tieziyun/ultrasonic-aesa/README.md

# Ultrasonic AESA panel

A 40 kHz in-air phased array, an acoustic "AESA". It has 64 transducers in an 8 × 8 grid, and each one can transmit or listen under FPGA control, element by element and ping by ping. Eight wideband MEMS microphones sit around the edge of the grid. Every element's raw waveform (amplitude and phase) is digitised and streamed to an ALINX AXU3EGB (Zynq UltraScale+ ZU3EG) board, which does the beamforming.

Uses: 3-D sonar imaging, gesture and hand tracking, Doppler motion sensing, and continuous-wave split mode, where some elements transmit while the rest listen.

**Status (2026-10-24):** the schematic is complete and passes ERC (0 violations). All parts are placed on the 4-layer board (DRC clean, every part with a 3D model); routing is next. Full requirements, decisions and part choices are in [DESIGN_BRIEF.md](DESIGN_BRIEF.md).

## Read the schematic

**[docs/schematics/aesa_schematic.pdf](docs/schematics/aesa_schematic.pdf)**: the whole schematic in one PDF, one A3 page per sheet, regenerated on every schematic change. Page 1 is a block diagram of how the signal flows; click a block to open its sheet, and "<< up to" at the top of each page to go back. The bookmarks follow the hierarchy.

| Page | Sheet | What it is |
|---|---|---|
| 1 | top | **Block diagram**: FPGA → TX drive → transceivers → receive amplifiers → ADCs → FPGA, plus mics and power |
| 2 | `headers` | The two 40-pin ribbon headers to the AXU3EGB, idle pulls and I²C pull-ups |
| 3 | group | The 10 clock buffers and which clock each one feeds |
| 4 | `clk_buf` ×10 | One clock fan-out buffer with 47 Ω series termination |
| 5 | group | TX drive: 16 TX groups and 4 enable buffers |
| 6 | `tx_group` ×16 | 74HCT595 shift register and two UCC27524 gate drivers: drives 4 elements |
| 7 | `en_buf` ×4 | TX-enable buffer for 8 gate drivers |
| 8 | group | The 64 transceiver channels as an 8 × 8 grid |
| 9 | `channel` ×64 | One transceiver: crossed-diode T/R switch, CUSP-TR80 element, limiter, OPA1678 gain stage, 40 kHz band-pass |
| 10 | group | The 16 ADCs, which channels each one digitises, and their I²C groups |
| 11 | `adc` ×16 | TLV320ADC5140, 4 channels at 192 kSPS, input divider, TDM output to the FPGA |
| 12 | group | The 8 microphones, paired on 4 data lines |
| 13 | `mic` ×8 | SPH0641LU4H-1 PDM microphone |
| 14 | `power` | Power 1: 12 V jack → eFuse → VIN, +5 V buck, VDRV 15 V boost (switchable), +3V3, 3V3_MIC, ground test points |
| 15 | `power_analog` | Power 2 (analog): ±6.5 V → low-noise ±5VA for the receivers, +3V3A for the ADCs; the power tree and a bring-up checklist with the expected voltage at every test point |

Each block that repeats is drawn once and reused, so a change to `channel` applies to all 64 channels. KiCad's own export of every instance (126 pages) is left in `build/aesa_schematic_full.pdf`.

## Key numbers

| | |
|---|---|
| Elements | 64 × Same Sky CUSP-TR80-15-2500-TH (40 kHz transceiver, Ø9.8 mm) + 8 × SPH0641LU4H-1 MEMS mics |
| TX drive | 0–15 V square wave per element, 16 serial data lines at 10 MHz, per-element per-sample control |
| RX chain | Gain ×22 (+27 dB) in the amplifier, ×6.7 (+16.5 dB) to the ADC pin after the input divider; 31–51 kHz pass band; 1 m echo 93 dB above the noise ([simulated](sim/reports/README.md)) |
| ADC | 16 × TI TLV320ADC5140, 24-bit, 192 kSPS per channel, all 64 channels sampled at once, TDM to the FPGA, I²C configuration |
| Power | One 12 V barrel jack (≥ 1.5 A); every rail has a test point, an isolation jumper and (except the analog LDOs) an LED |
| Board | One 4-layer board, 192 × 301 mm (JLC04161H-7628, ENIG): transducers on the front, all SMT parts on the back |
| FPGA link | Two 40-pin ribbons, 3.3 V LVCMOS, about 15 cm |

## Repository

| Path | Contents |
|---|---|
| [DESIGN_BRIEF.md](DESIGN_BRIEF.md) | Requirements, decisions with reasons and sources, parts, pinouts, open questions |
| `kicad/` | KiCad 10 project `aesa.kicad_pro`, the source of truth |
| `scripts/` | Generators: `build_cells.py` (every cell sheet except `channel`: ADC, TX, buffers, mic, headers, power), `gen_top.py` (block diagram, group sheets, references), `sch_annotate.py` (channel title and notes), `export_pdf.py` (PDFs), plus field and LCSC helpers |
| `skidl/` | Reference spec of each block in SKiDL (values, nets, LCSC numbers) |
| `sim/` | LTspice testbenches and models. `sim/run.py` exports the channel circuit from the KiCad schematic, runs every testbench and writes [sim/reports/](sim/reports/README.md) |
| `docs/schematics/` | The schematic PDF (one page per sheet, linked) |
| `docs/assembly/` | Assembly drawing (front and back with every reference), for building and repair |
| `docs/datasheets/` | A datasheet PDF for every part on the board, with an [index](docs/datasheets/README.md); kept in step with the BOM by `scripts/datasheets.py` |
| [CLAUDE.md](CLAUDE.md) | Working rules for the AI assistant on this project |

## Rebuild

Tools: KiCad 10.0 (per-user install) and LTspice 24. Run from the repository root in a Windows terminal:

```
set KPY=%LOCALAPPDATA%\Programs\KiCad\10.0\bin\python.exe
set KCLI=%LOCALAPPDATA%\Programs\KiCad\10.0\bin\kicad-cli.exe
%KPY% scripts\build_cells.py
%KPY% scripts\sch_annotate.py
%KPY% scripts\sch_lcsc.py kicad\adc.kicad_sch kicad\tx_group.kicad_sch kicad\en_buf.kicad_sch kicad\clk_buf.kicad_sch kicad\mic.kicad_sch kicad\headers.kicad_sch kicad\power.kicad_sch kicad\power_analog.kicad_sch
%KPY% scripts\gen_top.py
%KCLI% sch erc kicad\aesa.kicad_sch
%KPY% sim\run.py
```

The `channel` sheet is drawn by hand (with the KiCad MCP server) and is not regenerated; everything else is. `gen_top.py` ends by exporting the schematic PDF, and the git pre-commit hook (`.githooks/pre-commit`, enabled with `git config core.hooksPath .githooks`) refuses a commit that changes a sheet without the matching PDF.

Board (placement, 3D models, assembly drawing):

```
%KPY% scripts\make_3d.py
%KPY% scripts\place.py
%KPY% scripts\placement_check.py
%KCLI% pcb drc kicadesa.kicad_pcb
%KPY% scriptsssembly_pdf.py
```

BOM (needs internet: it queries JLCPCB for parts, stock and prices, and takes a few minutes):

```
%KPY% scripts\bom.py
%KPY% scripts\sch_lcsc.py --force kicad\channel.kicad_sch kicad\adc.kicad_sch kicad\tx_group.kicad_sch kicad\en_buf.kicad_sch kicad\clk_buf.kicad_sch kicad\mic.kicad_sch kicad\headers.kicad_sch kicad\power.kicad_sch kicad\power_analog.kicad_sch
%KPY% scripts\gen_top.py
```

`bom.py` writes the costed BOM `docs/bom.md`, the JLCPCB upload file `fab/bom_jlcpcb.csv` and `scripts/parts.json`, from which `sch_lcsc.py` fills every part's LCSC field.

## Next

1. Routing (power by hand first, then Freerouting), then fabrication outputs for JLCPCB.
2. Waveguide design and FPGA firmware (XDC constraints, ADC register setup, TX bit streaming).
