tieziyun/ultrasonic-aesa/docs/datasheets/README.md

# Datasheets

One PDF per part on the board, kept in step with the BOM by `scripts/datasheets.py` (run by `scripts/bom.py`; files older than 90 days are downloaded again). TI and Nexperia parts come from the maker's latest-revision link, the rest through LCSC. Parts that share a series datasheet share a file.

| Part | LCSC | Used as | Datasheet | Downloaded |
|---|---|---|---|---|
| 0603B105K250CT | C388002 | 1u 16V X7R | [0603B105K250CT_C388002.pdf](0603B105K250CT_C388002.pdf) | 2026-10-23 |
| 1210B106K500CT | C525507 | 10u 50V X7R 1210 | [0603B105K250CT_C388002.pdf](0603B105K250CT_C388002.pdf) | 2026-10-23 |
| 0603CG6R8C500NT | C1679 | 6.8p 50V C0G | [0603CG6R8C500NT_C1679.pdf](0603CG6R8C500NT_C1679.pdf) | 2026-10-23 |
| 0603CG7R5C500NT | C53424 | 7.5p 50V C0G | [0603CG6R8C500NT_C1679.pdf](0603CG6R8C500NT_C1679.pdf) | 2026-10-23 |
| 0603B103K500NT | C57112 | 10n 16V X7R | [0603CG6R8C500NT_C1679.pdf](0603CG6R8C500NT_C1679.pdf) | 2026-10-23 |
| 0603WAF1001T5E | C21190 | 1k 1% | [0603WAF1001T5E_C21190.pdf](0603WAF1001T5E_C21190.pdf) | 2026-10-23 |
| 0603WAF1000T5E | C22775 | 100 1% | [0603WAF1001T5E_C21190.pdf](0603WAF1001T5E_C21190.pdf) | 2026-10-23 |
| 0603WAF1303T5E | C22795 | 130k 1% | [0603WAF1001T5E_C21190.pdf](0603WAF1001T5E_C21190.pdf) | 2026-10-23 |
| 0603WAF1302T5E | C22797 | 13k 1% | [0603WAF1001T5E_C21190.pdf](0603WAF1001T5E_C21190.pdf) | 2026-10-23 |
| 0603WAF1503T5E | C22807 | 150k 1% | [0603WAF1001T5E_C21190.pdf](0603WAF1001T5E_C21190.pdf) | 2026-10-23 |
| 0603WAF1502T5E | C22809 | 15k 1% | [0603WAF1001T5E_C21190.pdf](0603WAF1001T5E_C21190.pdf) | 2026-10-23 |
| 0603WAF2203T5E | C22961 | 220k 1% | [0603WAF1001T5E_C21190.pdf](0603WAF1001T5E_C21190.pdf) | 2026-10-23 |
| 0603WAF2001T5E | C22975 | 2k 1% | [0603WAF1001T5E_C21190.pdf](0603WAF1001T5E_C21190.pdf) | 2026-10-23 |
| 0603WAF3301T5E | C22978 | 3.3k 1% | [0603WAF1001T5E_C21190.pdf](0603WAF1001T5E_C21190.pdf) | 2026-10-23 |
| 0603WAF330JT5E | C23140 | 33 1% | [0603WAF1001T5E_C21190.pdf](0603WAF1001T5E_C21190.pdf) | 2026-10-23 |
| 0603WAF4701T5E | C23162 | 4.7k 1% | [0603WAF1001T5E_C21190.pdf](0603WAF1001T5E_C21190.pdf) | 2026-10-24 |
| 0603WAF470KT5E | C23164 | 4.7 1% DNP | [0603WAF1001T5E_C21190.pdf](0603WAF1001T5E_C21190.pdf) | 2026-10-24 |
| 0603WAF470JT5E | C23182 | 47 1% | [0603WAF1001T5E_C21190.pdf](0603WAF1001T5E_C21190.pdf) | 2026-10-23 |
| 0603WAF5601T5E | C23189 | 5.6k 1% | [0603WAF1001T5E_C21190.pdf](0603WAF1001T5E_C21190.pdf) | 2026-10-23 |
| 0603WAF5103T5E | C23192 | 510k 1% | [0603WAF1001T5E_C21190.pdf](0603WAF1001T5E_C21190.pdf) | 2026-10-23 |
| 0603WAF5102T5E | C23196 | 51k 1% | [0603WAF1001T5E_C21190.pdf](0603WAF1001T5E_C21190.pdf) | 2026-10-23 |
| 0603WAF7501T5E | C23234 | 7.5k 1% | [0603WAF1001T5E_C21190.pdf](0603WAF1001T5E_C21190.pdf) | 2026-10-23 |
| 0603WAF7502T5E | C23242 | 75k 1% | [0603WAF1001T5E_C21190.pdf](0603WAF1001T5E_C21190.pdf) | 2026-10-23 |
| 0603WAF1003T5E | C25803 | 100k 1% | [0603WAF1001T5E_C21190.pdf](0603WAF1001T5E_C21190.pdf) | 2026-10-23 |
| 0603WAF1002T5E | C25804 | 10k 1% | [0603WAF1001T5E_C21190.pdf](0603WAF1001T5E_C21190.pdf) | 2026-10-23 |
| 0603WAF6493T5E | C25821 | 649k 1% | [0603WAF1001T5E_C21190.pdf](0603WAF1001T5E_C21190.pdf) | 2026-10-23 |
| 0603WAF2201T5E | C4190 | 2.2k 1% | [0603WAF1001T5E_C21190.pdf](0603WAF1001T5E_C21190.pdf) | 2026-10-23 |
| 0603WAF1602T5E | C4210 | 16k 1% | [0603WAF1001T5E_C21190.pdf](0603WAF1001T5E_C21190.pdf) | 2026-10-24 |
| 0603WAF3302T5E | C4216 | 33k 1% | [0603WAF1001T5E_C21190.pdf](0603WAF1001T5E_C21190.pdf) | 2026-10-24 |
| 1206N104J500CT | C170182 | 100n 50V C0G 1206 | [1206N104J500CT_C170182.pdf](1206N104J500CT_C170182.pdf) | 2026-10-23 |
| 74HCT595D,118 | C282339 | 74HCT595D | [74HCT595D_118_C282339.pdf](74HCT595D_118_C282339.pdf) | 2026-10-23 |
| 74LVC2G34GW | C52140488 | 74LVC2G34 | [74LVC2G34GW_C52140488.pdf](74LVC2G34GW_C52140488.pdf) | 2026-10-23 |
| BAV99,215 | C2500 | BAV99 | [BAV99_215_C2500.pdf](BAV99_215_C2500.pdf) | 2026-10-23 |
| C0603C472J5GACAUTO | C3904926 | 4.7n 50V C0G | [C0603C472J5GACAUTO_C3904926.pdf](C0603C472J5GACAUTO_C3904926.pdf) | 2026-10-26 |
| C1608C0G1H103JT000N | C76599 | 10n 50V C0G | [C1608C0G1H103JT000N_C76599.pdf](C1608C0G1H103JT000N_C76599.pdf) | 2026-10-23 |
| CC0603FRNPO9BN102 | C309468 | 1n 50V C0G 1% | [CC0603FRNPO9BN102_C309468.pdf](CC0603FRNPO9BN102_C309468.pdf) | 2026-10-24 |
| CC0603KRX7R9BB104 | C14663 | 100n 16V X7R, 100n 50V X7R | [CC0603KRX7R9BB104_C14663.pdf](CC0603KRX7R9BB104_C14663.pdf) | 2026-10-23 |
| CL0603FN121KP | C48996814 | 121k 1% | [CL0603FN121KP_C48996814.pdf](CL0603FN121KP_C48996814.pdf) | 2026-10-23 |
| CL31A226KAHNNNE | C12891 | 22u 16V X5R 1206 | [CL31A226KAHNNNE_C12891.pdf](CL31A226KAHNNNE_C12891.pdf) | 2026-10-23 |
| CL10C101JB8NNNC | C14858 | 100p 50V C0G | [CL31A226KAHNNNE_C12891.pdf](CL31A226KAHNNNE_C12891.pdf) | 2026-10-23 |
| CL21A106KAYNNNE | C15850 | 10u 16V X5R | [CL31A226KAHNNNE_C12891.pdf](CL31A226KAHNNNE_C12891.pdf) | 2026-10-23 |
| CL10C330JB8NNNC | C1663 | 33p 50V C0G | [CL31A226KAHNNNE_C12891.pdf](CL31A226KAHNNNE_C12891.pdf) | 2026-10-24 |
| CL10B224KA8NNNC | C21120 | 220n 16V X7R | [CL31A226KAHNNNE_C12891.pdf](CL31A226KAHNNNE_C12891.pdf) | 2026-10-23 |
| CL10B223KB8NNNC | C21122 | 22n 50V X7R | [CL31A226KAHNNNE_C12891.pdf](CL31A226KAHNNNE_C12891.pdf) | 2026-10-23 |
| CL21B105KBFNNNE | C28323 | 1u 50V X7R | [CL31A226KAHNNNE_C12891.pdf](CL31A226KAHNNNE_C12891.pdf) | 2026-10-23 |
| CUSP-TR80-15-2500-TH | CUSP-TR80-15-2500-TH | CUSP-TR80-15-2500-TH | [CUSP-TR80-15-2500-TH.pdf](CUSP-TR80-15-2500-TH.pdf) | 2026-10-23 |
| EMK325B7226KM-PR | C412624 | 22u 16V X7R 1210 | [EMK325B7226KM-PR_C412624.pdf](EMK325B7226KM-PR_C412624.pdf) | 2026-10-23 |
| KT-0603G | C12624 | green | [KT-0603G_C12624.pdf](KT-0603G_C12624.pdf) | 2026-10-23 |
| PJ-063AH | C22434582 | 12 V in (5.5x2.1) | [PJ-063AH_C22434582.pdf](PJ-063AH_C22434582.pdf) | 2026-10-23 |
| PZ254V-11-02P | C492401 | TX power (shunt) | [PZ254V-11-02P_C492401.pdf](PZ254V-11-02P_C492401.pdf) | 2026-10-23 |
| RS-03K5623FT | C321950 | 562k 1% | [RS-03K5623FT_C321950.pdf](RS-03K5623FT_C321950.pdf) | 2026-10-23 |
| RS-03K7153FT | C321989 | 715k 1% | [RS-03K5623FT_C321950.pdf](RS-03K5623FT_C321950.pdf) | 2026-10-24 |
| RVT1H470M0607 47UF 50V | C970679 | 47u 35V | [RVT1H470M0607_47UF_50V_C970679.pdf](RVT1H470M0607_47UF_50V_C970679.pdf) | 2026-10-26 |
| SMD1812P200TF16 | C20812 | SMD1812P200TF16 | [SMD1812P200TF16_C20812.pdf](SMD1812P200TF16_C20812.pdf) | 2026-10-23 |
| SPH0641LU4H-1 | C2879853 | SPH0641LU4H-1 | [SPH0641LU4H-1.pdf](SPH0641LU4H-1.pdf) | 2026-10-23 |
| SRN8040TA-100M | C2044906 | 10u Isat>=5A | [SRN8040TA-100M_C2044906.pdf](SRN8040TA-100M_C2044906.pdf) | 2026-10-23 |
| SS14 | C2480 | SS14 | [SS14_C2480.pdf](SS14_C2480.pdf) | 2026-10-23 |
| SWPA6045-SERIES | C78804 | 4.7u Isat>=2A | [SWPA6045-Series.pdf](SWPA6045-Series.pdf) | 2026-10-23 |
| SWPA6045-SERIES | C79272 | 10u Isat>=2A | [SWPA6045-Series.pdf](SWPA6045-Series.pdf) | 2026-10-23 |
| SUNLORD_GZ_SERIES | C1002 | 600R@100MHz 0603 | [Sunlord_GZ_series.pdf](Sunlord_GZ_series.pdf) | 2026-10-23 |
| SUNLORD_SWPA_SERIES | C42193 | 1u Isat>=4A | [Sunlord_SWPA_series.pdf](Sunlord_SWPA_series.pdf) | 2026-10-24 |
| TCC0603COG181J500CT | C376771 | 180p 50V C0G | [TCC0603COG181J500CT_C376771.pdf](TCC0603COG181J500CT_C376771.pdf) | 2026-10-23 |
| TCC0603COG471J500CT | C376788 | 470p 50V C0G DNP | [TCC0603COG181J500CT_C376771.pdf](TCC0603COG181J500CT_C376771.pdf) | 2026-10-24 |
| TCC1206X7R106K160HT | C380363 | 10u 16V X7R 1206 | [TCC0603COG181J500CT_C376771.pdf](TCC0603COG181J500CT_C376771.pdf) | 2026-10-23 |
| TCC1206X7R106K250HT | C380364 | 10u 25V X7R 1206 | [TCC0603COG181J500CT_C376771.pdf](TCC0603COG181J500CT_C376771.pdf) | 2026-10-23 |
| VZH101M1HTR-0810 | C294509 | 100u 25V | [VZH101M1HTR-0810_C294509.pdf](VZH101M1HTR-0810_C294509.pdf) | 2026-10-26 |
| XDFH-0254-2*20P | C19193815 | EX_IO1 (AXU3EGB J15), EX_IO2 (AXU3EGB J16) | [XDFH-0254-2_20P_C19193815.pdf](XDFH-0254-2_20P_C19193815.pdf) | 2026-10-23 |
| LM2731 | C485804 | LM2731XMF | [lm2731.pdf](lm2731.pdf) | 2026-10-23 |
| OPA1678 | C192421 | OPA1678IDR | [opa1678.pdf](opa1678.pdf) | 2026-10-24 |
| SN74AHCT1G125 | C7484 | 74AHCT1G125 | [sn74ahct1g125.pdf](sn74ahct1g125.pdf) | 2026-10-23 |
| TLV320ADC5140 | C2876368 | TLV320ADC5140 | [tlv320adc5140.pdf](tlv320adc5140.pdf) | 2026-10-23 |
| TLV757P | C485517 | TLV75733PDBVR | [tlv757p.pdf](tlv757p.pdf) | 2026-10-23 |
| TPS2660 | C544399 | TPS26600PWPR | [tps2660.pdf](tps2660.pdf) | 2026-10-23 |
| TPS54302 | C311983 | TPS54302DDCR | [tps54302.pdf](tps54302.pdf) | 2026-10-23 |
| TPS65131 | C87663 | TPS65131RGER | [tps65131.pdf](tps65131.pdf) | 2026-10-23 |
| TPS7A33 | C90082 | TPS7A3301RGWR | [tps7a33.pdf](tps7a33.pdf) | 2026-10-23 |
| TPS7A47 | C28286 | TPS7A4700RGWT | [tps7a47.pdf](tps7a47.pdf) | 2026-10-23 |
| UCC27524 | C465729 | UCC27524DR | [ucc27524.pdf](ucc27524.pdf) | 2026-10-23 |
