tieziyun/ultrasonic-aesa/DESIGN_BRIEF.md

# Hybrid 8×8 Ultrasonic Transceiver Panel — Design Brief

An acoustic "AESA": a 40 kHz in-air phased array in which every element can transmit and receive under per-element FPGA control, plus a few wideband MEMS microphones. It feeds an ALINX AXU3EGB (Zynq UltraScale+ ZU3EG) board, which does the beamforming.

Status (2026-10-24): the full schematic is drawn in KiCad (`kicad/aesa.kicad_pro`, the source of truth; PDFs in `docs/schematics/`): 64 transceiver channels, 8 MEMS mics, 16 TLV320ADC5140 ADCs (4 channels each, changed from 8 × AD7606C-16 on 2026-10-23), TX drive, power and the AXU3EGB headers, about 2,040 parts, ERC 0 violations. Decided: discrete front end and 74HCT595 TX drive (section 4a), TLV320ADC5140 audio ADCs at 192 kSPS (section 4), one 4-layer board (section 2), one reused sheet per repeated block (section 4b). Simulations: [sim/reports/](sim/reports/README.md) (all pass). BOM done 2026-10-22 (every part has an LCSC number, `docs/bom.md`). Placement done and reviewed, board set up for routing (stackup, ENIG, plane layers, custom DRC rules, Freerouting), DRC 0. Next: routing.

## 1. Goals (applications the board must support)

| Application | How the hardware supports it |
|---|---|
| Indoor 3D imaging and people tracking, about 0.3–5 m | 8×8 receive beamforming, MIMO (fire one element, all listen) |
| Gesture / hand tracking, cm to 2 m | **Split mode**: a few elements transmit while the rest listen, so the listening elements are not ringing; sub-mm motion from echo phase |
| Doppler: motion, vibration, breathing, fall detection | **Continuous wave** in split mode: some elements transmit continuously, the rest receive continuously |
| Acoustic camera, passive | Transceivers hear about 39–41 kHz (air/gas leaks, electrical arcing). The edge MEMS mics add wideband 20–80 kHz (bats, broadband sources) |

Out of scope: outdoor long range, underwater, anything near people's ears at high drive (40 kHz is audible to pets; keep it indoors).

## 2. Architecture

- **64 transceivers in an 8×8 grid.** Each element has its own TX driver, a per-element T/R switch or RX protection, an RX amplifier, and its own ADC channel.
- **Every element's mode is set by the FPGA per ping**: transmit, listen, or both (where the circuit allows). This mode switching is what enables split mode and continuous wave. It is the single most important requirement of the front end.
- **8 wideband MEMS microphones** around the edge of the grid (PDM, 4 data lines).
- **Front waveguide** (3D-printed tubes) to bring the effective element spacing down to λ/2 = 4.3 mm, so beamforming has no grating lobes. This follows the TU Darmstadt design (reference 1 below).
- Optional: active damping (a brief anti-phase drive after each pulse) to shorten ringing.

### Board split (decided 2026-10-20): one board
**One 4-layer board, 192 × 301 mm** (size set in the floorplan, 2026-10-23).
- **Front:** the 64 transducers (hand-soldered through-hole) and the waveguide.
- **Back:** every SMT part, so assembly is single-sided. Each channel's front end sits directly behind its element.
- **Mics:** the 8 bottom-port MEMS mics mount on the back, with port holes through the board.
- **Clean side:** ADCs, logic and the AXU3EGB ribbon headers go along one edge; power and the 15 V drivers go along the opposite edge, all over one continuous GND plane.

Why:
- **Cost:** one PCB instead of two, one SMT setup ($25 instead of 2 × $25 at [JLCPCB](https://jlcpcb.com/help/article/pcb-assembly-price)), and no board-to-board connectors carrying 64 analog lines plus grounds.
- **Noise:** the high-impedance element node (XD, 3 kΩ source) stays a few mm long instead of crossing a connector, so there's less pickup and no connector crosstalk between neighbouring elements.
- **Industry practice:** flat ultrasonic arrays commonly put transducers and drivers on one PCB ([FPGA levitation array, arXiv 1901.07317](https://arxiv.org/pdf/1901.07317); [SonicSurface build](https://z.jpralves.net/post/2021/08/05/sonicsurface-phased-array-for-levitation-mid-air-tactile-feedback-and-target-directional-speakers.html)), and transducer-front, electronics-back is a standard arrangement ([US10315224](https://image-ppubs.uspto.gov/dirsearch-public/print/downloadPdf/10315224)).

Rejected:
- **Two-board stack** (2-layer panel plus 4-layer front end): most expensive, and puts the sensitive XD lines through a connector.
- **Hybrid** (front ends on the panel, ADC/digital on a second board): middle cost, still two boards and two assemblies.

So there is no board-to-board connector. The only cable is the ribbon to the AXU3EGB.

### PCB floorplan (2026-10-23, `scripts/place.py`; decisions judged on the criteria in CLAUDE.md)
- **Board 192 × 301 mm, 4 layers, JLCPCB JLC04161H-7628 (1.6 mm), 3 mm 45° bevel on every corner, components ≥ 3 mm and copper ≥ 0.5 mm from the edge:** F.Cu front (transducer pads, RX_OUT runs to the ADCs) / In1 GND / In2 GND / B.Cu back (all SMT parts, DRV runs from the drivers). Two solid GND planes (SIG-GND-GND-SIG) shield the 15 V drive traces on the back from the receive traces on the front (*noise*); one GND net, partitioned by placement only (TI SLYT512).
- **Element pitch 20 mm** (chosen for the Ø14 mm CUSA-TR65 with a 6 mm gap, changed from 18 mm; the Ø9.8 mm CUSP-TR80 now leaves a 10 mm gap): channel front ends fill about 45 % of the back of each cell, which leaves a **2.5 mm soldering keep-out** around every hand-soldered transducer pad (*soldering*), room for probes (*testing*) and more distance between channels (*noise*); trade-off: about 17 % more board area (*cost*) and a longer waveguide (open decision 5). TX groups and ADCs behind the array would have made the cells about 80 % full, so they stay on the edge strips.
- **Placement (updated 2026-10-23, user requests):** all cables leave the **top edge**: the two ribbon headers side by side in the middle (straight ribbons, no bending), the 12 V jack in the top-left corner with the eFuse and polyfuse, the quiet +3V3A and +3V3 LDOs in the top-right corner next to the ADCs they feed. Below the headers: header pulls, the 6 ADC and mic clock buffers, then the 16 ADC blocks (2 rows of 8); the 4 TX clock buffers sit in a band between the TX rows and the power row. The array: transducers on the front, each channel block behind its element. Bottom: 16 TX group blocks (2 rows of 8), the 4 enable buffers in the left margin, then the switching regulators and the ±5VA LDOs, as far as possible from the ADCs (*noise*). The 12 V input therefore runs from the top-left corner down the left margin to the +5V buck, and +5V back up to the top-right LDOs, as wide traces (route them first). 8 mics, 4 down each side (on the back: they are bottom-port, the 0.5 mm port hole in the footprint goes through the board so they hear the front; front-mounting would need double-sided assembly and would point the port into the board). 6 M3 holes (corners, mid-sides) and 3 fiducials.
- **Blocks (user rule):** one layout per schematic block, copied to every instance and grouped (CH01–CH64, ADC01–16, TXG01–16, CLKB1–10, TXEN1–4, MIC1–8, Headers, Power). Hand-made templates built from the real mirrored pad positions (`scripts/place.py`): **TX group** (the two UCC27524 side by side, outputs and VDD towards the array, each 100 nF VDRV capacitor right above its VDD pin, the 595 below with QB–QD facing the drivers), **ADC** (TLV320ADC5140 rotated so its 8 inputs face the array; analog-supply capacitors beside pins 1–3, DREG/IOVDD capacitors on top with a gap for BCLK/FSYNC; one column per channel below the chip: coupling capacitors, then the 2k/1k divider), the **channel**'s TX parts and op-amp, and the **LM2731 boost core** (inductor, diode and output capacitors around the SW pin, per the datasheet layout). Everything else is placed by connectivity: ICs first, the parts on a switch node next, then each decoupling capacitor at the IC pin it serves (rail pads measured against IC pins only), then each part next to what it connects to.
- **Silkscreen:** references only on connectors, jumpers, LEDs, holes and fiducials; test points show their rail name; block labels CH01–CH64, ADC01–16, TXG01–16; all other references on the Fab layer. Board name, revision and the safety notes (12 V only, protection limits, TX shunt) on the front.
- **Net classes** (project file, updated 2026-10-24): **HighCurrent 1.0 mm** (VIN, VIN_JACK, VIN_PROT, +5V, 5V_REG, SW_5V: up to 1.6 A, 3 A peak on the switch node; about 4× less copper loss and heating than 0.5 mm: *energy efficiency, heat*), Power 0.5 mm (the other rails, `*_REG` and switch nodes), Drive (DRV, XD) 0.35 mm / 0.3 mm clearance, Analog (RX) 0.25 / 0.25, Clock 0.2 / 0.2 (QFN pad limit; give clocks extra spacing when routing), default 0.2 / 0.15. Feedback, enable, NR and soft-start nodes stay in Default on purpose: thin, short and away from the switch nodes (*noise*). Neck power tracks down at fine-pitch QFN pins. DRC: 0 clearance/overlap errors after placement.
- **Test and repair access (2026-10-24, *testing*):** every rail has a test point, a jumper and an LED (power sheet). Every channel has a 1.0 mm test pad on RX_OUT after its 100 Ω, so a probe never loads the op-amp output (64 pads, `TP101`–`TP6401`). The TX drive of each element can be probed on its transducer pad on the front (an empty hole when the transducer is not fitted). Every FPGA line (TX data and clocks, ADC TDM, I²C, mic data) is probed on the through-hole pins of the ribbon headers on the back. Six scope-ground pads: TP9509/TP9510 at the supply, TP9516 between the ribbon headers, TP9517/TP9518 at the sides of the array, TP9519 beside the TX rows. **Assembly drawing** `docs/assembly/aesa_assembly.pdf` (`scripts/assembly_pdf.py`): front and back (mirrored) fab outlines with every reference and the DNP transducers crossed out, for finding a part during repair.
- **3D models (2026-10-24):** every part has one (`check_design.py` checks). Four library footprints have no model in KiCad 10's library and use the stock model of a part with the same body (`MODEL_SUBST` in `place.py`: 1812 fuse → R_1812, SRN8040TA → SWPA8040S 8×8×4 mm, VQFN-24 4×4 → TI RGE0024C, Knowles LGA-5 → SPH0645 3.5×2.65 mm). The CUSP-TR80 model is built by `scripts/make_3d.py` (Ø9.8 × 7.0 mm can, mesh top, Ø0.7 mm pins), because Same Sky's own model needs a login. Pad-only footprints (test pads, solder jumpers, fiducials, holes) need none.
- **Input protection (added 2026-10-23):** TI TPS26600 eFuse at the jack: rated 60 V and −60 V (replaces the SS54 reverse-polarity diode, 0.5 W less heat), switches off above 13.8 V (the LM2731 VDRV boost runs up to 14 V input, 14.5 V absolute maximum), below 8.8 V, and above 1.6 A; resettable (auto-retry), so a wrong adapter or a short does no damage. The 2 A polyfuse stays after it as a back-up. Test points: adapter voltage (TP9513), input current 1.08 V/A (TP9514), fault (TP9515). **RTN fix (2026-10-26):** the eFuse's RTN pin and PowerPad, with its support parts (UVLO/OVP divider foot, ILIM, dVdT, IMON), are on their own net EFUSE_RTN, apart from GND: the reverse-polarity block sits between RTN and GND inside the chip, and the earlier schematic tied them together, which disables reverse-polarity protection (TPS2660 datasheet 9.3.5.5). Board: a small RTN copper island under U9508, clear of the GND planes.
- **Columns (after the placement review, 2026-10-23):** channels are numbered **down the columns** (CH n: column (n−1)//8, row (n−1)%8; the schematic's array sheet uses the same grid), so TX group k and ADC k sit directly below and above the column of CH 4k−3…4k and every DRV and RX run is a straight vertical line in its own column, with no crossings. **This is the element map the firmware must use.** On F.Cu each column has a **DRV lane on its left** (−9…−5 mm from the element centre) and an **RX lane on its right** (+5…+9 mm), about 10 mm apart over the GND plane (crosstalk ∝ 1/(1+(d/h)²) ≈ −56 dB); the 15 V traces never run beside a receive trace. On the back the TX parts sit in the pocket beside the XD pad, ≥ 4 mm from any receive part and ≥ 6.8 mm from the next row's amplifier input.
- **Placement checks** (`scripts/placement_check.py`, all pass): ADC 100 nF caps ≤ 2.4 mm from their pins, bulk ≤ 6 mm, coupling caps ≤ 6.4 mm, dividers ≤ 2.2 mm; gate-driver VDD caps 2.2 mm; op-amp supply caps 2.4 mm; buck SW→inductor 3.1 mm, input caps ≤ 4 mm; boost SW→inductor/diode ≤ 3.6 mm, diode→output cap 3.6 mm; TX/ADC blocks exactly under their columns. DRC 0 violations.
- **Ready for routing (2026-10-24, placement reviewed against best practice):**
  - **Stackup** JLC04161H-7628 written into the board (1 oz outer, 0.5 oz inner, 0.2104 mm 7628 prepreg, 1.065 mm core), **ENIG** finish (user, 2026-10-24: flat pads for the 0.5 mm-pitch QFNs and the 64 hand-soldered transducers; estimated $3–8 more per board than HASL).
  - **Inner layers In1/In2 are plane ("power") layers**: both solid GND; the autorouter cannot route on them (*noise*). Their zones join SMD pads solidly and **through-hole pads with thermal reliefs** (4 × 0.5 mm spokes): the transducers, headers, jack and holes solder by hand without the planes sinking the heat (*soldering*).
  - **Custom DRC rules** `kicad/aesa.kicad_dru`: TX drive ≥ 1 mm from receive nets, switch nodes ≥ 2 mm from receive nets, clock tracks ≥ 0.4 mm and receive tracks ≥ 0.5 mm from other signal tracks (*noise*); JLCPCB limits: via drill ≥ 0.3 mm, annular ring ≥ 0.15 mm, hole to hole ≥ 0.5 mm, track ≥ 0.127 mm (*manufacture*). Freerouting does not read this file: run DRC after every autoroute.
  - **Freerouting 2.5.0** CLI (bundled Java runtime) in `C:\GitHub\tools\freerouting\cli\freerouting-cli.exe`; the board exports to Specctra DSN with all six net classes and the inner layers as planes.
  - JLCPCB order-number placeholder (`JLCJLCJLCJLC`) on the front silkscreen, bottom right, so the number is not printed over parts.
  - Accepted placement trade-off: the 12 V input runs about 280 mm from the jack (top) to the buck (bottom), and +5V back up to the top LDOs, because the switchers sit as far as possible from the ADCs. Route both trunks **2 mm wide** by hand (about 0.1 V and 0.1 W lost instead of 0.2 V / 0.3 W at 1 mm).
- **Routing and EMI plan:** [docs/routing_and_emi.md](docs/routing_and_emi.md) (2026-10-24): track types, measured lengths (`scripts/net_lengths.py`), widths, topologies and the EMI checklist; five open decisions there.
- **Routing plan (next):** power first — 12 V from the top-left jack down the left margin to the +5V buck (bottom right), +5V back up the right margin to the +3V3A/+3V3 LDOs (top right), trunks 2 mm wide, everything else ≥ 1 mm; then the 64 DRV lanes and 64 RX lanes on F.Cu; the TX control lines (16 SDI, 4 SCK, 4 LATCH, EN, OE, CLR) from J1 down a side margin on F.Cu; ADC TDM lines, clocks and I²C between the ADC rows and the headers; then the rest with Freerouting; GND vias next to every GND pad. Open before routing: check J9901/J9902 key slot and pin 1 against the AXU3EGB J15/J16 and the ribbon twist.

### Heat, enclosure and home use (2026-10-23)
- **Heat (estimate from the design's currents, worst case all 64 elements in CW):** about 8.5 W in total, 6.5 W in normal pulse-echo use. Hottest parts: +3V3A LDO 0.8–1.0 W, +5V buck 0.7 W, VDRV boost 0.7 W (CW only), ±6V5 converter 0.6 W, ±5VA LDOs 0.4 W each; the 64 op-amps (40 mW each) and 16 ADCs (90 mW each) are spread over the board. With θJA ≈ 35 °C/W on the 4-layer board (thermal vias into the two GND planes) the hottest junction is about 60–70 °C at 25 °C ambient (limit 125 °C); the board as a whole warms about 6–10 °C in open air. **No heatsinks:** the two inner GND planes are the heat spreader. If one is ever added, put it only on an LDO (quiet DC node), never on a switcher's SW node, keep it away from the array, and ground it.
- **Enclosure (3D-printed):** PETG or ASA, not PLA (PLA softens near 60 °C, the LDO case temperature). Vent slots next to the power strip, **≤ 5 mm wide** (mice get through 6–7 mm gaps). No solid cover in front of the transducers: a plastic sheet reflects 40 kHz almost completely; the front is the 3D-printed waveguide (open decision 5) or a grille with large open area. Run the 12 V cable and the ribbons inside printed conduits (mice chew cables).
- **Home use with mice:** mice hear 40 kHz (their hearing reaches about 90 kHz), so active pings are audible to them, and to pet rodents, cats and dogs. Their own calls (ultrasonic vocalisations, mostly 50–80 kHz) are outside the narrow 40 kHz transducers' band but inside the SPH0641 mics' ultrasonic band (up to 80 kHz): passive listening with the mics needs no transmission. Active sonar finds mice at 1–2 m (body ≈ 7 cm ≫ λ = 8.6 mm); mount the panel low, looking along the floor. **Safety:** 64 elements focused can reach very high sound levels at the focus (one element 100 dB SPL at 30 cm; coherent focusing adds up to 36 dB), above the ~110 dB occupational limits for airborne ultrasound. The firmware must limit transmit power (elements, duty, VDRV) for home use and never focus on people or pets at short range.

### Clock and data lines to the AXU3EGB (decided 2026-10-20)
Single-ended 3.3 V LVCMOS. At 10–20 MHz over a short ribbon that is the standard choice, and the AXU3EGB's 3.3 V HD banks can't drive LVDS anyway ([Xilinx XAPP230](https://www.hep.ucl.ac.uk/~mp/FPGA/Xilinx-Appl-Note-230_LVDS-Standards.pdf); [CTS termination note](https://www.CTSCorp.com/Files/Product-Marketing-Documents/Passive-Components/Frequency-Control-Products/CTS-Passive-Components-Frequency-Control-Oscillators-Terminat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)).
- **FPGA outputs** (all ribbon outputs, clocks and data): **DRIVE = 4 mA**, SLEW = SLOW in the XDC (changed from 8 mA after simulation, [sim/reports/clock_si_drive.md](sim/reports/clock_si_drive.md)): about 80 Ω output impedance nearly source-matches the ~100 Ω ribbon, so edges at our buffer inputs reach 3.32 V / −0.02 V instead of 3.7 V / −0.4 V at DRIVE 8. No termination parts at the header: the DNP RC fallback (100 Ω + 47 pF, only for DRIVE 8) was removed on 2026-10-26 (user).
- **Ground conductors:** a GND pin on each side of every clock in the ribbon. Spare header pins become GND, and the FPGA leaves those pins as inputs.
- **Clock fan-out on our board:** 74LVC2G34 buffers (10). Each output drives at most 4 loads, **clustered at the far end of its trace**, through its own **47 Ω** series resistor (33 Ω until 2026-10-24): with the buffer's about 20 Ω this matches the 61 Ω (0.25 mm) clock tracks. A series-terminated line only gives clean edges at loads near its end ([sim/reports/mic_clock_si.md](sim/reports/mic_clock_si.md)). The ADC and mic buffers sit under the headers; the four TX buffers sit under the TX rows (2026-10-24, EMI: the 300 mm runs carry the slow FPGA edges, not the buffered ones; [docs/routing_and_emi.md](docs/routing_and_emi.md)).
- **Data back to the FPGA:** a 33 Ω series resistor at each ADC's DOUTA/DOUTB/BUSY output.
- **Cable:** keep the ribbon short, about 15 cm.

## 3. Key numbers

| Quantity | Value |
|---|---|
| Frequency | 40 kHz; λ = 8.6 mm in air; λ/2 = 4.3 mm |
| Range resolution | about 5–8 cm (transducer bandwidth about 2 kHz) |
| Angular resolution, 8 elements at λ/2 | about 14°; MIMO improves this |
| Air absorption | about 1.3 dB/m; realistic range for people 3–5 m, large flat targets up to about 10 m |
| Ringing / blind zone (whole-array pulse-echo) | about 1.8 ms ⇒ about 0.3–0.4 m; split mode avoids most of it |
| RX sampling | 192 kSPS per channel, 24-bit, simultaneous across all 64 channels (one shared BCLK/FSYNC) |
| RX data rate | 64 × 192 kSPS × 24 bit ≈ 295 Mbit/s on 16 TDM lines (18.4 Mbit/s each); see section 5a |
| Memory per ping (5 m range) | about 0.75 MB raw; the 3D volume is about 1 MB |
| Beamforming load | about 0.5 G multiply-adds per second (easy for the ZU3EG fabric) |

## 4. Parts (current choices)

| Function | Part | Notes | Links |
|---|---|---|---|
| Transceiver (default, changed 2026-10-23) | **Same Sky CUSP-TR80-15-2500-TH** | Combined TX/RX, 40 kHz, Ø9.8 × 7 mm ABS case (not sealed), 105 dB SPL at 10 V/30 cm, receive sensitivity −75 dBV/µbar, 80° beam, 80 Vpp max, 2000 pF (1500–2500), 0.2–15 m, ring-down 1.6 ms, −20…80 °C; pins 5.0 mm apart, Ø2 mm pads / Ø0.9 mm holes (footprint `aesa:CUSP-TR80`). About $1.65 (Future Electronics, 391 in stock; DigiKey 236, $1.77–2.88) instead of $3.55 for the CUSA-TR65 (Ø14 mm, IP68): about $122 less per board, +5 dB output, longer range, shorter blind zone, and close to the 10 mm elements of the Darmstadt array (easier waveguide). Not sealed: indoor use, protected by the waveguide/grille. | [datasheet](docs/datasheets/CUSP-TR80-15-2500-TH.pdf) |
| Transceiver (alternative) | Generic open-type T40-16 / R40-16 (HC-SR04 type) or 10 mm levitation type (Manorshi MSO-P1040H07T) | Cheaper and more sensitive, not sealed, large unit-to-unit phase spread: buy about 30% spares and calibrate per element | — |
| Edge MEMS mics | **Knowles/Syntiant SPH0641LU4H-1** | PDM, 100 Hz–80 kHz, about €2.7 (DigiKey). Same mic as the eRTIS research sonar. Datasheet checked 2026-10-19: ultrasonic mode needs a 3.072–4.8 MHz clock, and the mic must not power up or wake from sleep in that mode (start at 1.024–2.475 MHz, then raise it). VDD 1.62–3.6 V; we use 3.3 V to match the FPGA I/O. **Bottom port, Ø0.325 mm**: mics go on the rear of the panel with a hole through the PCB. Pairs share a DATA line (SELECT = VDD and SELECT = GND). Bypass capacitors must be C0G (no Class 2 dielectric). LCSC C2879853 (assembled by JLCPCB). **Lifecycle to watch:** DigiKey lists it Active (now sold under Syntiant), one distributor lists it 'Not for new designs' (2026-10-23) | [DigiKey](https://www.digikey.ie/en/products/detail/syntiant/SPH0641LU4H-1/5332438) |
| Analog alternative mic | Knowles SPU0410LR5H-QB | Analog, 100 Hz–80 kHz. Must be the "-QB" suffix | — |
| ADCs | **TI TLV320ADC5140** (decided 2026-10-23, replaces 8 × AD7606C-16): 4-channel audio ADC, 8–768 kSPS, run at **192 kSPS** (digital decimation filter flat to about 86 kHz, so no loss at 40 kHz). 16 per board, one per 4 channels. Single-ended AC-coupled inputs, 1 Vrms (±1.41 V peak) full scale, 10 kΩ input setting; 2k/1k divider in front so the receiver's ±4.2 V worst case fits. SNR 107 dB (A-weighted, DRE off). TDM slave: the FPGA drives BCLK 18.432 MHz and FSYNC 192 kHz to all 16 (shared, so all 64 channels sample at once); each ADC returns one SDOUT line (4 slots × 24 bit). I²C control: SCL shared, one SDA per group of 4 ADCs, A1/A0 give 0x4C–0x4F inside a group; I²C broadcast writes configure all. **Must be configured with DRE and AGC off and fixed channel gain** (they change gain on the fly and would break channel matching). AVDD from a dedicated +3V3A LDO, IOVDD +3V3. LCSC C2876368, $3.12 at 32 pcs (about $50 per board instead of $470); 219 in stock on 2026-10-23 (enough for about 13 boards). Fallback if stock runs out: ADAU1979 (4 ch, 192 kSPS, 1,431 in stock, different pinout). | 16 SDOUT + BCLK + FSYNC + SCL + 4 SDA + SHDNZ | [TI product page](https://www.ti.com/product/TLV320ADC5140), [datasheet](docs/datasheets/tlv320adc5140.pdf) |
| Per-channel TX + RX front end | **Discrete (approved 2026-10-19)**, see section 4a. TUSS4470 rejected: its VOUT is a log-amp envelope (no phase) | Must allow per-element mode switching (see section 2) | — |

### 4a. Front end and TX drive (approved 2026-10-19)

Reference design: Darmstadt (reference 1) uses, per 8 elements, one HV7355 pulser (20 Vpp unipolar), two TX810 T/R switches, two AD8335 VGAs and one AD7761 ADC. We keep its signal chain (unipolar square-wave drive, raw-waveform capture at 200 kSPS) but use cheaper parts that are in stock at LCSC, because our drive voltage is low (≤ 18 V).

**Per channel** (`skidl/channel.py`):
- TX: half of a **UCC27524** dual gate driver (LCSC C465729), VDRV = 15 V nominal (18 V max) → about 14 Vpp at the element. 47 Ω series resistor, then a **BAV99 crossed-diode pair**. While the driver output is at GND the diodes are off, so the element is isolated from the driver and listens. Ringing above about 0.6 V is damped through the diodes.
- Element: CUSP-TR80-15-2500-TH, 2000 pF (Rm assumed 3 kΩ at resonance, as the CUSA-TR65's datasheet value). 33 kΩ bleed to GND (73 µs recovery after transmit). Footprint `aesa:CUSP-TR80` (`kicad/aesa.pretty`): 5 mm pitch, Ø2 mm pads, 0.9 mm drills (datasheet layout); pad 1 (square) is the lead marked "+" on the case (signal), pad 2 goes to GND.
- RX protection: 4.7 kΩ series + BAV99 clamp to GND (±0.77 V, 3 mA during transmit; 1 kΩ would dissipate 94 mW in CW mode), then 100 pF to GND (RF filter, 340 kHz). Stage 1 has 33 pF across its 10 k feedback resistor (roll-off near 480 kHz).
- Filter parts: 1 % resistors, 1 nF C0G 1 % capacitors (5 % parts would give up to ±11° phase spread between channels).
- Ground: **one GND net and one continuous plane** (TI SLYT512, ADI layout guidance). Drive, analog and logic sections are separated by placement; each DRVn/XDn returns over unbroken plane to its own driver. No net-ties.
- RX gain: **OPA1678** dual (LCSC C192421) on ±5 V; stage 1 on half B (pins 5–7) and stage 2 on half A (pins 1–3), chosen for the board layout (2026-10-25, docs/routing_and_emi.md section 6). Stage 1 non-inverting ×6, AC-coupled at 800 Hz. Stage 2 multiple-feedback band-pass, f0 = 39.8 kHz, Q = 2, gain −4. Total −24 (27.6 dB) nominal; 26.6 dB (×21.4) simulated at 40 kHz from the element, output single-ended through 100 Ω to the ADC cell, where a 2k/1k divider scales it by 0.31 (1 m echo: 0.81 V peak = −4.9 dBFS). Digital TGC in the FPGA instead of Darmstadt's analog VGA.
- About 16 parts per channel.

**MEMS mics** (fixed requirement, hybrid panel): 4 pairs (`mems_mic_pair`) along the grid edge, 4 DATA lines + 4 clocks. Each mic has a 33 Ω series resistor on DATA and a 100 nF C0G bypass (1206: no 100 nF C0G 0805 is stocked at JLCPCB). The clock is fanned out on the panel by 2 × 74LVC2G34 (CLKB9, CLKB10), **one output per mic pair** through 47 Ω (MIC_CLK_A mics 1–2, B 3–4, C 5–6, D 7–8), with a 100 k pull-down on the input so the mics see no clock while the FPGA configures. One output for all four mics of a side (as drawn until 2026-10-24) gave the nearest mics staircase edges outside the mic's 3 ns limit.

**Transmit lines** (shift-register frame streaming):
- **16 data lines**, one **74HCT595D** (Nexperia, LCSC C282339, 5 V, TTL inputs, fmax 57 MHz) per 4 elements on QA–QD (QE–QH unused), plus shared SRCLK, RCLK (latch), /OE and /SRCLR. The user chose 16 lines × 4 bits over 8 × 8 to halve the shift clock; it costs 8 more 595s (16 in total) and 8 more FPGA pins. Re-checked 2026-10-24 after an outside review: 8 × 8 would save about $2.70 per board (8 × 595 + 2 clock buffers + assembly) at the price of a 20 MHz shift clock and a new TX block layout; the user kept 16 × 4.
- The FPGA shifts a 64-bit frame (4 bits per line) and latches it at 2.5 MHz (**SRCLK 10 MHz**). All 64 outputs update on the same RCLK edge, so each element's waveform is any 1-bit pattern with 0.4 µs resolution (1/62 of a 40 kHz period, about 6°).
- Per-element mode falls out of the bit stream: transmit = toggle the bit, listen = hold 0. This supports split mode and continuous wave with no extra mode lines.
- Safety (`tx_control`, once per board): the UCC27524 EN pins have 200 kΩ internal pull-ups to VDRV (datasheet), so they must never connect to an FPGA pin. Four 74AHCT1G125 on +5 V drive them, one per row of 8 drivers (TX_EN1–4), all fed from TX_EN_FPGA with one 10 k pull-down to GND. /OE has a 10 k pull-up to 3.3 V (595 outputs high-Z, driver inputs pulled low) and /SRCLR a 10 k pull-down. The drivers stay off until the FPGA enables them.
- VDRV: 47 µF bulk capacitance; size the supply for ≥ 0.25 A.
- Upgrade path if more range is needed: HV7355 (LCSC C633698, up to 150 V, needs ±5 V and VPP) in the same position; it also has its own per-channel serial enable latch.

**FPGA pin budget** (single-ended 3.3 V LVCMOS, about 68 pins on the two headers):

| Function | Pins |
|---|---|
| TX: 16 serial data + SRCLK + RCLK + /OE + /SRCLR + TX_EN | 21 |
| ADC: 16 × TLV320ADC5140, one SDOUT each (16) + BCLK + FSYNC + SHDNZ + SCL + 4 SDA. 4 × 24 bits per line per sample at 192 kSPS = 18.4 Mbit/s, BCLK 18.432 MHz. | 23 |
| MEMS mics: 4 PDM data + 1 clock | 5 |
| **Total** | **49** (plus GND on the other header pins, including both neighbours of every clock) |

### 4b. KiCad schematic (updated 2026-10-20)

Project `kicad/aesa.kicad_pro`. Three levels, all generated by `scripts/gen_top.py` except the cells:
- **Top sheet** `aesa.kicad_sch`: a block diagram of the signal flow (FPGA → headers → clock buffers / TX drive → transceivers → ADCs → headers → FPGA, plus mics and power). Its blocks are sheet symbols: click one to open it.
- **Group sheets**: `tx.kicad_sch` (16 × tx_group + 4 × en_buf), `array.kicad_sch` (64 × channel), `adcs.kicad_sch` (16 × adc), `mics.kicad_sch` (8 × mic), `clocks.kicad_sch` (9 × clk_buf). They place the cells and join their ports to global labels.
- **Cell sheets** (below), plus `power` and `headers` directly under the top sheet.

| Sheet | Instances | Contents |
|---|---|---|
| `channel.kicad_sch` | 64 (CH01–CH64) | One transceiver channel, wired: 47 Ω + BAV99 crossed diodes, CUSP-TR80 element, 33 k bleed, 4.7 k + BAV99 clamp, OPA1678 ×6 stage and 40 kHz MFB band-pass, 100 Ω out. Ports DRV_OUT (from the driver) and RX_OUT (to the ADC). The transducer stays in this sheet (one board). |
| `adc.kicad_sch` | 16 (ADC01–ADC16) | TLV320ADC5140 (project symbol `aesa:TLV320ADC5140`, written by `scripts/make_symbols.py`), footprint Texas_RTW WQFN-24 with thermal vias. Per input: 2k + 1k divider, 100 nF to INxP, INxM AC-grounded by 100 nF. SDOUT through 33 Ω. Decoupling per datasheet Figure 172 (AVDD 1 µF + 100 nF, AREG and DREG 10 µF + 100 nF, IOVDD 10 µF + 100 nF, VREF 1 µF). ADC k takes RX 4(k−1)+1 … 4k on its ports IN1–IN4, in order (2026-10-26, user: the sheets read in element order); inside the sheet port INm feeds ADC channel 5−m (the order the receive lanes reach the inputs without crossing, 2026-10-25), so TDM channel c carries element 4(k−1)+5−c (the firmware's channel table). Ports IN1–4, BCLK, FSYNC, A0, A1, SDOUT, SDA; ADC_SHDNZ and ADC_SCL global. ADC k takes RX 4(k−1)+1 … 4k; group g = ADC 4g−3 … 4g uses ADC_BCLK/FSYNC output g (A–D) and ADC_SDAg. |
| `tx_group.kicad_sch` | 16 (TXG01–TXG16) | One 74HCT595D (QA–QD) + two UCC27524 (1 µF + 100 nF each): drives elements 4k−3 … 4k on DRV1–4, in order (QA–QD = DRV1–4; 2026-10-26, user: the sheets read in element order). On the board the even group of a column (rows 4–7) sits next to the array, the odd one (rows 0–3) below it; inside the group the 595 outputs reach the drivers without crossing (QA→U2 INB→OUTB = DRV1, QB→U2 INA→OUTA = DRV2, QC→U3 INB = DRV3, QD→U3 INA = DRV4). Ports SDI (TX_SDIk−1), SCK, LATCH (TX_SCK_A–D / TX_LATCH_A–D, 4 groups per buffered clock), EN (TX_EN1–4, 4 groups each), DRV1–4. TX_OE_N, TX_CLR_N global. |
| `en_buf.kicad_sch` | 4 (TXEN1–4) | 74AHCT1G125, TX_EN_FPGA → TX_ENj (8 drivers, 16 EN pins each). |
| `clk_buf.kicad_sch` | 10 (CLKB1–10) | 74LVC2G34 with both gates on IN, 47 Ω per output, 100 k pull-down on IN. TX_SCK → A/B, C/D; TX_LATCH → A/B, C/D; ADC_BCLK → A/B, C/D; ADC_FSYNC → A/B, C/D; MIC_CLK_IN → MIC_CLK_A/B (CLKB9: mics 1–2, 3–4) and C/D (CLKB10: mics 5–6, 7–8). Each output ≤ 4 loads, clustered at the end of its trace. |
| `mic.kicad_sch` | 8 (MIC1–8) | SPH0641LU4H-1, 100 nF C0G 1206, 33 Ω on DATA. SEL from the top sheet: odd mics 3V3_MIC, even mics GND; mics 2k−1 and 2k share MIC_DATAk−1. |
| `power.kicad_sch`, `power_analog.kicad_sch` | 1 each | Power 1 (input, +5V, VDRV, +3V3, 3V3_MIC) and Power 2 (analog: ±6V5, ±5VA, +3V3A). See below. |
| `headers.kicad_sch` | 1 | J1 = AXU3EGB EX_IO1 (J15), J2 = EX_IO2 (J16), 2×20 IDC box headers for ribbon cables; idle pulls (TX, ADC_SHDNZ low) and 2.2 k I²C pull-ups. |

**Rule (user, 2026-10-20): every block that repeats has its own sheet, instantiated N times, so there is one sheet to change.** `channel` is drawn with the MCP server; `adc`, `tx_group`, `en_buf`, `clk_buf`, `mic`, `headers`, `power` and `power_analog` are generated by `scripts/build_cells.py`; the top, group sheets and references by `scripts/gen_top.py`. Reference numbering: CH n → R n01…, ADC k → U(70+k)01… (k = 1–16), TXG k → U1(00+k)01…, TXEN j → U12j01, CLKB j → U13j01, MIC m → MK14m01, power 95xx (both power sheets), headers 99xx.

**Power tree (reviewed and redrawn 2026-10-20, generated by `scripts/build_cells.py`; all TI parts with downloadable datasheets, in production):** one regulated 12 V adapter on a 5.5×2.1 mm barrel jack (≥1.5 A; LM2731 VIN max 14 V) powers everything. Each rail: regulator node `*_REG` → bridged solder jumper (cut to isolate) → rail with test point, LED (not on the analog LDO outputs) and PWR_FLAG. **Sheet layout (redrawn 2026-10-24):** two A3 sheets (every page of the schematic PDF is A3), one dashed box per section in power-flow order. Sections numbered in power-flow order (2026-10-26): Power 1: 1 12 V input/eFuse, 2 +5V buck, 3 +3V3, 4 VDRV, 5 3V3_MIC, and the ground test points. Power 2 (analog): 6 ±6V5, 7 ±5VA, 8 +3V3A, and the power tree with the bring-up checklist (expected voltage at every test point). Notes name parts by their printed references (U9508 …). Every part is wired, the eFuse inline between the jack and the polyfuse; box positions in `scripts/power_sections.py`, shared with `place.py`.
- Input: jack (TP9513) → **TPS26600 eFuse** (−60…60 V, off above 13.8 V / below 8.8 V, 1.6 A limit, auto-retry; IMON 1.08 V/A on TP9514, FLT on TP9515) → SMD1812P200TF16 polyfuse (back-up) → VIN (C 100 µF + 100 nF, LED, TP1). **Input filter** (2026-10-24, EMI): C45 10 µF 50 V → L5 1 µH 4 A (Sunlord SWPA4030S1R0NT) → C1 100 µF electrolytic (its ESR damps the filter), about 57 dB at the buck's 400 kHz, so the switchers' ripple stays off the 12 V cable. **Damped bulk at the far ends of the long supply runs** (2026-10-26, user-approved after a review of the floorplan): the switchers sit at the bottom edge, far from the ADCs and receivers (good for noise), so VIN runs about 280 mm from the jack and +5V about 300 mm back up to the top LDOs. A 100 µF / 25 V electrolytic (the same part as C9501) sits at each far end, C9550 on VIN at the power row and C9551 on +5V at the top LDOs: its ESR damps the feed inductance against the ceramic input caps (TI LMZ21701 / TPS82740 guidance) and keeps the switchers' ripple current local. No ferrite: it would make a new rail (test point, jumper, LED per the testability rule) for little gain. VIN routed 1.5 mm wide where the margin allows (about 1.3 % I²R loss at 1 mm). **Unfitted RC snubbers** (4.7 Ω + 470 pF, DNP, footprints kept: user 2026-10-26) on SW_5V, SW_P, SW_N and SW_VDRV, fitted only if a measurement shows ringing.
- +5V: **TPS54302** 3 A buck (pin-compatible with the TPS54202, changed 2026-10-23 for the ADC rail), TI reference design (L 10 µH Bourns SRN8040TA-100M, Isat 5 A = the typical current limit; 75k/10k + 100 pF → 5.07 V, EN UVLO 510k/100k ≈ 7.4 V; JLCPCB Basic resistor values), input 10 µF 50 V X7R 1210, 2 × 22 µF out; JP1. Load ≈ 1.3 A typ / 1.7 A max of 3 A.
- ±6V5 pre-regulator: **TPS65131RGER** (drawn with the pin-identical TPS65130RGE symbol; the TPS65130 has only 800 mA switches, so order the TPS65131) from +5V: boost to +6.46 V (562k/130k + 6.8 pF), inverter to −6.51 V (649k/121k to VREF + 7.5 pF), 4.7 µH (Isat ≥ 2 A) + SS14 each side, PSP/PSN low (fixed-frequency PWM), CP 10 nF, CN 4.7 nF, VREF 220 nF, VIN pin through 100 Ω + 100 nF, input 2 × 10 µF 16 V X7R 1206. **New JP5/JP6** isolate +6V5/−6V5 from the LDOs.
- +5VA: TPS7A4700RGWT low-noise LDO (the TPS7A4701RGWR is out of stock at JLCPCB; same pinout, ANY-OUT identical) from +6V5, ANY-OUT 1.4 + 3.2 + 0.4 = 5.0 V, NR 1 µF, 2 × 10 µF out; JP2. Load ≈ 0.26 A typ / 0.32 A max (64 × OPA1678 at ~4 mA per dual); 0.5 W in the LDO, thermal vias under the pad.
- −5VA: TPS7A3301 low-noise LDO from −6V5, 715k/220k → −5.00 V, CFF 10 nF, NR/SS 1 µF, 22 µF out; JP3. Load ≈ 0.3 A.
- VDRV: LM2731X boost from VIN to 15.4 V (150k/13k, Cf 180 pF), 10 µH (Isat ≥ 2 A), SS14, 2 × 10 µF 50 V out, then **J2, a 2-pin shunt header: remove the shunt to unpower all TX drivers**, 47 µF bulk. Worst-case load, all 64 elements in CW (simulated, `sim/reports/tx_cw.md`): 3.7 mA per element, ≈ 0.24 A: C·V²·f is only 1.3 mA; the rest goes into the 47 Ω, the acoustic load and the RX limiter (4.7 kΩ dissipates 19 mW whenever its own element transmits).
- +3V3: **TLV75733P** LDO from +5V (replaces the TLV1117-33, whose output needs ≥ 10 µF with an ESR window; the TLV757P is stable with ceramics). Load < 0.15 A; JP4.
- 3V3_MIC: +3V3 → 600 Ω@100 MHz ferrite GZ1608D601TF (FB1, remove to isolate) → 10 µF, LED, TP.
- **+3V3A** (added 2026-10-23, power sheet section I): second TPS7A4700RGWT from +5V, ANY-OUT 1.4 + 1.6 + 0.2 + 0.1 = 3.3 V, NR 1 µF, 2 × 10 µF out; JP7, TP12, no LED (analog LDO). Feeds AVDD of the 16 ADCs: about 0.45 A typ (21 mA each at 48 kSPS in the datasheet; more at 192 kSPS is estimated), 0.8 W in the LDO.
- Ground: one GND net and two inner planes; TP9509/TP9510 at the supply and TP9516–TP9519 around the board for scope grounds.
- Inductors: L1 Bourns SRN8040TA-100M (Isat 5 A); L2/L3 Sunlord SWPA6045S4R7MT (Isat 5.5 A); L4 Sunlord SWPA6045S100MT (Isat 3.5 A); footprints match.
- **BOM (2026-10-22):** every part has an LCSC number, chosen by `scripts/bom.py` (Basic parts first); costed BOM in `docs/bom.md`, upload file `fab/bom_jlcpcb.csv`.

**ADC and mic additions (updated 2026-10-23):** ADC_SHDNZ 10 k pull-down (ADCs stay in hardware shutdown until the FPGA releases them after the rails settle; wait 2 ms before I²C), 2.2 k pull-ups on ADC_SCL and ADC_SDA1–4 (run the bus at 100 kHz); ADC_BCLK, ADC_FSYNC and all other clocks are held low by the 100 k in their clk_buf. The 8 mics run from 3V3_MIC: +3V3 → 600 Ω@100 MHz ferrite → 10 µF, with LED, test point and flag (power sheet section H; remove FB1 to isolate).

**AXU3EGB header pinout** (verified 2026-10-19 against the ALINX AXU3EGB user manual REV1.0, pp. 41–42, and the schematic page "EXTEND IO"; J15 = banks 43/44, J16 = banks 45/46, same layout): pin 1, 37, 38 GND; pin 2 +5V; pins 39, 40 +3.3V; pins 3–36 = 17 P/N pairs (N odd, P even). Our board connects GND to DGND and leaves the +5V/+3.3V pins unconnected (own supplies).
- J1 (EX_IO1, updated 2026-10-20): TX_SDI0–15 on 5–20 (P = even SDI), TX_CLR_N 21, TX_OE_N 22, TX_EN_FPGA 24, MIC_DATA0 25, MIC_DATA2 27, MIC_DATA1 28, MIC_DATA3 30, **TX_SCK 32, MIC_CLK_IN 34, TX_LATCH 36**; GND 1, 3, 4, 23, 26, 29, 31, 33, 35, 37, 38; open 2, 39, 40.
- J2 (EX_IO2, updated 2026-10-23): ADC_SHDNZ 5, ADC_SCL 7, ADC_SDA1 8, ADC_SDOUT1–16 on 9–24, ADC_SDA2–4 on 25–27, **ADC_BCLK 32, ADC_FSYNC 34**; GND 1, 3, 4, 6, 28–31, 33, 35–38; open 2, 39, 40.
- On a flat ribbon each clock conductor (32, 34, 36) has GND on both neighbours (31/33, 33/35, 35/37). The FPGA pins wired to GND must be left unused (inputs) in the XDC.

**Local deviations from the KiCad libraries:** the TLV320ADC5140 has no KiCad symbol: `kicad/aesa.kicad_sym` (project library, `kicad/sym-lib-table`) is written by `scripts/make_symbols.py` from the datasheet pin table; pin types are for I²C control (ADDR1_MISO is an address input). 74HCT595D and 74AHCT1G125 are placed from their base symbols 74HC595 / 74LVC1G125 (identical pinout) because the MCP loader breaks on `extends`.

Rejected: Murata MA40H1S-R (end of life), Murata MA40S4S/R (not recommended for new designs), HC-SR04 modules as modules (onboard MCU adds microseconds of jitter and only outputs an echo pulse).

## 5. FPGA interface: ALINX AXU3EGB

- Two 2×20-pin 2.54 mm headers, EX_IO1 (banks 43/44) and EX_IO2 (banks 45/46). Both are **HD banks at 3.3 V**. About 17 P/N pairs per header, plus +3.3 V and GND. Source: [AXU3EGB schematic](https://e2e.ti.com/cfs-file/__key/communityserver-discussions-components-files/138/AXU3EGB_5F00_schematics.pdf), page 21 "EXTEND IO".
- HD banks: 3.3 V LVCMOS is fine. No LVDS needed for this board.
- **Pin budget is the open problem.** 64 TX lines plus 64 mode controls is far more than the headers provide. Options:
  - Shift-register latches load each ping's per-element mode and delay over a fast serial bus, with TX fired through grouped lines.
  - A small on-board FPGA/CPLD generates the 64 delayed TX waveforms locally.
- Signals that do fit: about 16 ADC serial data lines plus clocks, 4 PDM data lines plus a clock, TX control, I²C/SPI for configuration.

### 5a. Interface bandwidth: no bus is a bottleneck (checked 2026-10-23)

| Interface | Rate needed | What sets the limit | Margin |
|---|---|---|---|
| ADC data, 16 TDM lines | 4 ch × 24 bit × 192 kSPS = 18.4 Mbit/s per line, BCLK 18.432 MHz; 295 Mbit/s total (37 MB/s, 49 MB/s as 32-bit words) | ADC: BCLK ≤ 25 MHz, ≤ 18.5 MHz if latched on the opposite edge. Ribbon and clock buffers simulated clean at 20 MHz (`sim/reports/clock_si*.md`). Loop delay FPGA → buffer → ADC → FPGA ≈ 25 ns (ADC BCLK→SDOUT ≤ 18 ns) | Sampling on the opposite edge would leave only ~2 ns: set **TX_EDGE = 1** (ADC transmits half a cycle later) and latch SDOUT a full BCLK after launch, or pick the sample point with the FPGA's 8 × BCLK fabric clock (147.456 MHz). ~29 ns margin. Zynq PL→DDR (AXI HP, GB/s) and gigabit Ethernet (~110 MB/s) both carry 49 MB/s |
| ADC configuration, I²C (4 SDA + SCL) | about 25 register writes per ADC, once at boot | 100 kHz standard mode (16 loads on SCL, 2.2 k pull-ups) | Broadcast write configures all 16 in about 10 ms; a read-back of every ADC takes well under 0.1 s. Never in the data path: gains are fixed (DRE/AGC off) |
| TX frames, 16 × 74HCT595 lines | 4 bits per line per update, latched every 0.4 µs (SRCLK 10 MHz) | 74HCT595 fmax 57 MHz typ; clock tree simulated at 20 MHz | 0.4 µs steps = 5.8° of a 40 kHz period ≈ 1.8° beam steering step at λ/2 pitch. If finer steering is wanted, SRCLK 20 MHz (validated in simulation) halves it, no hardware change |
| MEMS mics, 4 PDM lines | 3.072–4.8 MHz clock, both edges | SPH0641 ultrasonic mode | Trivial for the FPGA |
| SPI | not used | (the ADCs run in I²C mode; the TX chain is a plain shift-register stream) | — |

## 6. Open decisions

1. Transducer: **decided 2026-10-23: CUSP-TR80-15-2500-TH** (replaced the CUSA-TR65 for cost; see section 4).
2. Per-channel front-end topology: **decided**, discrete (section 4a).
3. ADC: **decided 2026-10-23 (user approved the switch)**: 16 × TLV320ADC5140 at 192 kSPS, TDM + I²C (section 4). Replaced 8 × AD7606C-16 (chosen 2026-10-20 for its 220 kHz analog bandwidth), which cost $470 per board; the audio ADC has no analog filter loss at 40 kHz, more dynamic range and costs about $50 per board. Simulated receiver noise floor 9 µV at the transducer (`sim/reports/rx_noise.md`).
4. How to drive 64 transmit lines: **decided**, 16 × 74HCT595D frame streaming at SRCLK 10 MHz (section 4a).
5. Waveguide geometry (tube length and outlet pitch). Take it from reference 1.
6. Board split: **decided 2026-10-20**, one 4-layer board (section 2).

## 7. References

1. Allevato, Kupnik et al. (TU Darmstadt), *Real-Time 3-D Imaging Using an Air-Coupled Ultrasonic Phased-Array*, IEEE TUFFC — 8×8 transceivers at 40 kHz, waveguide to λ/2, Zynq-7010, ±80° field of view, 0.5–3 m, 29 frames/s. [PubMed](https://pubmed.ncbi.nlm.nih.gov/32746193/), [IEEE](https://ieeexplore.ieee.org/iel7/58/9363464/09126862.pdf). Companion imaging-method paper: [d-nb.info PDF](https://d-nb.info/1214848524/34). **Closest published match to this design; read it before choosing the front end and waveguide.**
2. eRTIS (University of Antwerp): 1 transmitter + 32 SPH0641LU4H-1 MEMS mics, broadband FM sweep, 3D in-air sonar. [arXiv](https://arxiv.org/pdf/2308.05504)
3. HiRIS: 1024-channel MEMS microphone array for in-air imaging. [arXiv](https://arxiv.org/html/2402.13110v1)
4. dylanmsu/Ultrasonic_Phased_Array: open-source Zynq transmit phased array (PS sends a 7-bit phase per transducer to the fabric). Reusable TX logic. [GitHub](https://github.com/dylanmsu/Ultrasonic_Phased_Array)
5. SonicSurface (16×16 TX array, FPGA, about $200) and Ultraino (64 channels, Arduino Mega): open transmit-only levitation arrays. [SonicSurface](https://www.instructables.com/SonicSurface-Phased-array-for-Levitation-Mid-air-T/), [Ultraino paper](https://doi.org/10.1109/tuffc.2017.2769399)
