tieziyun/ultrasonic-aesa/sim/reports/mic_supply.md

# Microphone supply filter

**Question:** Do the ferrite bead and capacitors keep digital noise on the 3.3 V rail out of the microphones' supply, without creating a resonance?

**Answer (PASS):** Yes. Digital noise at the microphones' clock frequency (3 MHz) is cut by **72 dB** (to 1/4156), and the filter's resonance near 36 kHz peaks by only 1.4 dB, so it does not amplify noise in the ultrasonic band.

## Why it matters

The MEMS microphones are sensitive to supply noise, and a ferrite with a large capacitor can resonate and amplify noise near its resonance.

## What is simulated

+3V3 → 600 Ω ferrite (GZ1608D601TF) → 10 µF + 8 × 100 nF at the microphones, with a typical ferrite model.

## How to read the plot

How much of the noise on +3V3 reaches the microphones, versus frequency. 0 dB = all of it, −60 dB = a thousandth.

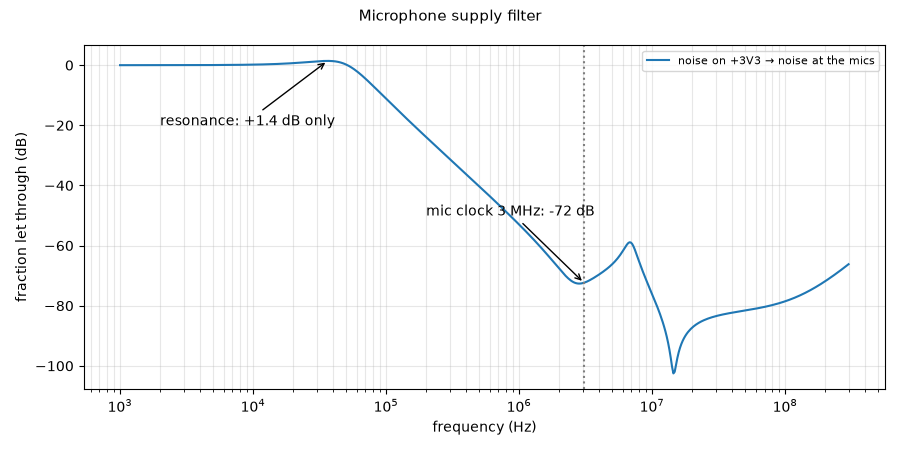
[picture p5: sim/reports/mic_supply.png]
Microphone supply filter


## The numbers

3 checks pass, 0 fail; 2 rows are for information.

| What | Value | Unit | Limit | OK? | What it means |
|---|---|---|---|---|---|
| Noise at the mic clock frequency (3.07 MHz) let through | -72.4 | dB | ≤ -40 | yes | cut to 1/4156 |
| Noise at 100 MHz let through | -78.5 | dB | ≤ -40 | yes |  |
| Resonance peak of the ferrite + 10 µF | 1.41 | dB | ≤ 3 | yes | a big peak would amplify noise in the mics' ultrasonic band |
| Resonance frequency | 36.3 | kHz | — | — |  |
| Low-frequency noise let through at 40 kHz | 1.33 | dB | — | — | not filtered here; the microphone's own supply rejection handles it |

## Assumptions

- Op-amp: TI's OPA167x model (`sim/models/OPA167x.lib`): gain, bandwidth, noise, output swing, overload.
- Diodes (BAV99): 1N4148 junction model, the same die.
- Transducer (CUSP-TR80-15-2500-TH): standard electrical equivalent (Butterworth–Van Dyke) with C0 = 2.0 nF and Rm = 3 kΩ from the datasheet; its sharpness Q (20–40) is an assumption.
- Gate driver, clock buffers and the FPGA outputs: simple behavioural models (values in each netlist header).
- The channel circuit is exported from `kicad/channel.kicad_sch` at the start of every run.

Run 2026-10-25 01:51 with LTspice by `sim/run.py mic_supply`. Testbench: `sim/mic_supply.cir`.
