tieziyun/ultrasonic-aesa/docs/schematics/00_aesa.pdf

1 | 2 | 3 | 4 | 5 | 6 | 7 | 8

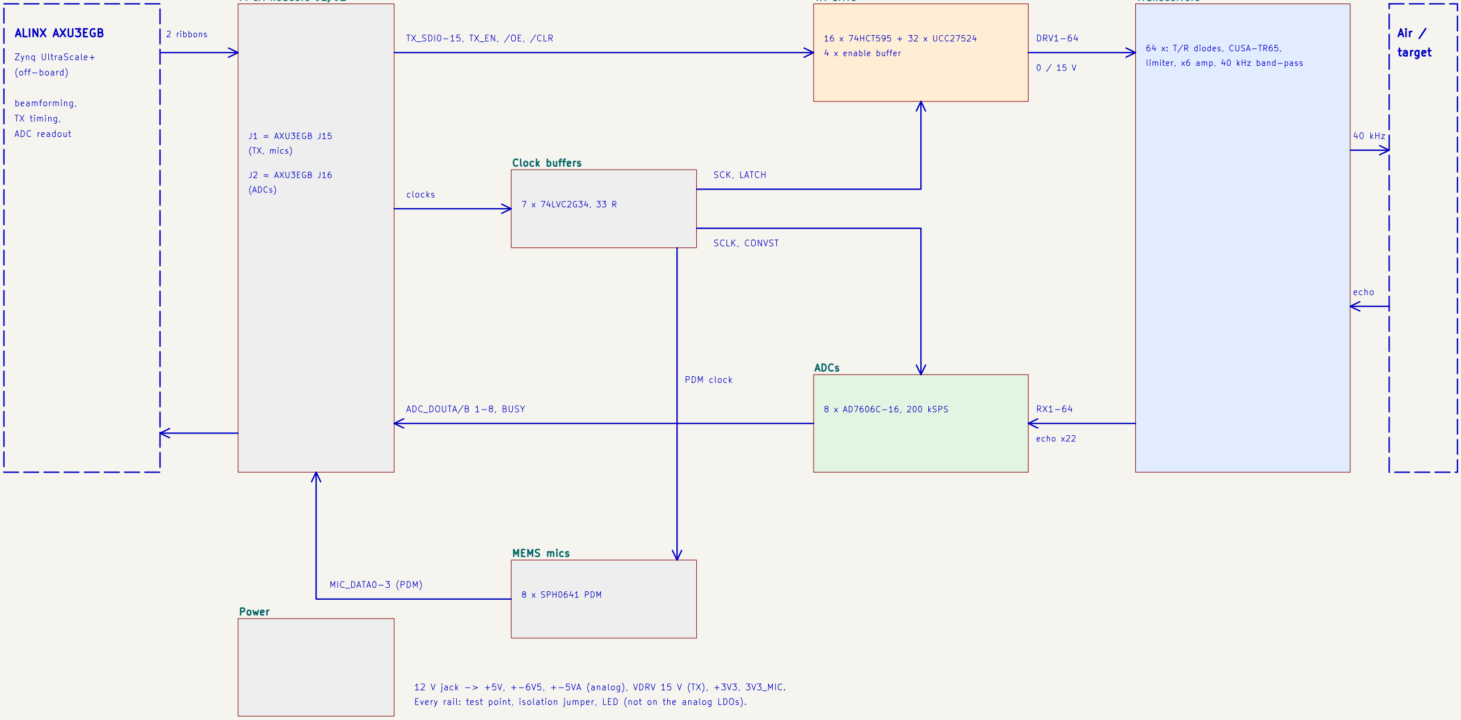
[picture p12: figure]
Clock buffers; Power; MEMS mics; ADCs; beamforming,; TX timing,; 2 ribbons; ADC readout; clocks; J1 = AXU3EGB J15; (TX, mics); J2 = AXU3EGB J16; (ADCs); ADC_DOUTA/B 1-8, BUSY; 7 x 74LVC2G34, 33 R; MIC_DATA0-3 (PDM); 8 x SPH0641 PDM; Air / target; echo; SCK, LATCH; SCLK, CONVST; PDM clock; ALINX AXU3EGB; Zynq UltraScale+; TX_SDI0-15, TX_EN, /OE, /CLR; DRV1-64; 16 x 74HCT595 + 32 x UCC27524; 4 x enable buffer; 8 x AD7606C-16, 200 kSPS; (off-board); 40 kHz; 64 x: T/R diodes, CUSA-TR65,; limiter, x6 amp, 40 kHz band-pass; echo x22

1 | 2 | 3 | 4 | 5 | 6 | 7 | 8

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
F Date: 2026-10-20
KiCad E.D.A. 10.0.6
Size: A3 | Rev: 2 Id: 1/115

### Title: Hybrid 8x8 ultrasonic AESA: block diagram

File: aesa.kicad_sch

Sheet: /

Hybrid 8x8 ultrasonic AESA

FPGA headers J1/J2
TX drive | Transceivers

## Hybrid 8x8 ultrasonic AESA: how the signal flows

Click a block to open it. Repeated parts are one sheet each: channel x64, adc x8, tx_group x16, en_buf x4, clk_buf x7, mic x8.

1. The FPGA streams one TX bit per element (16 serial lines, 10 MHz) and the clocks.
2. TX drive: shift registers latch the bits; gate drivers switch each element between 0 and 15 V.

12 V jack -> +5V, +-6V5, +-5VA (analog), VDRV 15 V (TX), +3V3, 3V3_MIC.

Every rail: test point, isolation jumper, LED (not on the analog LDOs).

3. Transceivers: the 64 CUSA-TR65 elements emit 40 kHz; echoes return to the same elements.
4. The diode T/R switch and limiter protect the receiver; amplifier + 40 kHz band-pass give x22.
5. ADCs: 8 x AD7606C-16 sample all 64 channels at 200 kSPS (raw waveform, amplitude and phase).
6. The samples go back to the FPGA over the ribbon, which forms the beams. 8 MEMS mics add wideband audio.
