tieziyun/ultrasonic-aesa/docs/schematics/10_adc.pdf

1 | 2 | 3 | 4 | 5 | 6 | 7 | 8
1 | 2 | 3 | 4 | 5 | 6 | 7 | 8

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
### F Date: 2026-10-20 KiCad E.D.A. 10.0.6

Size: A3 | Rev: 2 Id: 98/115

# Title: ADC (x8): AD7606C-16, software mode, serial 2 DOUT

File: adc.kicad_sch

### Sheet: /ADCs/ADC1/

### Hybrid 8x8 ultrasonic AESA

GND | GND

C7103

100n 16V X7R | +5VA | GND

R7103

33 1%

R7101

33 1% +5VA | AVCC

# 1 AGND

2 OS0 3 OS1 4 OS2 5 PAR/SER/BYTE_SEL 6

# STBY 7 RANGE 8 CONVST_A 9 CONVST_B 10 RESET 11 RD/SCLK 12 CS 13 BUSY 14

# FRSTDATA 15 DB0 16 DB1 17 DB2 18 DB3 19 DB4 20 DB5 21 DB6 22 Vdrive 23

DB7/DOUT_A 24 DB8/DOUT_B 25 DB9 27 DB10 28 DB11 29 DB12 30 DB13 31 DB14/HBEN 32 DB15/BYTE_SEL 33 REF_SELECT 34 REGCAP 36 | AVCC 37 | AVCC 38 REGCAP 39 REFIN/REFOUT 42 | REFGND 43 REFCAPA 44 REFCAPB 45 | AVCC 48
V1 49
V1GND 50

V2 51
V2GND 52

V3 53
V3GND 54

V4 55
V4GND 56

V5 57
V5GND 58

V6 59
V6GND 60

V7 61
V7GND 62

V8 63

V8GND 64 | U7101
AD7606C-16BSTZ ⁺5VA | +3V3

GND

R7102

33 1%

C7108
1u 16V X7R

C7104
100n 16V X7R
GND | GND

GND

C7110
100n 16V X7R

C7109
10u 16V X7R
GND | GND | GND | GND | GND

C7102
100n 16V X7R

C7106
100n 16V X7R

C7107
1u 16V X7R

C7105

10u 16V X5R ⁺5VA | +5VA | +3V3 C7101
100n 16V X7R | +5VA

IN1

IN2

IN3

SCLK

IN8 | DOUTB
IN5

IN7

IN6

IN4 | DOUTA BUSY CONVST +3V3 ⁺3V3

# ADC_RESET ADC_SDI ADC_CS_N REFCAP

REGCAP1 REFIO

REGCAP2 REFCAP

REFCAP REGCAP1 | REGCAP2 | REFIO

33 R source resistors on DOUTA/DOUTB/BUSY (ribbon to the FPGA); BUSY is used from ADC1 only.

# ADC: AD7606C-16 (pin-compatible with AD7606B; symbol keeps AD7606 pin names)

Decoupling (place at the pins): four 100 nF on the AVCC pins + 10 uF bulk, 100 nF on VDRIVE; REGCAP 1 uF x2, REFCAP 10 uF, REFIN/OUT 100 nF per datasheet

RANGE_CHx = 0x1 (+-5 V), BANDWIDTH = 0xFF (high bandwidth on all 8 channels), CONFIG DOUT_FORMAT = 2 lines.

DB9/DB10 are tied to GND: never set DOUT_FORMAT to 4 lines. After power-up the FPGA pulses ADC_RESET (full reset), then writes the registers.

Pin 10 is WR on the B/C parts (parallel register writes only): held high. RANGE pin is ignored in software mode.

Software mode: OS0-OS2 high. FPGA writes registers over SDI (pin 29, DB11/SDI) at boot: | +5VA | +3V3 | U7101

AD7606C-16BSTZ AVCC

# 1 AGND

2 OS0 3 OS1 4 OS2 5 PAR/SER/BYTE_SEL 6

# STBY 7 RANGE 8 CONVST_A 9 CONVST_B 10 RESET 11 RD/SCLK 12 CS 13 BUSY 14

# FRSTDATA 15 DB0 16 DB1 17 DB2 18 DB3 19 DB4 20 DB5 21 DB6 22 Vdrive 23

DB7/DOUT_A 24 DB8/DOUT_B 25 DB9 27 DB10 28 DB11 29 DB12 30 DB13 31 DB14/HBEN 32 DB15/BYTE_SEL 33 REF_SELECT 34 REGCAP 36 | AVCC 37 | AVCC 38 REGCAP 39 REFIN/REFOUT 42 | REFGND 43 REFCAPA 44 REFCAPB 45 | AVCC 48
V1 49
V1GND 50

V2 51
V2GND 52

V3 53
V3GND 54

V4 55
V4GND 56

V5 57
V5GND 58

V6 59
V6GND 60

V7 61
V7GND 62

V8 63
V8GND 64
