tieziyun/ultrasonic-aesa/docs/schematics/13_power.pdf

1 | 2 | 3 | 4 | 5 | 6 | 7 | 8 | 9 | 10 | 11

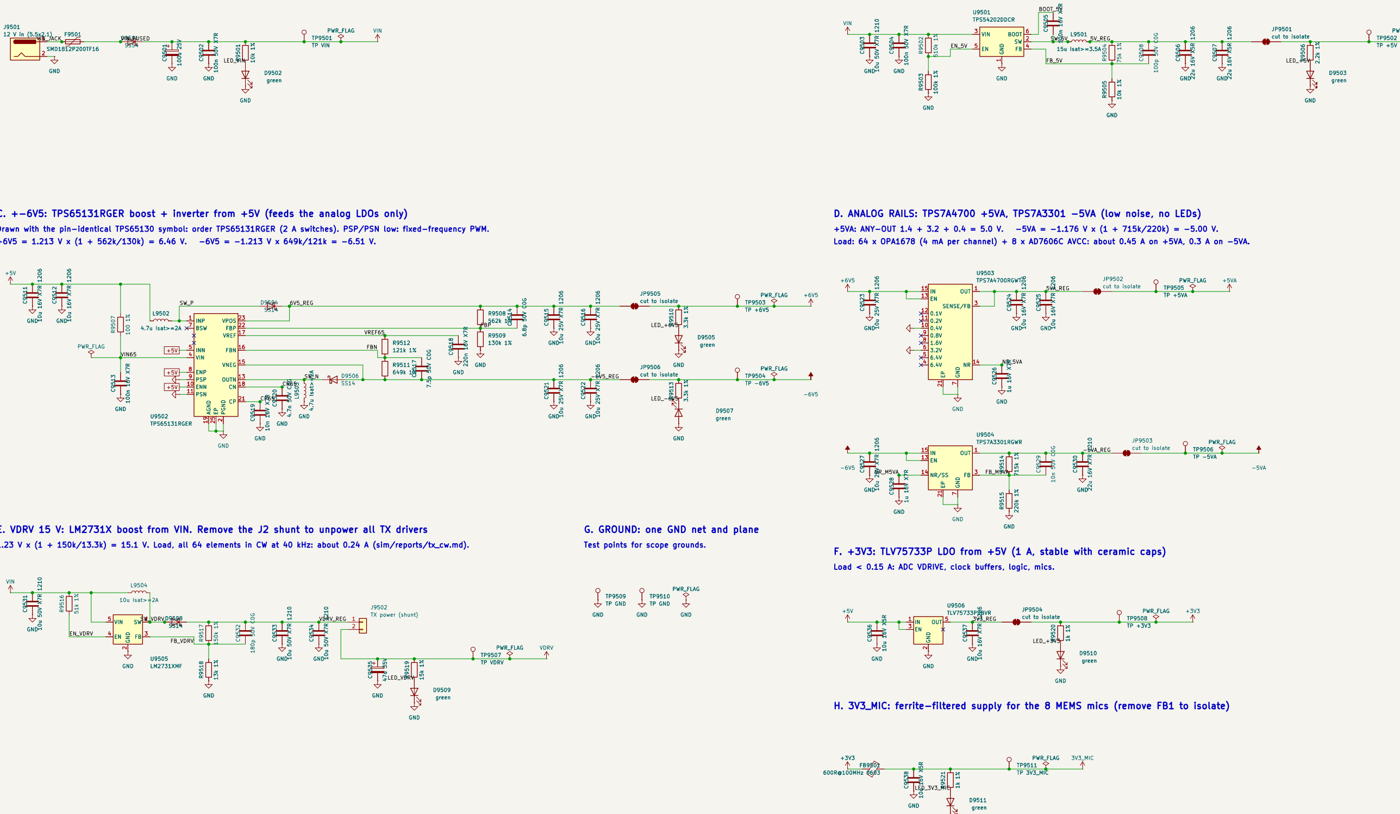
[picture p13: figure]
cut to isolate; GND; TX power (shunt); green R9521; PWR_FLAG; +3V3 GND C9538; cut to isolate GND C9530; TP9511 TP 3V3_MIC; 3V3_MIC; -5VA PWR_FLAG; TP9502 TP +5V PWR_FLAG; green R9501; GND +5V; 4.7u Isat>=2A; GND C9501; 22u 16V X5R 1206 GND; GND C9511; D9501 SS54 GND; green R9506; GND R9510; SMD1812P200TF16; TP VIN; VIN; 10u 25V X7R 1206 GND; BOOT 6 U9501; TPS54202DDCR; 15u Isat>=3.5A C9505; GND C9504; green; GND C9526; green GND; GND C9528; OUT 1; 3 GND; TPS7A3301RGWR; PWR_FLAG TP9504; TP GND; TP9510 TP GND; OUT 5U9506; TLV75733PDBVR C9537; GND C9516; +5V GND; GND C9519; 10u Isat>=2A; INP 1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

1 | 2 | 3 | 4 | 5 | 6 | 7 | 8 | 9 | 10 | 11

AB

C

D

E

### FGH

AB

C

D

E

## FGH Date: 2026-10-20

## KiCad E.D.A. 10.0.6

Size: A2 | Rev: 2 Id: 115/115

# Title: Power: 12 V in, +5V, +-6V5, +-5VA, VDRV, +3V3, 3V3_MIC

### File: power.kicad_sch

### Sheet: /Power/

## Hybrid 8x8 ultrasonic AESA

## GND

PWR_FLAG | +5V
GND | R9519 | 15k 1% | C9525 | 10u 16V X7R 1206 GND C9524 | 10u 16V X7R 1206
SW_P | 6V5_REG | D. ANALOG RAILS: TPS7A4700 +5VA, TPS7A3301 -5VA (low noise, no LEDs)
Drawn with the pin-identical TPS65130 symbol: order TPS65131RGER (2 A switches). PSP/PSN low: fixed-frequency PWM. | +5VA: ANY-OUT 1.4 + 3.2 + 0.4 = 5.0 V. | -5VA = -1.176 V x (1 + 715k/220k) = -5.00 V.

# F. +3V3: TLV75733P LDO from +5V (1 A, stable with ceramic caps)

Vout = 0.596 V x (1 + 75k/10k) = 5.07 V. EN UVLO about 7.3 V. Load about 1.4 A.

Load < 0.15 A: ADC VDRIVE, clock buffers, logic, mics.

Use a regulated 12 V adapter only (LM2731 VIN max 14 V). Jack 5.5 x 2.1 mm, >= 1.5 A.

+6V5 = 1.213 V x (1 + 562k/130k) = 6.46 V. -6V5 = -1.213 V x 649k/121k = -6.51 V.

# C. +-6V5: TPS65131RGER boost + inverter from +5V (feeds the analog LDOs only)

# B. +5V: TPS54202 buck (TI reference design), 2 A

Load: 64 x OPA1678 (4 mA per channel) + 8 x AD7606C AVCC: about 0.45 A on +5VA, 0.3 A on -5VA.

# A. 12 V INPUT: jack, polyfuse (16 V), SS54 reverse-polarity diode -> VIN

1.23 V x (1 + 150k/13.3k) = 15.1 V. Load, all 64 elements in CW at 40 kHz: about 0.24 A (sim/reports/tx_cw.md).

# H. 3V3_MIC: ferrite-filtered supply for the 8 MEMS mics (remove FB1 to isolate)

# E. VDRV 15 V: LM2731X boost from VIN. Remove the J2 shunt to unpower all TX drivers

## PWR_FLAG

IN 15 | EP 21 C9523 | 10u 25V X7R 1206 | C9525 | 10u 16V X7R 1206 GND C9524 | 10u 16V X7R 1206 | PWR_FLAG

## GND

562k 1% | C9515 | 10u 25V X7R 1206 GND C9518 | 220n 16V X7R
