tieziyun/ultrasonic-aesa/docs/bom.md

# Bill of materials

Generated by `scripts/bom.py` from the KiCad schematic; prices are JLCPCB's at the quantity for **2 boards** (the assembly minimum). JLCPCB upload file: `fab/bom_jlcpcb.csv`.

## Cost per board

| Item | USD |
|---|---:|
| Parts assembled by JLCPCB (1968 parts, 75 lines) | 159.79 |
| Extended-part loading fees (43 types × $3, per order, shared by 2 boards) | 64.50 |
| Bought elsewhere, hand-soldered (CUSP-TR80-15-2500-TH) | 105.60 |
| **Total parts per board** | **329.89** |

32 Basic part types (no fee), 43 extended. PCB fabrication, assembly labour and shipping are not included.

### Where the money goes

| Part | Qty | Line USD | Share |
|---|---:|---:|---:|
| CUSP-TR80-15-2500-TH | 64 | 105.60 | 40 % |
| TLV320ADC5140IRTWR | 16 | 49.97 | 19 % |
| OPA1678IDR | 64 | 29.96 | 11 % |
| SPH0641LU4H-1 | 8 | 14.13 | 5 % |
| TPS7A4700RGWT | 2 | 12.23 | 5 % |
| UCC27524DR | 32 | 7.91 | 3 % |
| TPS7A3301RGWR | 1 | 6.53 | 2 % |

## Optimizations made (2026-10-22)

- Transducer: Same Sky CUSA-TR65 (Ø14 mm, sealed, $3.55 at 100) -> CUSP-TR80-15-2500-TH (Ø9.8 mm, not sealed, 105 dB vs 100 dB SPL, 0.2-15 m, 1.6 ms ring-down, $1.65): about $122 less per board.
- ADC: 8 x AD7606C-16 ($58.81 each, $470 per board) → 16 x TI TLV320ADC5140 4-channel audio ADC ($4.01 each, about $64 per board). Same simultaneous sampling of all 64 channels, 192 kSPS, more dynamic range; needs a +3V3A LDO (second TPS7A4700) and the 3 A TPS54302 buck.
- SPH0641LU4H-1 is stocked by JLCPCB (C2879853), so it is assembled instead of consigned.
- +5VA LDO TPS7A4701RGWR (JLCPCB stock 1, $13.16) → TPS7A4700RGWT (646 in stock, $6.11): same chip family, pinout and ANY-OUT network.
- BAV99 → Nexperia BAV99,215 C2500, a Basic part (no $3 fee).
- Input protection: TPS26600 eFuse (60 V / -60 V, off above 13.8 V, 1.6 A, auto-retry) replaces the SS54 diode (0.5 W less heat); the polyfuse stays after it as a back-up.
- Polyfuse 1812L200/16DR → SMD1812P200TF16 (same 2 A hold / 16 V, $0.12 instead of $0.21).
- Ferrite 220 Ω → 600 Ω GZ1608D601TF (Basic); more filtering on 3V3_MIC, which draws only ~10 mA.
- +5V buck divider 100k/13.3k + 75 pF → 75k/10k + 100 pF (5.07 V, same feed-forward zero) and EN divider 511k/105k → 510k/100k (UVLO ≈ 7.3 V): all Basic parts, 3 fewer extended types.
- VDRV divider 150k/13.3k → 150k/13k (Basic): VDRV 15.4 V instead of 15.1 V, within the UCC27524 range.
- Inductor footprints follow the chosen parts: Sunlord SWPA6045S for L2–L4; L1 stays SRN8040 (Bourns SRN8040TA-100M, Isat 5 A, the TPS54302's typical current limit).
- One 0805 10 µF X7R moved to 1206 to share the part already used on 11 other lines.
- Mic bypass 100 nF C0G moved from 0805 to 1206: JLCPCB stocks no 100 nF C0G in 0805.
- Ceramic capacitors that only need X5R/X7R share one Basic part where the voltage allows (e.g. all 303 × 100 nF are CC0603KRX7R9BB104, 50 V).

## Assembled parts

| Qty | Value | LCSC | MPN | Maker | Type | Unit USD | Line USD | Stock | Note |
|---:|---|---|---|---|---|---:|---:|---:|---|
| 16 | TLV320ADC5140 | C2876368 | TLV320ADC5140IRTWR | Texas Instruments | ext | 3.1229 | 49.97 | 202 | TI 4-channel 768 kHz audio ADC, 16 per board (replaces 8 x AD7606C-16 at $58.81) |
| 64 | OPA1678IDR | C192421 | OPA1678IDR | Texas Instruments | ext | 0.4682 | 29.96 | 11,292 | TI dual audio op-amp, RX front end; no cheaper part with the same noise/GBW |
| 8 | SPH0641LU4H-1 | C2879853 | SPH0641LU4H-1 | Knowles | ext | 1.7661 | 14.13 | 491 | Knowles PDM mic, stocked by JLCPCB, so it is assembled, not consigned |
| 2 | TPS7A4700RGWT | C28286 | TPS7A4700RGWT | Texas Instruments | ext | 6.1133 | 12.23 | 454 | TI low-noise LDO, +5VA. Replaces TPS7A4701RGWR (C90084: stock 1, $13.16); same VQFN-20 pinout, ANY-OUT works the same |
| 32 | UCC27524DR | C465729 | UCC27524DR | Texas Instruments | ext | 0.2472 | 7.91 | 25,602 | TI dual 5 A gate driver; kept over the MX27524S clone ($0.12) for the datasheet and second sources |
| 1 | TPS7A3301RGWR | C90082 | TPS7A3301RGWR | Texas Instruments | ext | 6.5257 | 6.53 | 5,829 | TI low-noise negative LDO, -5VA |
| 451 | 100n 16V X7R / 100n 50V X7R | C14663 | CC0603KRX7R9BB104 | YAGEO | Basic | 0.0114 | 5.14 | 42,928,995 |  |
| 16 | 74HCT595D | C282339 | 74HCT595D,118 | Nexperia | ext | 0.2734 | 4.37 | 11,267 | Nexperia. The $0.14 C52140404 'HCT' clone lists 2.7-5.5 V supply, i.e. HC-type inputs that may not accept 3.3 V logic at 5 V; not worth $2 per board |
| 1 | TPS65131RGER | C87663 | TPS65131RGER | Texas Instruments | ext | 2.8791 | 2.88 | 1,969 | TI dual +/- boost, +/-6V5 |
| 1 | 12 V in (5.5x2.1) | C22434582 | PJ-063AH | CUI | ext | 2.7367 | 2.74 | 428 | CUI PJ-063AH (8 A); kept for the documented footprint |
| 50 | 10u 16V X5R | C15850 | CL21A106KAYNNNE | Samsung Electro-Mechanics | Basic | 0.0438 | 2.19 | 8,974,177 |  |
| 128 | 1n 50V C0G 1% | C309468 | CC0603FRNPO9BN102 | YAGEO | ext | 0.0148 | 1.89 | 240,758 |  |
| 1 | LM2731XMF | C485804 | LM2731XMFX/NOPB | Texas Instruments | ext | 1.8905 | 1.89 | 2,825 | TI boost for VDRV; the LM2731XMFX/NOPB reel (2,830 in stock) of the same part |
| 7 | 10u 25V X7R 1206 | C380364 | TCC1206X7R106K250HT | CCTC | ext | 0.2379 | 1.67 | 1,388 |  |
| 64 | 1u 50V X7R | C28323 | CL21B105KBFNNNE | Samsung Electro-Mechanics | Basic | 0.0244 | 1.56 | 1,837,444 |  |
| 1 | TPS26600PWPR | C544399 | TPS26600PWPR | Texas Instruments | ext | 1.5566 | 1.56 | 7,417 | TI 60 V eFuse: reverse polarity, over-voltage cut-off, 1.6 A limit, auto-retry |
| 128 | BAV99 | C2500 | BAV99,215 | Nexperia | Basic | 0.0118 | 1.51 | 1,116,255 | Nexperia BAV99,215, JLCPCB Basic (was C68983, extended) |
| 8 | 100n 50V C0G 1206 | C170182 | 1206N104J500CT | Walsin Tech Corp | ext | 0.1577 | 1.26 | 160,498 |  |
| 5 | 10u 50V X7R 1210 | C525507 | 1210B106K500CT | Walsin Tech Corp | ext | 0.2459 | 1.23 | 3,378 |  |
| 2 | EX_IO1 (AXU3EGB J15) / EX_IO2 (AXU3EGB J16) | C19193815 | XDFH-0254-2*20P | Lian Xin Technology | ext | 0.5451 | 1.09 | 746 | 2x20 2.54 mm shrouded box header, 826 in stock |
| 10 | 74LVC2G34 | C52140488 | 74LVC2G34GW | MDD(Microdiode Semiconductor) | ext | 0.0987 | 0.99 | 4,881 | Nexperia 74LVC2G34GW, SOT-363 |
| 7 | 10u 16V X7R 1206 | C380363 | TCC1206X7R106K160HT | CCTC | ext | 0.1169 | 0.82 | 11,302 |  |
| 1 | 10u Isat>=5A | C2044906 | SRN8040TA-100M | BOURNS | ext | 0.7464 | 0.75 | 94 | Bourns SRN8040TA-100M, 10 uH (TI reference value), Isat 5 A = the TPS54302's typical current limit; same footprint as before |
| 256 | 2k 1% | C22975 | 0603WAF2001T5E | UNI-ROYAL(Uniroyal Elec) | Basic | 0.0024 | 0.61 | 10,512,602 |  |
| 64 | 33p 50V C0G | C1663 | CL10C330JB8NNNC | Samsung Electro-Mechanics | Basic | 0.0090 | 0.58 | 1,173,627 |  |
| 65 | 100p 50V C0G | C14858 | CL10C101JB8NNNC | Samsung Electro-Mechanics | Basic | 0.0087 | 0.57 | 4,777,011 |  |
| 3 | 100u 25V | C294509 | VZH101M1HTR-0810 | Lelon | ext | 0.1356 | 0.41 | 50,060 | Lelon VZH101M1HTR-0810, 100 uF 50 V 8x10 electrolytic: the damped VIN/+5V bulk (C9501 at the jack, C9550 at the power row, C9551 at the top LDOs); pinned 2026-10-26 after the parametric search stopped matching the can size |
| 4 | 74AHCT1G125 | C7484 | SN74AHCT1G125DBVR | Texas Instruments | ext | 0.1004 | 0.40 | 45,919 | TI SN74AHCT1G125DBVR |
| 1 | 22u 16V X7R 1210 | C412624 | EMK325B7226KM-PR | Taiyo Yuden | ext | 0.3056 | 0.31 | 1,324 |  |
| 1 | TPS54302DDCR | C311983 | TPS54302DDCR | Texas Instruments | ext | 0.2493 | 0.25 | 34,319 | TI 3 A buck, +5V: pin-compatible with the TPS54202, 3 A for the ADC rail |
| 2 | 22u 16V X5R 1206 | C12891 | CL31A226KAHNNNE | Samsung Electro-Mechanics | Basic | 0.1166 | 0.23 | 1,594,305 |  |
| 1 | TLV75733PDBVR | C485517 | TLV75733PDBVR | Texas Instruments | ext | 0.2006 | 0.20 | 66,281 | TI 1 A LDO, +3V3 |
| 64 | 4.7k 1% | C23162 | 0603WAF4701T5E | UNI-ROYAL(Uniroyal Elec) | Basic | 0.0028 | 0.18 | 16,750,914 |  |
| 84 | 47 1% | C23182 | 0603WAF470JT5E | UNI-ROYAL(Uniroyal Elec) | Basic | 0.0020 | 0.17 | 1,786,194 |  |
| 2 | 4.7u Isat>=2A | C78804 | SWPA6045S4R7MT | Sunlord | ext | 0.0827 | 0.17 | 24,434 | Sunlord SWPA6045S4R7MT, 4.7 uH, Isat 5.5 A |
| 71 | 10k 1% | C25804 | 0603WAF1002T5E | UNI-ROYAL(Uniroyal Elec) | Basic | 0.0022 | 0.16 | 39,637,713 |  |
| 65 | 100 1% | C22775 | 0603WAF1000T5E | UNI-ROYAL(Uniroyal Elec) | Basic | 0.0023 | 0.15 | 10,436,980 |  |
| 64 | 33k 1% | C4216 | 0603WAF3302T5E | UNI-ROYAL(Uniroyal Elec) | Basic | 0.0021 | 0.13 | 3,429,239 |  |
| 64 | 16k 1% | C4210 | 0603WAF1602T5E | UNI-ROYAL(Uniroyal Elec) | ext | 0.0019 | 0.12 | 240,794 |  |
| 1 | SMD1812P200TF16 | C20812 | SMD1812P200TF16 | RUILON(Shenzhen Ruilongyuan Elec) | ext | 0.1153 | 0.12 | 24,980 | 2 A hold / 16 V 1812 polyfuse, half the price of the Littelfuse 1812L200/16DR |
| 66 | 1k 1% | C21190 | 0603WAF1001T5E | UNI-ROYAL(Uniroyal Elec) | Basic | 0.0017 | 0.11 | 34,310,077 |  |
| 1 | 10u Isat>=2A | C79272 | SWPA6045S100MT | Sunlord | ext | 0.0839 | 0.08 | 9,190 | Sunlord SWPA6045S100MT, 10 uH, Isat 3.5 A |
| 7 | green | C12624 | KT-0603G | Hubei KENTO Elec | ext | 0.0117 | 0.08 | 448,804 | KT-0603G. No green 0603 LED is a Basic part; the Basic red KT-0603R (C2286) would save the $3 fee if the colour does not matter |
| 3 | 1u 16V X7R | C388002 | 0603B105K250CT | Walsin Tech Corp | ext | 0.0226 | 0.07 | 3,921 |  |
| 3 | SS14 | C2480 | SS14 | MDD(Microdiode Semiconductor) | Basic | 0.0192 | 0.06 | 1,988,252 | 40 V 1 A Schottky, JLCPCB Basic |
| 24 | 33 1% | C23140 | 0603WAF330JT5E | UNI-ROYAL(Uniroyal Elec) | Basic | 0.0024 | 0.06 | 4,524,199 |  |
| 1 | 1u Isat>=4A | C42193 | SWPA4030S1R0NT | Sunlord | ext | 0.0572 | 0.06 | 6,662 | Sunlord SWPA4030S1R0NT, 1 uH, Isat 4.15 A: 12 V input filter (EMI, 2026-10-24) |
| 1 | 10n 50V C0G | C76599 | C1608C0G1H103JT000N | TDK | ext | 0.0459 | 0.05 | 3,049 |  |
| 13 | 100k 1% | C25803 | 0603WAF1003T5E | UNI-ROYAL(Uniroyal Elec) | Basic | 0.0031 | 0.04 | 17,939,647 |  |
| 1 | 4.7n 50V C0G | C3904926 | C0603C472J5GACAUTO | KEMET | ext | 0.0380 | 0.04 | 3,874 |  |
| 1 | 47u 35V | C970679 | RVT1H470M0607 47UF 50V | DMBJ | ext | 0.0374 | 0.04 | 37,697 | Lelon RVT1H470M0607, 47 uF 50 V 6.3x7.7 electrolytic, VDRV bulk (pinned 2026-10-26) |
| 1 | TX power (shunt) | C492401 | PZ254V-11-02P | XFCN | ext | 0.0187 | 0.02 | 954,446 | 1x2 2.54 mm pin header (add a 2.54 mm jumper shunt) |
| 1 | 600R@100MHz 0603 | C1002 | GZ1608D601TF | Sunlord | Basic | 0.0115 | 0.01 | 729,580 | Sunlord GZ1608D601TF, JLCPCB Basic; filters the 3V3_MIC rail (mics draw ~10 mA) |
| 6 | 2.2k 1% | C4190 | 0603WAF2201T5E | UNI-ROYAL(Uniroyal Elec) | Basic | 0.0018 | 0.01 | 5,970,927 |  |
| 1 | 220n 16V X7R | C21120 | CL10B224KA8NNNC | Samsung Electro-Mechanics | Basic | 0.0093 | 0.01 | 1,073,364 |  |
| 1 | 180p 50V C0G | C376771 | TCC0603COG181J500CT | CCTC | ext | 0.0085 | 0.01 | 7,476 |  |
| 1 | 7.5p 50V C0G | C53424 | 0603CG7R5C500NT | FH (Guangdong Fenghua Advanced Tech) | ext | 0.0071 | 0.01 | 10,450 |  |
| 2 | 15k 1% | C22809 | 0603WAF1502T5E | UNI-ROYAL(Uniroyal Elec) | Basic | 0.0029 | 0.01 | 3,792,787 |  |
| 1 | 22n 50V X7R | C21122 | CL10B223KB8NNNC | Samsung Electro-Mechanics | Basic | 0.0057 | 0.01 | 1,082,571 |  |
| 1 | 10n 16V X7R | C57112 | 0603B103K500NT | FH (Guangdong Fenghua Advanced Tech) | Basic | 0.0047 | 0.00 | 5,967,473 |  |
| 2 | 3.3k 1% | C22978 | 0603WAF3301T5E | UNI-ROYAL(Uniroyal Elec) | Basic | 0.0022 | 0.00 | 5,523,066 |  |
| 1 | 6.8p 50V C0G | C1679 | 0603CG6R8C500NT | FH (Guangdong Fenghua Advanced Tech) | ext | 0.0043 | 0.00 | 239,195 |  |
| 1 | 5.6k 1% | C23189 | 0603WAF5601T5E | UNI-ROYAL(Uniroyal Elec) | Basic | 0.0032 | 0.00 | 895,364 |  |
| 1 | 13k 1% | C22797 | 0603WAF1302T5E | UNI-ROYAL(Uniroyal Elec) | Basic | 0.0027 | 0.00 | 475,292 |  |
| 1 | 75k 1% | C23242 | 0603WAF7502T5E | UNI-ROYAL(Uniroyal Elec) | Basic | 0.0021 | 0.00 | 890,066 |  |
| 1 | 510k 1% | C23192 | 0603WAF5103T5E | UNI-ROYAL(Uniroyal Elec) | Basic | 0.0020 | 0.00 | 974,353 |  |
| 1 | 562k 1% | C321950 | RS-03K5623FT | FH (Guangdong Fenghua Advanced Tech) | ext | 0.0020 | 0.00 | 1,347 |  |
| 1 | 7.5k 1% | C23234 | 0603WAF7501T5E | UNI-ROYAL(Uniroyal Elec) | Basic | 0.0018 | 0.00 | 1,118,431 |  |
| 1 | 150k 1% | C22807 | 0603WAF1503T5E | UNI-ROYAL(Uniroyal Elec) | Basic | 0.0017 | 0.00 | 944,990 |  |
| 1 | 51k 1% | C23196 | 0603WAF5102T5E | UNI-ROYAL(Uniroyal Elec) | Basic | 0.0017 | 0.00 | 2,015,350 |  |
| 1 | 220k 1% | C22961 | 0603WAF2203T5E | UNI-ROYAL(Uniroyal Elec) | Basic | 0.0015 | 0.00 | 1,188,270 |  |
| 1 | 130k 1% | C22795 | 0603WAF1303T5E | UNI-ROYAL(Uniroyal Elec) | ext | 0.0014 | 0.00 | 487,178 |  |
| 1 | 121k 1% | C48996814 | CL0603FN121KP | CHANGLONG | ext | 0.0012 | 0.00 | 3,110 |  |
| 1 | 649k 1% | C25821 | 0603WAF6493T5E | UNI-ROYAL(Uniroyal Elec) | ext | 0.0009 | 0.00 | 10,157 |  |
| 1 | 715k 1% | C321989 | RS-03K7153FT | FH (Guangdong Fenghua Advanced Tech) | ext | 0.0009 | 0.00 | 5,006 |  |

## Bought elsewhere (hand-soldered)

| Qty | Part | Source | Unit USD | Note |
|---:|---|---|---:|---|
| 64 | CUSP-TR80-15-2500-TH | Future Electronics (391 in stock, $1.65 at 1, $1.54 at 1,250) or DigiKey 102-CUSP-TR80-15-2500-TH-ND (236 in stock, $2.88 at 1, $1.77 at 5,000) | 1.65 | Same Sky 40 kHz transceiver, Ø9.8 mm, DNP for JLCPCB (hand-soldered); LCSC C4360724 lists it from $0.95 but has none in stock (2026-10-23). Replaced the CUSA-TR65 ($3.55) |

## Not ordered

| Qty | Value | Why |
|---:|---|---|
| 4 | 4.7 1% DNP | do not populate (tuning option); fit C23164 if needed |
| 4 | 470p 50V C0G DNP | do not populate (tuning option); fit C376788 if needed |
