tieziyun/ultrasonic-aesa/fab/bom_jlcpcb.csv

Comment | Designator | Footprint | LCSC Part #
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
C1608C0G1H103JT000N | C9529 | C_0603_1608Metric | C76599
EMK325B7226KM-PR | C9530 | C_1210_3225Metric | C412624
TCC0603COG181J500CT | C9532 | C_0603_1608Metric | C376771
RVT1H470M0607 47UF 50V | C9535 | CP_Elec_6.3x7.7 | C970679
CL10B223KB8NNNC | C9543 | C_0603_1608Metric | C21122
BAV99,215 | D1001,D1002,D101,D102,D1101,D1102,D1201,D1202,D1301,D1302,D1401,D1402,D1501,D1502,D1601,D1602,D1701,D1702,D1801,D1802,D1901,D1902,D2001,D2002,D201,D202,D2101,D2102,D2201,D2202,D2301,D2302,D2401,D2402,D2501,D2502,D2601,D2602,D2701,D2702,D2801,D2802,D2901,D2902,D3001,D3002,D301,D302,D3101,D3102,D3201,D3202,D3301,D3302,D3401,D3402,D3501,D3502,D3601,D3602,D3701,D3702,D3801,D3802,D3901,D3902,D4001,D4002,D401,D402,D4101,D4102,D4201,D4202,D4301,D4302,D4401,D4402,D4501,D4502,D4601,D4602,D4701,D4702,D4801,D4802,D4901,D4902,D5001,D5002,D501,D502,D5101,D5102,D5201,D5202,D5301,D5302,D5401,D5402,D5501,D5502,D5601,D5602,D5701,D5702,D5801,D5802,D5901,D5902,D6001,D6002,D601,D602,D6101,D6102,D6201,D6202,D6301,D6302,D6401,D6402,D701,D702,D801,D802,D901,D902 | SOT-23 | C2500
KT-0603G | D9502,D9503,D9505,D9507,D9509,D9510,D9511 | LED_0603_1608Metric | C12624
SS14 | D9504,D9506,D9508 | D_SMA | C2480
SMD1812P200TF16 | F9501 | Fuse_1812_4532Metric | C20812
GZ1608D601TF | FB9501 | L_0603_1608Metric | C1002
PJ-063AH | J9501 | BarrelJack_CUI_PJ-063AH_Horizontal | C22434582
PZ254V-11-02P | J9502 | PinHeader_1x02_P2.54mm_Vertical | C492401
XDFH-0254-2*20P | J9901,J9902 | IDC-Header_2x20_P2.54mm_Vertical | C19193815
SRN8040TA-100M | L9501 | L_Bourns_SRN8040TA | C2044906
SWPA6045S4R7MT | L9502,L9503 | L_Sunlord_SWPA6045S | C78804
SWPA6045S100MT | L9504 | L_Sunlord_SWPA6045S | C79272
SWPA4030S1R0NT | L9505 | L_Sunlord_SWPA4030S | C42193
SPH0641LU4H-1 | MK14101,MK14201,MK14301,MK14401,MK14501,MK14601,MK14701,MK14801 | Knowles_LGA-5_3.5x2.65mm | C2879853
0603WAF470JT5E | R1001,R101,R1101,R1201,R1301,R13101,R13102,R13201,R13202,R13301,R13302,R13401,R13402,R13501,R13502,R13601,R13602,R13701,R13702,R13801,R13802,R13901,R13902,R14001,R14002,R1401,R1501,R1601,R1701,R1801,R1901,R2001,R201,R2101,R2201,R2301,R2401,R2501,R2601,R2701,R2801,R2901,R3001,R301,R3101,R3201,R3301,R3401,R3501,R3601,R3701,R3801,R3901,R4001,R401,R4101,R4201,R4301,R4401,R4501,R4601,R4701,R4801,R4901,R5001,R501,R5101,R5201,R5301,R5401,R5501,R5601,R5701,R5801,R5901,R6001,R601,R6101,R6201,R6301,R6401,R701,R801,R901 | R_0603_1608Metric | C23182
0603WAF3302T5E | R1002,R102,R1102,R1202,R1302,R1402,R1502,R1602,R1702,R1802,R1902,R2002,R202,R2102,R2202,R2302,R2402,R2502,R2602,R2702,R2802,R2902,R3002,R302,R3102,R3202,R3302,R3402,R3502,R3602,R3702,R3802,R3902,R4002,R402,R4102,R4202,R4302,R4402,R4502,R4602,R4702,R4802,R4902,R5002,R502,R5102,R5202,R5302,R5402,R5502,R5602,R5702,R5802,R5902,R6002,R602,R6102,R6202,R6302,R6402,R702,R802,R902 | R_0603_1608Metric | C4216
0603WAF4701T5E | R1003,R103,R1103,R1203,R1303,R1403,R1503,R1603,R1703,R1803,R1903,R2003,R203,R2103,R2203,R2303,R2403,R2503,R2603,R2703,R2803,R2903,R3003,R303,R3103,R3203,R3303,R3403,R3503,R3603,R3703,R3803,R3903,R4003,R403,R4103,R4203,R4303,R4403,R4503,R4603,R4703,R4803,R4903,R5003,R503,R5103,R5203,R5303,R5403,R5503,R5603,R5703,R5803,R5903,R6003,R603,R6103,R6203,R6303,R6403,R703,R803,R903 | R_0603_1608Metric | C23162
0603WAF1002T5E | R1004,R104,R1104,R1204,R1304,R1404,R1504,R1604,R1704,R1804,R1904,R2004,R204,R2104,R2204,R2304,R2404,R2504,R2604,R2704,R2804,R2904,R3004,R304,R3104,R3204,R3304,R3404,R3504,R3604,R3704,R3804,R3904,R4004,R404,R4104,R4204,R4304,R4404,R4504,R4604,R4704,R4804,R4904,R5004,R504,R5104,R5204,R5304,R5404,R5504,R5604,R5704,R5804,R5904,R6004,R604,R6104,R6204,R6304,R6404,R704,R804,R904,R9501,R9505,R9524,R9901,R9902,R9903,R9904 | R_0603_1608Metric | C25804
0603WAF2001T5E | R1005,R1006,R1007,R105,R106,R107,R1105,R1106,R1107,R1205,R1206,R1207,R1305,R1306,R1307,R1405,R1406,R1407,R1505,R1506,R1507,R1605,R1606,R1607,R1705,R1706,R1707,R1805,R1806,R1807,R1905,R1906,R1907,R2005,R2006,R2007,R205,R206,R207,R2105,R2106,R2107,R2205,R2206,R2207,R2305,R2306,R2307,R2405,R2406,R2407,R2505,R2506,R2507,R2605,R2606,R2607,R2705,R2706,R2707,R2805,R2806,R2807,R2905,R2906,R2907,R3005,R3006,R3007,R305,R306,R307,R3105,R3106,R3107,R3205,R3206,R3207,R3305,R3306,R3307,R3405,R3406,R3407,R3505,R3506,R3507,R3605,R3606,R3607,R3705,R3706,R3707,R3805,R3806,R3807,R3905,R3906,R3907,R4005,R4006,R4007,R405,R406,R407,R4105,R4106,R4107,R4205,R4206,R4207,R4305,R4306,R4307,R4405,R4406,R4407,R4505,R4506,R4507,R4605,R4606,R4607,R4705,R4706,R4707,R4805,R4806,R4807,R4905,R4906,R4907,R5005,R5006,R5007,R505,R506,R507,R5105,R5106,R5107,R5205,R5206,R5207,R5305,R5306,R5307,R5405,R5406,R5407,R5505,R5506,R5507,R5605,R5606,R5607,R5705,R5706,R5707,R5805,R5806,R5807,R5905,R5906,R5907,R6005,R6006,R6007,R605,R606,R607,R6105,R6106,R6107,R6205,R6206,R6207,R6305,R6306,R6307,R6405,R6406,R6407,R705,R706,R707,R7101,R7102,R7103,R7104,R7201,R7202,R7203,R7204,R7301,R7302,R7303,R7304,R7401,R7402,R7403,R7404,R7501,R7502,R7503,R7504,R7601,R7602,R7603,R7604,R7701,R7702,R7703,R7704,R7801,R7802,R7803,R7804,R7901,R7902,R7903,R7904,R8001,R8002,R8003,R8004,R805,R806,R807,R8101,R8102,R8103,R8104,R8201,R8202,R8203,R8204,R8301,R8302,R8303,R8304,R8401,R8402,R8403,R8404,R8501,R8502,R8503,R8504,R8601,R8602,R8603,R8604,R905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 | R_0603_1608Metric | C22975
0603WAF1602T5E | R1008,R108,R1108,R1208,R1308,R1408,R1508,R1608,R1708,R1808,R1908,R2008,R208,R2108,R2208,R2308,R2408,R2508,R2608,R2708,R2808,R2908,R3008,R308,R3108,R3208,R3308,R3408,R3508,R3608,R3708,R3808,R3908,R4008,R408,R4108,R4208,R4308,R4408,R4508,R4608,R4708,R4808,R4908,R5008,R508,R5108,R5208,R5308,R5408,R5508,R5608,R5708,R5808,R5908,R6008,R608,R6108,R6208,R6308,R6408,R708,R808,R908 | R_0603_1608Metric | C4210
0603WAF1000T5E | R1009,R109,R1109,R1209,R1309,R1409,R1509,R1609,R1709,R1809,R1909,R2009,R209,R2109,R2209,R2309,R2409,R2509,R2609,R2709,R2809,R2909,R3009,R309,R3109,R3209,R3309,R3409,R3509,R3609,R3709,R3809,R3909,R4009,R409,R4109,R4209,R4309,R4409,R4509,R4609,R4709,R4809,R4909,R5009,R509,R5109,R5209,R5309,R5409,R5509,R5609,R5709,R5809,R5909,R6009,R609,R6109,R6209,R6309,R6409,R709,R809,R909,R9507 | R_0603_1608Metric | C22775
0603WAF1001T5E | R7105,R7106,R7107,R7108,R7205,R7206,R7207,R7208,R7305,R7306,R7307,R7308,R7405,R7406,R7407,R7408,R7505,R7506,R7507,R7508,R7605,R7606,R7607,R7608,R7705,R7706,R7707,R7708,R7805,R7806,R7807,R7808,R7905,R7906,R7907,R7908,R8005,R8006,R8007,R8008,R8105,R8106,R8107,R8108,R8205,R8206,R8207,R8208,R8305,R8306,R8307,R8308,R8405,R8406,R8407,R8408,R8505,R8506,R8507,R8508,R8605,R8606,R8607,R8608,R9520,R9521 | R_0603_1608Metric | C21190
0603WAF330JT5E | R14101,R14201,R14301,R14401,R14501,R14601,R14701,R14801,R7109,R7209,R7309,R7409,R7509,R7609,R7709,R7809,R7909,R8009,R8109,R8209,R8309,R8409,R8509,R8609 | R_0603_1608Metric | C23140
0603WAF5103T5E | R9502 | R_0603_1608Metric | C23192
0603WAF1003T5E | R13103,R13203,R13303,R13403,R13503,R13603,R13703,R13803,R13903,R14003,R9503,R9522,R9527 | R_0603_1608Metric | C25803
0603WAF7502T5E | R9504 | R_0603_1608Metric | C23242
0603WAF2201T5E | R9506,R9905,R9906,R9907,R9908,R9909 | R_0603_1608Metric | C4190
RS-03K5623FT | R9508 | R_0603_1608Metric | C321950
0603WAF1303T5E | R9509 | R_0603_1608Metric | C22795
0603WAF3301T5E | R9510,R9513 | R_0603_1608Metric | C22978
0603WAF6493T5E | R9511 | R_0603_1608Metric | C25821
CL0603FN121KP | R9512 | R_0603_1608Metric | C48996814
RS-03K7153FT | R9514 | R_0603_1608Metric | C321989
0603WAF2203T5E | R9515 | R_0603_1608Metric | C22961
0603WAF5102T5E | R9516 | R_0603_1608Metric | C23196
0603WAF1503T5E | R9517 | R_0603_1608Metric | C22807
0603WAF1302T5E | R9518 | R_0603_1608Metric | C22797
0603WAF1502T5E | R9519,R9526 | R_0603_1608Metric | C22809
0603WAF5601T5E | R9523 | R_0603_1608Metric | C23189
0603WAF7501T5E | R9525 | R_0603_1608Metric | C23234
OPA1678IDR | U1001,U101,U1101,U1201,U1301,U1401,U1501,U1601,U1701,U1801,U1901,U2001,U201,U2101,U2201,U2301,U2401,U2501,U2601,U2701,U2801,U2901,U3001,U301,U3101,U3201,U3301,U3401,U3501,U3601,U3701,U3801,U3901,U4001,U401,U4101,U4201,U4301,U4401,U4501,U4601,U4701,U4801,U4901,U5001,U501,U5101,U5201,U5301,U5401,U5501,U5601,U5701,U5801,U5901,U6001,U601,U6101,U6201,U6301,U6401,U701,U801,U901 | SOIC-8_3.9x4.9mm_P1.27mm | C192421
74HCT595D,118 | U10101,U10201,U10301,U10401,U10501,U10601,U10701,U10801,U10901,U11001,U11101,U11201,U11301,U11401,U11501,U11601 | SOIC-16_3.9x9.9mm_P1.27mm | C282339
UCC27524DR | U10102,U10103,U10202,U10203,U10302,U10303,U10402,U10403,U10502,U10503,U10602,U10603,U10702,U10703,U10802,U10803,U10902,U10903,U11002,U11003,U11102,U11103,U11202,U11203,U11302,U11303,U11402,U11403,U11502,U11503,U11602,U11603 | SOIC-8_3.9x4.9mm_P1.27mm | C465729
SN74AHCT1G125DBVR | U12101,U12201,U12301,U12401 | SOT-23-5 | C7484
74LVC2G34GW | U13101,U13201,U13301,U13401,U13501,U13601,U13701,U13801,U13901,U14001 | SOT-363_SC-70-6 | C52140488
TLV320ADC5140IRTWR | U7101,U7201,U7301,U7401,U7501,U7601,U7701,U7801,U7901,U8001,U8101,U8201,U8301,U8401,U8501,U8601 | Texas_RTW_WQFN-24-1EP_4x4mm_P0.5mm_EP2.7x2.7mm_ThermalVias | C2876368
TPS54302DDCR | U9501 | SOT-23-6 | C311983
TPS65131RGER | U9502 | VQFN-24-1EP_4x4mm_P0.5mm_EP2.45x2.45mm_ThermalVias | C87663
TPS7A4700RGWT | U9503,U9507 | Texas_RGW0020A_VQFN-20-1EP_5x5mm_P0.65mm_EP3.15x3.15mm_ThermalVias | C28286
TPS7A3301RGWR | U9504 | Texas_RGW0020A_VQFN-20-1EP_5x5mm_P0.65mm_EP3.15x3.15mm_ThermalVias | C90082
LM2731XMFX/NOPB | U9505 | SOT-23-5 | C485804
TLV75733PDBVR | U9506 | SOT-23-5 | C485517
TPS26600PWPR | U9508 | HTSSOP-16-1EP_4.4x5mm_P0.65mm_EP3.4x5mm_Mask2.66x2.46mm_ThermalVias | C544399
