tieziyun/ultrasonic-aesa/docs/assembly/aesa_assembly.pdf

1 | 2 | 3 | 4 | 5 | 6

AB

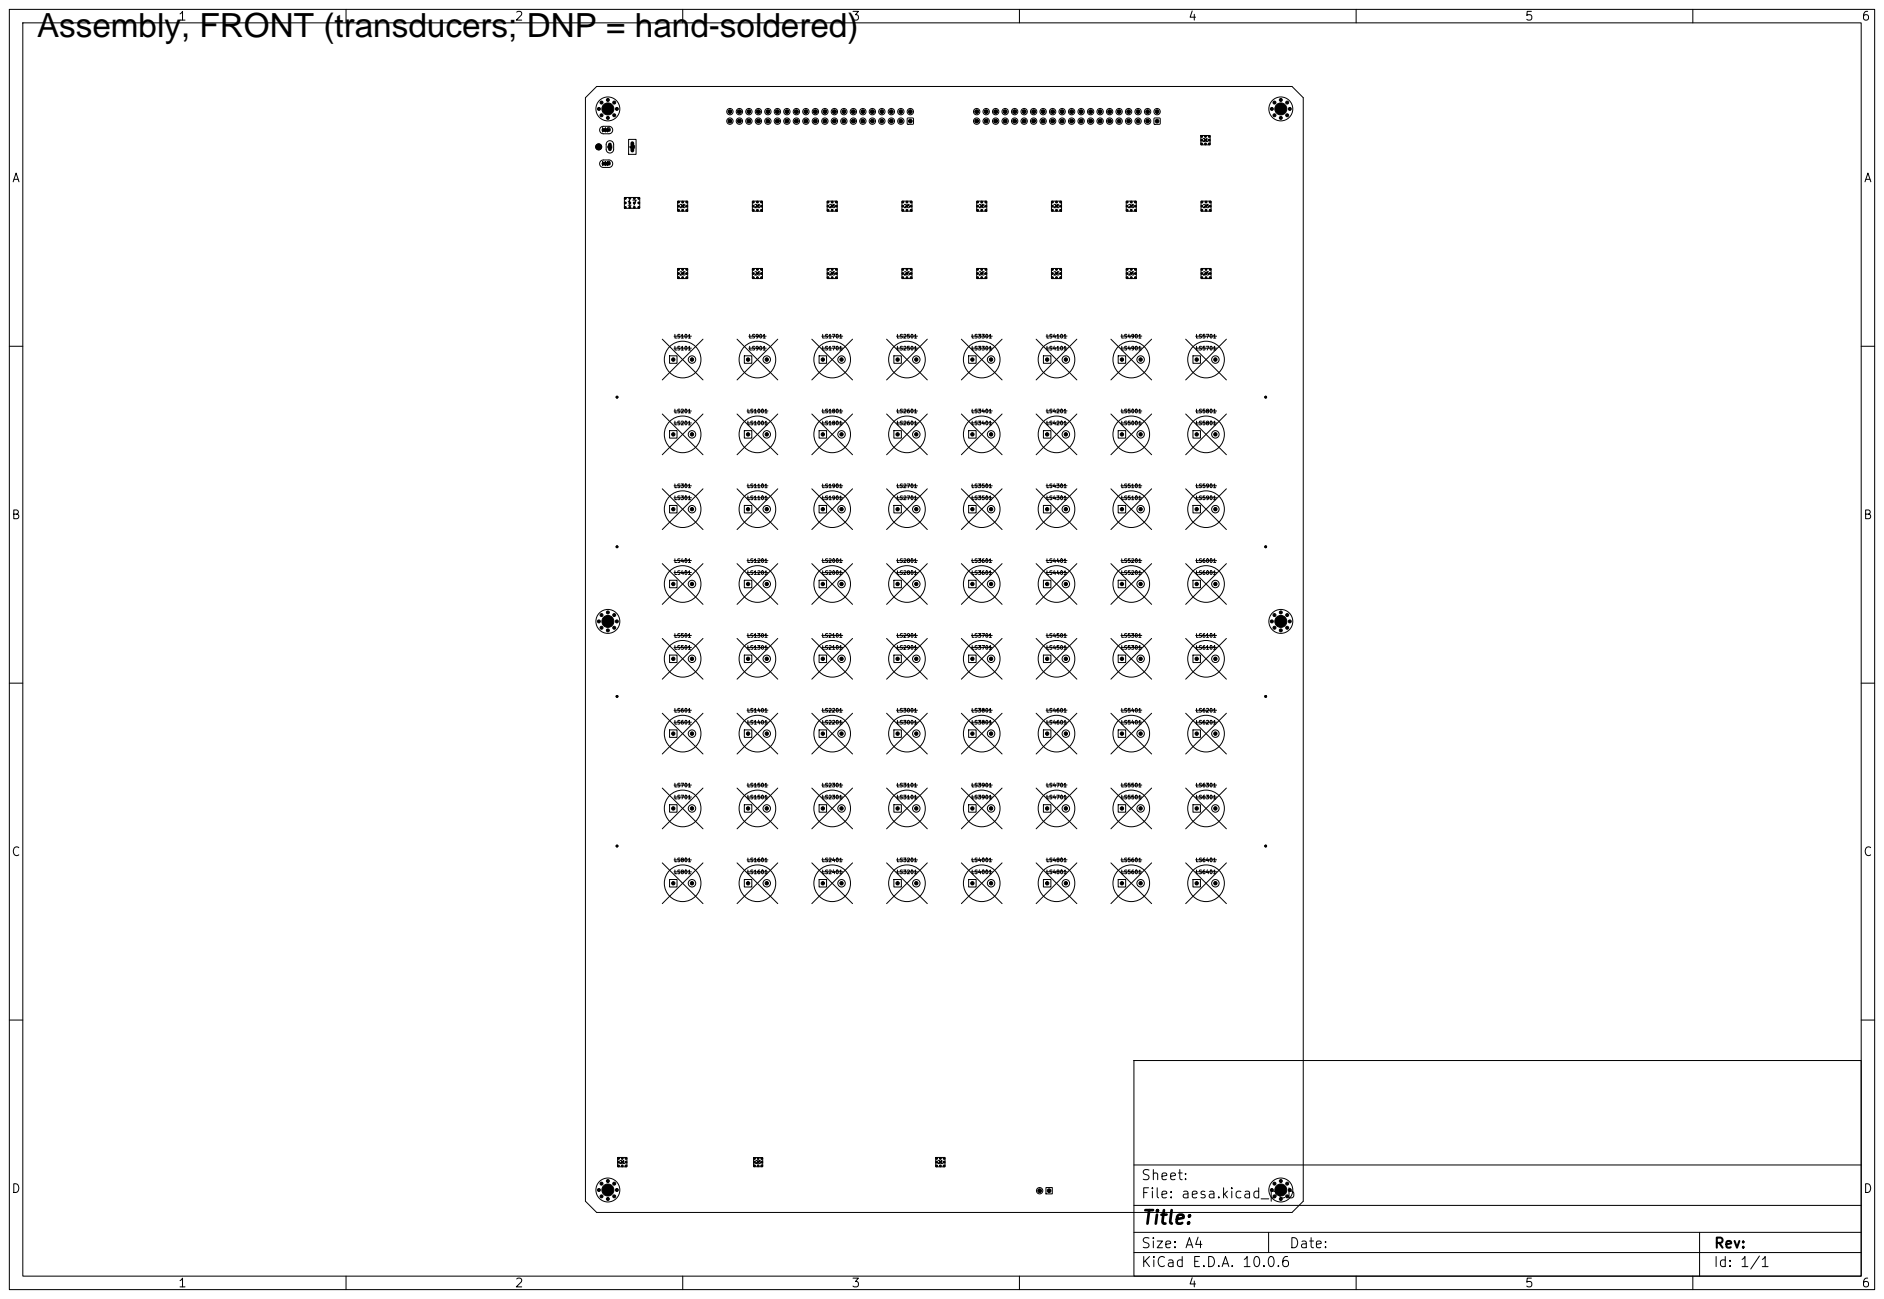
[picture p14: page 1]
D Date:; KiCad E.D.A. 10.0.6; Size: A4; Rev:; Title:; File: aesa.kicad_pcb; Sheet:; 1 MPMP

Assembly, FRONT (transducers; DNP = hand-soldered)

1 | 2 | 3 | 4 | 5 | 6 1 | 2 | 3 | 4 | 5 | 6 ABCD | ABCD Date:
D4601 D4601 | R7904 R7904

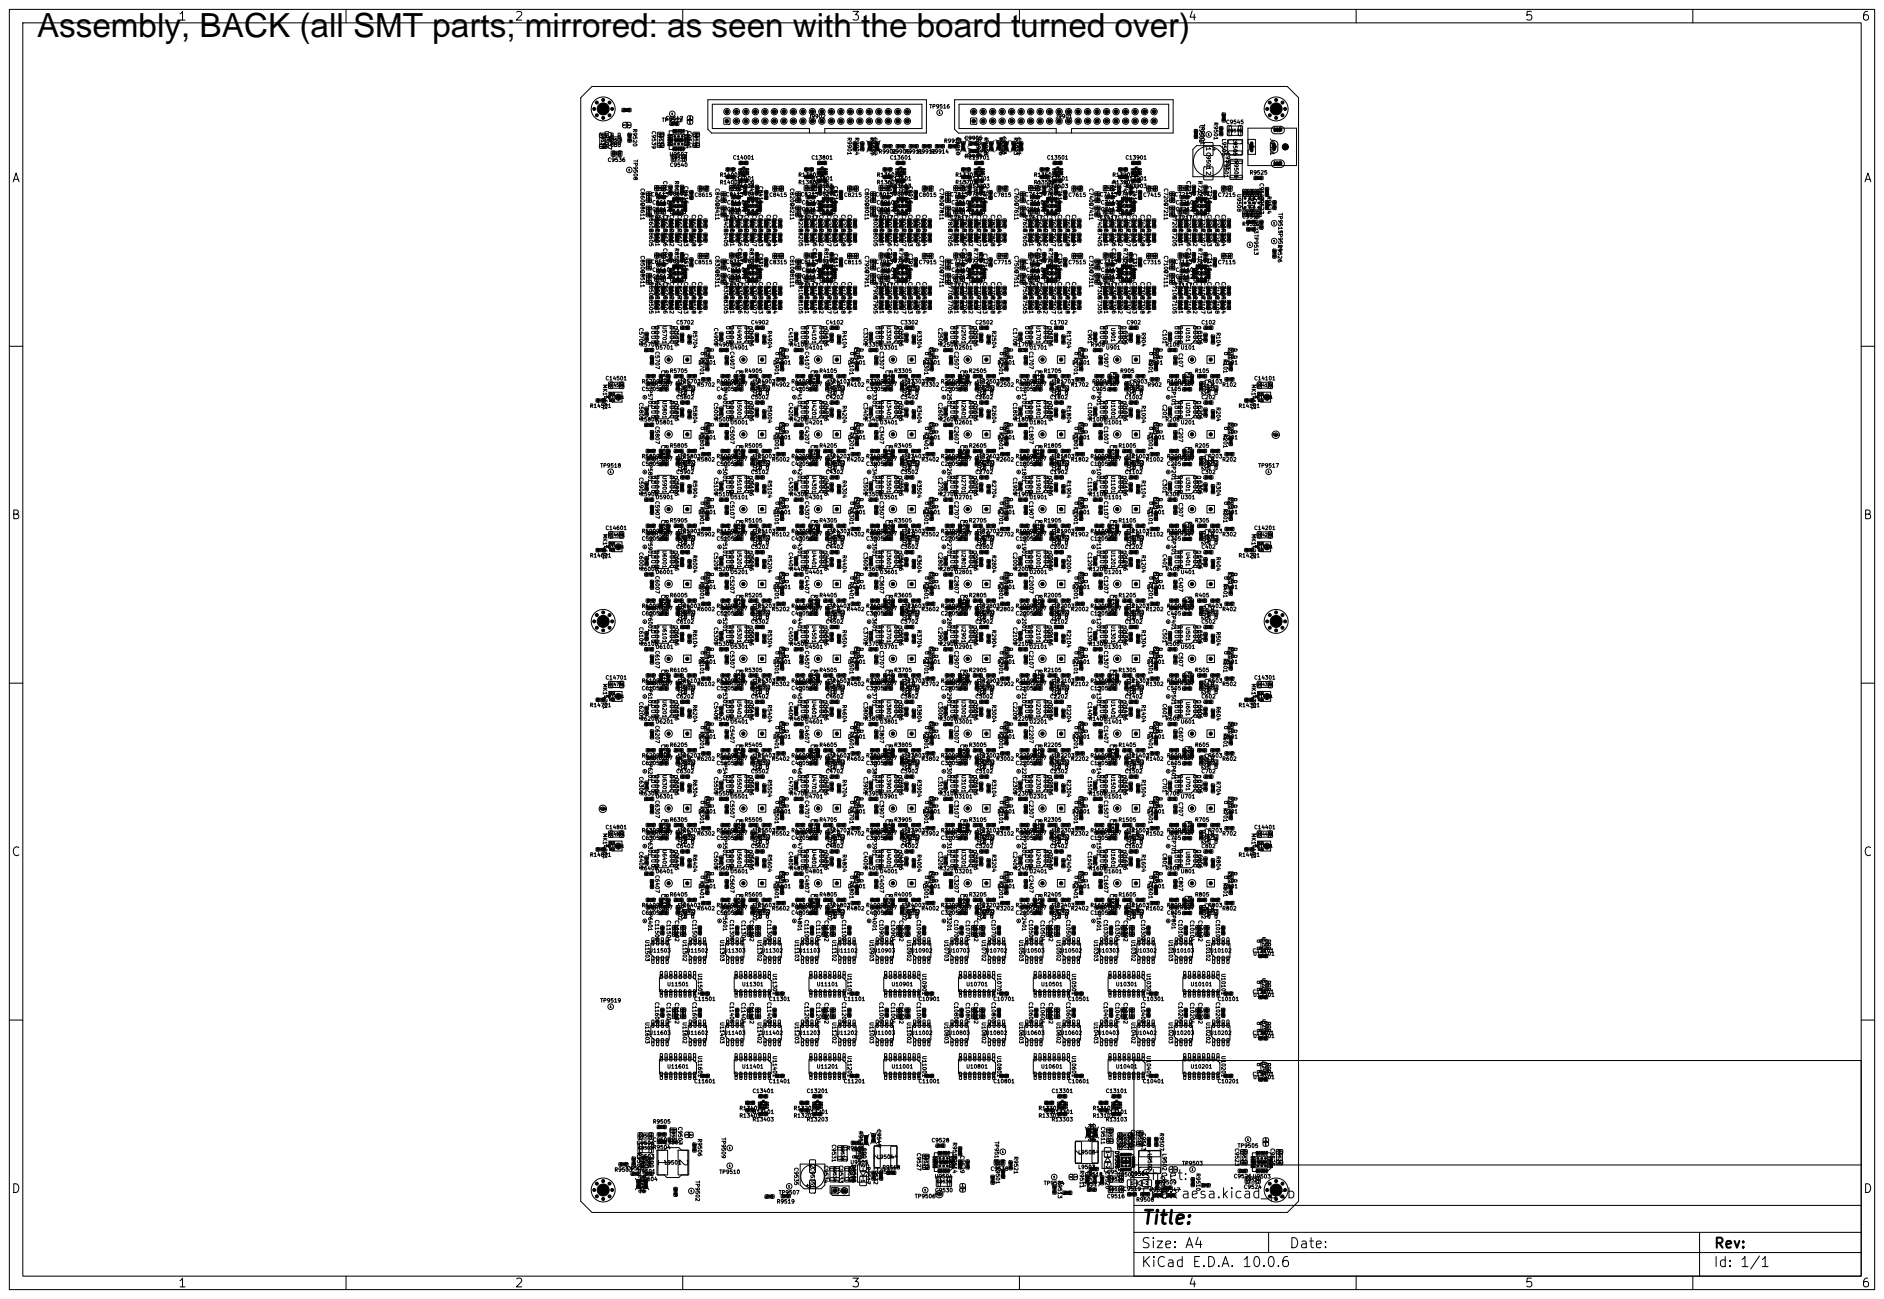
[picture p15: page 2]
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
