tieziyun/ultrasonic-aesa/docs/schematics/aesa_schematic.pdf

1 | 2 | 3 | 4 | 5 | 6 | 7 | 8

AB

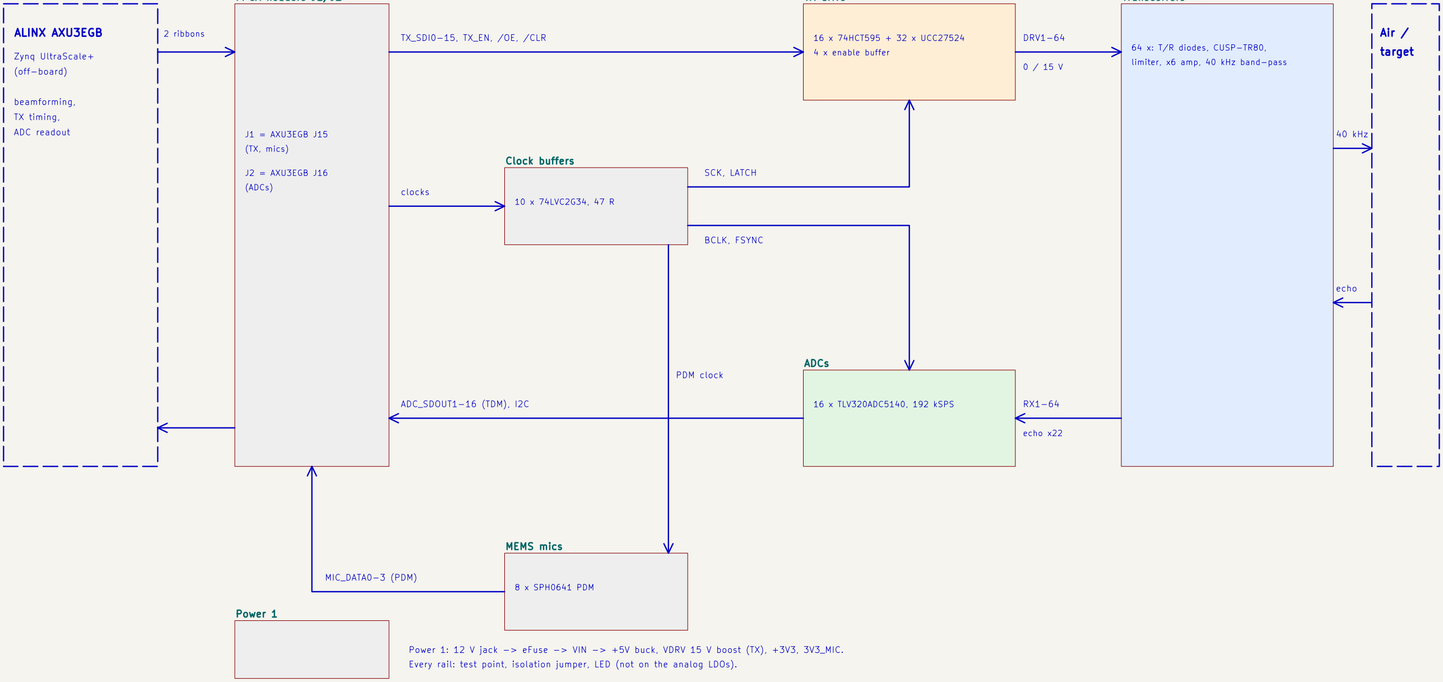
[picture p16: figure]
Clock buffers; ADCs; MEMS mics; Power 1; ALINX AXU3EGB; Zynq UltraScale+; 2 ribbons; beamforming,; TX timing,; ADC readout; TX_SDI0-15, TX_EN, /OE, /CLR; J1 = AXU3EGB J15; (TX, mics); J2 = AXU3EGB J16; (ADCs); Air / target; 40 kHz; BCLK, FSYNC; PDM clock; (off-board); DRV1-64; 16 x 74HCT595 + 32 x UCC27524; 4 x enable buffer; echo; 64 x: T/R diodes, CUSP-TR80,; limiter, x6 amp, 40 kHz band-pass; echo x22; SCK, LATCH; clocks; 10 x 74LVC2G34, 47 R; MIC_DATA0-3 (PDM); 8 x SPH0641 PDM

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
### F Date: 2026-10-24 KiCad E.D.A. 10.0.6

Size: A3 | Rev: 1

# Title: Hybrid 8x8 ultrasonic AESA: block diagram

File: aesa.kicad_sch

### Sheet: /

### Hybrid 8x8 ultrasonic AESA

### Power 2 (analog)

FPGA headers J1/J2 | TX drive

### Transceivers

3. Transceivers: the 64 CUSP-TR80 elements emit 40 kHz; echoes return to the same elements.
5. ADCs: 16 x TLV320ADC5140 sample all 64 channels at once, 192 kSPS (raw waveform, amplitude and phase).
4. The diode T/R switch and limiter protect the receiver; amplifier + 40 kHz band-pass give x22.
6. The samples go back to the FPGA over the ribbon, which forms the beams. 8 MEMS mics add wideband audio.

Click a block to open it. Repeated parts are one sheet each: channel x64, adc x16, tx_group x16, en_buf x4, clk_buf x10, mic x8.

# Hybrid 8x8 ultrasonic AESA: how the signal flows

1. The FPGA streams one TX bit per element (16 serial lines, 10 MHz) and the clocks.
2. TX drive: shift registers latch the bits; gate drivers switch each element between 0 and 15 V.
ADC_SDOUT1-16 (TDM), I2C | 16 x TLV320ADC5140, 192 kSPS

Power 1: 12 V jack -> eFuse -> VIN -> +5V buck, VDRV 15 V boost (TX), +3V3, 3V3_MIC.

Power 2 (analog): +5V -> +-6V5 -> +-5VA (receivers), +3V3A (ADCs).

Every rail: test point, isolation jumper, LED (not on the analog LDOs).

Id: 1/15

Pin 2 (+5V) and 39/40 (+3.3V) of the FPGA board are left open. Clocks sit between GND conductors (pins 31-37).

AXU3EGB expansion headers (40-pin IDC, 2.54 mm). J1 = board J15 (TX, mics), J2 = board J16 (ADCs: 16 TDM lines, BCLK, FSYNC, I2C).

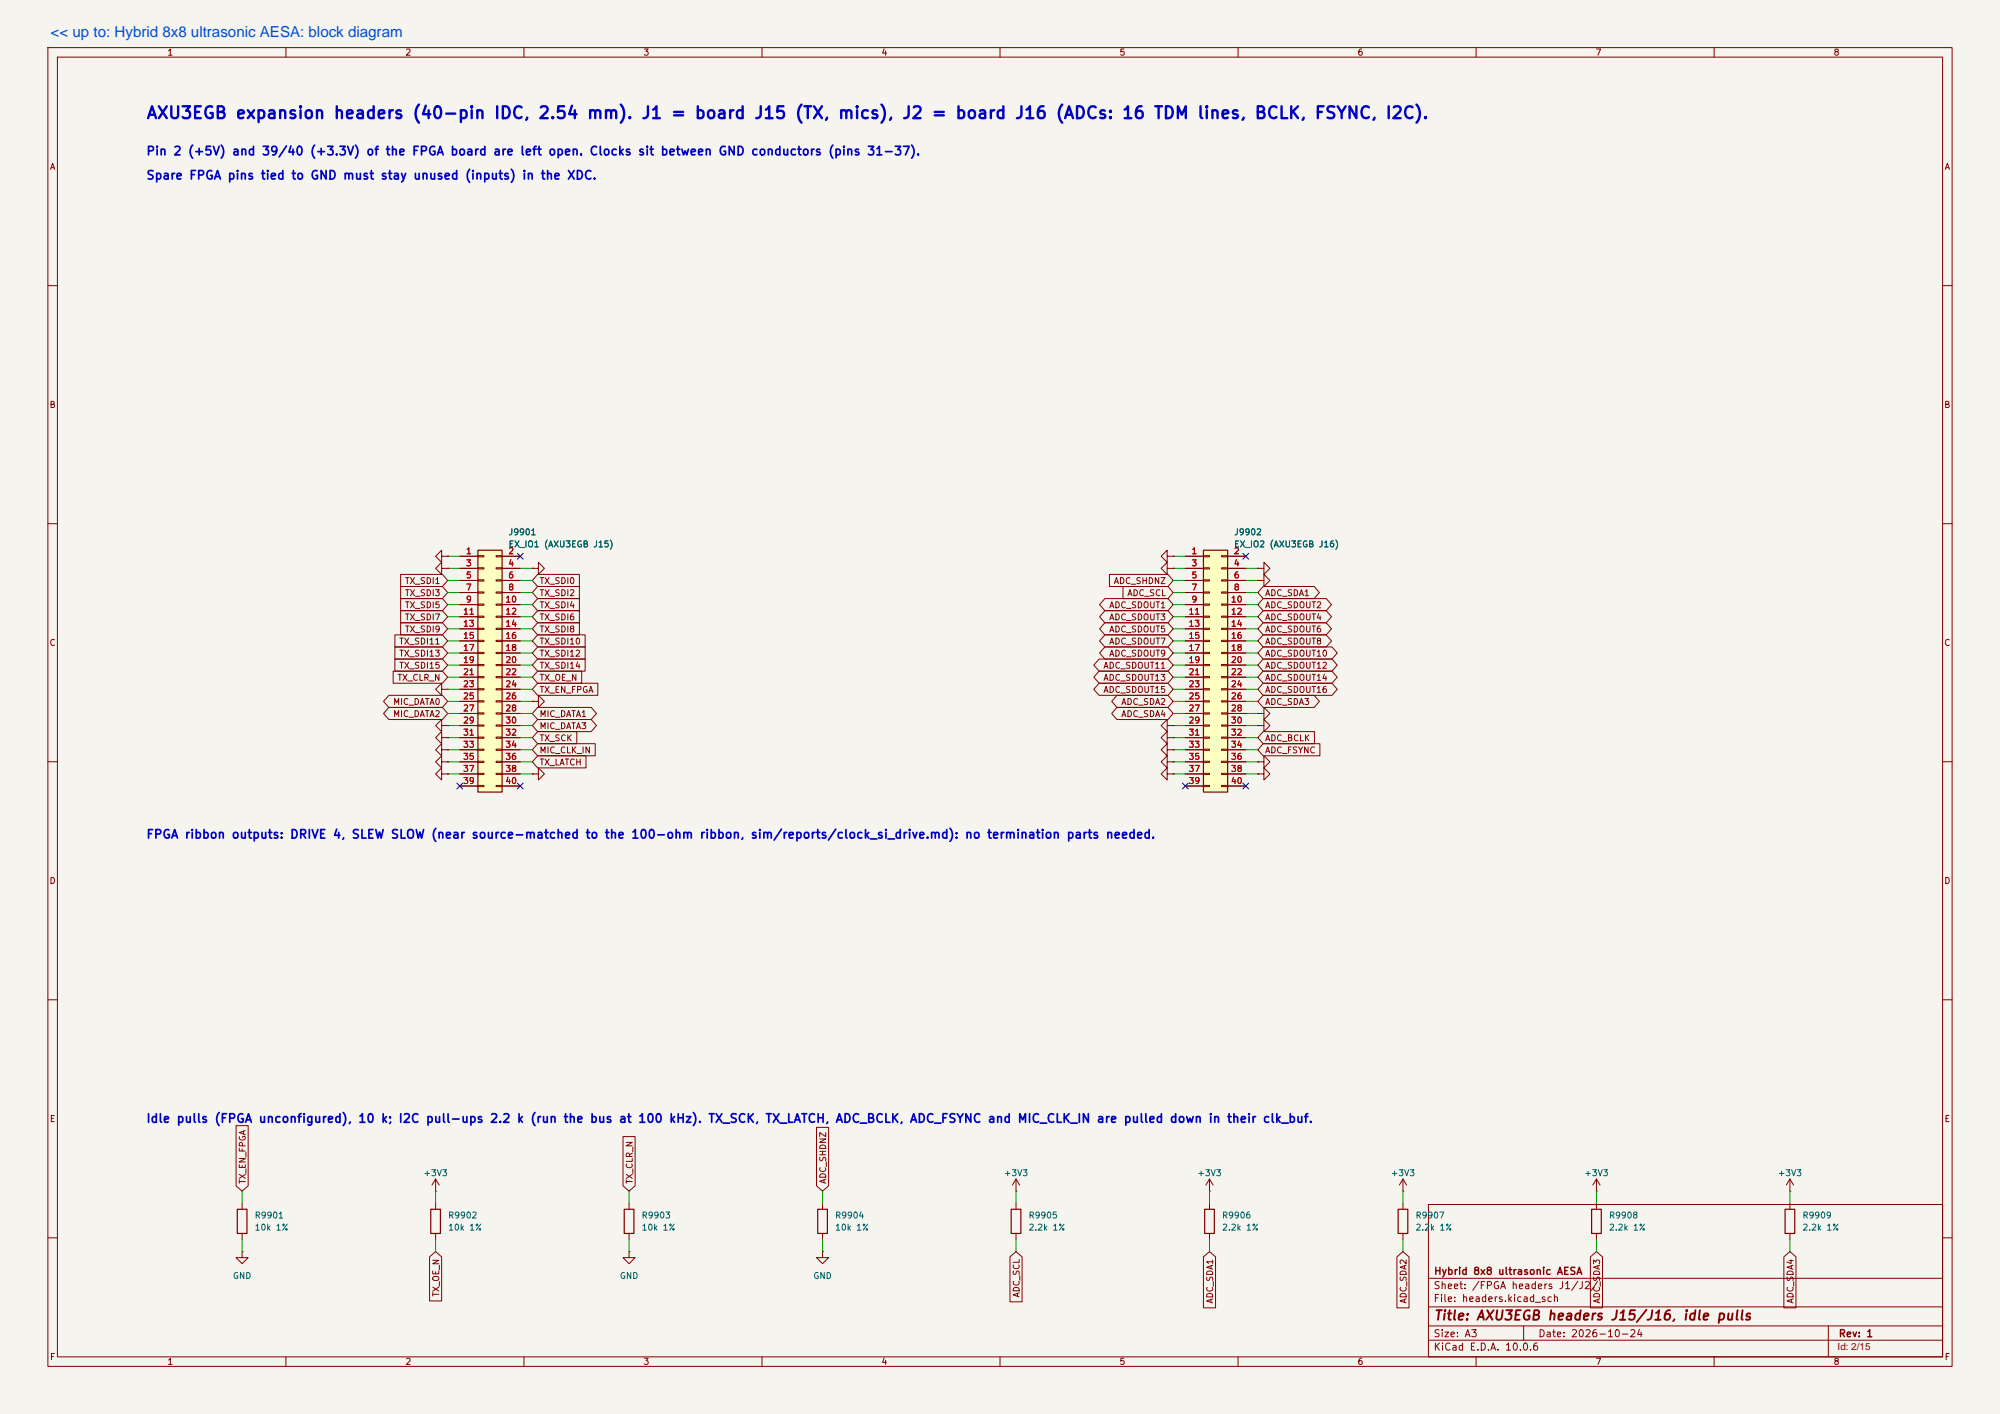
[picture p17: page 2]

<< up to: Hybrid 8x8 ultrasonic AESA: block diagram

FPGA ribbon outputs: DRIVE 4, SLEW SLOW (near source-matched to the 100-ohm ribbon, sim/reports/clock_si_drive.md): no termination parts needed.

Idle pulls (FPGA unconfigured), 10 k; I2C pull-ups 2.2 k (run the bus at 100 kHz). TX_SCK, TX_LATCH, ADC_BCLK, ADC_FSYNC and MIC_CLK_IN are pulled down in their clk_buf.

Hybrid 8x8 ultrasonic AESA
Sheet: /FPGA headers J1/J2/
File: headers.kicad_sch
Title: AXU3EGB headers J15/J16, idle pulls

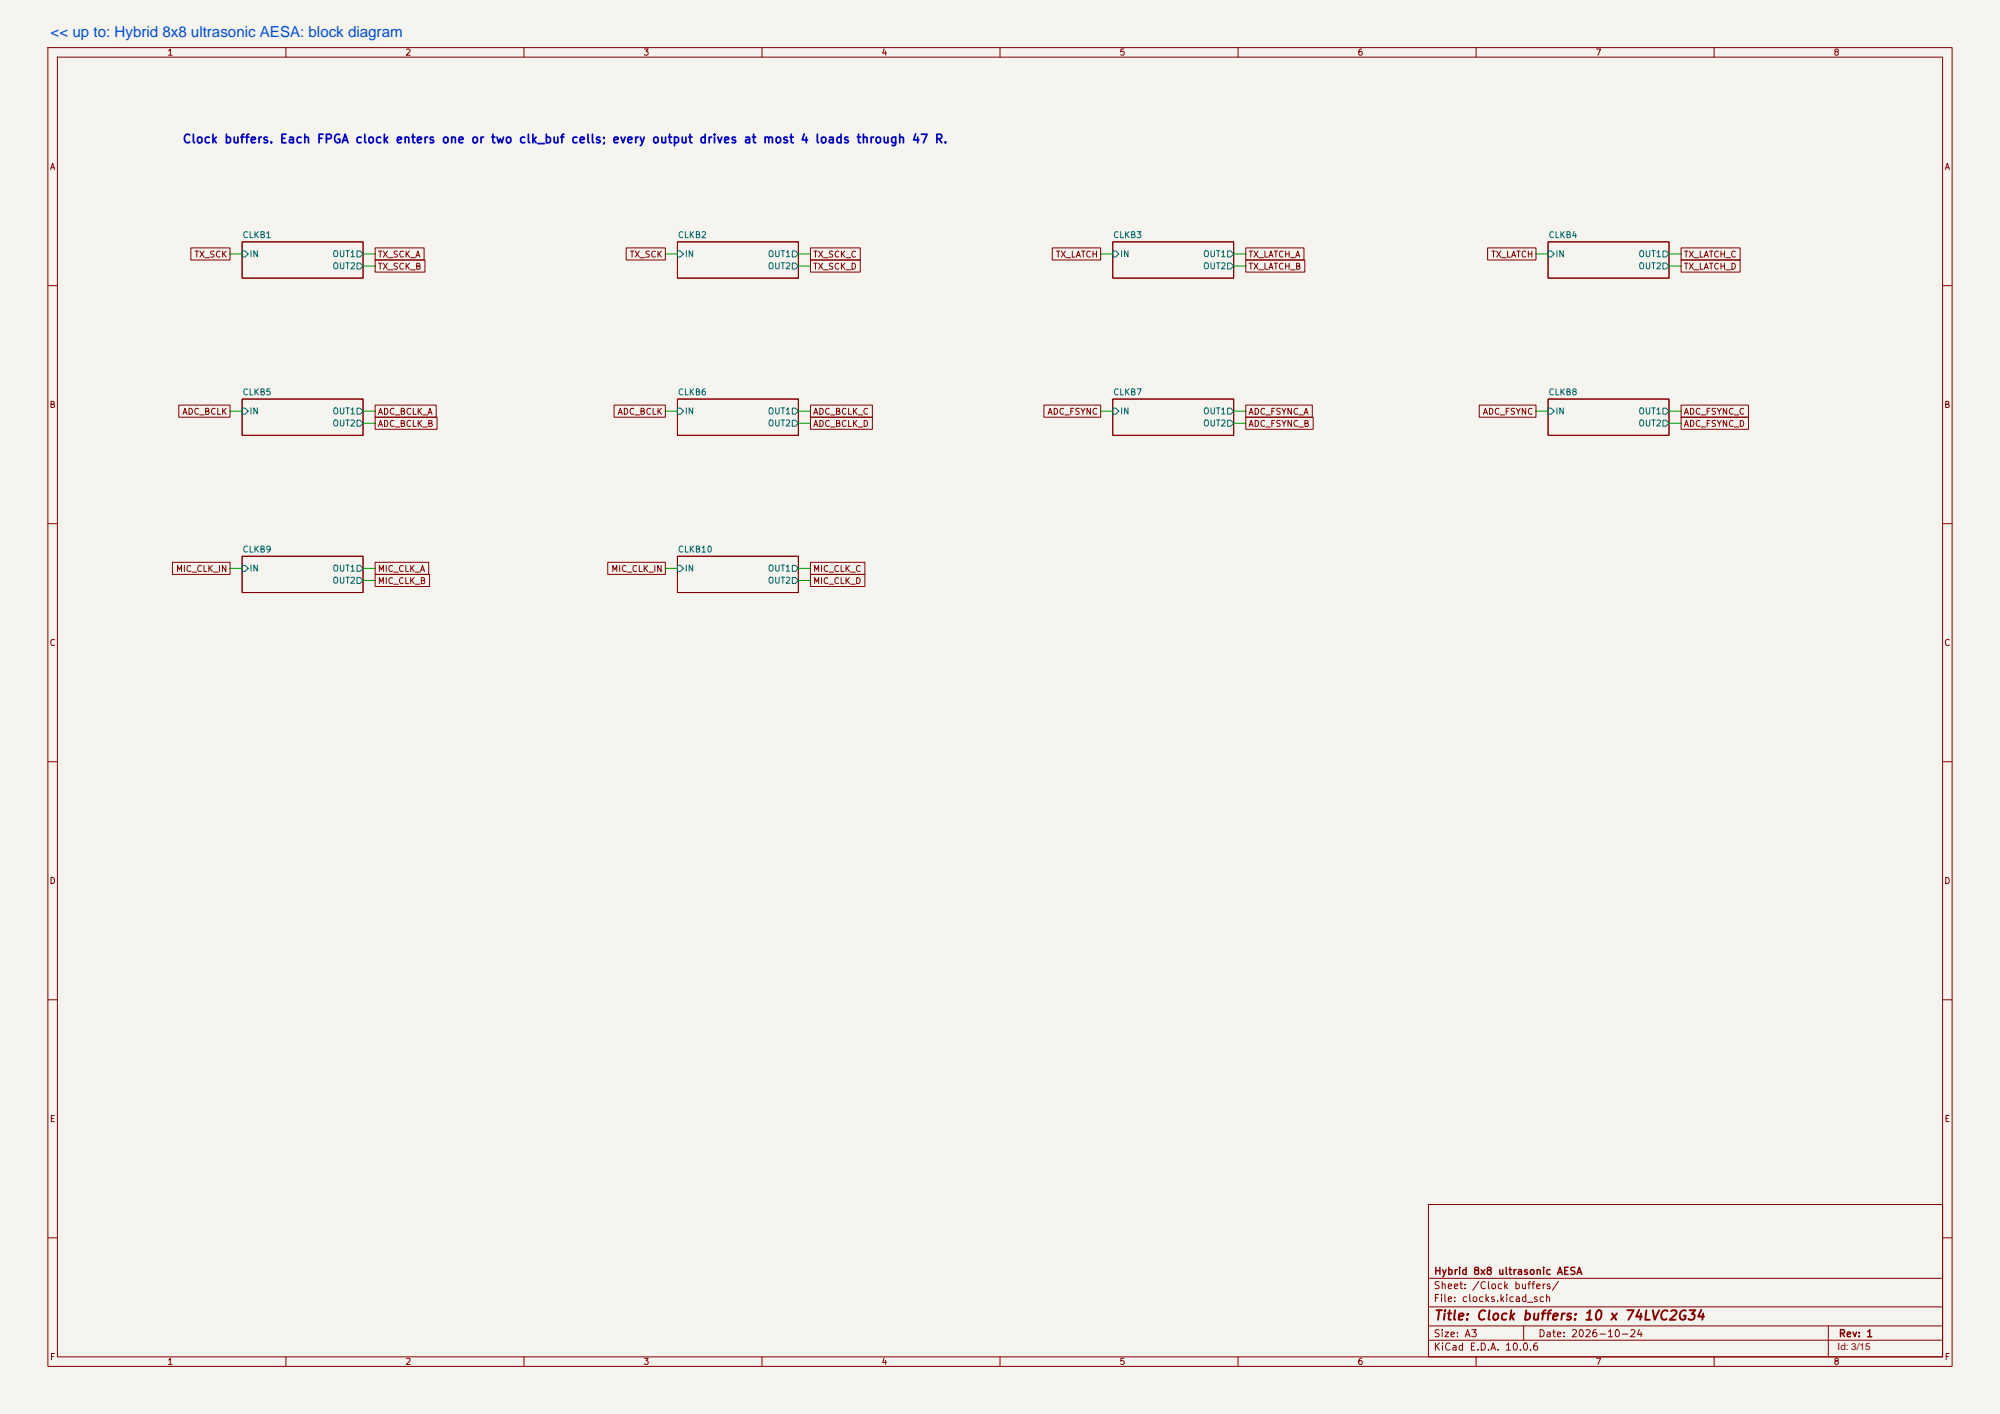
[picture p18: page 3]
OUT1 OUT2 CLKB9; OUT1 OUT2 CLKB6; OUT1 OUT2 CLKB1; OUT1 OUT2 CLKB5; OUT1 OUT2 CLKB2; OUT1 OUT2 CLKB10; OUT1 OUT2 CLKB3; OUT1 OUT2 CLKB8; OUT1 OUT2 CLKB4; OUT1 OUT2 CLKB7; TX_SCK_B; TX_SCK MIC_CLK_A; TX_SCK_D; ADC_BCLK; ADC_BCLK_C; ADC_BCLK_D; ADC_BCLK_A MIC_CLK_IN; MIC_CLK_C MIC_CLK_D; ADC_BCLK_B; TX_SCK; TX_SCK_C; TX_LATCH; TX_LATCH_A; TX_LATCH_B; ADC_FSYNC_A ADC_FSYNC_B; TX_LATCH_C MIC_CLK_B TX_LATCH_D MIC_CLK_IN; ADC_FSYNC; TX_SCK_A; ADC_FSYNC_C

ADC_FSYNC_D Clock buffers. Each FPGA clock enters one or two clk_buf cells; every output drives at most 4 loads through 47 R.

Hybrid 8x8 ultrasonic AESA
Sheet: /Clock buffers/
File: clocks.kicad_sch
Title: Clock buffers: 10 x 74LVC2G34

1 | 2 | 3 | 4 | 5 | 6

AB

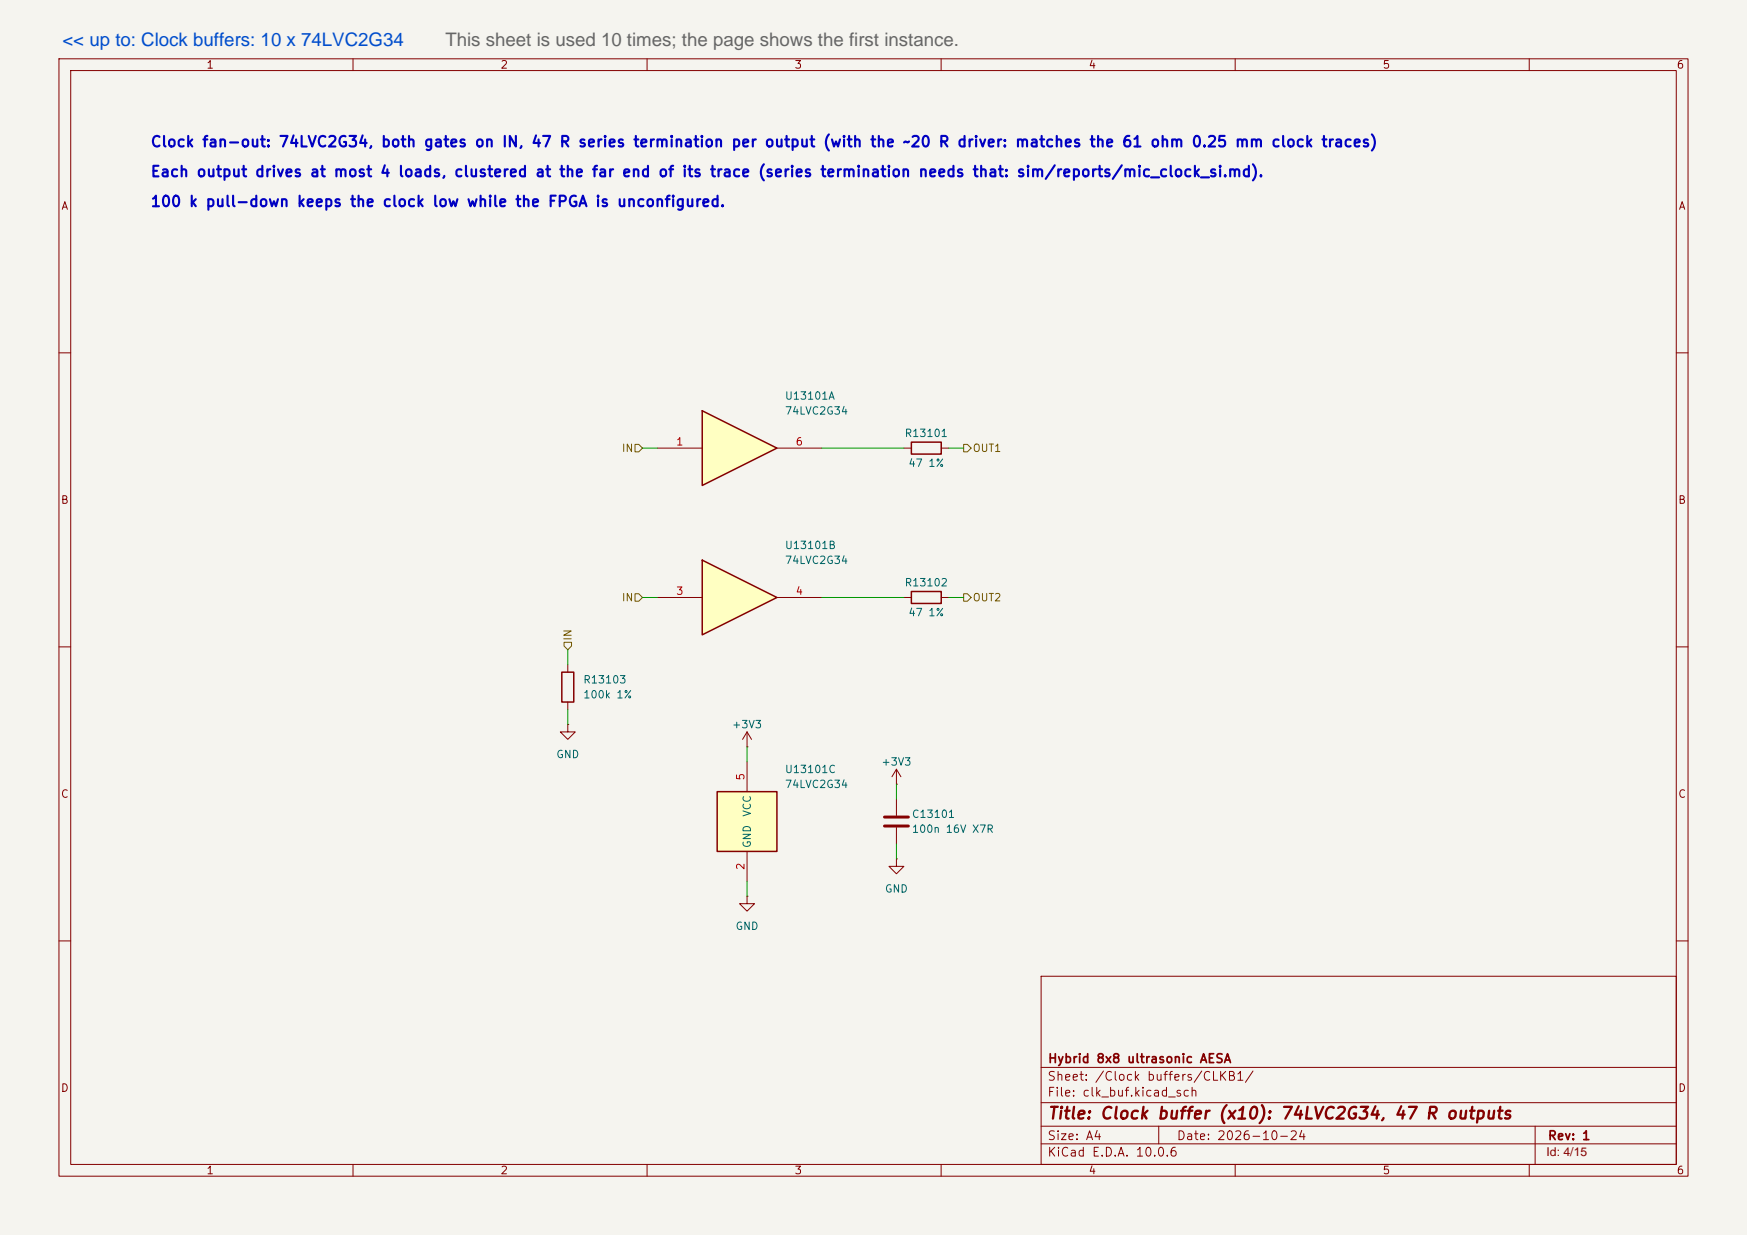
[picture p19: page 4]
D Date: 2026-10-24; Size: A4; Rev: 1; 6 U13101A 74LVC2G34; 74LVC2G34 GND; +3V3 GNDGND; 2 VCC; 74LVC2G34 R13103 100k 1%; GND; OUT1; OUT2 IN; << up to: Clock buffers: 10 x 74LVC2G34; This sheet is used 10 times; the page shows the first instance.

Clock fan-out: 74LVC2G34, both gates on IN, 47 R series termination per output (with the ~20 R driver: matches the 61 ohm 0.25 mm clock traces)

Each output drives at most 4 loads, clustered at the far end of its trace (series termination needs that: sim/reports/mic_clock_si.md).

100 k pull-down keeps the clock low while the FPGA is unconfigured.

Hybrid 8x8 ultrasonic AESA
Sheet: /Clock buffers/CLKB1/
File: clk_buf.kicad_sch
Title: Clock buffer (x10): 74LVC2G34, 47 R outputs

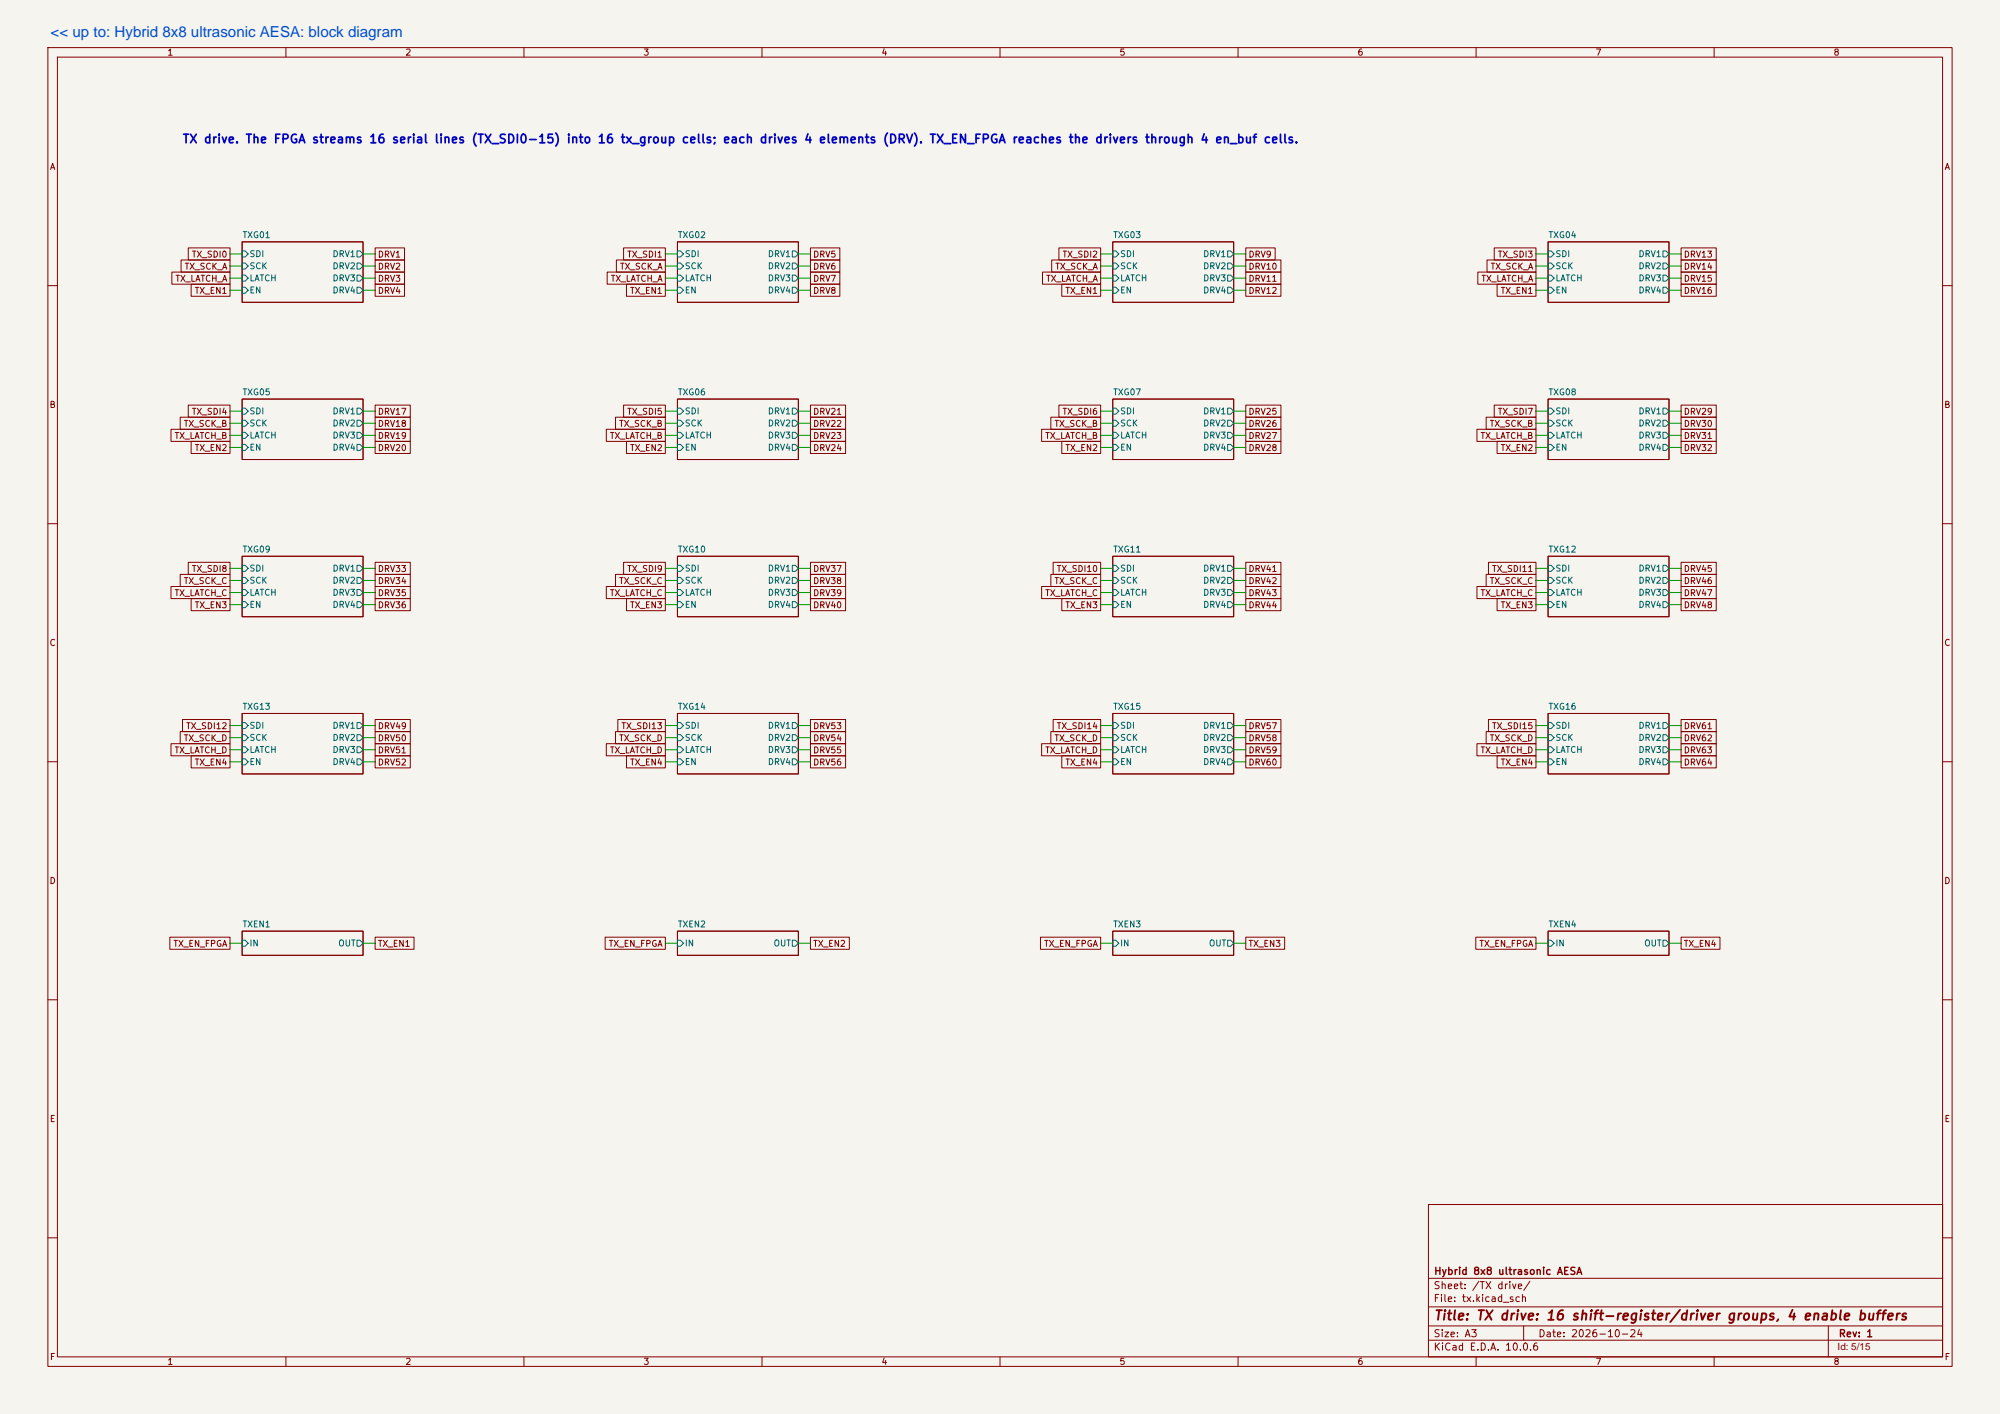
[picture p20: page 5]
SDI SCK; LATCH EN; DRV1 DRV2 DRV3 DRV4; TXG09; TXG12; OUT; TXEN2; TXG10; TXG13; TXG06; TXG08; TXG01; TXG04; TXG11; TXEN3; TXEN4; TXG02; TXG15; TXG07; TXG14; TXG16; TXG05; TXEN1; TXG03 DRV1 DRV2 DRV3 DRV4; DRV56; TX_SDI1; TX_SCK_A TX_LATCH_A; TX_EN_FPGA; DRV9; TX_SDI5 TX_SCK_B TX_LATCH_B; DRV10; DRV11 DRV12; TX_SDI0; TX_SDI3; TX_SCK_A DRV5 DRV6 DRV7 DRV8; TX_LATCH_A TX_EN1; TX_SDI7 TX_SCK_B; TX_SDI2; TX_LATCH_B; TX_SCK_A; TX_SDI11; TX_LATCH_A; TX_SCK_C; TX_LATCH_C TX_EN3; TX_SDI4; TX_SDI6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

TX drive. The FPGA streams 16 serial lines (TX_SDI0-15) into 16 tx_group cells; each drives 4 elements (DRV). TX_EN_FPGA reaches the drivers through 4 en_buf cells.

Hybrid 8x8 ultrasonic AESA
Sheet: /TX drive/
File: tx.kicad_sch
Title: TX drive: 16 shift-register/driver groups, 4 enable buffers

1 | 2 | 3 | 4 | 5 | 6

AB

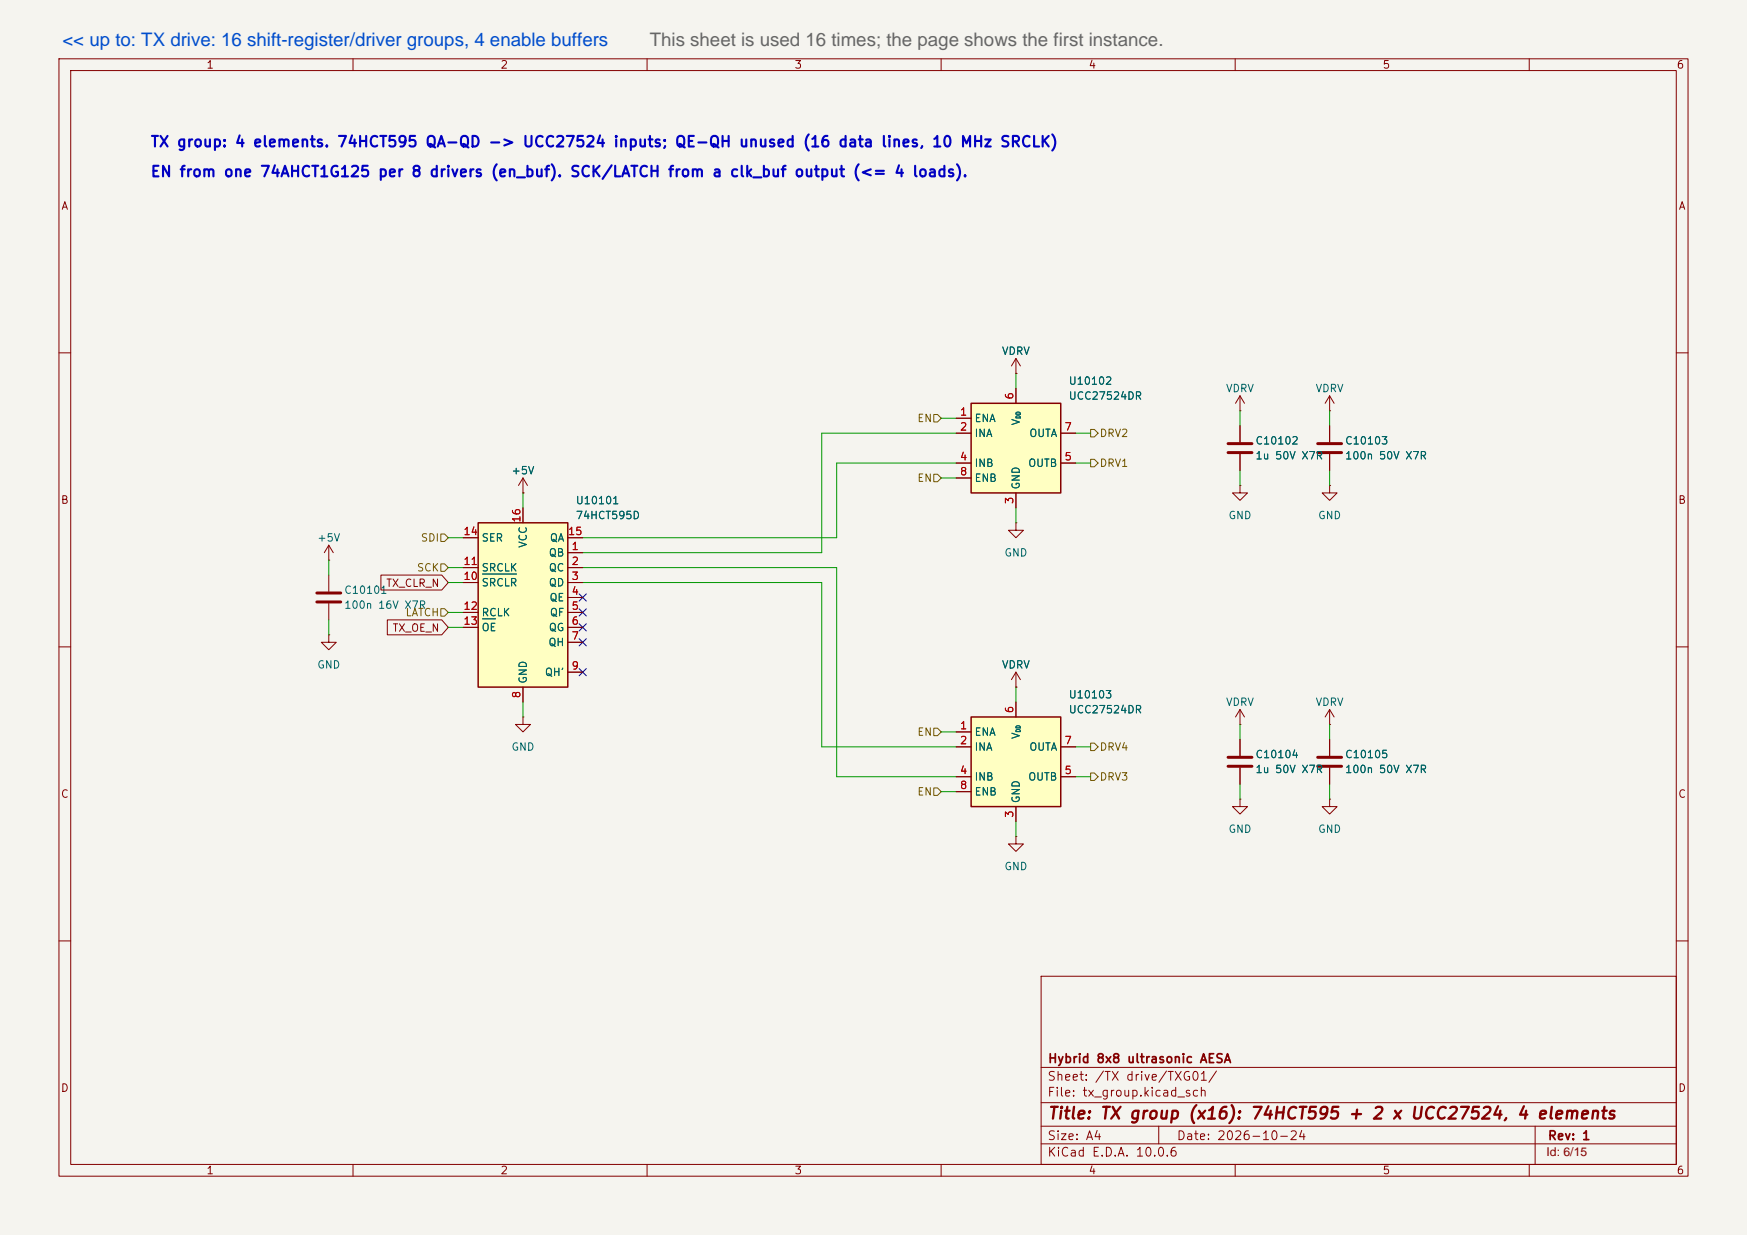
[picture p21: page 6]
D Date: 2026-10-24; Size: A4; Rev: 1; GND; QB 1 QC 2 QD 3 QE 4 QF 5 QG 6 QH 7 GND; SER 14; QA 15 VCC 16; 74HCT595D; VDRV +5V C10101; VDRV GND +5V; ENA 1; INA 2; INB 4; OUTB 5; VDD 6 OUTA 7; ENB 8; U10102 UCC27524DR; U10103 UCC27524DR; VDRV C10103; VDRV C10104; VDRV C10102; VDRV DRV2; LATCH; SCK; DRV1 DRV3; SDI; DRV4; TX_CLR_N; EN from one 74AHCT1G125 per 8 drivers (en_buf). SCK/LATCH from a clk_buf output (<= 4 loads).; VDRV U10101; QA 15 VCC 16 +5V; VDRV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

TX group: 4 elements. 74HCT595 QA-QD -> UCC27524 inputs; QE-QH unused (16 data lines, 10 MHz SRCLK)

74HCT595D QB 1 QC 2 QD 3 QE 4 QF 5 QG 6 QH 7 GND

SRCLR 10 SRCLK 11 RCLK 12 OE 13

Hybrid 8x8 ultrasonic AESA
Sheet: /TX drive/TXG01/
File: tx_group.kicad_sch
Title: TX group (x16): 74HCT595 + 2 x UCC27524, 4 elements

1 | 2 | 3 | 4 | 5 | 6

AB

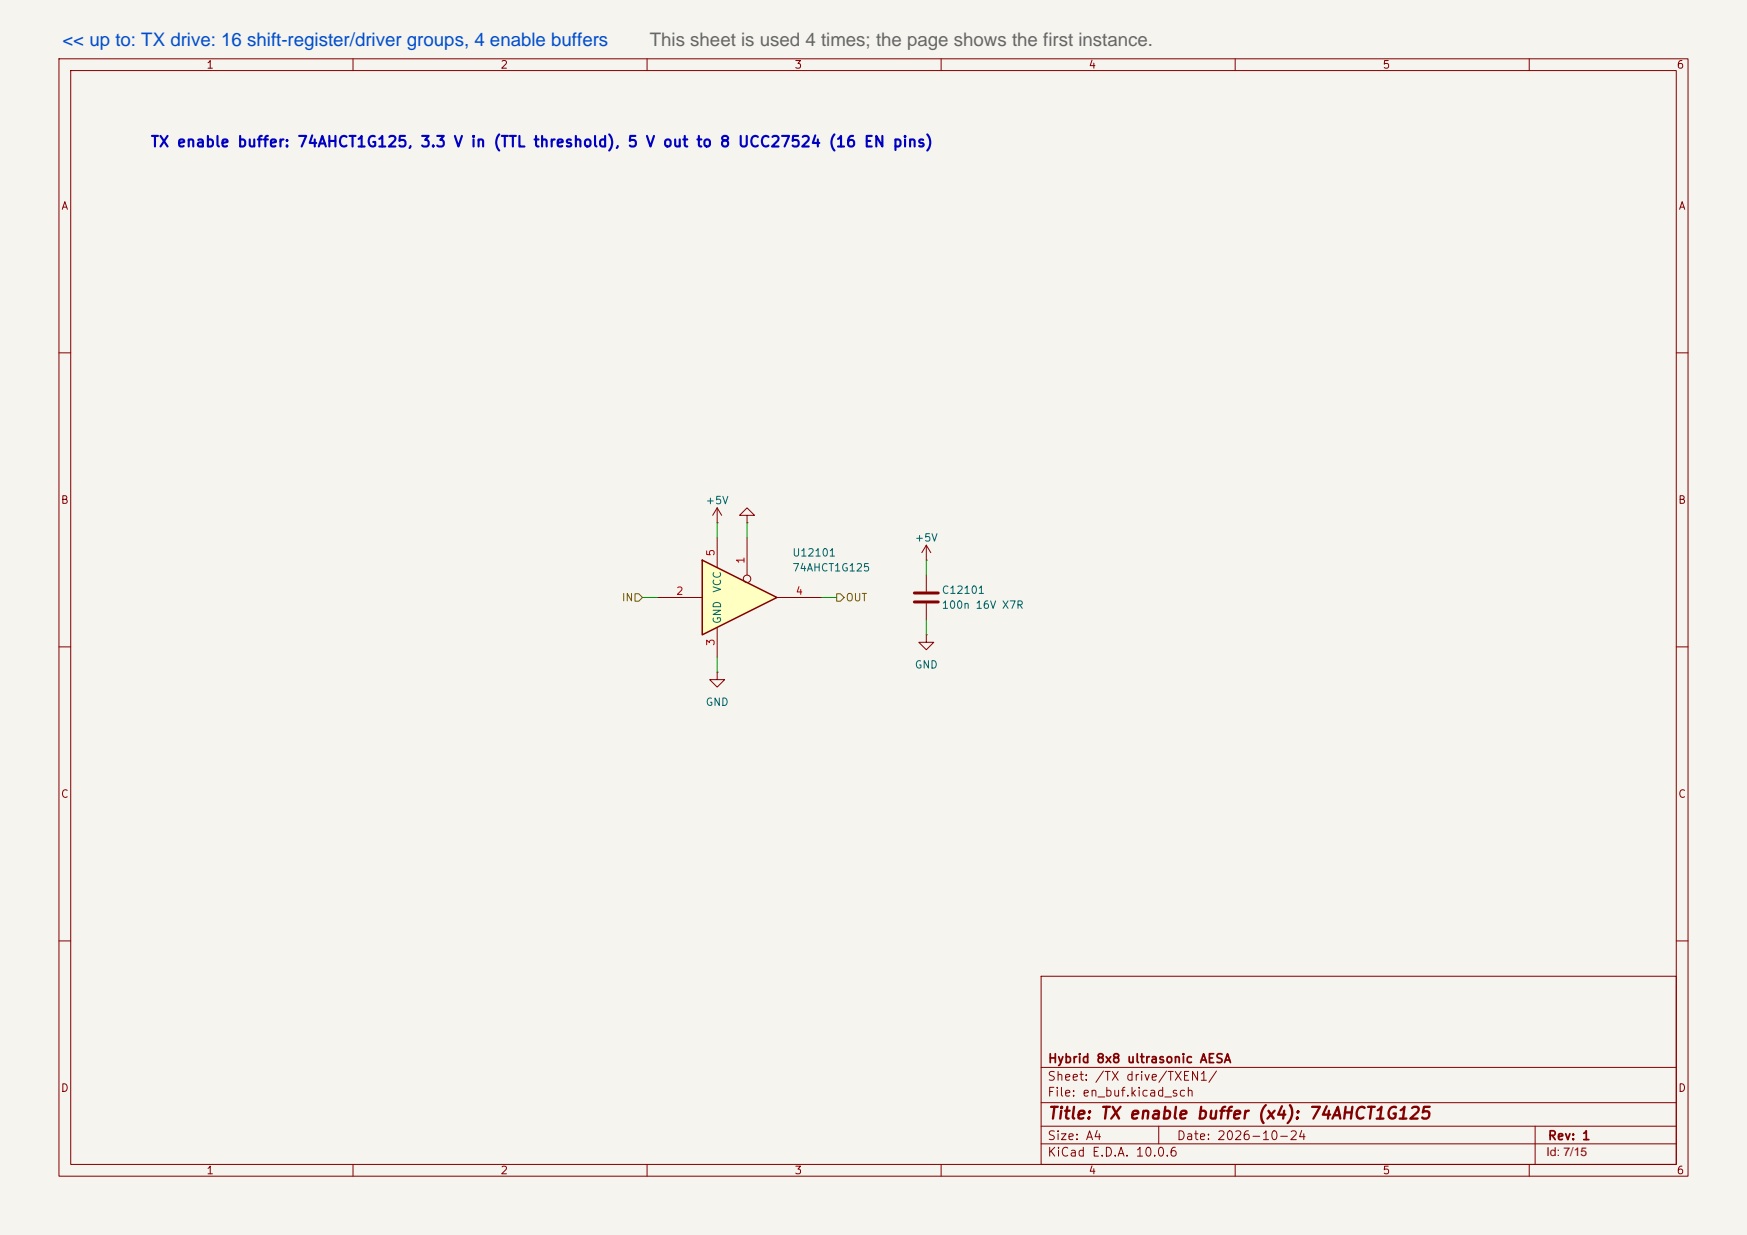
[picture p22: page 7]
D Date: 2026-10-24; Size: A4; Rev: 1; GND; 3 VCC 4; 74AHCT1G125; +5V GND; OUT; << up to: TX drive: 16 shift-register/driver groups, 4 enable buffers; This sheet is used 4 times; the page shows the first instance.

TX enable buffer: 74AHCT1G125, 3.3 V in (TTL threshold), 5 V out to 8 UCC27524 (16 EN pins)

Hybrid 8x8 ultrasonic AESA
Sheet: /TX drive/TXEN1/
File: en_buf.kicad_sch
Title: TX enable buffer (x4): 74AHCT1G125

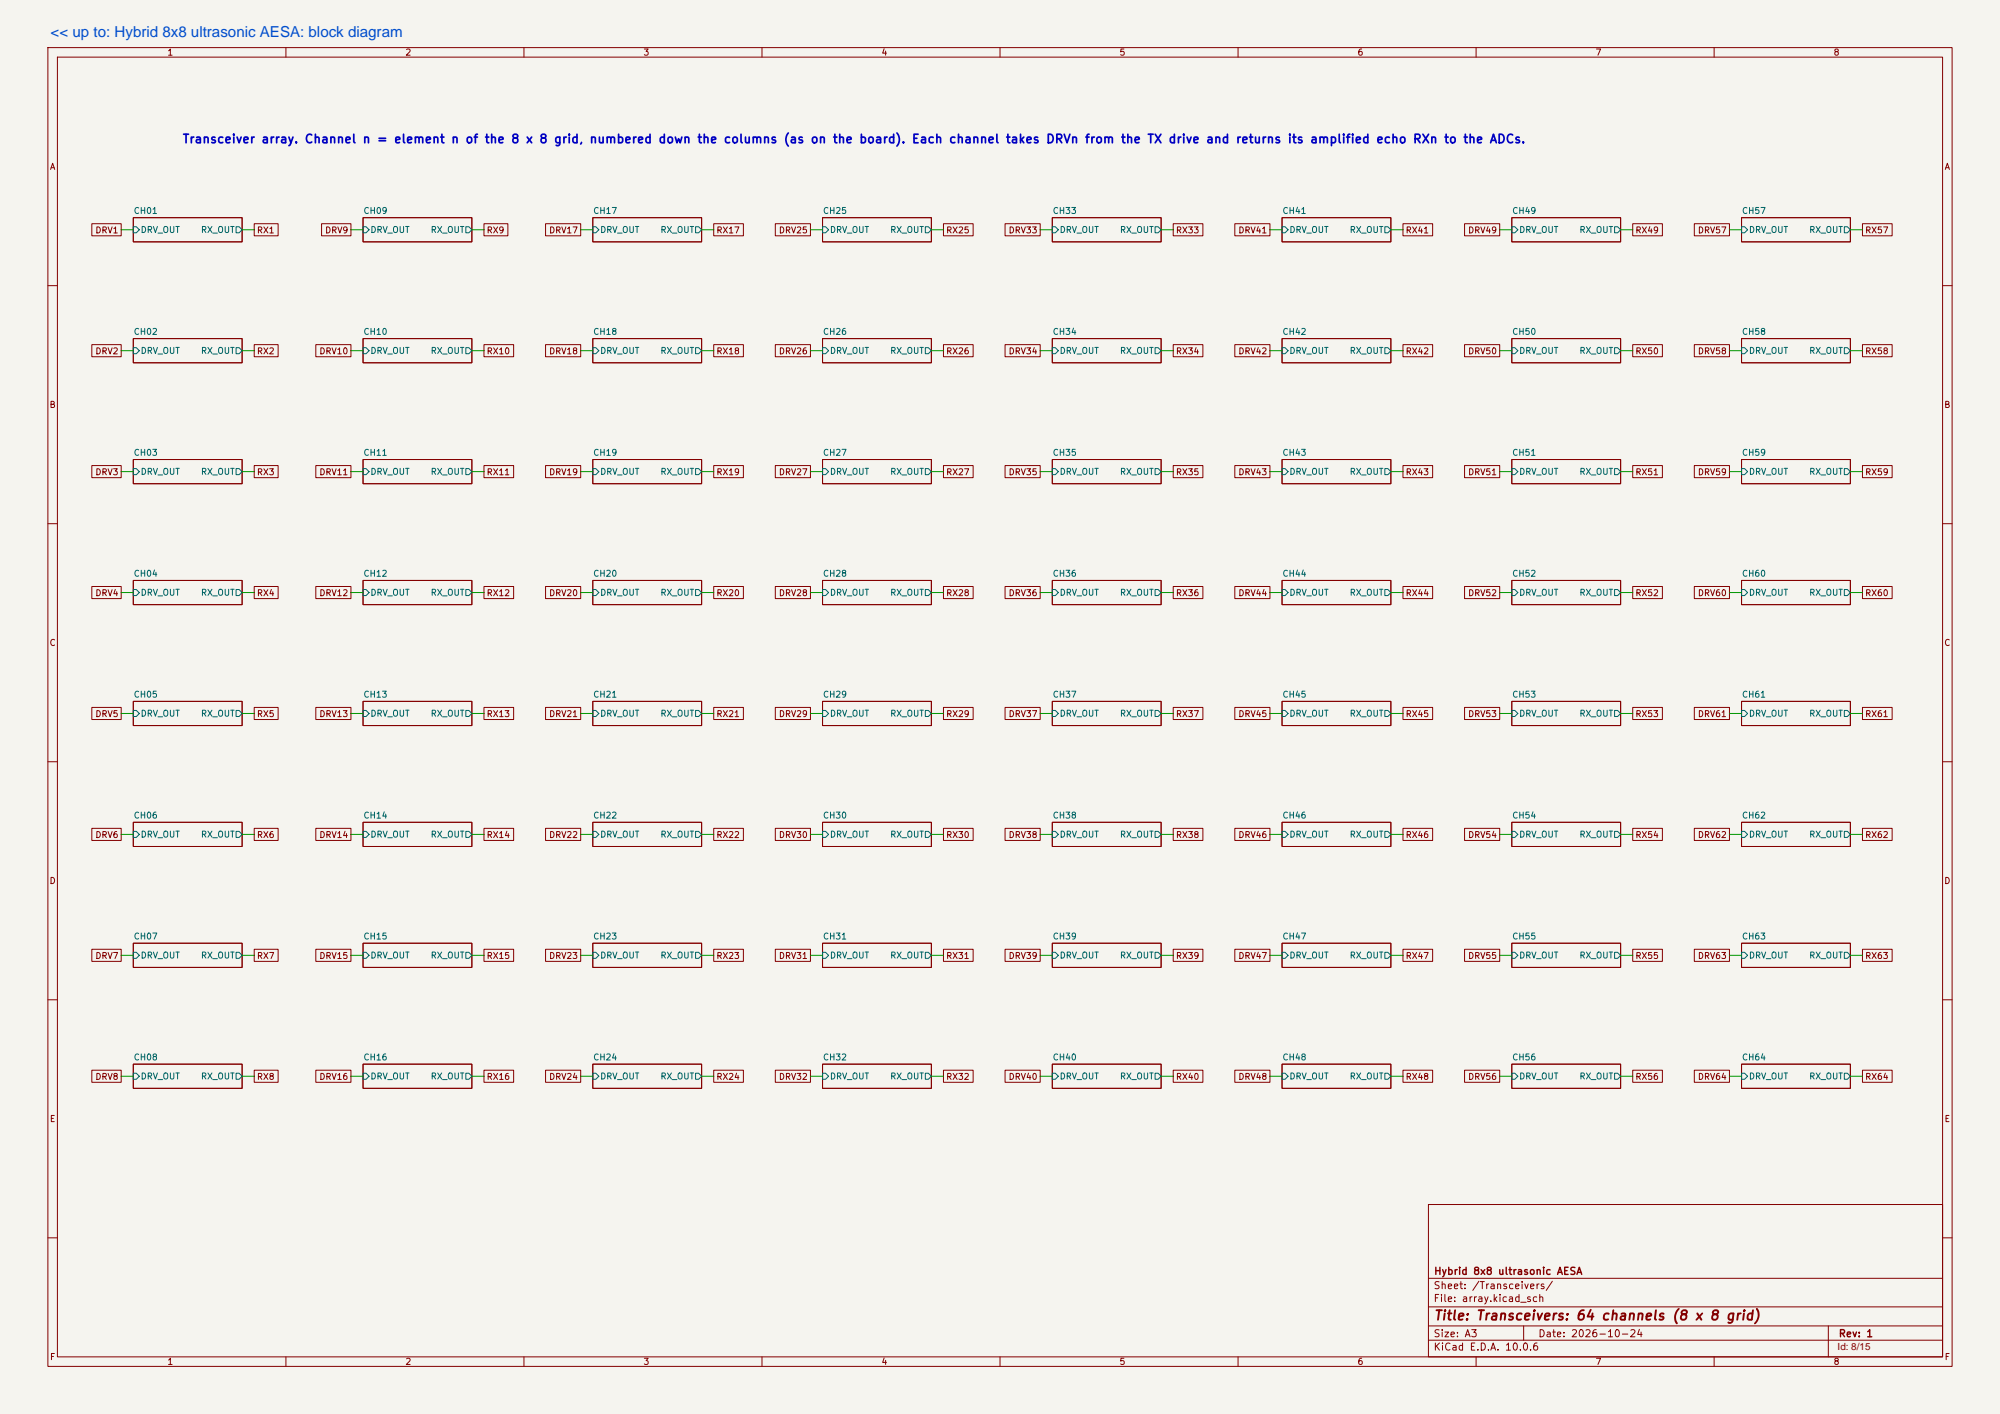
[picture p23: page 8]
DRV_OUT; RX_OUT CH03; RX_OUT CH09; RX_OUT CH44 DRV_OUT; RX_OUT CH10 DRV_OUT; RX_OUT CH06; RX_OUT CH38; RX_OUT CH43 DRV_OUT; RX_OUT CH11; RX_OUT CH31 DRV_OUT; RX_OUT CH07; RX_OUT CH30; RX_OUT CH36 DRV_OUT; RX_OUT CH37 DRV_OUT; RX_OUT CH35 DRV_OUT; RX_OUT CH08; RX_OUT CH33 DRV_OUT; RX_OUT CH17 DRV_OUT; RX_OUT CH14; RX_OUT CH34; RX_OUT CH56 DRV_OUT; RX_OUT CH15; RX_OUT CH63 DRV_OUT; RX_OUT CH29; RX_OUT CH62 DRV_OUT; RX_OUT CH55; RX_OUT CH61 DRV_OUT; RX_OUT CH26 DRV_OUT; RX_OUT CH20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

Hybrid 8x8 ultrasonic AESA
Sheet: /Transceivers/
File: array.kicad_sch
Title: Transceivers: 64 channels (8 x 8 grid)

1 | 2 | 3 | 4 | 5 | 6

AB

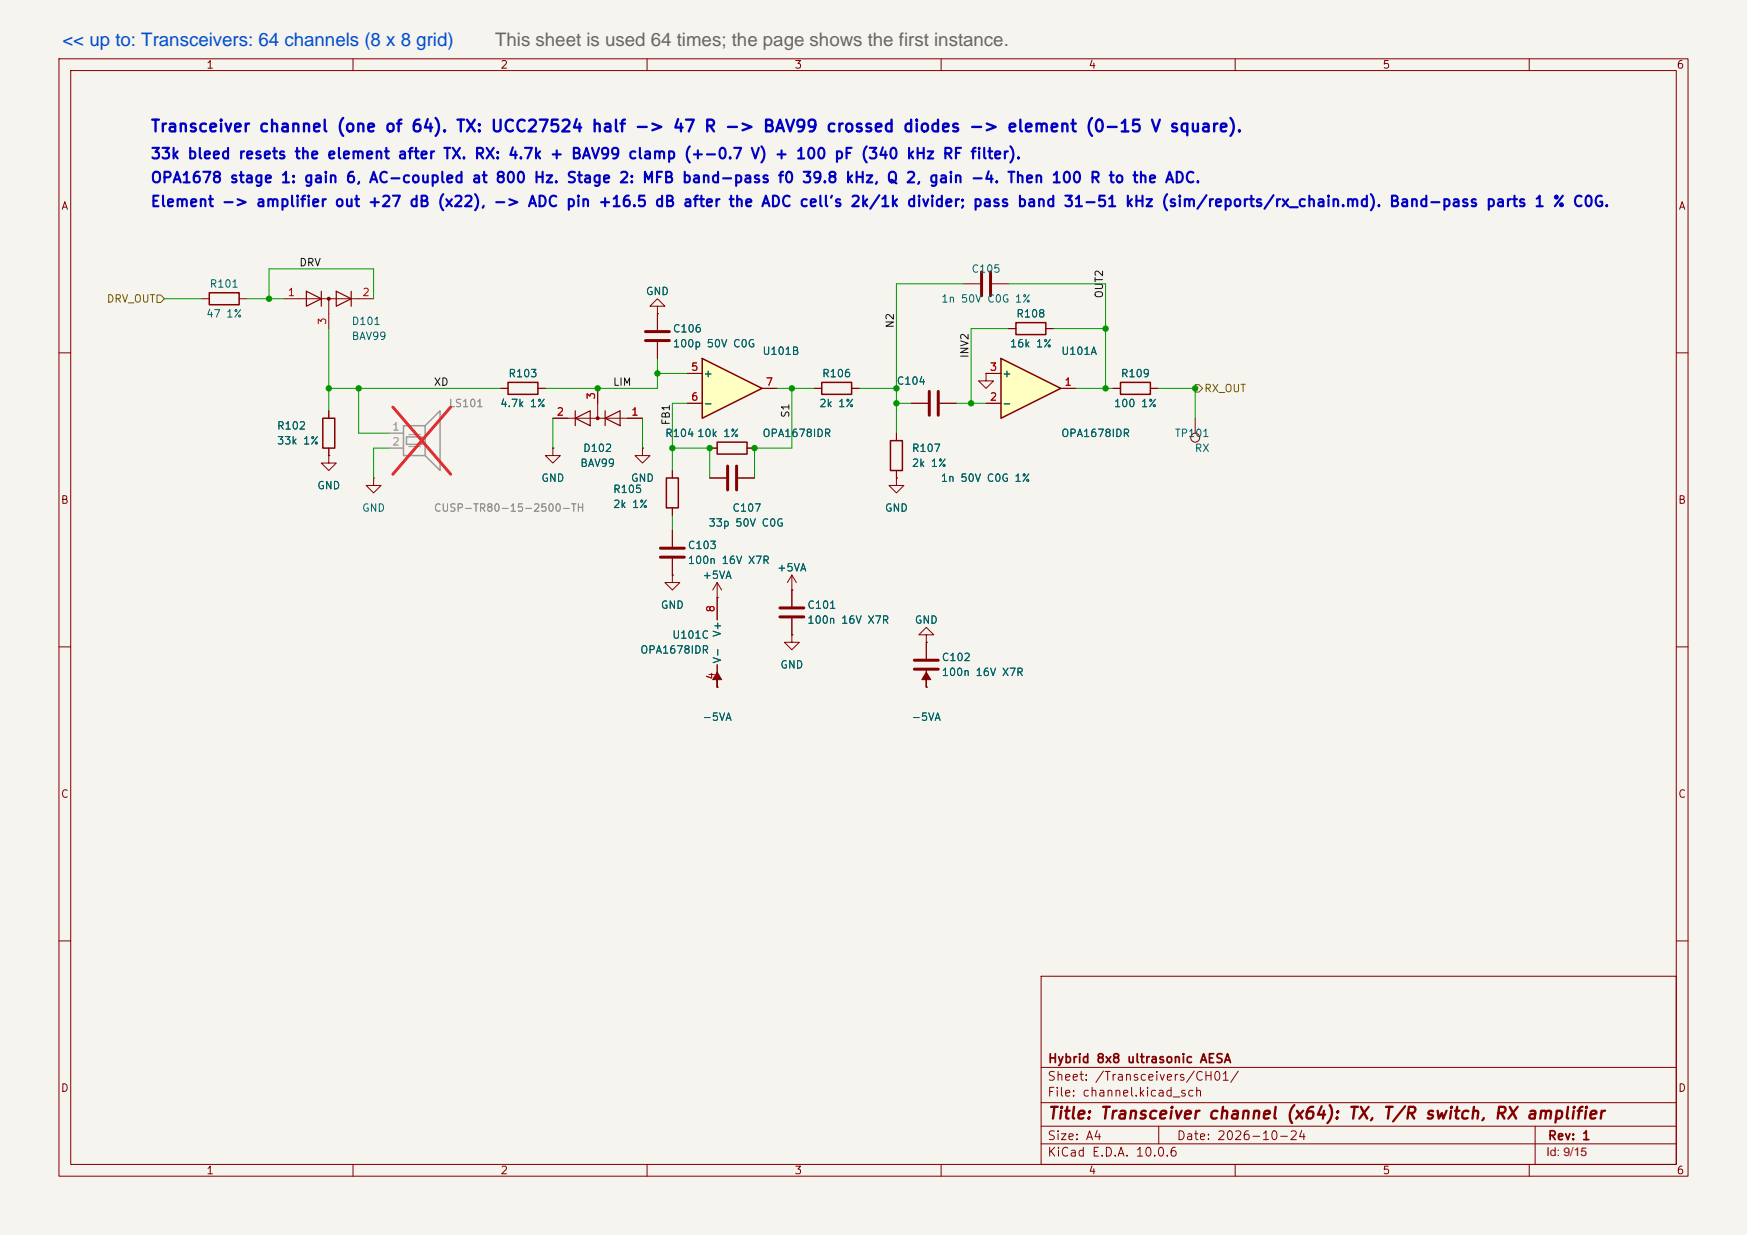
[picture p24: page 9]

Transceiver channel (one of 64). TX: UCC27524 half -> 47 R -> BAV99 crossed diodes -> element (0-15 V square). C104
33k bleed resets the element after TX. RX: 4.7k + BAV99 clamp (+-0.7 V) + 100 pF (340 kHz RF filter).
OPA1678 stage 1: gain 6, AC-coupled at 800 Hz. Stage 2: MFB band-pass f0 39.8 kHz, Q 2, gain -4. Then 100 R to the ADC.
Element -> amplifier out +27 dB (x22), -> ADC pin +16.5 dB after the ADC cell's 2k/1k divider; pass band 31-51 kHz (sim/reports/rx_chain.md). Band-pass parts 1 % C0G.

Hybrid 8x8 ultrasonic AESA
Sheet: /Transceivers/CH01/
File: channel.kicad_sch
Title: Transceiver channel (x64): TX, T/R switch, RX amplifier

# ADC_SDA1 +3V3 RX47

# RX6 RX21 RX22 RX23 RX24

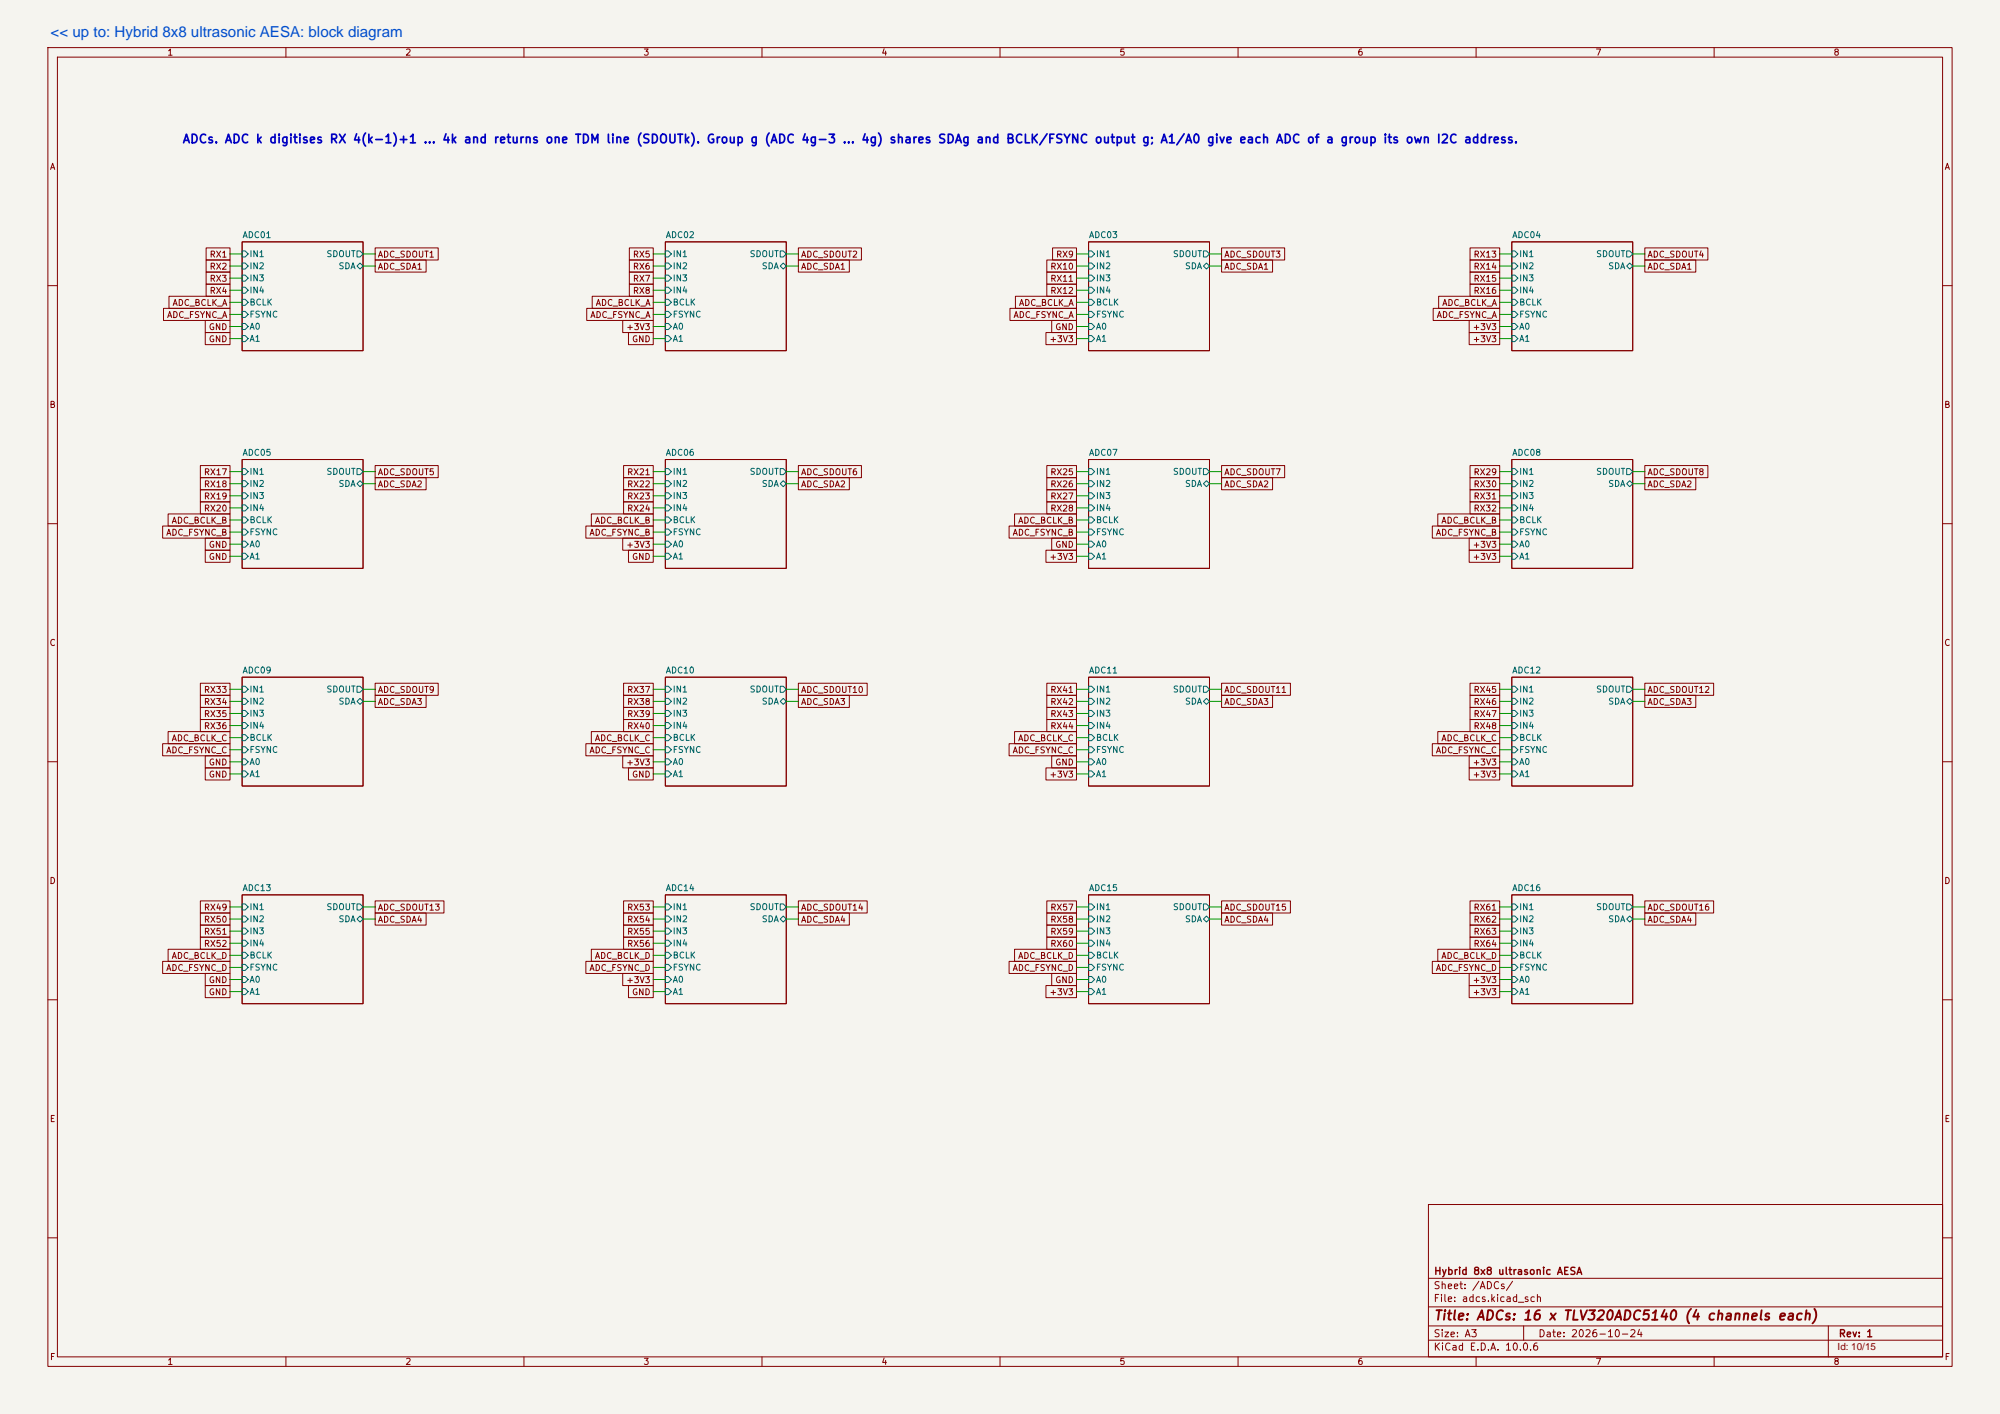
[picture p25: page 10]
IN1 IN2 IN3 IN4 BCLK; FSYNC A0 A1; SDOUT SDA; ADC07; ADC16; ADC06; ADC11; ADC04; ADC02; ADC08; ADC01; ADC03; ADC12; ADC05; ADC09; ADC13; ADC10; ADC14; ADC15; RX31 GND; ADC_SDA1; ADC_SDOUT1; ADC_SDOUT2; ADC_SDOUT6 RX2; ADC_SDA2; ADC_BCLK_A; ADC_FSYNC_A GND +3V3 RX11; ADC_BCLK_B; ADC_FSYNC_B +3V3 +3V3 RX3; ADC_SDOUT4 RX46 ADC_SDOUT8 RX9; ADC_SDA2 RX25 RX7; ADC_BCLK_C ADC_FSYNC_C; RX28 ADC_BCLK_B ADC_FSYNC_B; GND +3V3; ADC_SDOUT7; ADC_FSYNC_A; ADC_SDOUT3 RX41; ADC_SDOUT12 RX42 RX43; ADC_SDOUT5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

ADCs. ADC k digitises RX 4(k-1)+1 ... 4k and returns one TDM line (SDOUTk). Group g (ADC 4g-3 ... 4g) shares SDAg and BCLK/FSYNC output g; A1/A0 give each ADC of a group its own I2C address.

Hybrid 8x8 ultrasonic AESA
Sheet: /ADCs/
File: adcs.kicad_sch
Title: ADCs: 16 x TLV320ADC5140 (4 channels each)

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
# Title: ADC (x16): TLV320ADC5140, 4 channels, 192 kSPS TDM

File: adc.kicad_sch

### Sheet: /ADCs/ADC01/

### Hybrid 8x8 ultrasonic AESA

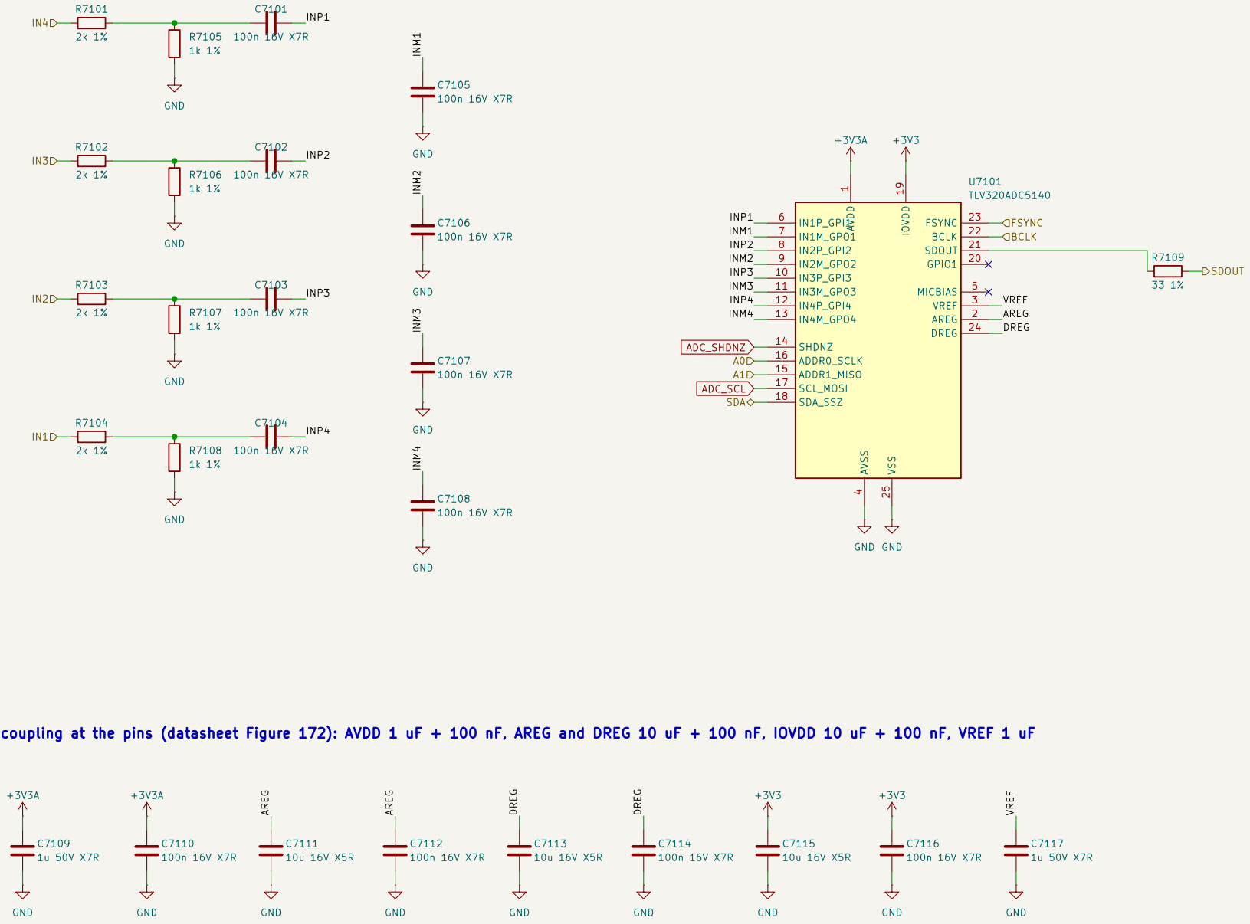
[picture p26: figure]
GND; AVDD; AREG; VREF; 3 AVSS; 4 MICBIAS 5; IN1P_GPI1 6 IN1M_GPO1 7 IN2P_GPI2 8 IN2M_GPO2 9 IN3P_GPI3 10 IN3M_GPO3 11 IN4P_GPI4 12 IN4M_GPO4 13; SHDNZ 14 ADDR1_MISO 15 ADDR0_SCLK 16; SCL_MOSI 17; TLV320ADC5140 R7102; GND GND; GND +3V3A; +3V3 GND; BCLK; SDOUT FSYNC; SDA; ADC_SCL ADC_SHDNZ; INM3; INP1; INP4; INM¹ AREG; INM4; INM2; INM1; INP3; INP3 INM²; INP2; INP1 INM⁴ INM³; VREF DREG AREG AREG; DREG

SDA_SSZ 18 | IOVDD 19 | GPIO1 20 SDOUT 21 BCLK 22 FSYNC 23 DREG 24 VSS 25 | U7101

Also: ADC_FSCALE 2.75 V (1 Vrms single-ended full scale), AREG_SELECT = 1, TX_EDGE = 1 (the FPGA latches SDOUT one BCLK after launch).

### Channel inputs: 2k + 1k divider, 100 nF AC coupling (single-ended, INxM AC-grounded)

Decoupling at the pins (datasheet Figure 172): AVDD 1 uF + 100 nF, AREG and DREG 10 uF + 100 nF, IOVDD 10 uF + 100 nF, VREF 1 uF

Power-up: SHDNZ (ADC_SHDNZ, pulled low on the header sheet) stays low until the rails settle, then wait 2 ms before I2C.

Ports IN1-IN4 are the block's four elements in order; IN1 feeds ADC channel 4 ... IN4 channel 1 (the order the receive lanes reach the inputs on the board). TDM: channel c carries element 4k-4 + (5 - c).

Input: 2k/1k divider (x0.31 with the 10 k input) keeps the receiver's +-4.2 V worst case inside the 1.41 V peak full scale; 100 nF couples to the ADC's own bias (150 Hz high-pass).

Per channel, set at boot: CHx_INSRC = single-ended (01), CHx_IMP = 10 k (01), AC-coupled, fixed 0 dB gain, DRE and AGC OFF (they change gain on the fly and break channel matching).

ADC: TLV320ADC5140 (TI, 4 channels, up to 768 kSPS). Run at 192 kSPS: flat to about 86 kHz.

TDM slave: BCLK 18.432 MHz, FSYNC 192 kHz from the FPGA (shared by all 16 ADCs, so all 64 channels sample at the same instant). 4 slots x 24 bits on SDOUT.

I2C: SCL shared, SDA per group of 4 ADCs; A1/A0 set the address 0x4C-0x4F inside the group. Config writes can use I2C broadcast (P0_R2 I2C_BRDCAST_EN).

<< up to: ADCs: 16 x TLV320ADC5140 (4 channels each) This sheet is used 16 times; the page shows the first instance.

3V3_MIC MEMS mics. Mics 2k-1 and 2k share MIC_DATAk-1 (SEL high on the odd one). One clock per mic pair: MIC_CLK_A mics 1-2, B 3-4, C 5-6, D 7-8.

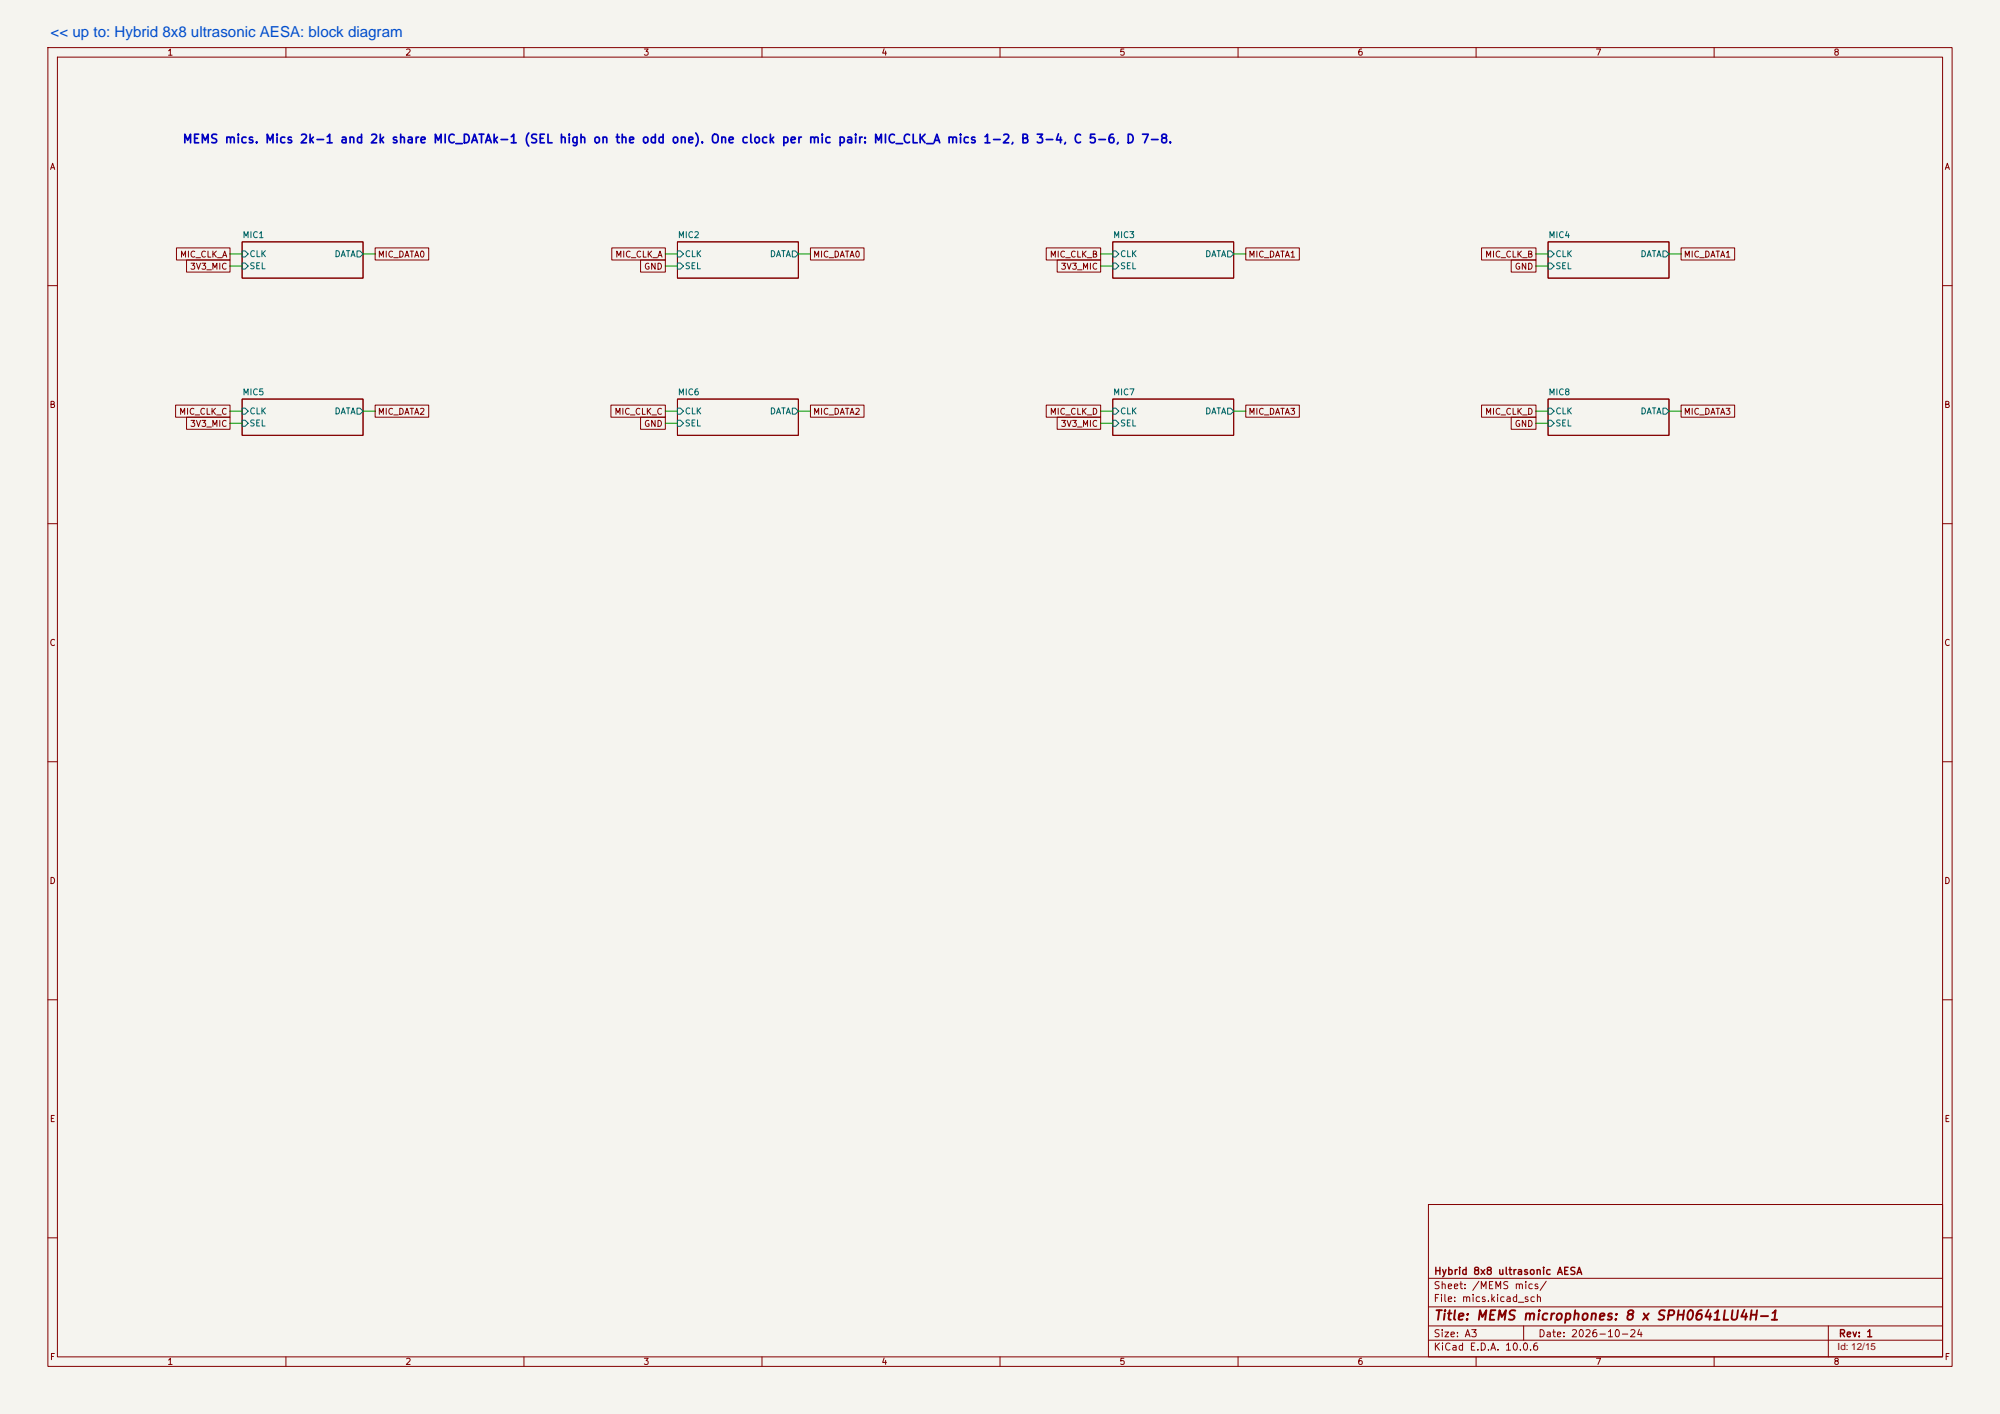
[picture p27: page 12]
CLK; SEL; DATA MIC4 CLK; DATA MIC1; DATA MIC2; DATA MIC8 CLK; DATA MIC6; DATA MIC7 CLK; DATA MIC3 CLK; DATA MIC5; GND; MIC_CLK_D; 3V3_MIC MIC_CLK_C; 3V3_MIC; MIC_DATA1 MIC_DATA2; MIC_DATA3 MIC_CLK_B; MIC_DATA1 MIC_CLK_C; MIC_DATA2; MIC_DATA3; MIC_CLK_B; GND MIC_CLK_D; GND MIC_CLK_A; MIC_DATA0; MIC_CLK_A

Hybrid 8x8 ultrasonic AESA
Sheet: /MEMS mics/
File: mics.kicad_sch
Title: MEMS microphones: 8 x SPH0641LU4H-1

1 | 2 | 3 | 4 | 5 | 6

AB

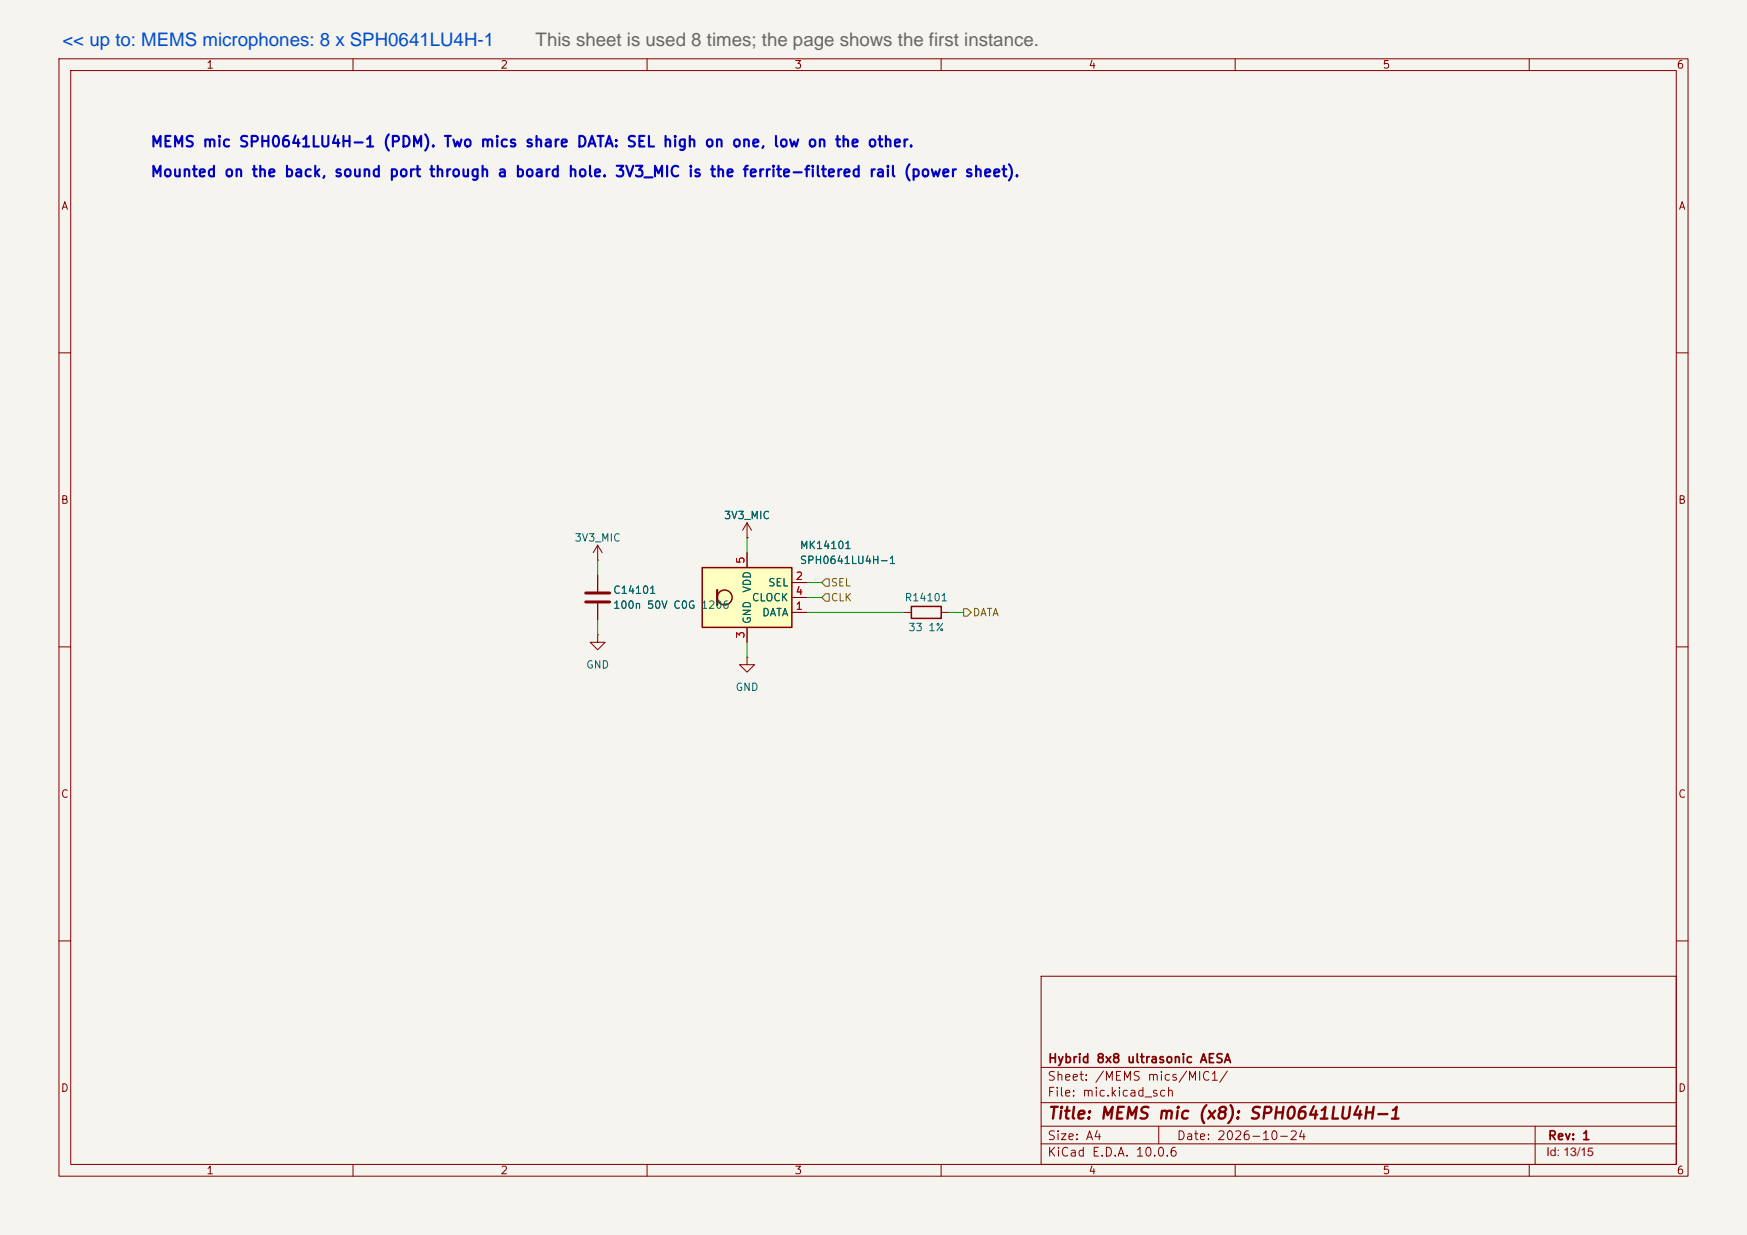
[picture p28: page 13]
D Date: 2026-10-24; Size: A4; Rev: 1; 3V3_MIC; C14101 100n 50V C0G 1206 GND; GND; DATA 1; SEL 2 GND; 3 CLOCK VDD 4; 5 MK14101 SPH0641LU4H-1 R14101; DATA CLK; SPH0641LU4H-1 DATA 1 SEL 2 GND; << up to: MEMS microphones: 8 x SPH0641LU4H-1; This sheet is used 8 times; the page shows the first instance.

MEMS mic SPH0641LU4H-1 (PDM). Two mics share DATA: SEL high on one, low on the other. 3V3_MIC

SEL Mounted on the back, sound port through a board hole. 3V3_MIC is the ferrite-filtered rail (power sheet).

Hybrid 8x8 ultrasonic AESA
Sheet: /MEMS mics/MIC1/
File: mic.kicad_sch
Title: MEMS mic (x8): SPH0641LU4H-1

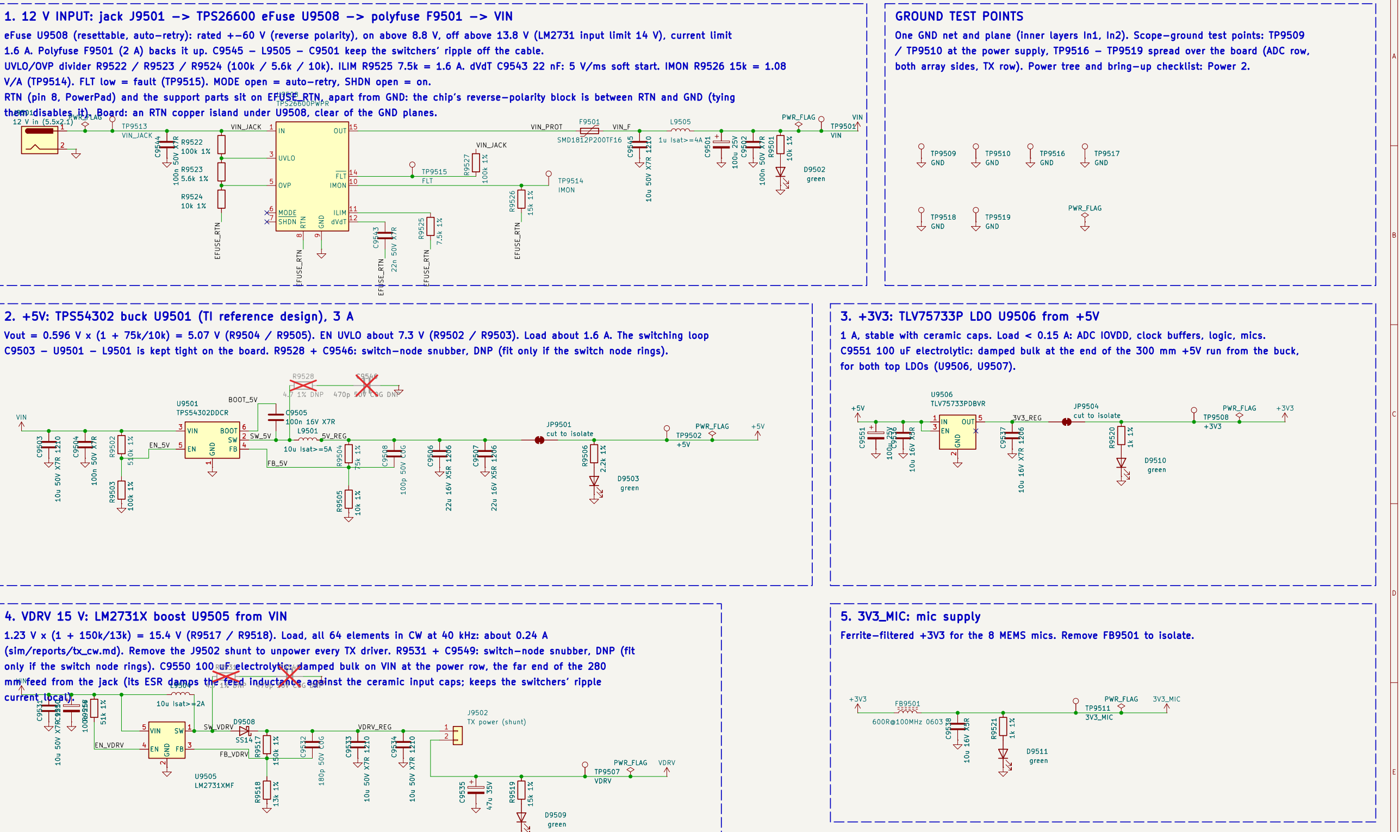
[picture p29: figure]
PWR_FLAG; 470p 50V C0G DNP R9502; 4.7 1% DNP; 10u Isat>=5A; GND; OUT 5 U9506; TLV75733PDBVR C9536; cut to isolate; green; 470p 50V C0G DNP; FLTR9525; TP9516 GND; PWR_FLAG GND; VIN 3; BOOT 6 U9501; TPS54302DDCR; TX power (shunt) C9531; VIN; TP9509 GND; TP9518 GND; TP9519 GND; TP9510 GND; TP9517 GND; SW 1 GND; VIN 5; LM2731XMF; VDRV PWR_FLAG; VDRV C9534; green C9535; TP9514 IMON; IN 1 UVLO 3 OVP 5 MODE 6; SHDN 7; RTN; 8 GND; IMON 10; ILIM 11 dVdT 12; FLT 14 OUT 15 U9508; TPS26600PWPR C9544; TP9513 VIN_JACK; VIN R9527; TP9501 VIN; SMD1812P200TF16; 600R@100MHz 0603; TP9511 3V3_MIC; green C9538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

AB

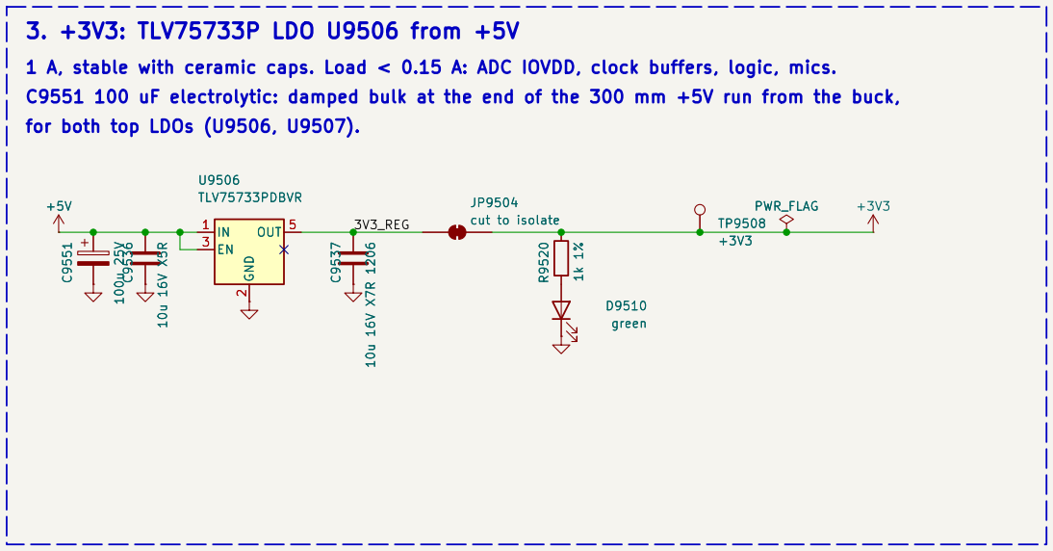
[picture p30: figure]

C

D

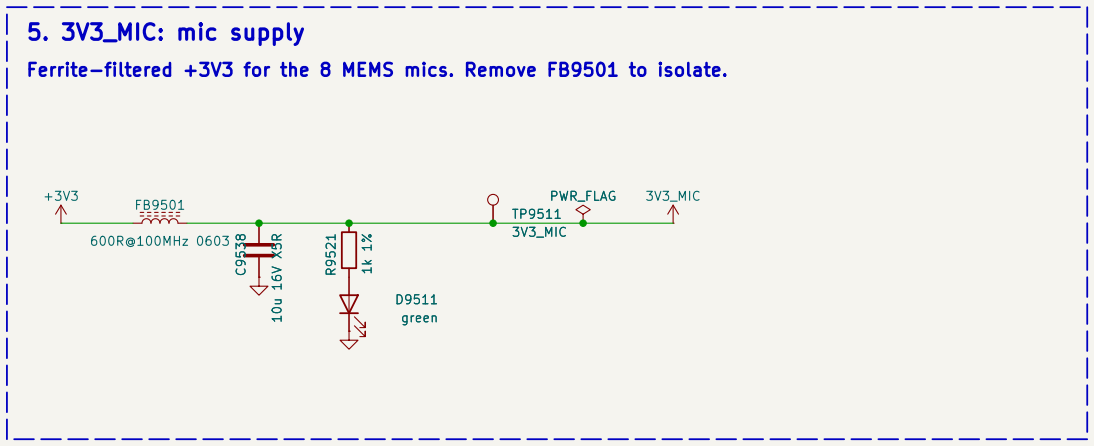
[picture p31: figure]

E

# Title: Power 1: 12 V input, +5V, VDRV (TX), +3V3, 3V3_MIC

File: power.kicad_sch

### Sheet: /Power 1/

### Hybrid 8x8 ultrasonic AESA

C9551 100 uF electrolytic: damped bulk at the end of the 300 mm +5V run from the buck,

1 A, stable with ceramic caps. Load < 0.15 A: ADC IOVDD, clock buffers, logic, mics.

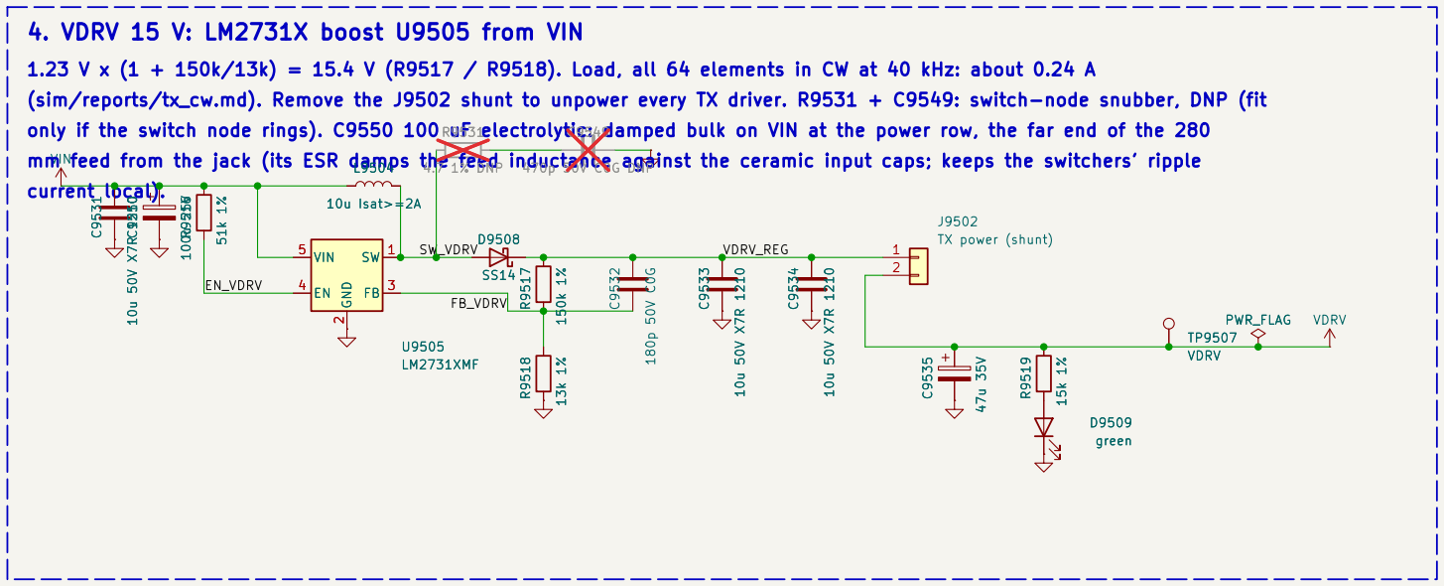
[picture p32: figure]

only if the switch node rings). C9550 100 uF electrolytic: damped bulk on VIN at the power row, the far end of the 280

/ TP9510 at the power supply, TP9516 - TP9519 spread over the board (ADC row, mm feed from the jack (its ESR damps the feed inductance against the ceramic input caps; keeps the switchers' ripple

V/A (TP9514). FLT low = fault (TP9515). MODE open = auto-retry, SHDN open = on. them disables it). Board: an RTN copper island under U9508, clear of the GND planes.

1.6 A. Polyfuse F9501 (2 A) backs it up. C9545 - L9505 - C9501 keep the switchers' ripple off the cable.

# 2. +5V: TPS54302 buck U9501 (TI reference design), 3 A

eFuse U9508 (resettable, auto-retry): rated +-60 V (reverse polarity), on above 8.8 V, off above 13.8 V (LM2731 input limit 14 V), current limit

RTN (pin 8, PowerPad) and the support parts sit on EFUSE_RTN, apart from GND: the chip's reverse-polarity block is between RTN and GND (tying

UVLO/OVP divider R9522 / R9523 / R9524 (100k / 5.6k / 10k). ILIM R9525 7.5k = 1.6 A. dVdT C9543 22 nF: 5 V/ms soft start. IMON R9526 15k = 1.08

4. VDRV 15 V: LM2731X boost U9505 from VIN | 5. 3V3_MIC: mic supply

1.23 V x (1 + 150k/13k) = 15.4 V (R9517 / R9518). Load, all 64 elements in CW at 40 kHz: about 0.24 A

# 1. 12 V INPUT: jack J9501 -> TPS26600 eFuse U9508 -> polyfuse F9501 -> VIN

Ferrite-filtered +3V3 for the 8 MEMS mics. Remove FB9501 to isolate.

### One GND net and plane (inner layers In1, In2). Scope-ground test points: TP9509

C9503 - U9501 - L9501 is kept tight on the board. R9528 + C9546: switch-node snubber, DNP (fit only if the switch node rings).

both array sides, TX row). Power tree and bring-up checklist: Power 2.

Vout = 0.596 V x (1 + 75k/10k) = 5.07 V (R9504 / R9505). EN UVLO about 7.3 V (R9502 / R9503). Load about 1.6 A. The switching loop

(sim/reports/tx_cw.md). Remove the J9502 shunt to unpower every TX driver. R9531 + C9549: switch-node snubber, DNP (fit | C9537 | 10u 16V X7R 1206 U9506

AB

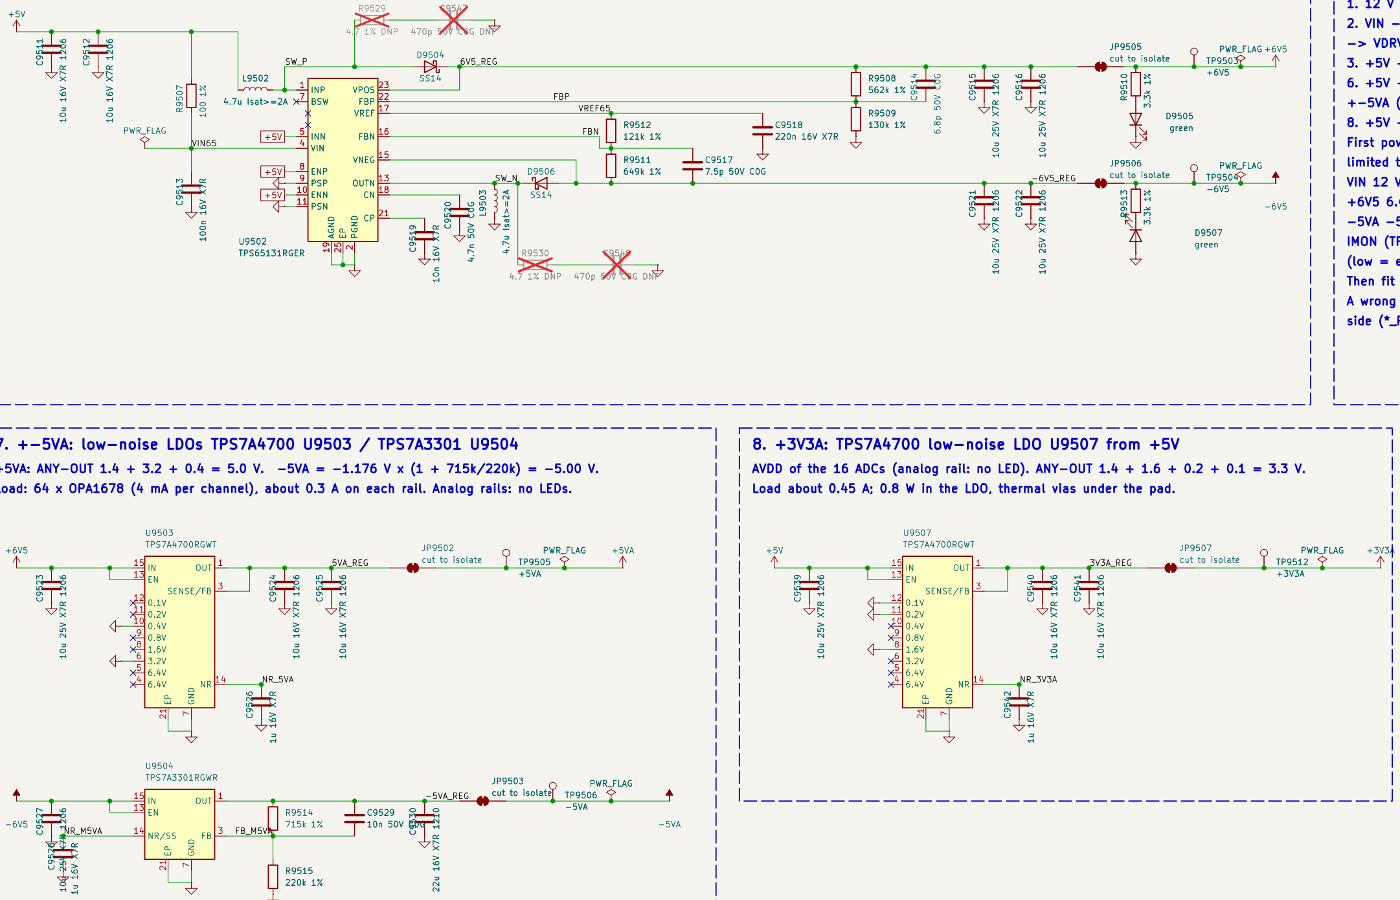
[picture p33: figure]
JP9506 cut to isolate; 4.7u Isat>=2A; green C9541; cut to isolate; 4.7 1% DNP; 470p 50V C0G DNP; +3V3A OUT 1; SENSE/FB 3; GND; TPS7A4700RGWT +6V5; PWR_FLAG -6V5; cut to isolate C9519; INP 1; PGND; VIN 4; INN 5 BSW 7; ENP 8 PSP 9; ENN 10 PSN 11; OUTN 13; VNEG 15; FBN 16; VREF 17 CN 18 AGND 19; FBP 22 VPOS 23 EP 25U9502; TPS65131RGER C9513; PWR_FLAG; OUT 1; TPS7A4700RGWT R9511 649k 1%; Isat>=²A 4.7n 50V C0G; cut to isolate C9530; +5VA PWR_FLAG OUT 1; FB 3 GND; TPS7A3301RGWR; 10u 16V X7R 1206 PWR_FLAG; PWR_FLAG -6V5 PWR_FLAG C9515; green +5V +5V +5V; FBN; VREF65; 3V3A_REG -5VA_REG; -6V5_REG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

C

D

E

AB

C

D

E

# Title: Power 2 (analog): +-6V5, +-5VA, +3V3A

File: power_analog.kicad_sch

Sheet: /Power 2 (analog)/

### Hybrid 8x8 ultrasonic AESA

## 2. VIN -> buck U9501 -> +5V. 4. VIN -> boost U9505

1. 12 V jack J9501 -> eFuse U9508 -> F9501 -> VIN.
8. +5V -> LDO U9507 -> +3V3A (ADC AVDD).

Power 1: sections 1-5 (input, +5V, +3V3, VDRV,

## IMON (TP9514) 1.08 V per A in. FLT (TP9515) high

VIN 12 V, +5V 5.07 V, +3V3 3.30 V, 3V3_MIC 3.3 V,

### First power-up: J9502 shunt off, bench supply 12 V

DNP (fit only if a switch node rings).
+6V5 = 1.213 V x (1 + 562k/130k) = 6.46 V (R9508 / R9509). -6V5 = -1.213 V x 649k/121k = -6.51 V (R9511 / R9512).

Load about 0.45 A; 0.8 W in the LDO, thermal vias under the pad.

Then fit the J9502 shunt: VDRV 15.4 V.

# 8. +3V3A: TPS7A4700 low-noise LDO U9507 from +5V

sections 6-8 (+-6V5, +-5VA, +3V3A). -> VDRV.

# 7. +-5VA: low-noise LDOs TPS7A4700 U9503 / TPS7A3301 U9504

Drawn with the pin-identical TPS65130 symbol: order TPS65131RGER (2 A switches). PSP/PSN low: fixed-frequency PWM. R9529 + C9547 and R9530 + C9548: switch-node snubbers,

Load: 64 x OPA1678 (4 mA per channel), about 0.3 A on each rail. Analog rails: no LEDs.

+-5VA (receivers).

## limited to 0.3 A. Expect at the test points:

side (*_REG) and the load side apart.

-5VA -5.00 V, +3V3A 3.30 V.

(low = eFuse fault).

### 3V3_MIC) and the ground test points. Power 2:

## 6. +5V -> U9502 -> +-6V5 -> 7. LDOs U9503 / U9504 ->

+5VA: ANY-OUT 1.4 + 3.2 + 0.4 = 5.0 V. -5VA = -1.176 V x (1 + 715k/220k) = -5.00 V.

# POWER TREE, BRING-UP

### A wrong rail: cut its jumper, measure the regulator

AVDD of the 16 ADCs (analog rail: no LED). ANY-OUT 1.4 + 1.6 + 0.2 + 0.1 = 3.3 V.

# 6. +-6V5: TPS65131RGER U9502, boost + inverter from +5V (feeds the analog LDOs only)

3. +5V -> LDO U9506 -> +3V3 -> 5. FB9501 -> 3V3_MIC.
+6V5 6.46 V, -6V5 -6.51 V, +5VA 5.00 V, PWR_FLAG C9511 | 10u 16V X7R 1206 | C9512 | 10u 16V X7R 1206
