tieziyun/ultrasonic-aesa/docs/schematics/01_headers.pdf

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

Pin 2 (+5V) and 39/40 (+3.3V) of the FPGA board are left open. Clocks sit between GND conductors (pins 31-37). J9901

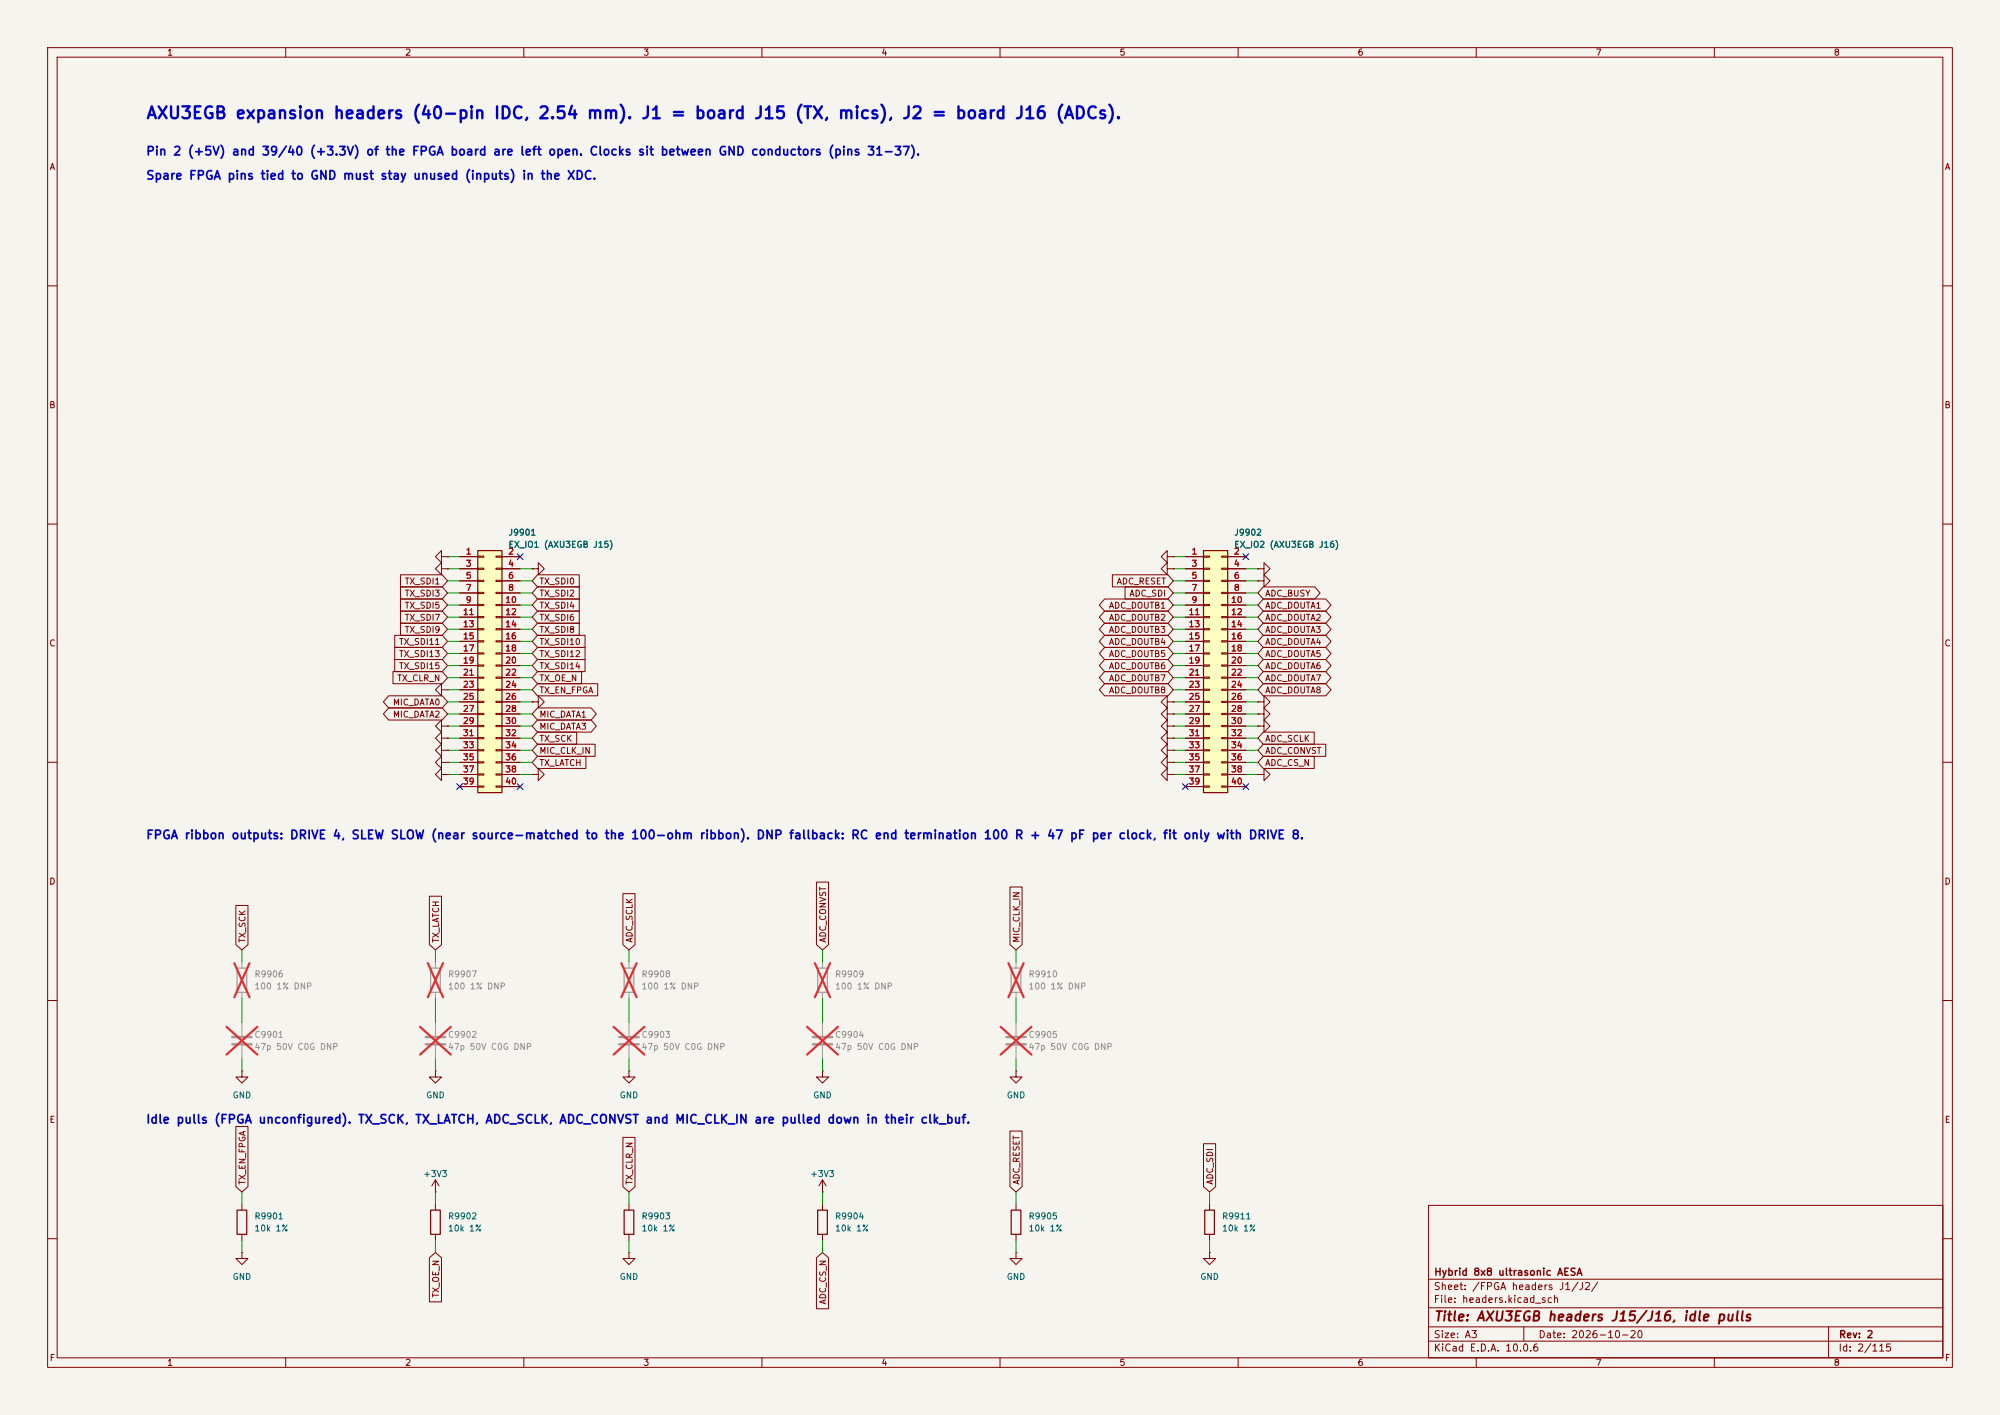
[picture p34: page 1]

TX_SDI2 Spare FPGA pins tied to GND must stay unused (inputs) in the XDC.

FPGA ribbon outputs: DRIVE 4, SLEW SLOW (near source-matched to the 100-ohm ribbon). DNP fallback: RC end termination 100 R + 47 pF per clock, fit only with DRIVE 8.

Idle pulls (FPGA unconfigured). TX_SCK, TX_LATCH, ADC_SCLK, ADC_CONVST and MIC_CLK_IN are pulled down in their clk_buf.

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
