tieziyun/ultrasonic-aesa/docs/schematics/02_clocks.pdf

# TX_LATCH_B MIC_CLK_A

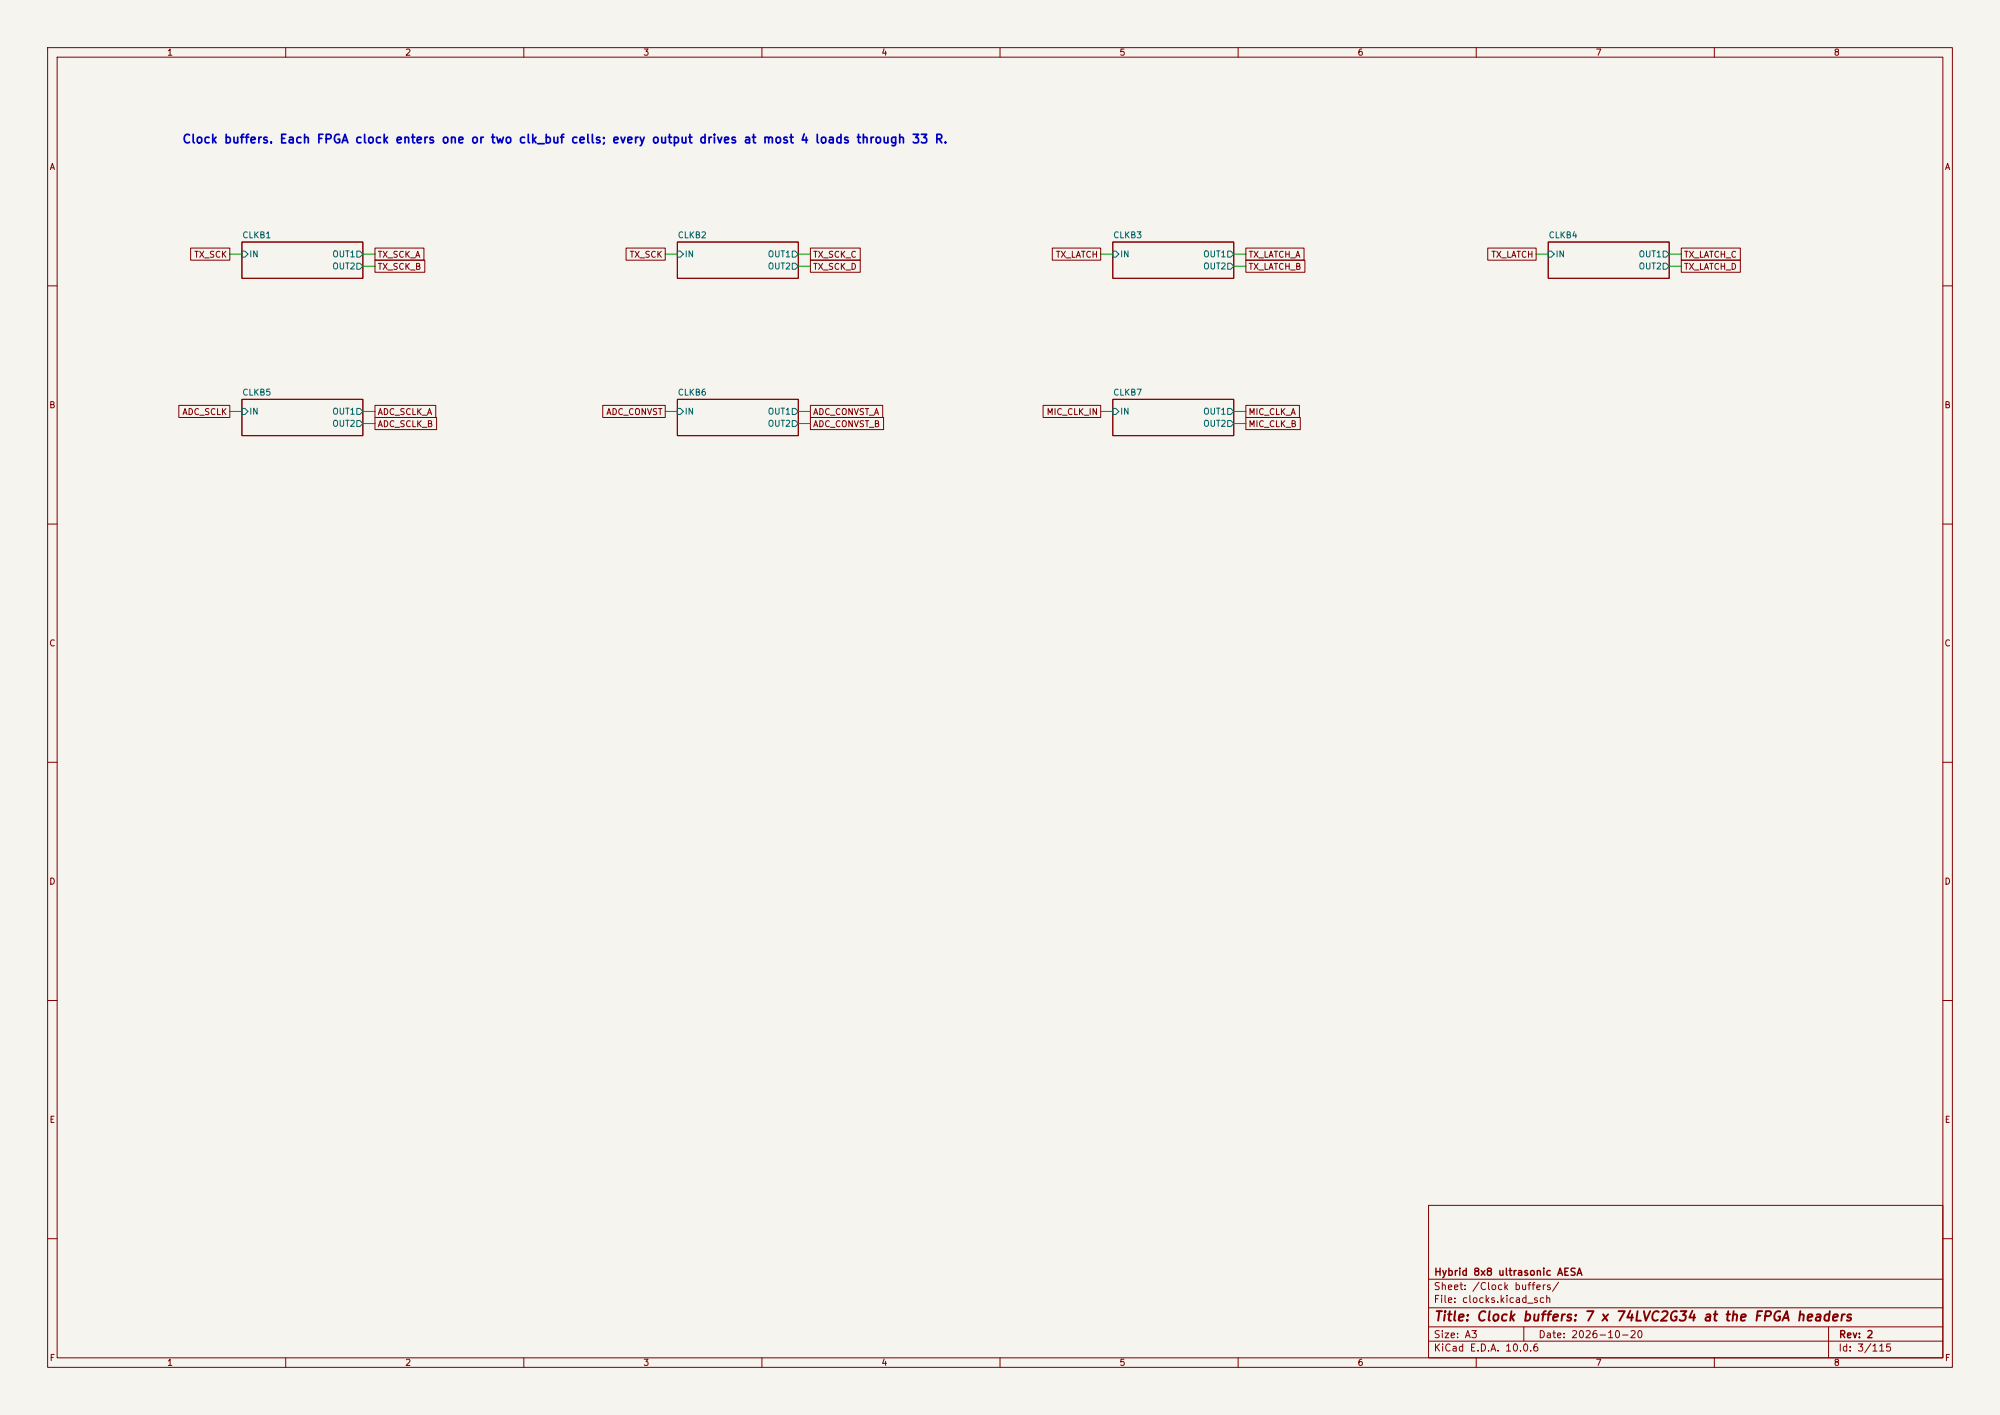
[picture p35: page 1]
F Date: 2026-10-20 KiCad E.D.A. 10.0.6; Size: A3; Rev: 2; OUT1 OUT2 CLKB1; OUT1 OUT2 CLKB5; OUT1 OUT2 CLKB2; OUT1 OUT2 CLKB3; OUT1 OUT2 CLKB6; OUT1 OUT2 CLKB7; OUT1 OUT2 CLKB4; TX_SCK_D; TX_SCK; ADC_CONVST_B; ADC_SCLK; MIC_CLK_B; TX_SCK_A TX_SCK_B; ADC_SCLK_B; ADC_SCLK_A; ADC_CONVST; ADC_CONVST_A; TX_SCK_C; TX_LATCH; TX_LATCH_A; TX_LATCH_C MIC_CLK_IN

TX_LATCH_D Clock buffers. Each FPGA clock enters one or two clk_buf cells; every output drives at most 4 loads through 33 R.

Hybrid 8x8 ultrasonic AESA
Sheet: /Clock buffers/
File: clocks.kicad_sch
Title: Clock buffers: 7 x 74LVC2G34 at the FPGA headers
