tieziyun/ultrasonic-aesa/docs/schematics/03_clk_buf.pdf

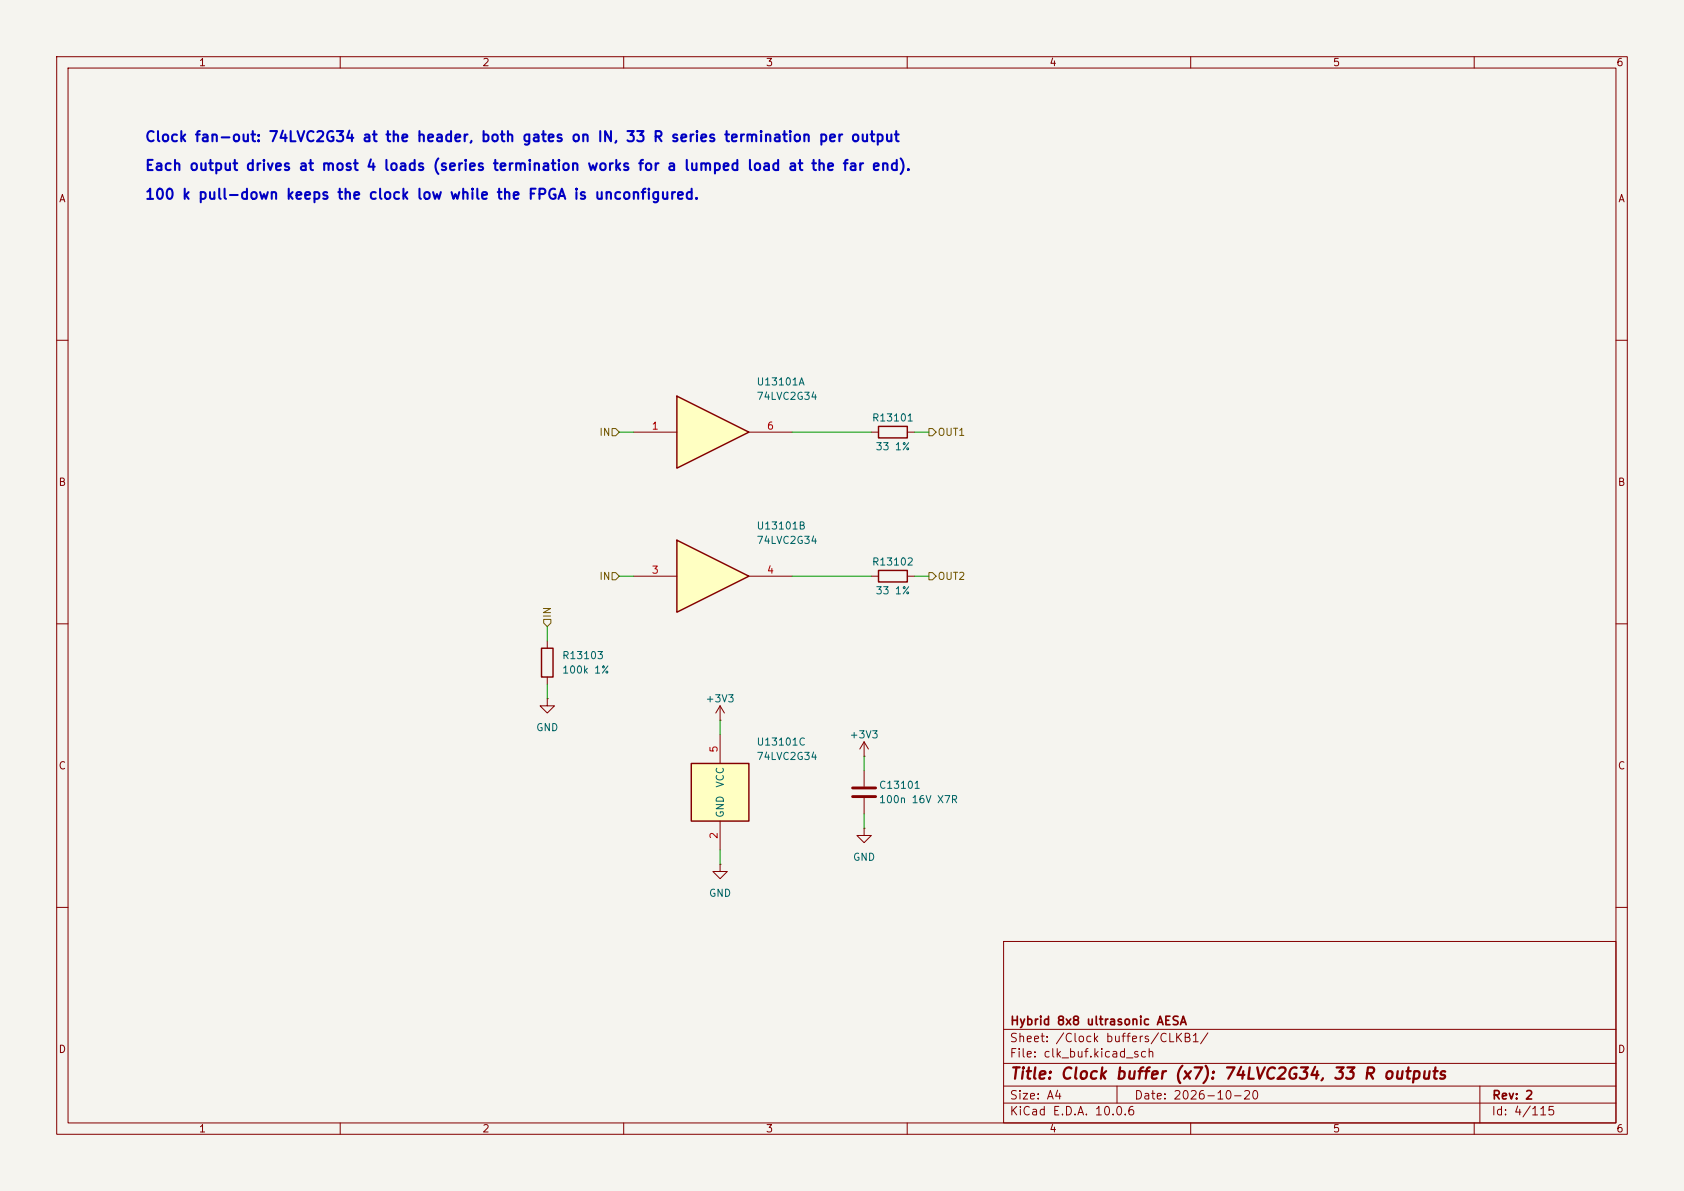
[picture p36: page 1]
D Date: 2026-10-20; KiCad E.D.A. 10.0.6; Size: A4; Rev: 2; 74LVC2G34; 6 U13101A 74LVC2G34; 100n 16V X7R ⁺3V3 GND; 2 VCC; GND

Clock fan-out: 74LVC2G34 at the header, both gates on IN, 33 R series termination per output

OUT1 OUT2 Each output drives at most 4 loads (series termination works for a lumped load at the far end).

100 k pull-down keeps the clock low while the FPGA is unconfigured.

Hybrid 8x8 ultrasonic AESA
Sheet: /Clock buffers/CLKB1/
File: clk_buf.kicad_sch
Title: Clock buffer (x7): 74LVC2G34, 33 R outputs
