tieziyun/ultrasonic-aesa/docs/schematics/05_tx_group.pdf

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

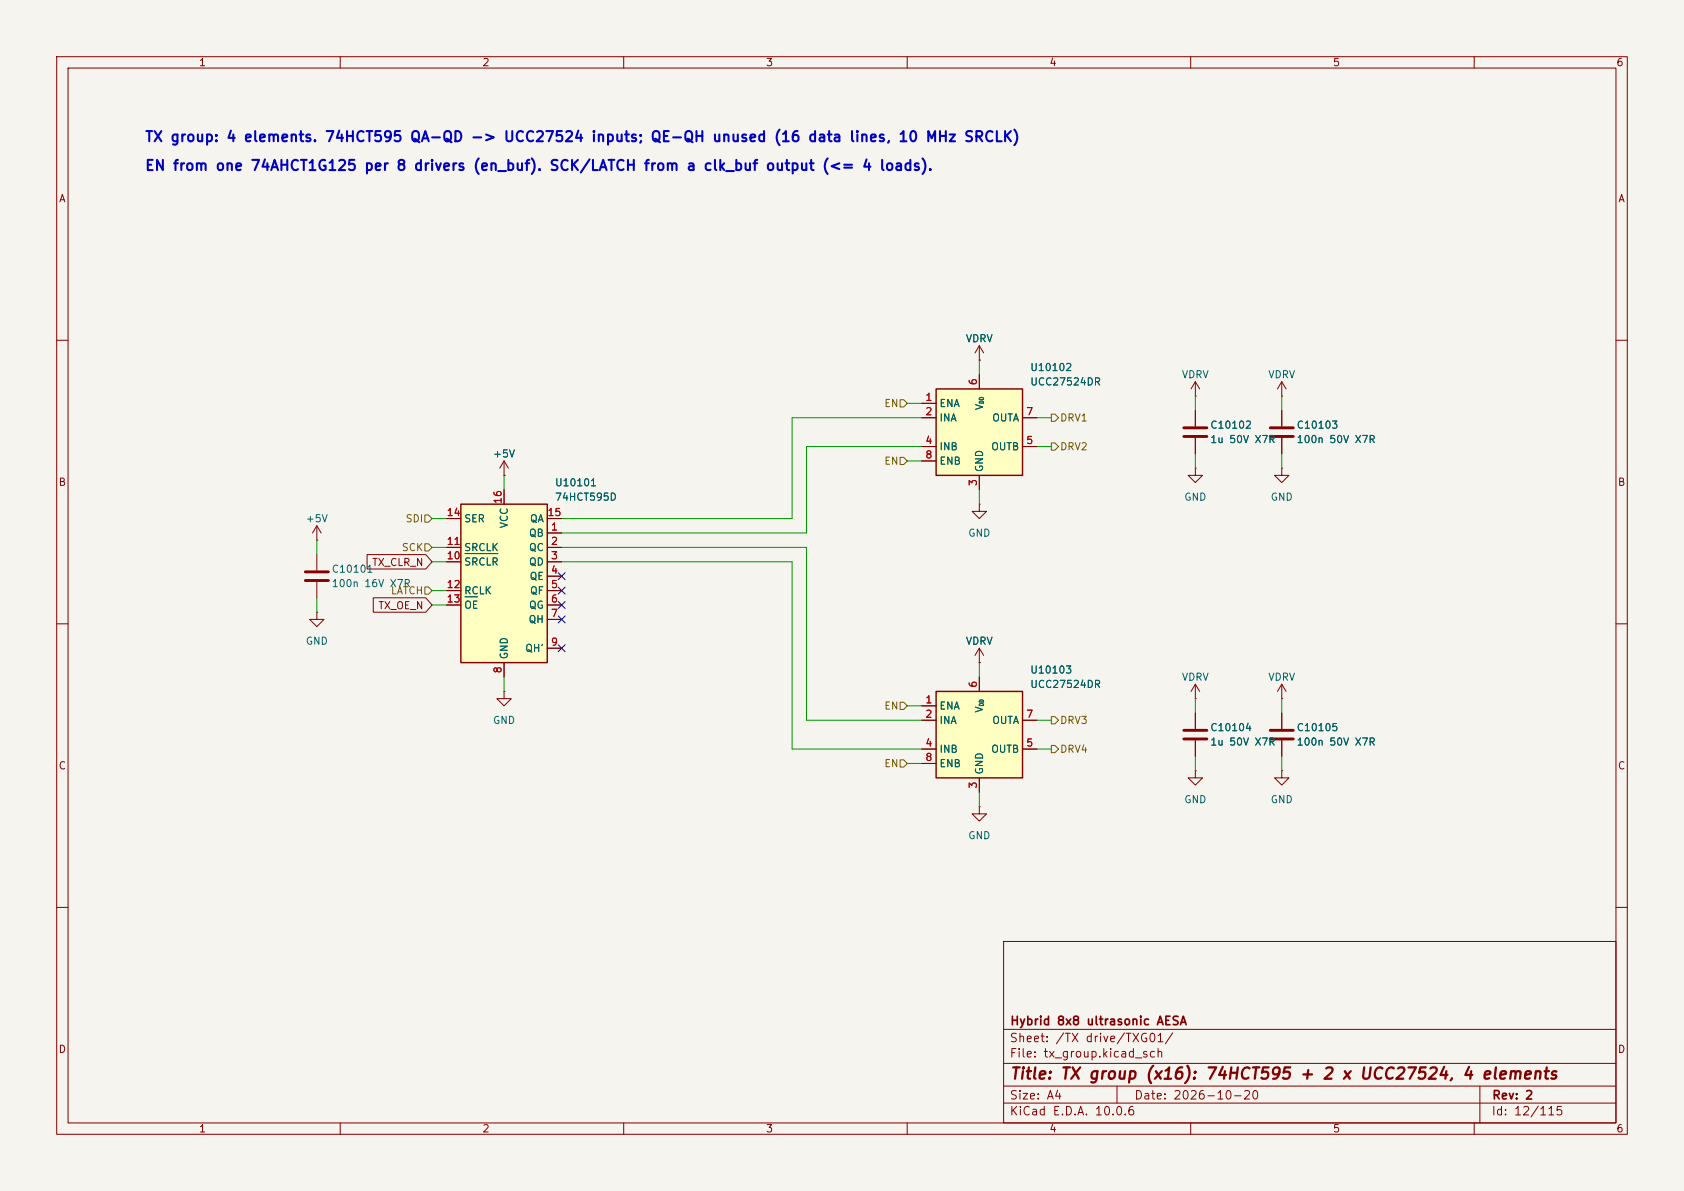
[picture p37: page 1]
D Date: 2026-10-20; KiCad E.D.A. 10.0.6; Size: A4; Rev: 2; ENA 1; INA 2; GND; INB 4; OUTB 5; VDD 6 OUTA 7; ENB 8; U10102 UCC27524DR; QB 1 QC 2 QD 3 QE 4 QF 5 QG 6 QH 7 GND; SER 14; QA 15 VCC 16; 74HCT595D; VDRV +5V C10101; VDRV GND ⁺5V; VDRV GND; U10103 UCC27524DR; VDRV C10102; VDRV DRV1 DRV2; LATCH; SCK; DRV3; SDI; DRV4; VDRV U10101; QA 15 VCC 16 +5V; VDRV

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

74HCT595D QB 1 QC 2 QD 3 QE 4 QF 5 QG 6 QH 7 GND

SRCLR 10 SRCLK 11 RCLK 12 OE 13

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
