tieziyun/ultrasonic-aesa/docs/schematics/07_array.pdf

DRV_OUT | RX_OUT CH12 DRV_OUT | RX_OUT CH20 DRV_OUT | RX_OUT CH28 DRV_OUT | RX_OUT CH36 DRV_OUT | RX_OUT CH44 DRV_OUT | RX_OUT CH52

# RX5 RX13

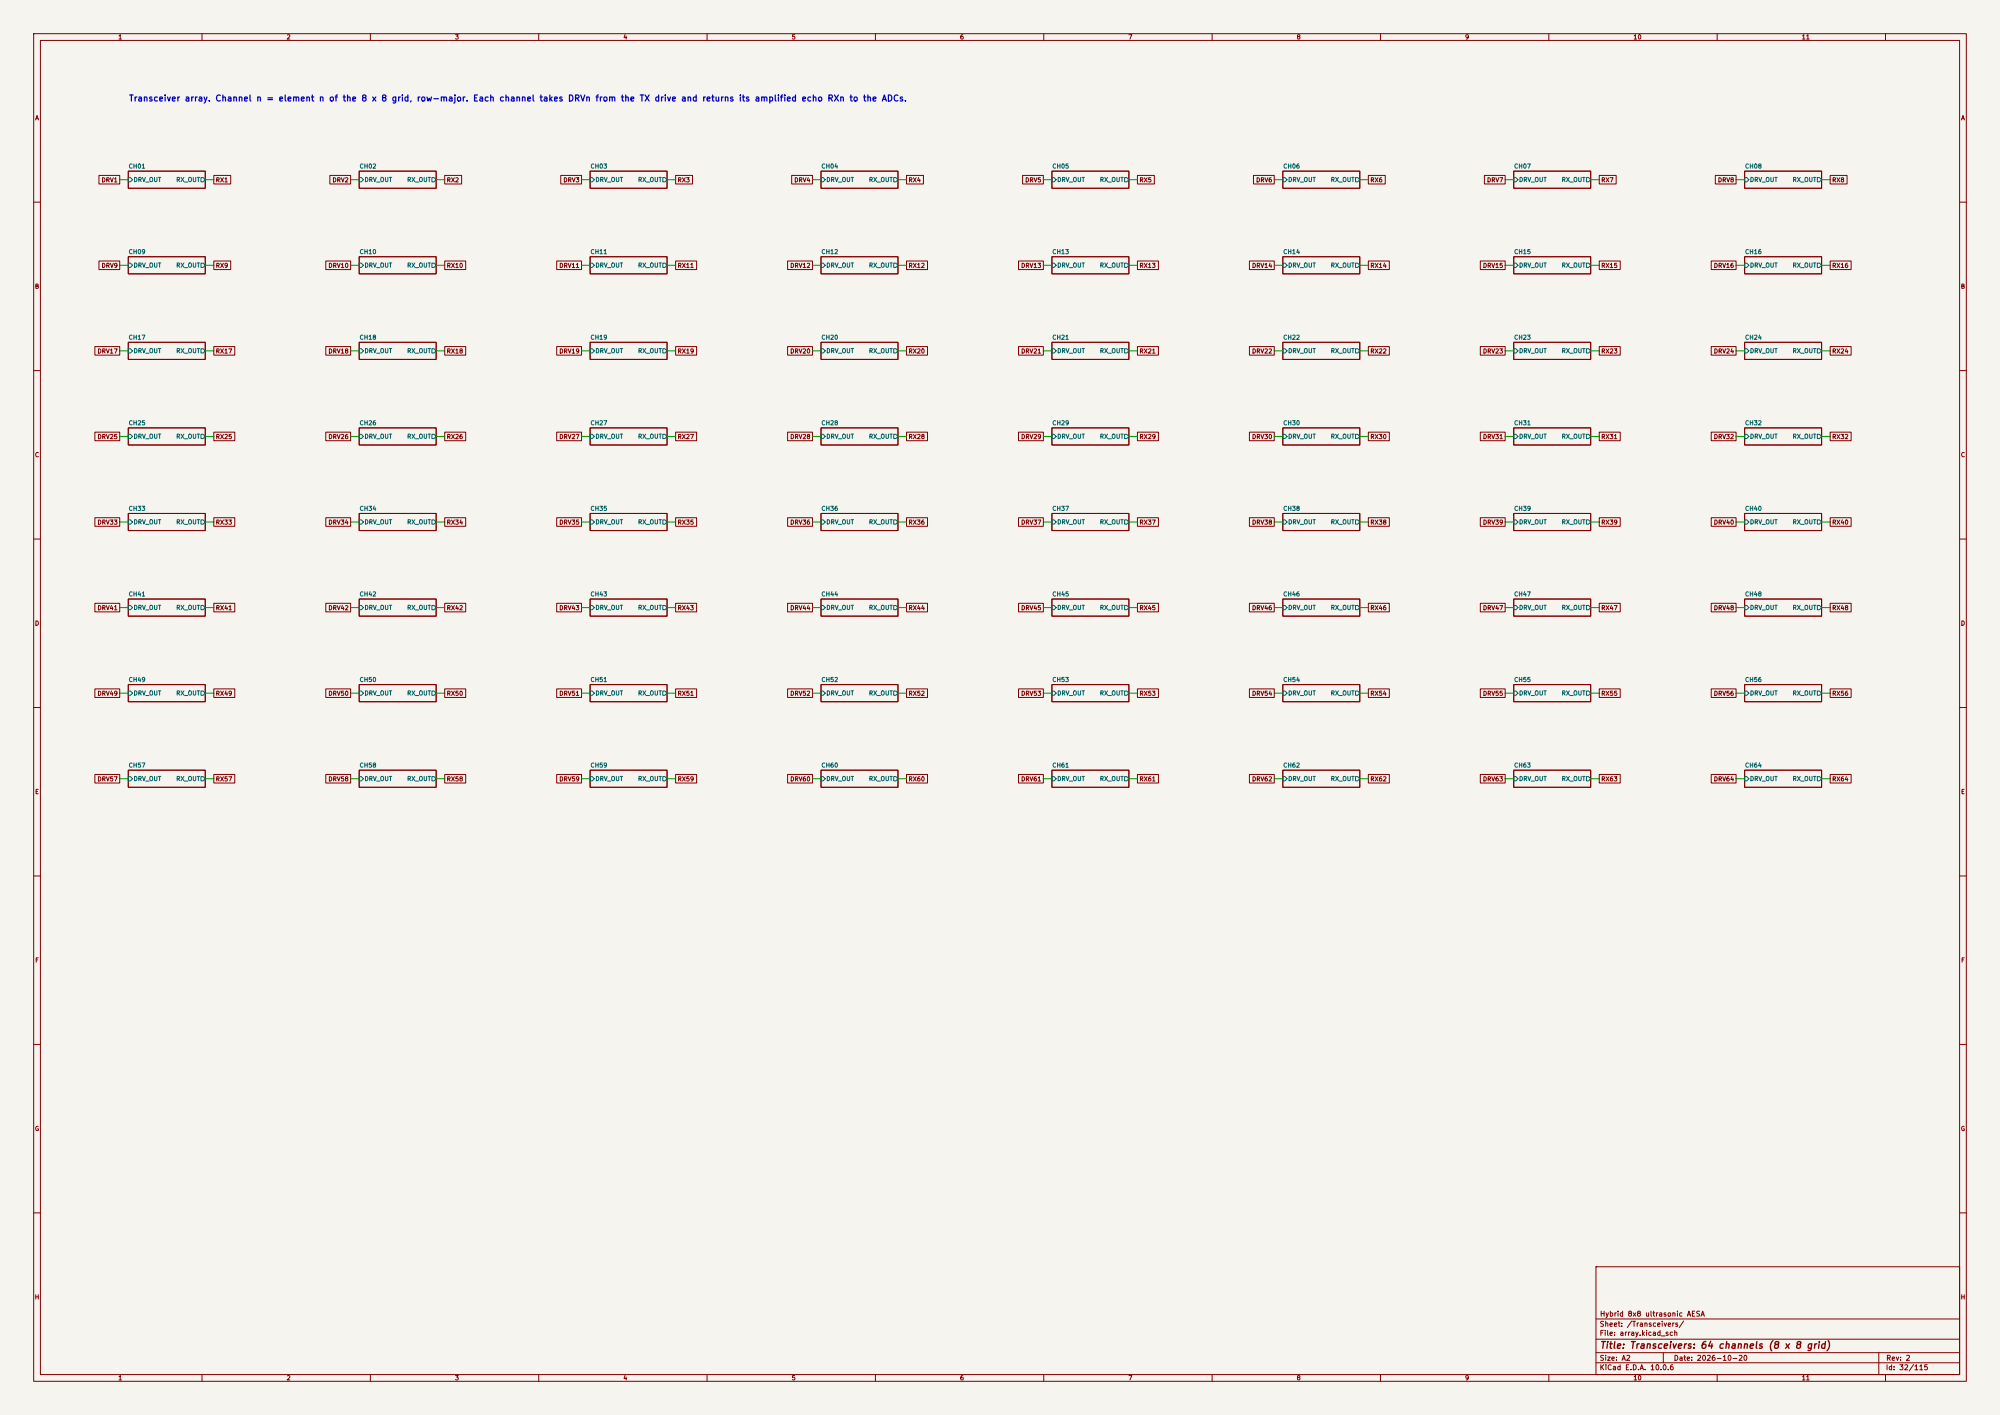
[picture p38: page 1]
FGH; FGH Date: 2026-10-20; KiCad E.D.A. 10.0.6; Size: A2; Rev: 2; DRV_OUT; RX_OUT CH22; RX_OUT CH07 DRV_OUT; RX_OUT CH23 DRV_OUT; RX_OUT CH06; RX_OUT CH08; RX_OUT CH53; RX_OUT CH05; RX_OUT CH16 DRV_OUT; RX_OUT CH56; RX_OUT CH14; RX_OUT CH24 DRV_OUT; RX_OUT CH47 DRV_OUT; RX_OUT CH46; RX_OUT CH64 DRV_OUT; RX_OUT CH62; RX_OUT CH13; RX_OUT CH63; RX_OUT CH32 DRV_OUT; RX_OUT CH15 DRV_OUT; RX_OUT CH29; RX_OUT CH40 DRV_OUT; RX_OUT CH54; RX_OUT CH21; RX_OUT CH30 DRV_OUT; RX_OUT CH34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

Transceiver array. Channel n = element n of the 8 x 8 grid, row-major. Each channel takes DRVn from the TX drive and returns its amplified echo RXn to the ADCs.

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
