tieziyun/ultrasonic-aesa/docs/schematics/08_channel.pdf

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

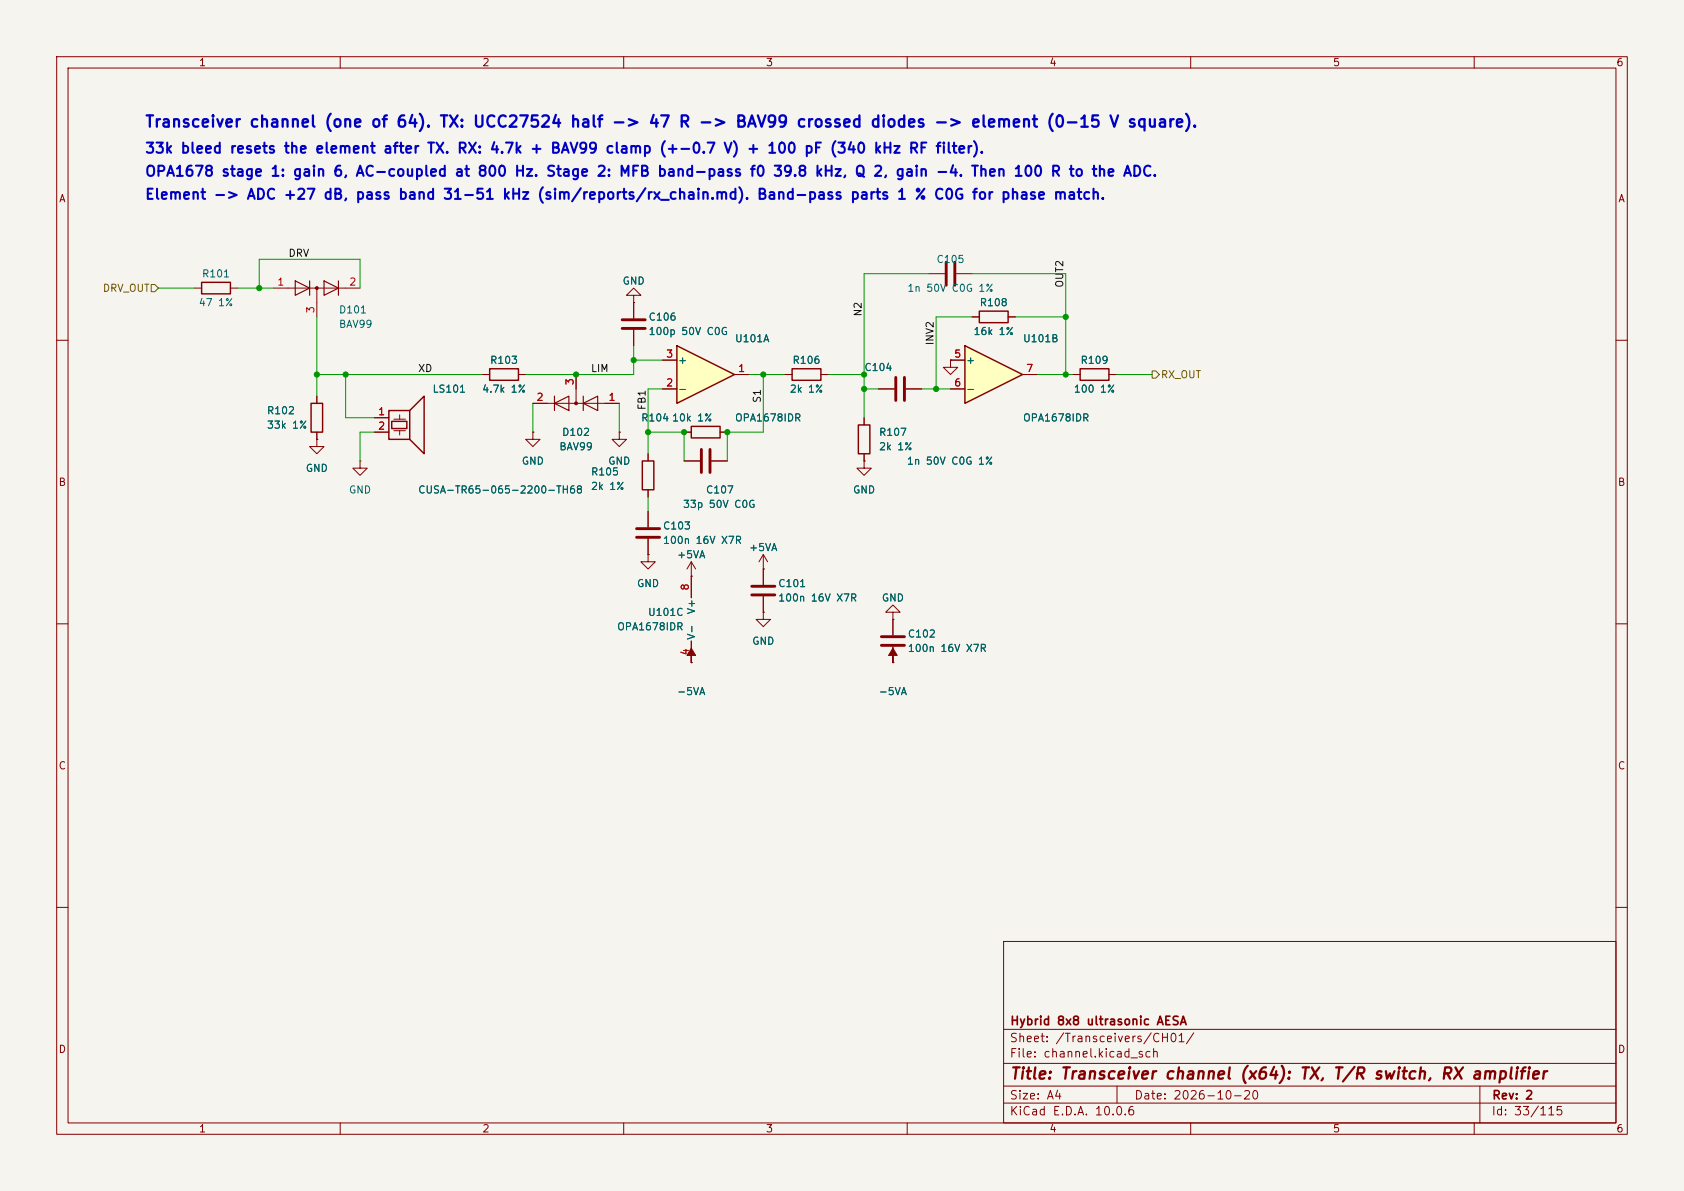
[picture p39: page 1]

Transceiver channel (one of 64). TX: UCC27524 half -> 47 R -> BAV99 crossed diodes -> element (0-15 V square). U101B OPA1678IDR ⁺

Element -> ADC +27 dB, pass band 31-51 kHz (sim/reports/rx_chain.md). Band-pass parts 1 % C0G for phase match.

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
