tieziyun/ultrasonic-aesa/docs/schematics/09_adcs.pdf

ADC_DOUTB6 RX2 | RX16 RX3 RX4 RX5 RX6 ADCs. ADC k digitises RX 8(k-1)+1 ... 8k and returns 2 serial lines (DOUTA/B). ADC1-4 use ADC_SCLK_A/CONVST_A, ADC5-8 the _B outputs.

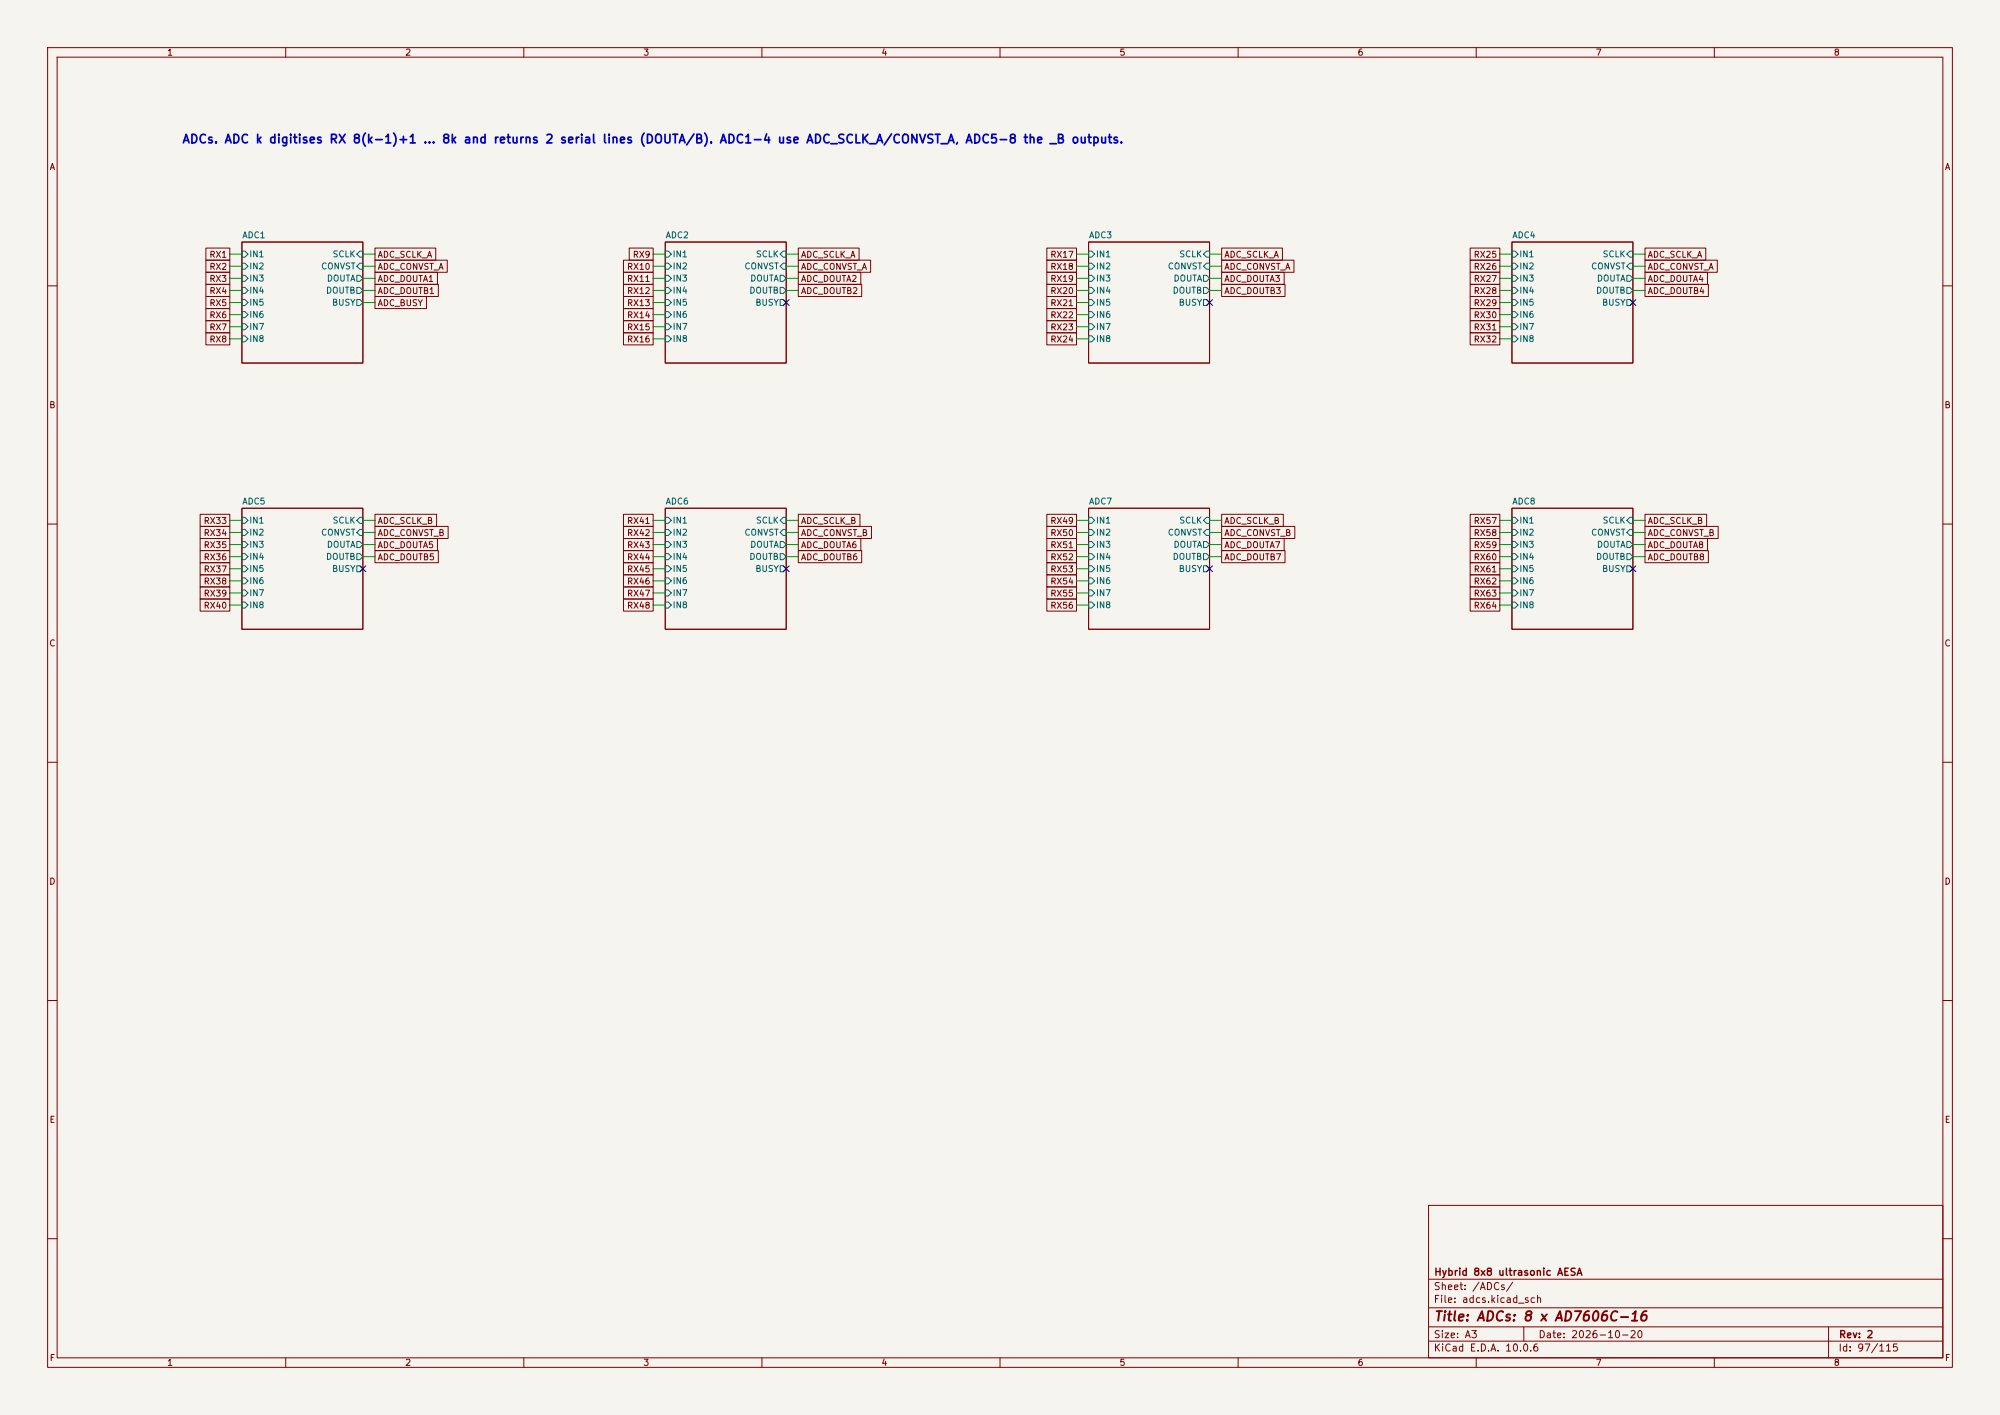
[picture p40: page 1]
F Date: 2026-10-20 KiCad E.D.A. 10.0.6; Size: A3; Rev: 2; BUSY; ADC3; ADC8; ADC5; ADC6; ADC7; ADC1; ADC2; ADC4 RX22; ADC_SCLK_A; ADC_CONVST_A; ADC_DOUTA1; ADC_DOUTB1; ADC_SCLK_A ADC_CONVST_A ADC_DOUTA4 ADC_DOUTB4; ADC_BUSY; ADC_SCLK_A ADC_CONVST_A ADC_DOUTA3; ADC_DOUTB3 RX15 RX1; ADC_CONVST_A ADC_DOUTA2; ADC_DOUTB2; ADC_SCLK_B ADC_CONVST_B ADC_DOUTA7 ADC_DOUTB7 RX39 RX40; ADC_SCLK_B ADC_CONVST_B ADC_DOUTA5; ADC_DOUTB5; ADC_SCLK_B ADC_CONVST_B ADC_DOUTA8 ADC_DOUTB8 RX48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

SCLK
CONVST DOUTA DOUTB

Hybrid 8x8 ultrasonic AESA
Sheet: /ADCs/
File: adcs.kicad_sch
Title: ADCs: 8 x AD7606C-16
