tieziyun/ultrasonic-aesa/docs/schematics/11_mics.pdf

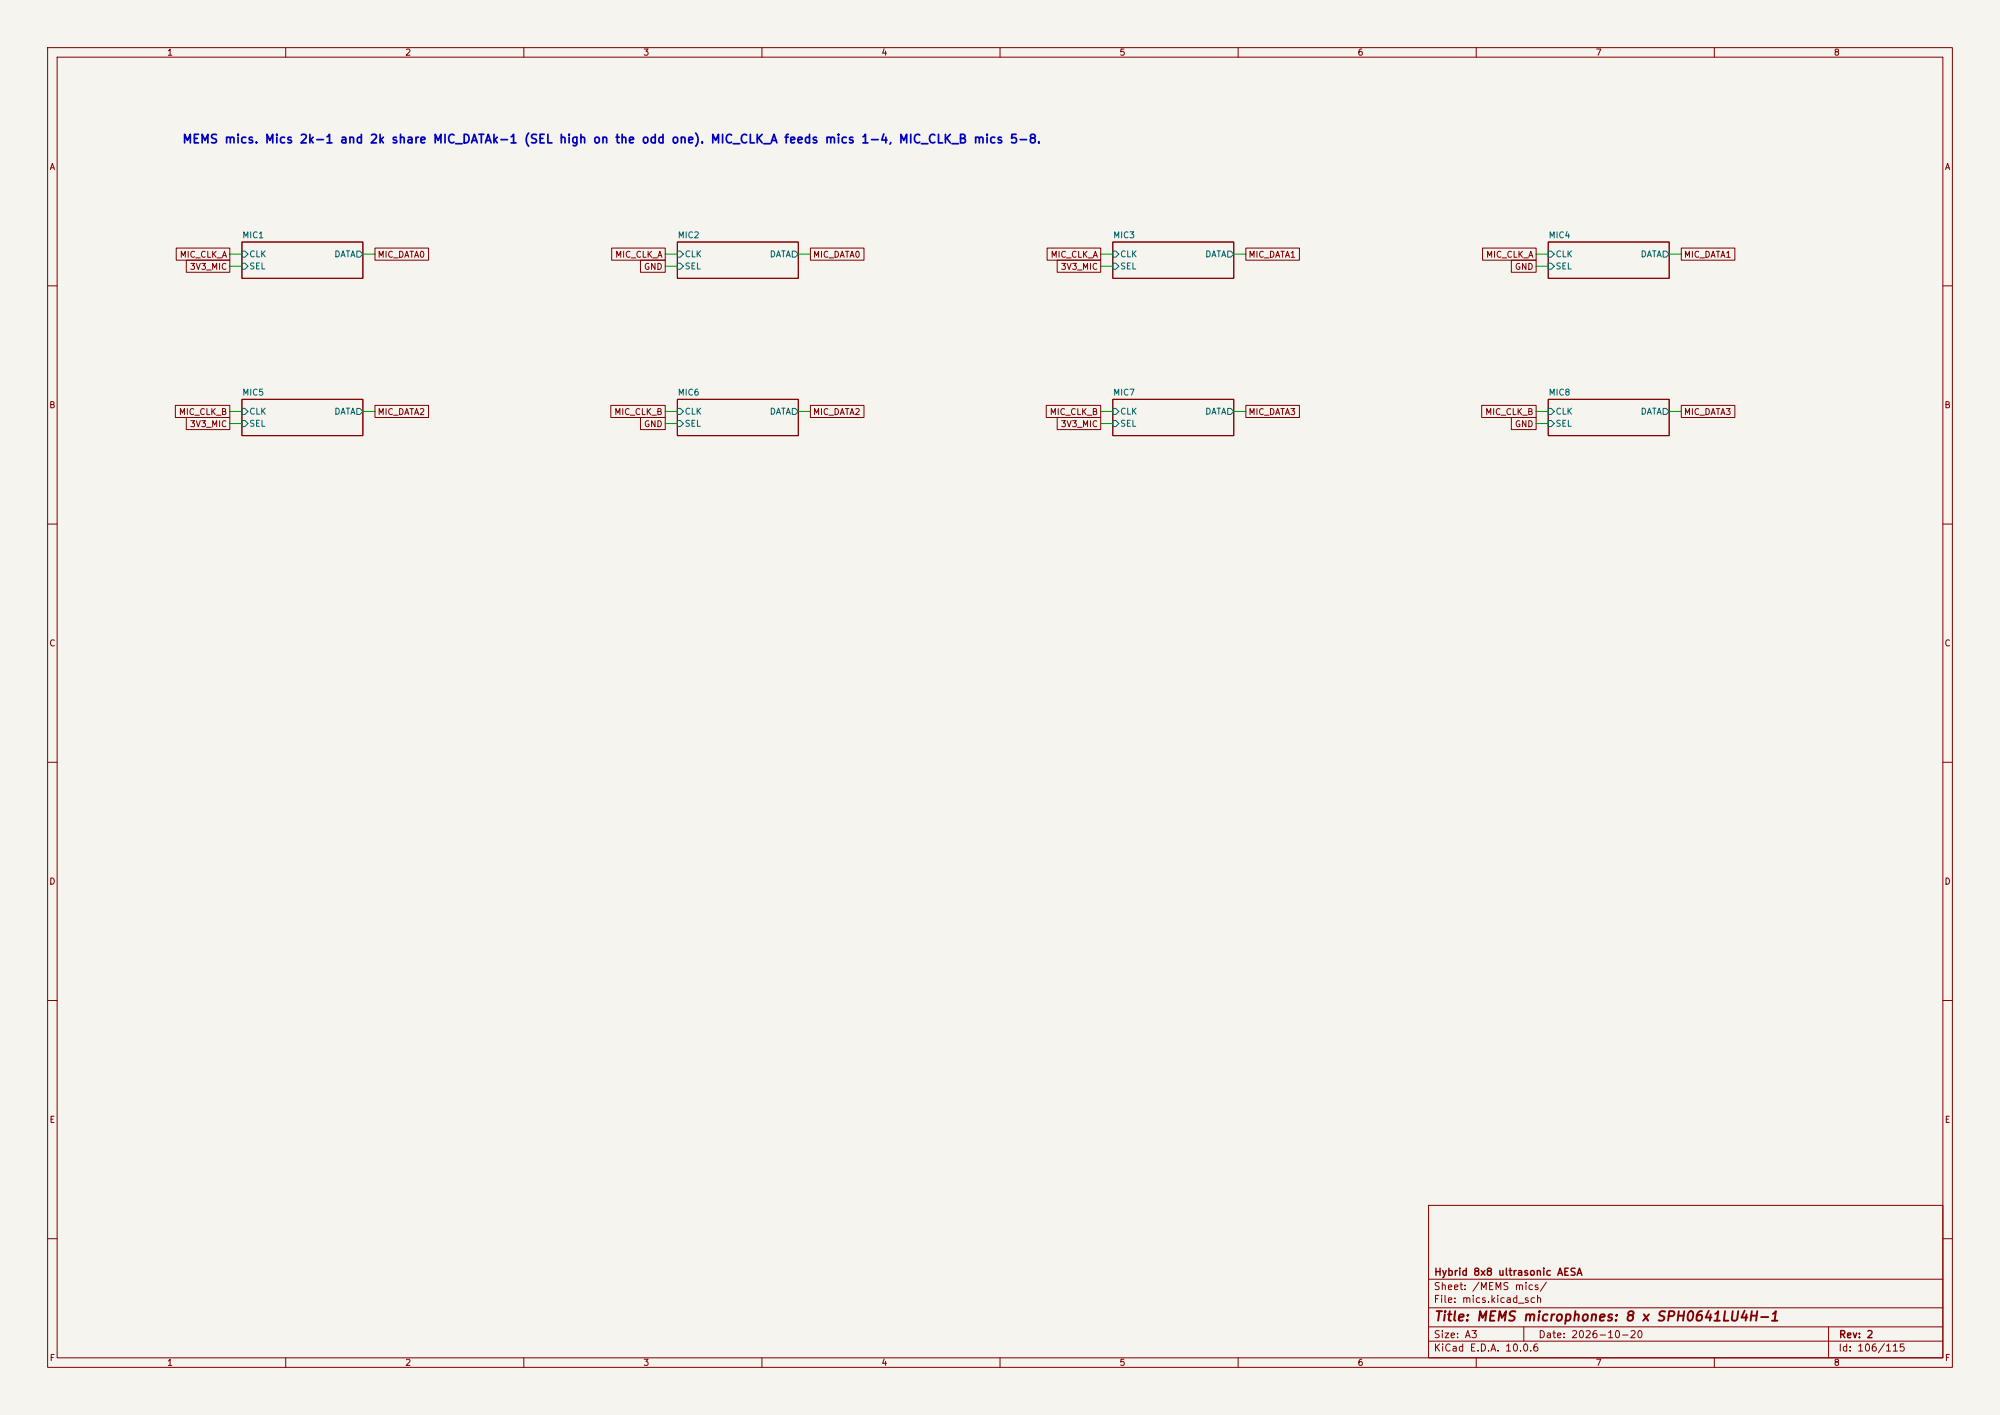
[picture p41: page 1]
F Date: 2026-10-20 KiCad E.D.A. 10.0.6; Size: A3; Rev: 2; CLK; SEL; DATA MIC6; DATA MIC8 CLK; DATA MIC7 CLK; DATA MIC1; DATA MIC4 CLK; DATA MIC2; DATA MIC3 CLK; DATA MIC5; MIC_CLK_A; MIC_DATA0; MIC_CLK_A GND; 3V3_MIC; MIC_DATA1 MIC_CLK_B; MIC_DATA2; MIC_DATA3 GND; MIC_CLK_B; GND MIC_DATA3; GND MIC_CLK_B MIC_CLK_A; MIC_CLK_A 3V3_MIC; MIC_DATA0 MEMS mics. Mics 2k-1 and 2k share MIC_DATAk-1 (SEL high on the odd one). MIC_CLK_A feeds mics 1-4, MIC_CLK_B mics 5-8.

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
