tieziyun/ultrasonic-aesa/docs/schematics/02_adc.pdf

## Software mode: OS0-OS2 high. FPGA writes registers over SDI (pin 29, DB11/SDI) at boot:

# ADC: AD7606C-16 (pin-compatible with AD7606B; symbol keeps AD7606 pin names)

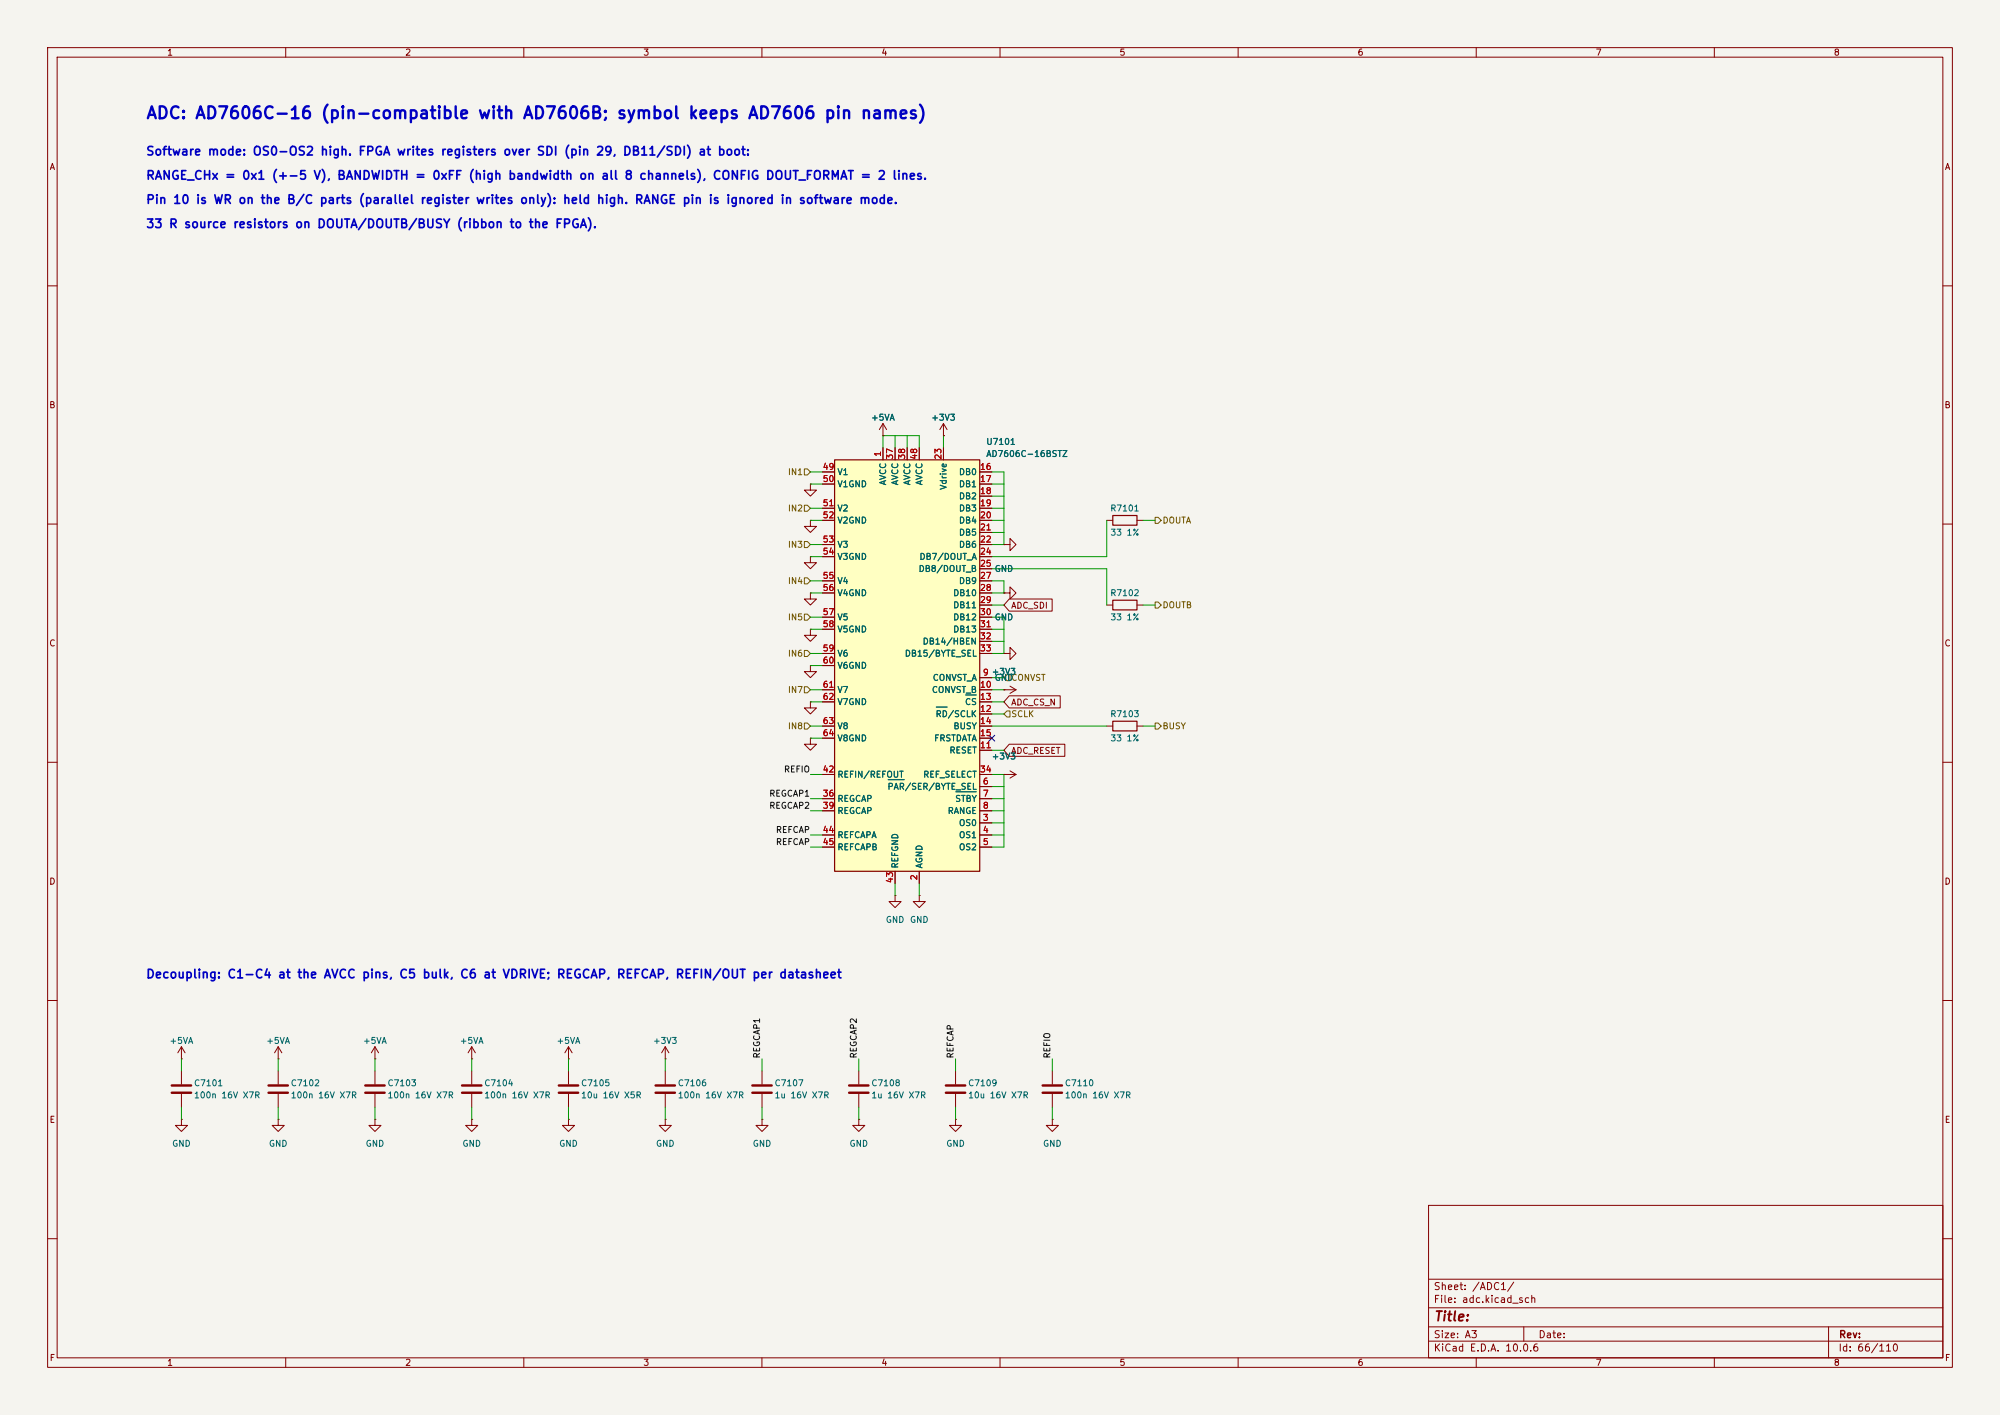
[picture p42: page 1]

RANGE_CHx = 0x1 (+-5 V), BANDWIDTH = 0xFF (high bandwidth on all 8 channels), CONFIG DOUT_FORMAT = 2 lines.
33 R source resistors on DOUTA/DOUTB/BUSY (ribbon to the FPGA).

GND +3V3
STBY 7 RANGE 8 CONVST_A 9 CONVST_B 10 RESET 11 RD/SCLK 12 CS 13 BUSY 14

V4GND 56

Decoupling: C1-C4 at the AVCC pins, C5 bulk, C6 at VDRIVE; REGCAP, REFCAP, REFIN/OUT per datasheet
