tieziyun/ultrasonic-aesa/docs/schematics/03_tx_group.pdf

BIT1 BIT3 BIT4 BIT3 BIT1 BIT2 | BIT2 BIT4 EN from one 74AHCT1G125 per 8 drivers (en_buf). SCK/LATCH from a clk_buf output (<= 4 loads).

TX group: 4 elements. 74HCT595 QA-QD -> UCC27524 inputs; QE-QH unused (16 data lines, 10 MHz SRCLK) U10103 UCC27524DR

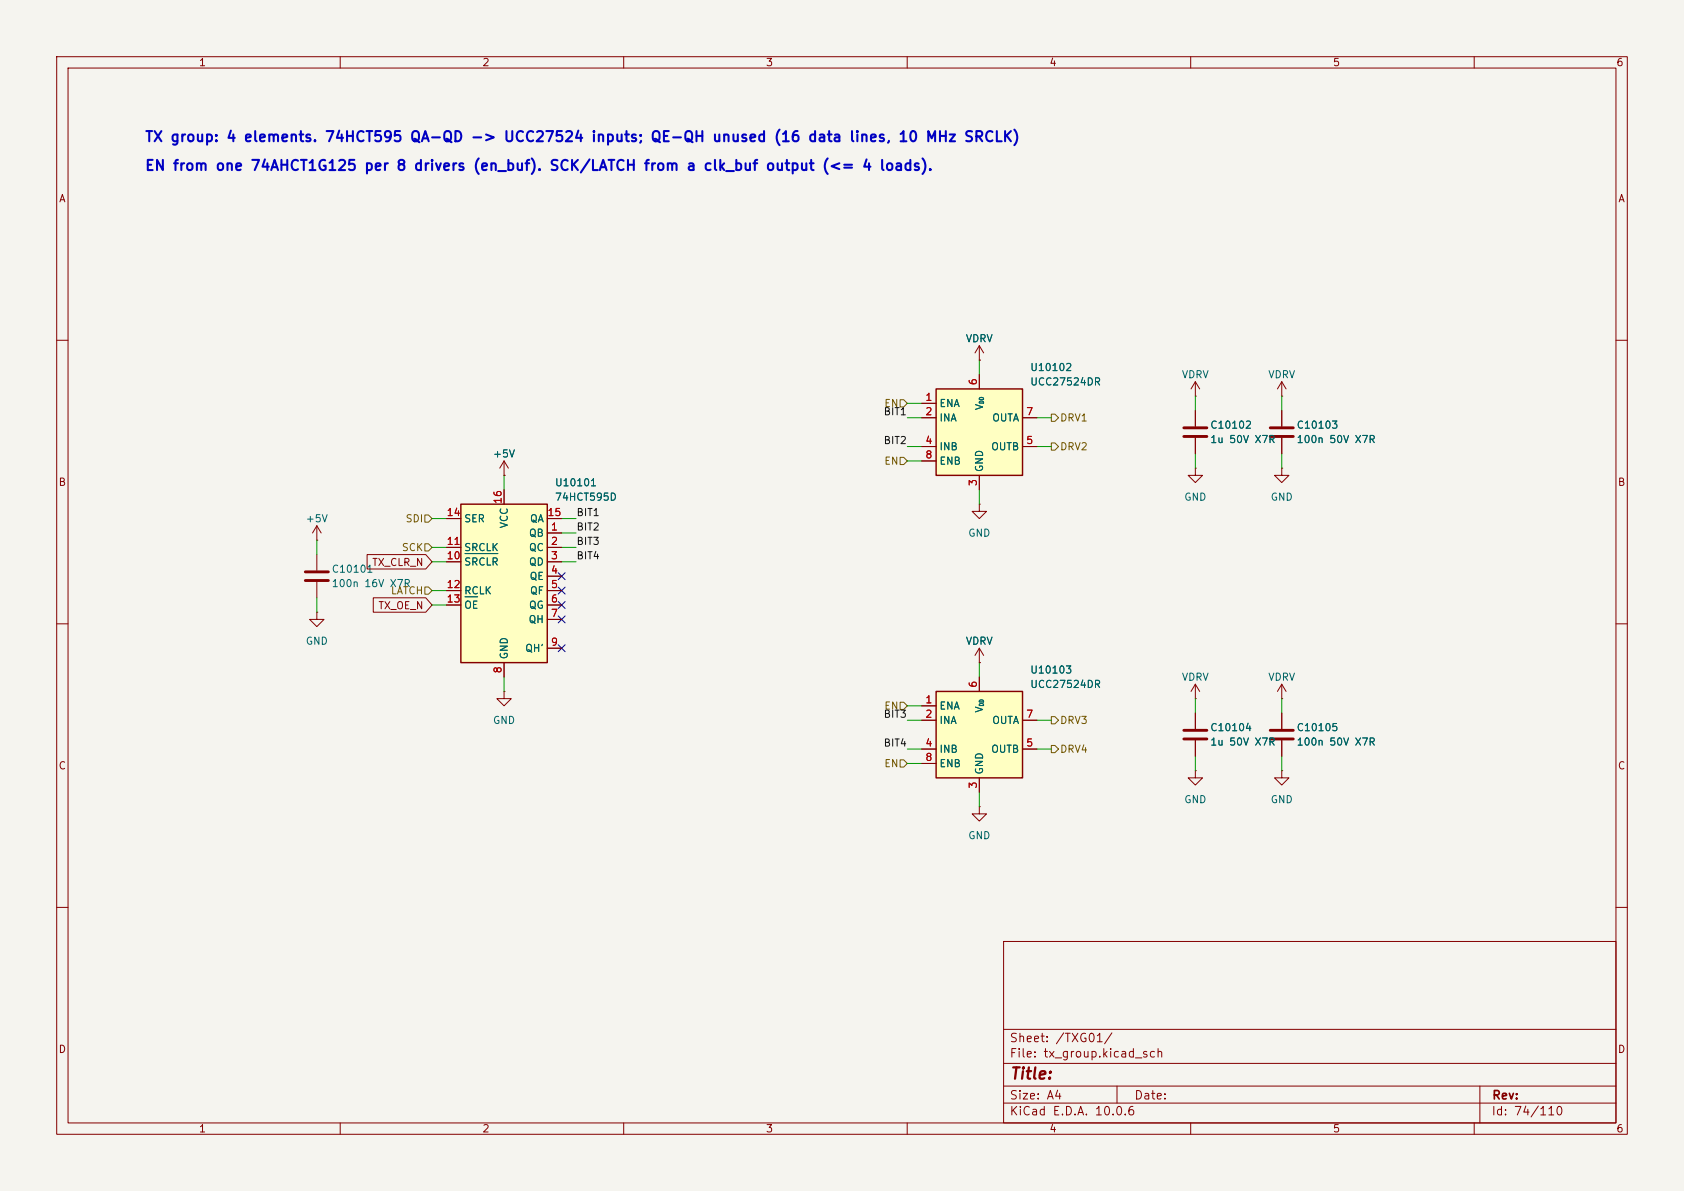
[picture p43: page 1]
D Date:; KiCad E.D.A. 10.0.6; Size: A4; Rev:; Title:; File: tx_group.kicad_sch; Sheet: /TXG01/; VDRV; GND; VDRV GND; ENA 1; INA 2; INB 4; OUTB 5; VDD 6 OUTA 7; ENB 8; U10103 UCC27524DR; VDRV ENA 1; U10102 UCC27524DR; VDRV C10104; VDRV +5V GND; QB 1 QC 2 QD 3 QE 4 QF 5 QG 6 QH 7 GND; SER 14; QA 15 VCC 16; 74HCT595D; DRV4 DRV3 DRV2; SDI SCK; DRV1; LATCH; TX_CLR_N; VDRV +5V

74HCT595D QB 1 QC 2 QD 3 QE 4 QF 5 QG 6 QH 7 GND

SRCLR 10 SRCLK 11 RCLK 12 OE 13
