tieziyun/ultrasonic-aesa/docs/schematics/04_en_buf.pdf

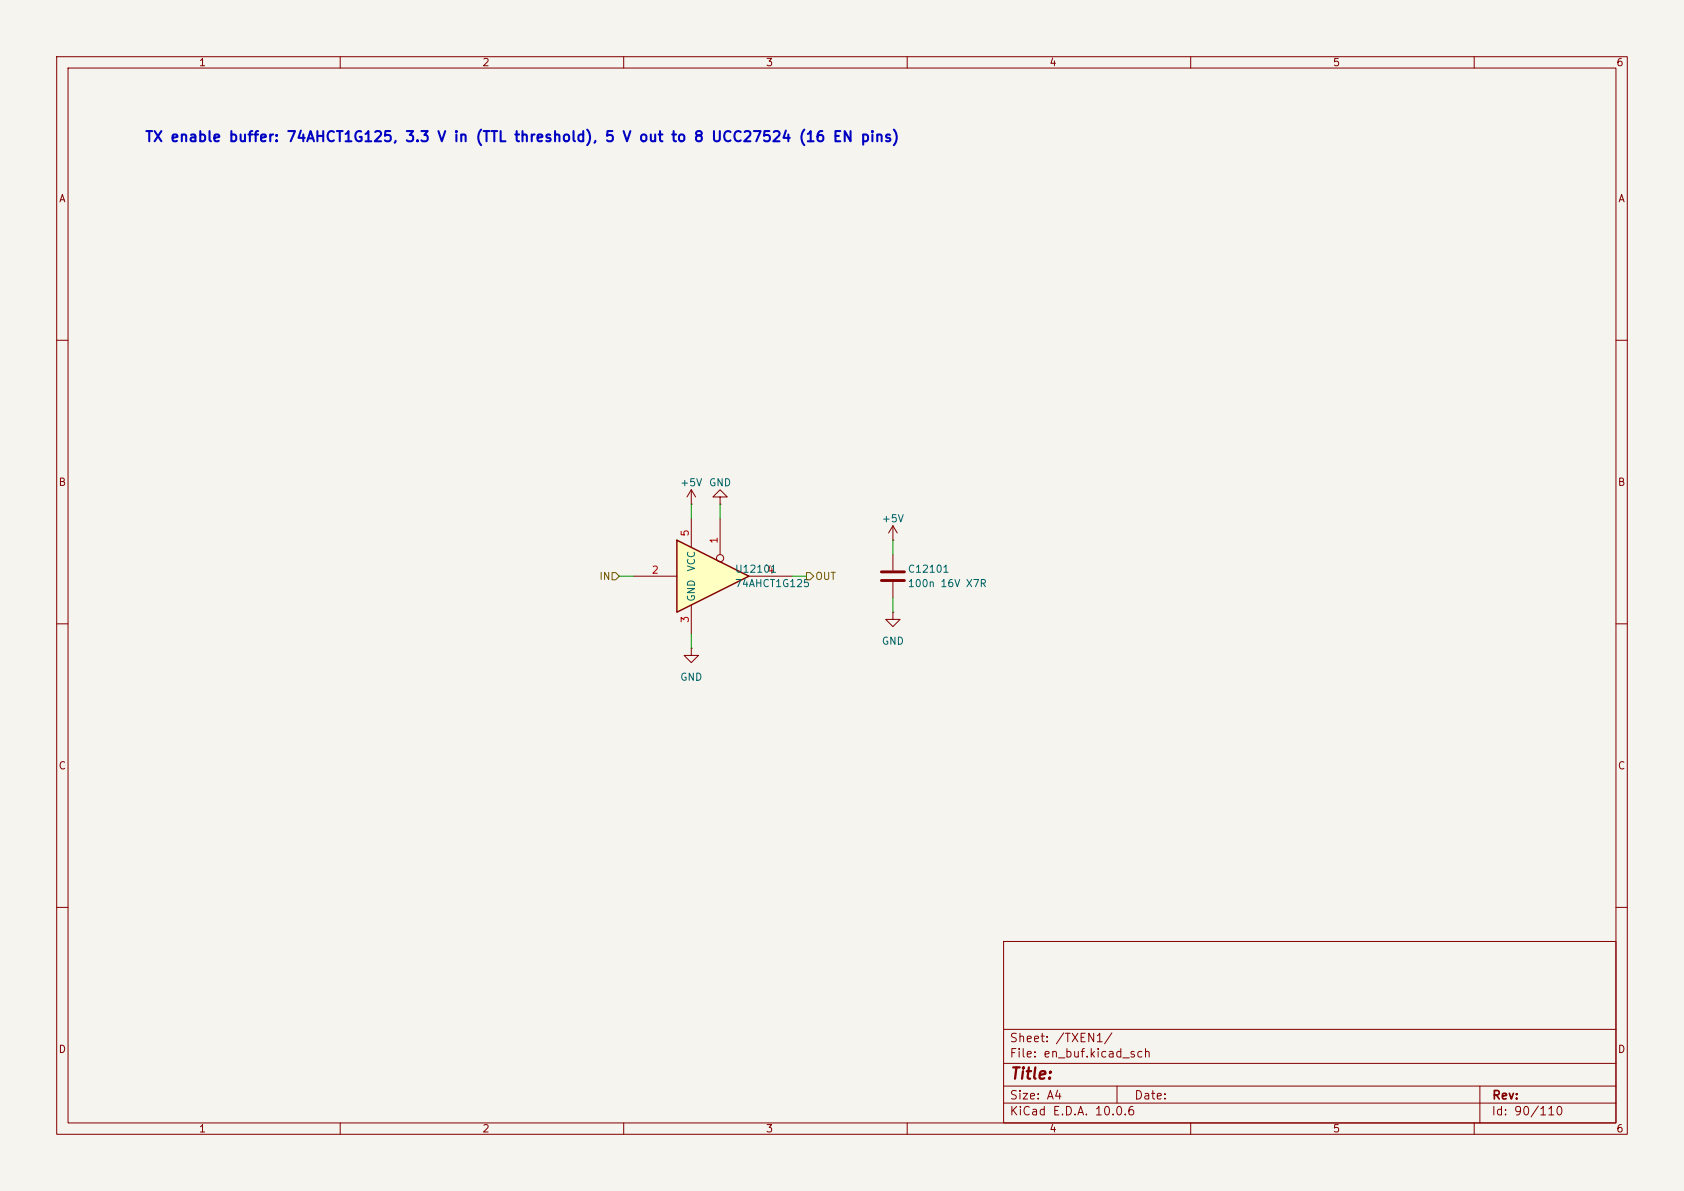
[picture p44: page 1]
D Date:; KiCad E.D.A. 10.0.6; Size: A4; Rev:; Title:; File: en_buf.kicad_sch; Sheet: /TXEN1/ ⁺⁵V GND; GND; 3 VCC 4; 74AHCT1G125 GND; OUT TX enable buffer: 74AHCT1G125, 3.3 V in (TTL threshold), 5 V out to 8 UCC27524 (16 EN pins)
