tieziyun/ultrasonic-aesa/docs/schematics/05_clk_buf.pdf

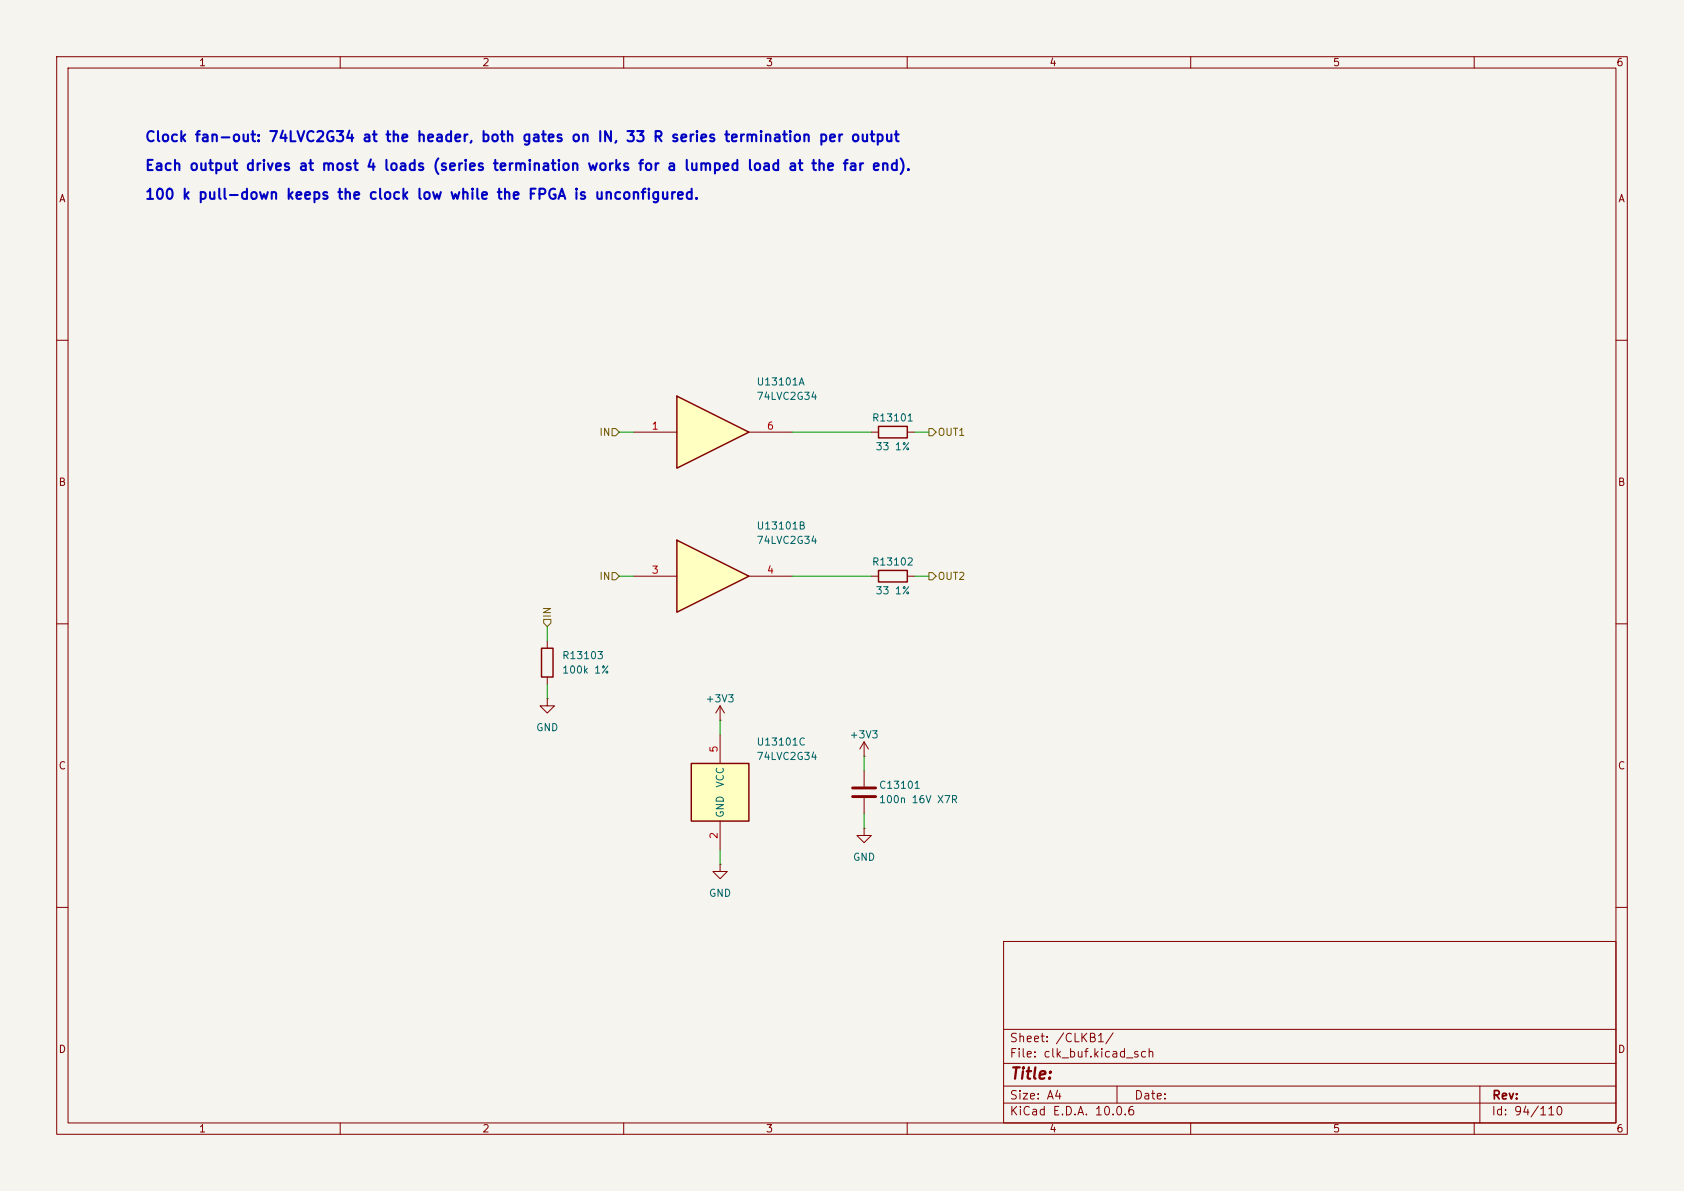
[picture p45: page 1]
D Date:; KiCad E.D.A. 10.0.6; Size: A4; Rev:; Title:; File: clk_buf.kicad_sch; Sheet: /CLKB1/; 6 U13101A 74LVC2G34; 74LVC2G34 +3V3 R13103; GND; 33 1% GND; 2 VCC; 74LVC2G34

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
