tieziyun/ultrasonic-aesa/docs/schematics/06_mic.pdf

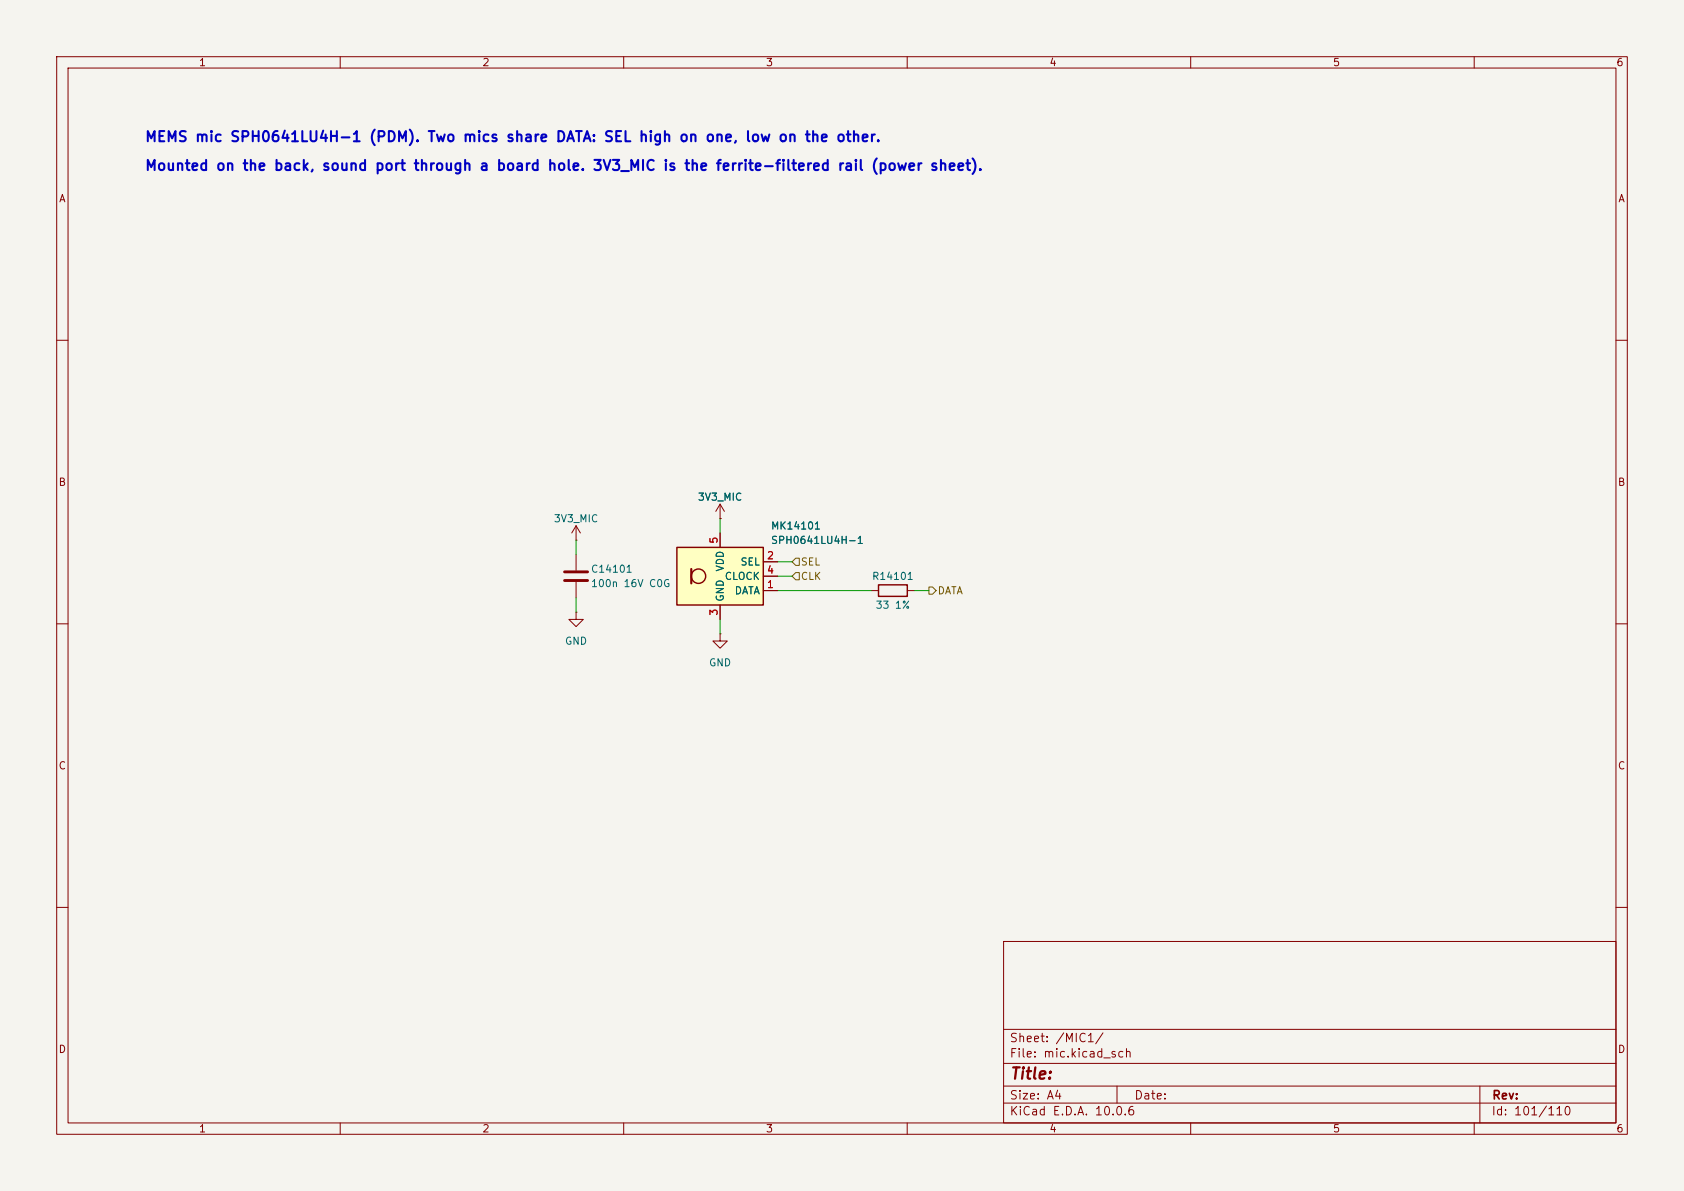
[picture p46: page 1]
D Date:; KiCad E.D.A. 10.0.6; Size: A4; Rev:; Title:; File: mic.kicad_sch; Sheet: /MIC1/; 3V3_MIC; GND; DATA 1; SEL 2 GND; 3 CLOCK VDD 4; 5 MK14101 SPH0641LU4H-1 R14101; DATA CLK; MEMS mic SPH0641LU4H-1 (PDM). Two mics share DATA: SEL high on one, low on the other. 3V3_MIC; SPH0641LU4H-1 DATA 1 SEL 2 GND

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
