tieziyun/ultrasonic-aesa/docs/schematics/08_power.pdf

cut to isolate +5V | GND
GND D9503 | green

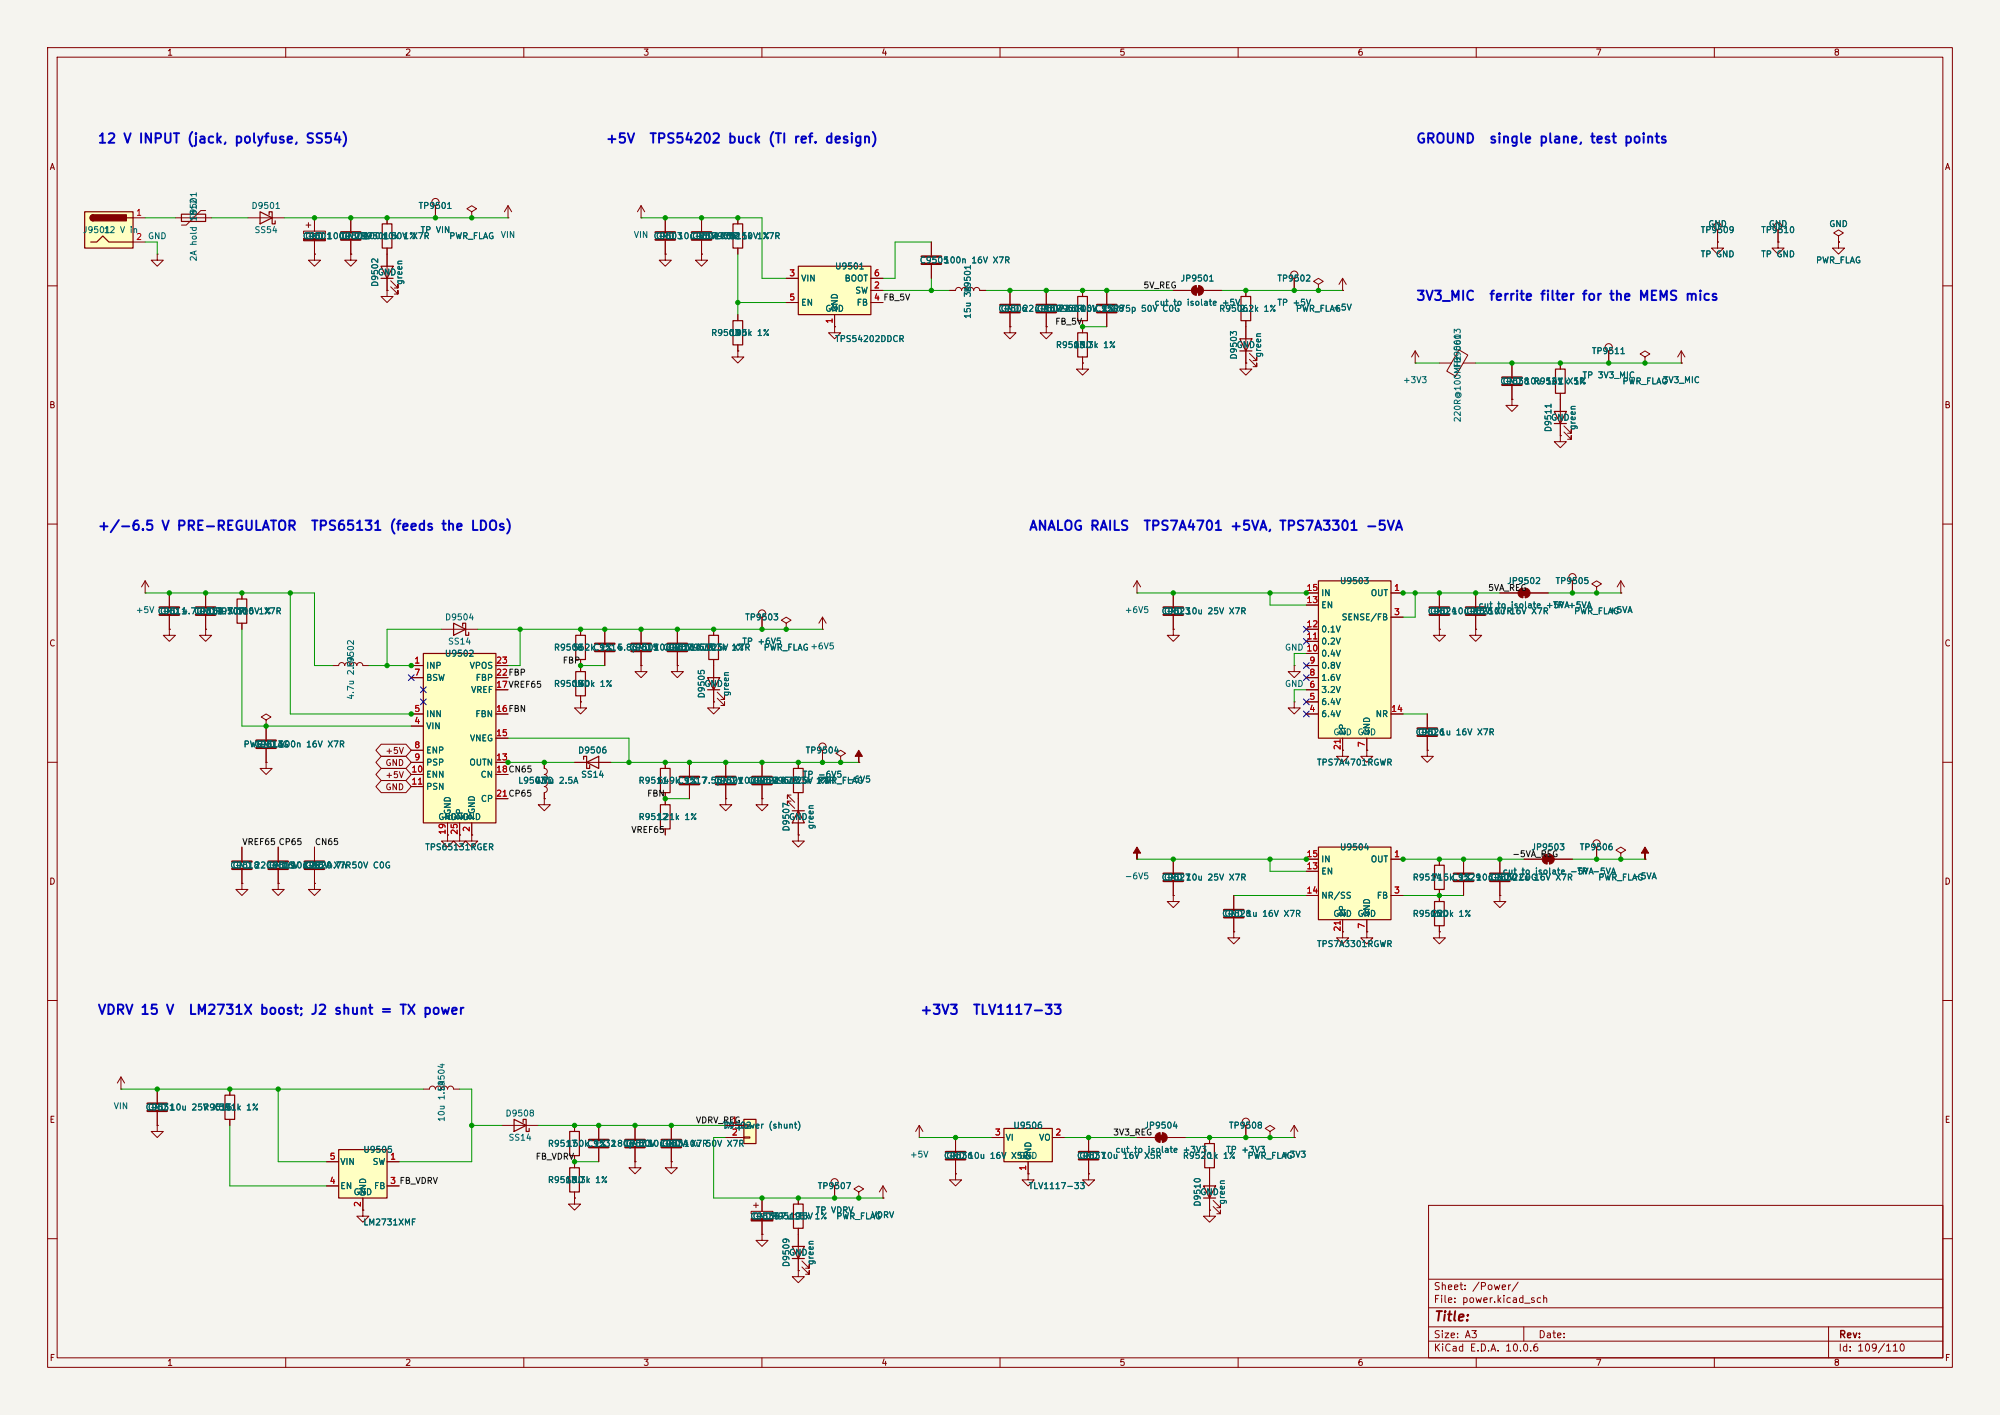
[picture p47: page 1]

+5V TPS54202 buck (TI ref. design)

3V3_MIC ferrite filter for the MEMS mics

TP +6V5 GND
FBP 22 VPOS 23 EP 25 GNDGNDGND

VDRV 15 V LM2731X boost; J2 shunt = TX power
