tieziyun/ultrasonic-aesa/docs/schematics/01_channel.pdf

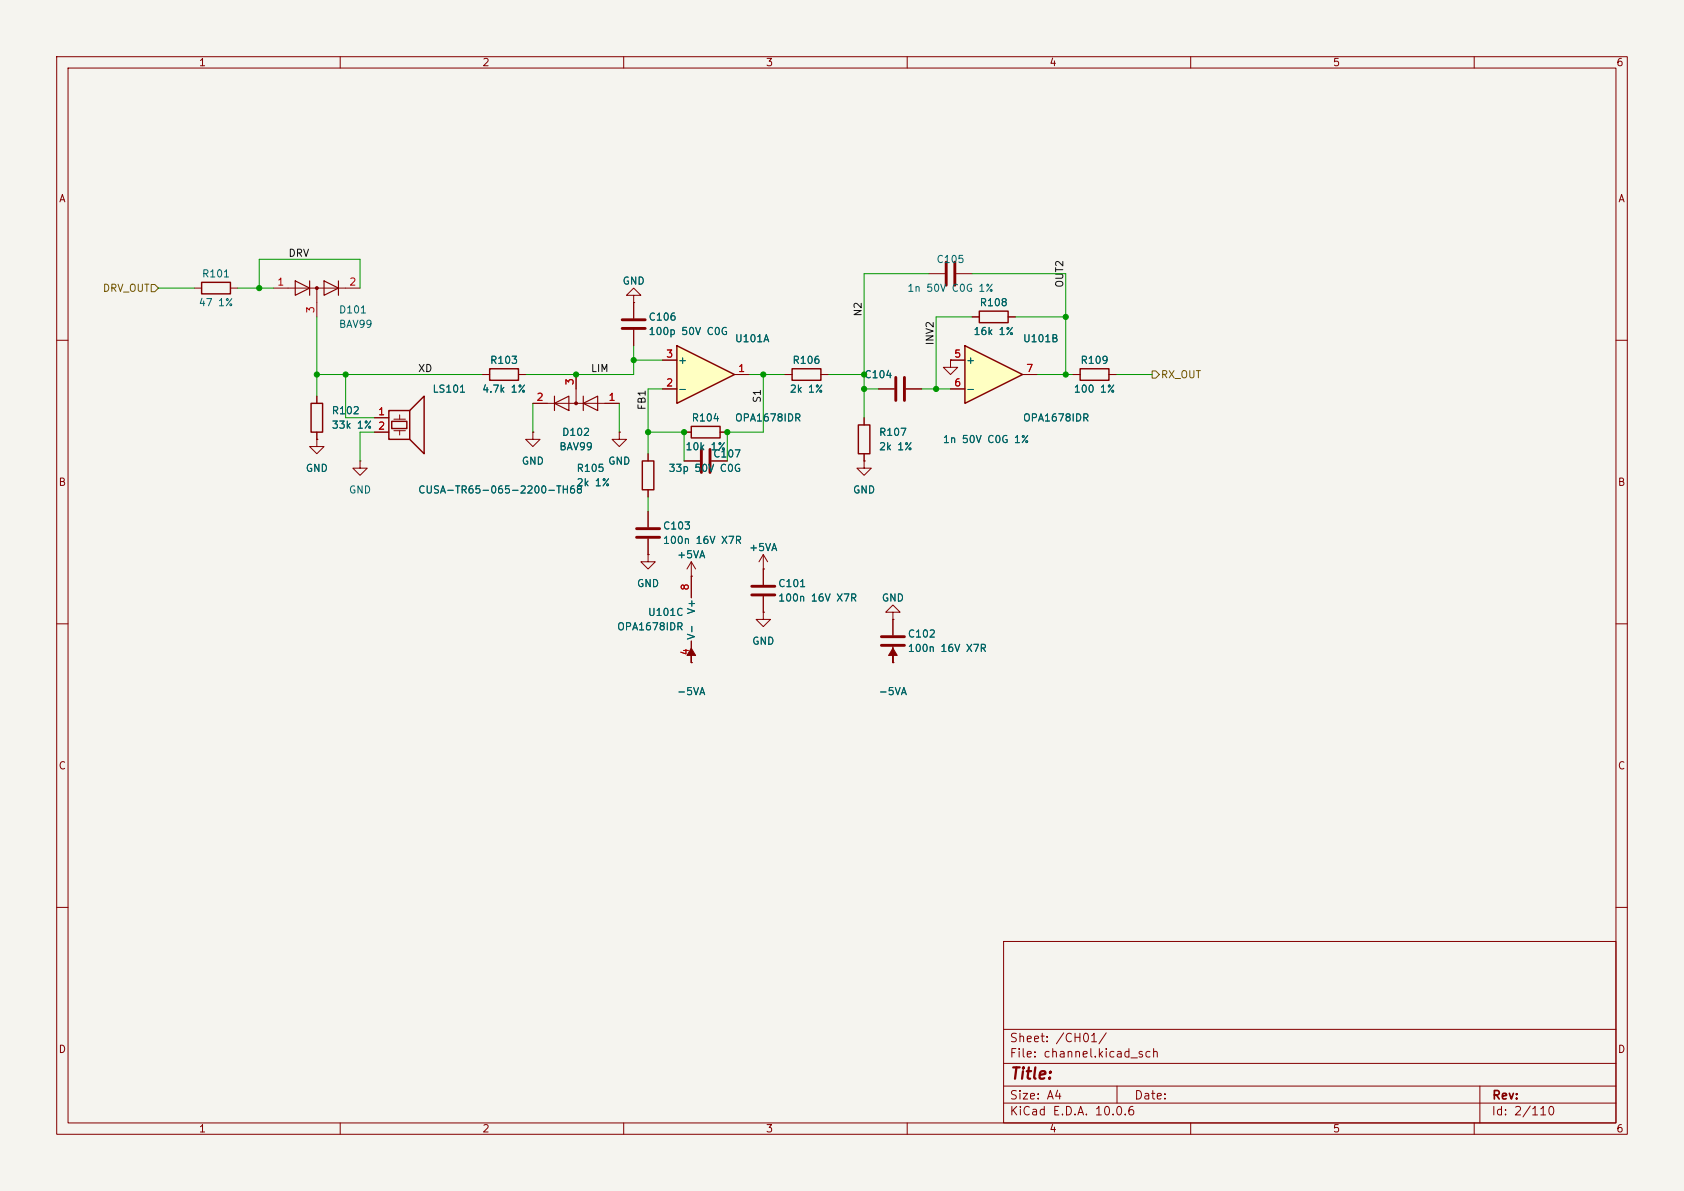
[picture p48: page 1]
