tieziyun/ultrasonic-aesa/kicad/aesa.kicad_pcb

## KiCad design kicad/aesa.kicad_pcb (2026-10-27)

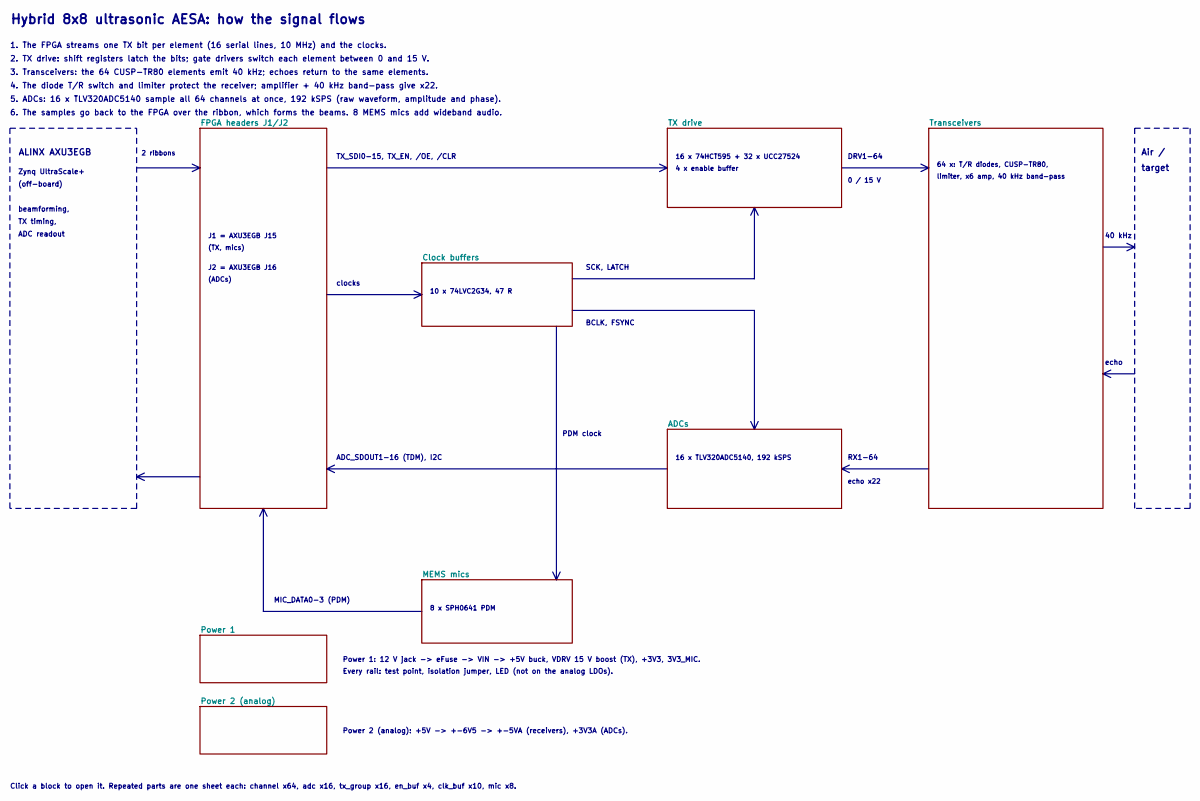
[picture p49: schematic aesa.kicad_sch, Hybrid 8x8 ultrasonic AESA: block diagram]

Notes on the sheet:
Hybrid 8x8 ultrasonic AESA: how the signal flows
1. The FPGA streams one TX bit per element (16 serial lines, 10 MHz) and the clocks.
2. TX drive: shift registers latch the bits; gate drivers switch each element between 0 and 15 V.
3. Transceivers: the 64 CUSP-TR80 elements emit 40 kHz; echoes return to the same elements.
4. The diode T/R switch and limiter protect the receiver; amplifier + 40 kHz band-pass give x22.
5. ADCs: 16 x TLV320ADC5140 sample all 64 channels at once, 192 kSPS (raw waveform, amplitude and phase).
6. The samples go back to the FPGA over the ribbon, which forms the beams. 8 MEMS mics add wideband audio.
ALINX AXU3EGB
Zynq UltraScale+
(off-board)
beamforming,
TX timing,
ADC readout
Air /
target
2 ribbons
TX_SDI0-15, TX_EN, /OE, /CLR
clocks
SCK, LATCH
BCLK, FSYNC
PDM clock
DRV1-64
0 / 15 V
40 kHz
echo
RX1-64
echo x22
ADC_SDOUT1-16 (TDM), I2C
MIC_DATA0-3 (PDM)
16 x 74HCT595 + 32 x UCC27524
4 x enable buffer
64 x: T/R diodes, CUSP-TR80,
limiter, x6 amp, 40 kHz band-pass
16 x TLV320ADC5140, 192 kSPS
10 x 74LVC2G34, 47 R
8 x SPH0641 PDM
J1 = AXU3EGB J15
(TX, mics)
J2 = AXU3EGB J16
(ADCs)
Power 1: 12 V jack -> eFuse -> VIN -> +5V buck, VDRV 15 V boost (TX), +3V3, 3V3_MIC.
Power 2 (analog): +5V -> +-6V5 -> +-5VA (receivers), +3V3A (ADCs).
Every rail: test point, isolation jumper, LED (not on the analog LDOs).
Click a block to open it. Repeated parts are one sheet each: channel x64, adc x16, tx_group x16, en_buf x4, clk_buf x10, mic x8.

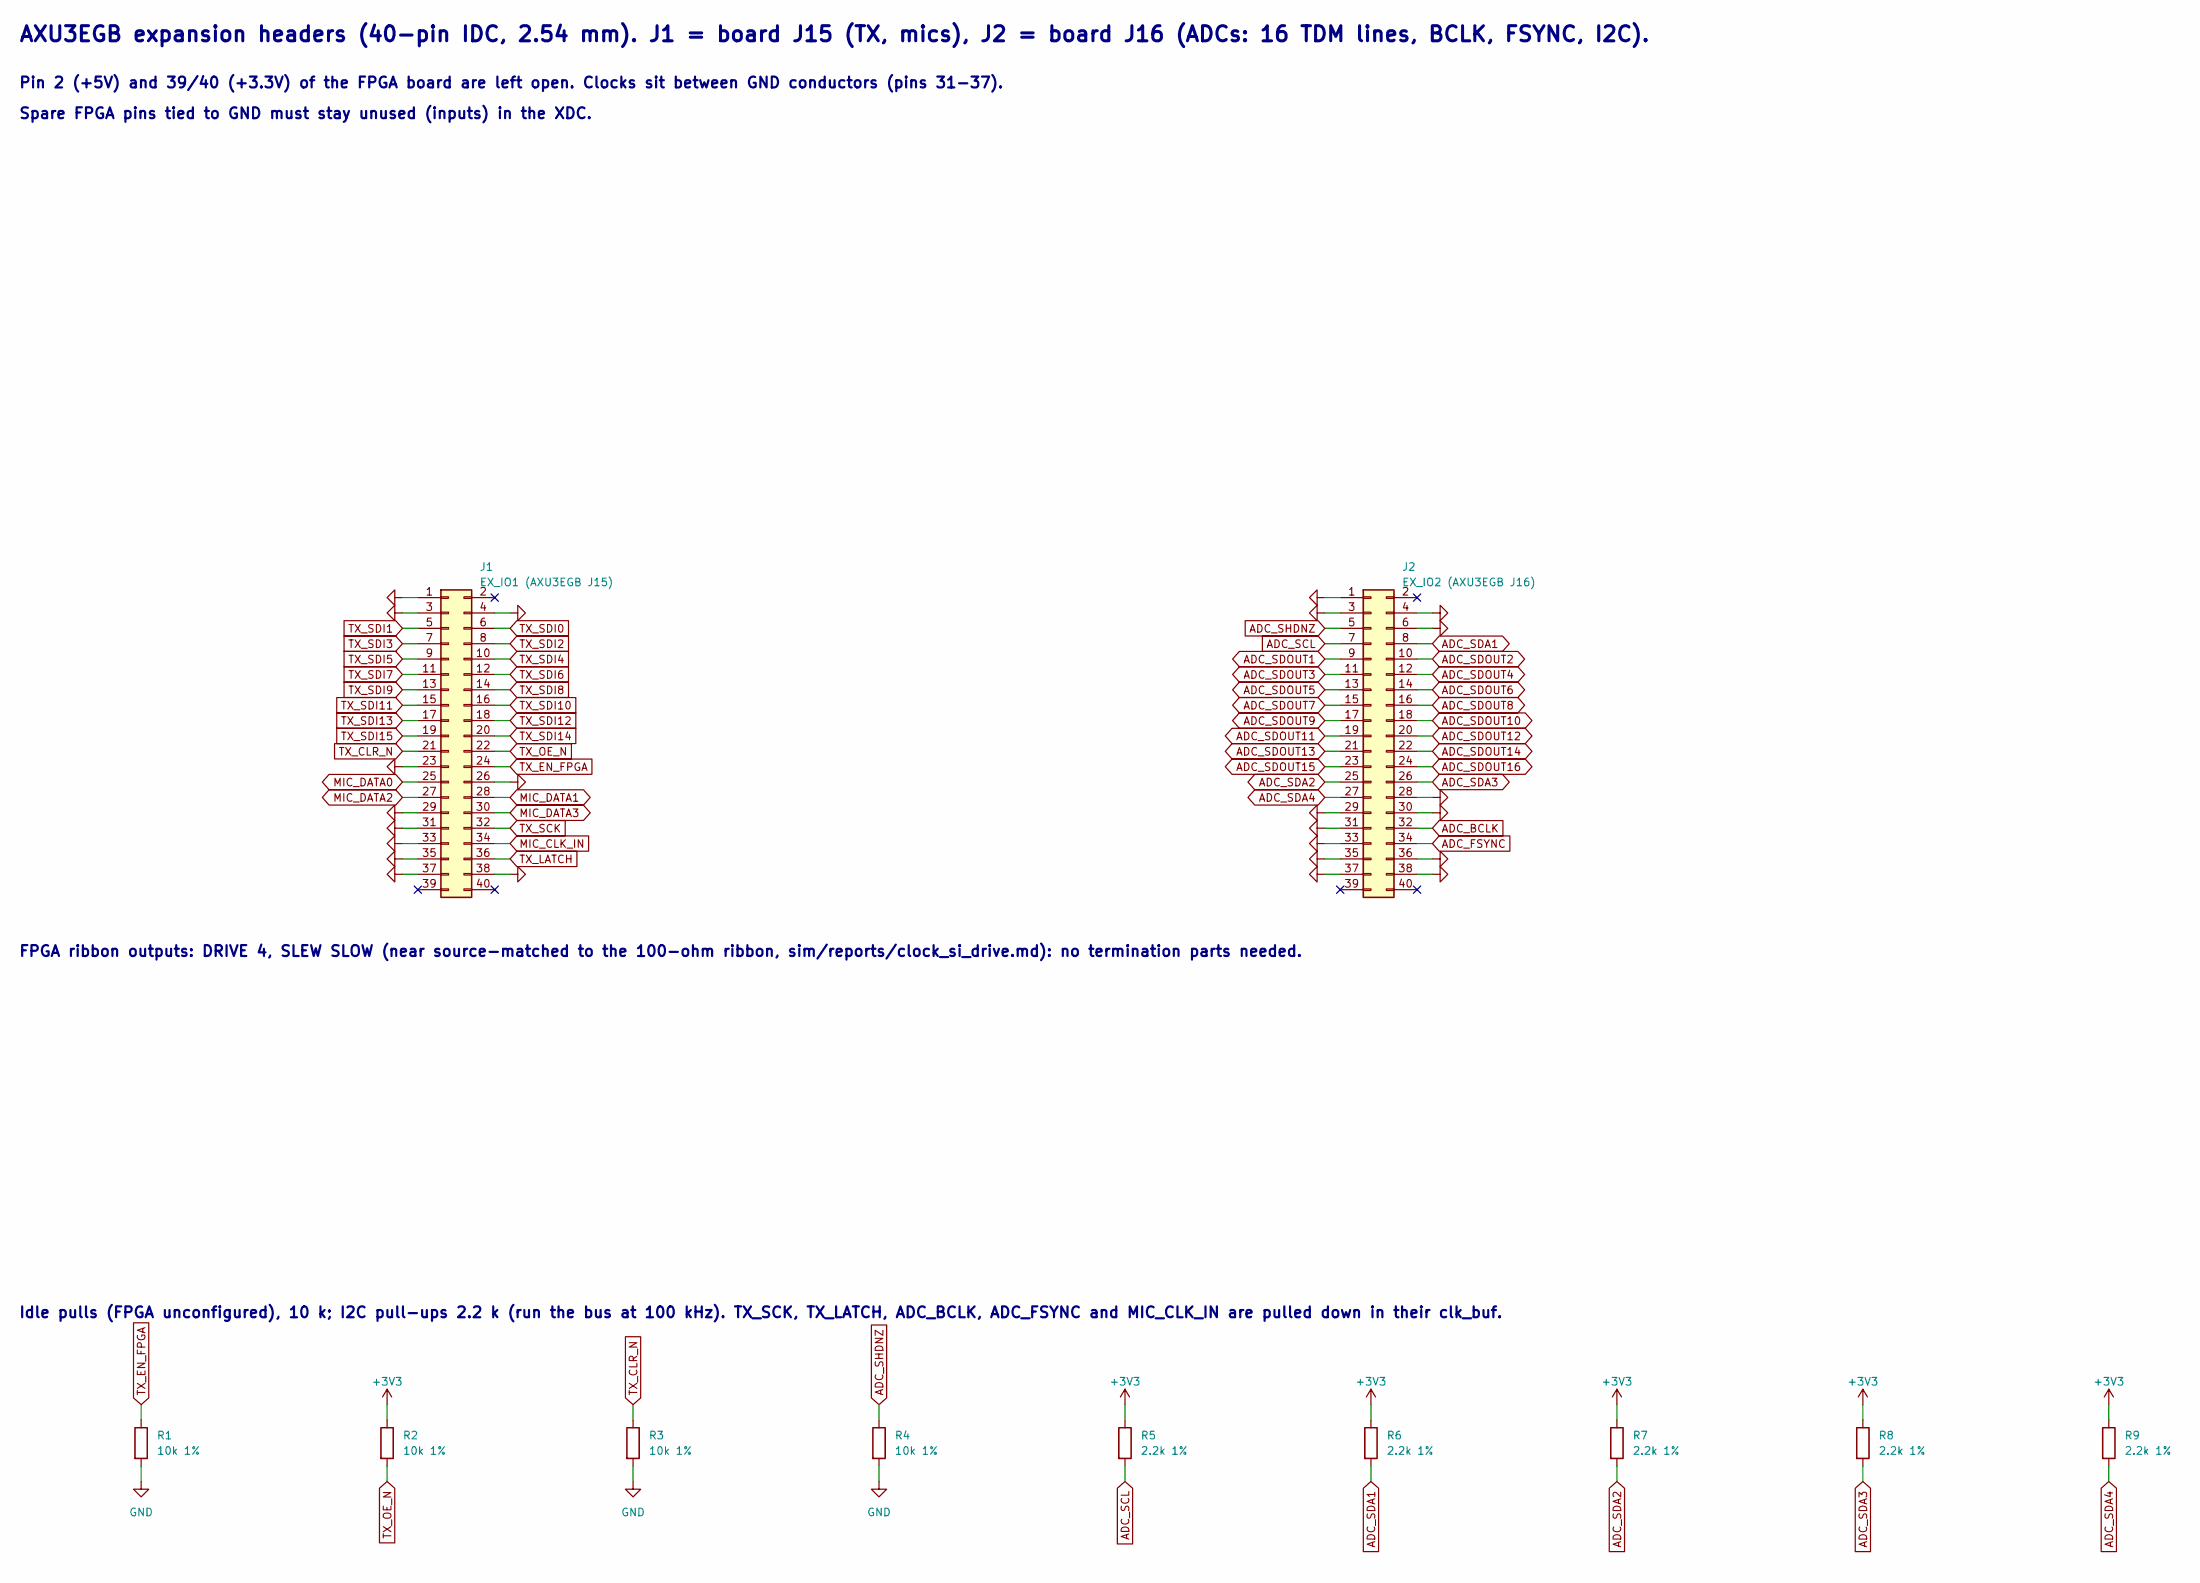
[picture p50: schematic headers.kicad_sch, AXU3EGB headers J15/J16, idle pulls]

Parts:
J1: EX_IO1 (AXU3EGB J15); IDC-Header_2x20_P2.54mm_Vertical; LCSC C19193815
J2: EX_IO2 (AXU3EGB J16); IDC-Header_2x20_P2.54mm_Vertical; LCSC C19193815
R1, R2, R3, R4: 10k 1%; R_0603_1608Metric; LCSC C25804
R5, R6, R7, R8, R9: 2.2k 1%; R_0603_1608Metric; LCSC C4190

Parts of its further copies:
J9901: EX_IO1 (AXU3EGB J15); IDC-Header_2x20_P2.54mm_Vertical; LCSC C19193815
J9902: EX_IO2 (AXU3EGB J16); IDC-Header_2x20_P2.54mm_Vertical; LCSC C19193815
R9901, R9902, R9903, R9904: 10k 1%; R_0603_1608Metric; LCSC C25804
R9905, R9906, R9907, R9908, R9909: 2.2k 1%; R_0603_1608Metric; LCSC C4190

Connections of its further copies:
+3V3: R9902.1, R9905.1, R9906.1, R9907.1, R9908.1, R9909.1; also elsewhere on the board
ADC_BCLK: J9902.32; also elsewhere on the board
ADC_FSYNC: J9902.34; also elsewhere on the board
ADC_SCL: J9902.7, R9905.2; also elsewhere on the board
ADC_SDA1: J9902.8, R9906.2; also elsewhere on the board
ADC_SDA2: J9902.25, R9907.2; also elsewhere on the board
ADC_SDA3: J9902.26, R9908.2; also elsewhere on the board
ADC_SDA4: J9902.27, R9909.2; also elsewhere on the board
ADC_SDOUT1: J9902.9; also elsewhere on the board
ADC_SDOUT2: J9902.10; also elsewhere on the board
ADC_SDOUT3: J9902.11; also elsewhere on the board
ADC_SDOUT4: J9902.12; also elsewhere on the board
ADC_SDOUT5: J9902.13; also elsewhere on the board
ADC_SDOUT6: J9902.14; also elsewhere on the board
ADC_SDOUT7: J9902.15; also elsewhere on the board
ADC_SDOUT8: J9902.16; also elsewhere on the board
ADC_SDOUT9: J9902.17; also elsewhere on the board
ADC_SDOUT10: J9902.18; also elsewhere on the board
ADC_SDOUT11: J9902.19; also elsewhere on the board
ADC_SDOUT12: J9902.20; also elsewhere on the board
ADC_SDOUT13: J9902.21; also elsewhere on the board
ADC_SDOUT14: J9902.22; also elsewhere on the board
ADC_SDOUT15: J9902.23; also elsewhere on the board
ADC_SDOUT16: J9902.24; also elsewhere on the board
ADC_SHDNZ: J9902.5, R9904.1; also elsewhere on the board
GND: J9901.1, J9901.3, J9901.4, J9901.23, J9901.26, J9901.29, J9901.31, J9901.33, J9901.35, J9901.37, J9901.38, J9902.1, J9902.3, J9902.4, J9902.6, J9902.28, J9902.29, J9902.30, J9902.31, J9902.33, J9902.35, J9902.36, J9902.37, J9902.38, R9901.2, R9903.2, R9904.2; also elsewhere on the board
MIC_CLK_IN: J9901.34; also elsewhere on the board
MIC_DATA0: J9901.25; also elsewhere on the board
MIC_DATA1: J9901.28; also elsewhere on the board
MIC_DATA2: J9901.27; also elsewhere on the board
MIC_DATA3: J9901.30; also elsewhere on the board
TX_CLR_N: J9901.21, R9903.1; also elsewhere on the board
TX_EN_FPGA: J9901.24, R9901.1; also elsewhere on the board
TX_LATCH: J9901.36; also elsewhere on the board
TX_OE_N: J9901.22, R9902.2; also elsewhere on the board
TX_SCK: J9901.32; also elsewhere on the board
TX_SDI0: J9901.6; also elsewhere on the board
TX_SDI1: J9901.5; also elsewhere on the board
TX_SDI2: J9901.8; also elsewhere on the board
TX_SDI3: J9901.7; also elsewhere on the board
TX_SDI4: J9901.10; also elsewhere on the board
TX_SDI5: J9901.9; also elsewhere on the board
TX_SDI6: J9901.12; also elsewhere on the board
TX_SDI7: J9901.11; also elsewhere on the board
TX_SDI8: J9901.14; also elsewhere on the board
TX_SDI9: J9901.13; also elsewhere on the board
TX_SDI10: J9901.16; also elsewhere on the board
TX_SDI11: J9901.15; also elsewhere on the board
TX_SDI12: J9901.18; also elsewhere on the board
TX_SDI13: J9901.17; also elsewhere on the board
TX_SDI14: J9901.20; also elsewhere on the board
TX_SDI15: J9901.19; also elsewhere on the board

Notes on the sheet:
Idle pulls (FPGA unconfigured), 10 k; I2C pull-ups 2.2 k (run the bus at 100 kHz). TX_SCK, TX_LATCH, ADC_BCLK, ADC_FSYNC and MIC_CLK_IN are pulled down in their clk_buf.
Pin 2 (+5V) and 39/40 (+3.3V) of the FPGA board are left open. Clocks sit between GND conductors (pins 31-37).
Spare FPGA pins tied to GND must stay unused (inputs) in the XDC.
AXU3EGB expansion headers (40-pin IDC, 2.54 mm). J1 = board J15 (TX, mics), J2 = board J16 (ADCs: 16 TDM lines, BCLK, FSYNC, I2C).
FPGA ribbon outputs: DRIVE 4, SLEW SLOW (near source-matched to the 100-ohm ribbon, sim/reports/clock_si_drive.md): no termination parts needed.

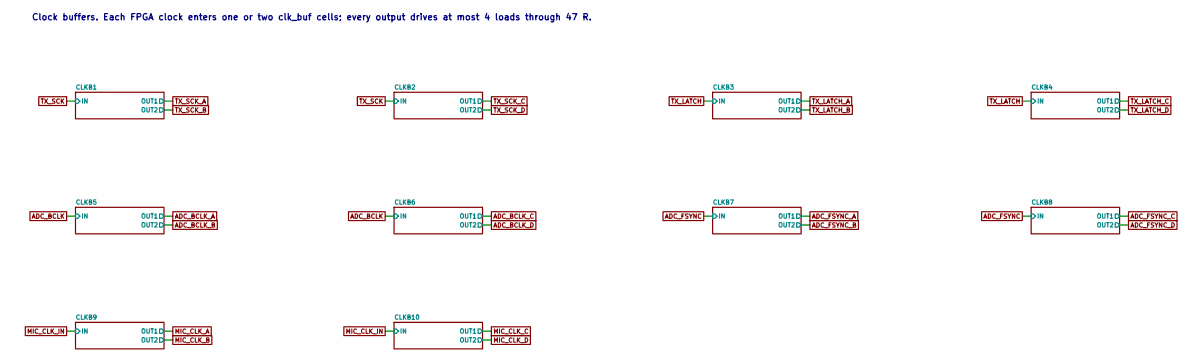
[picture p51: schematic clocks.kicad_sch, Clock buffers: 10 x 74LVC2G34]

Notes on the sheet:
Clock buffers. Each FPGA clock enters one or two clk_buf cells; every output drives at most 4 loads through 47 R.

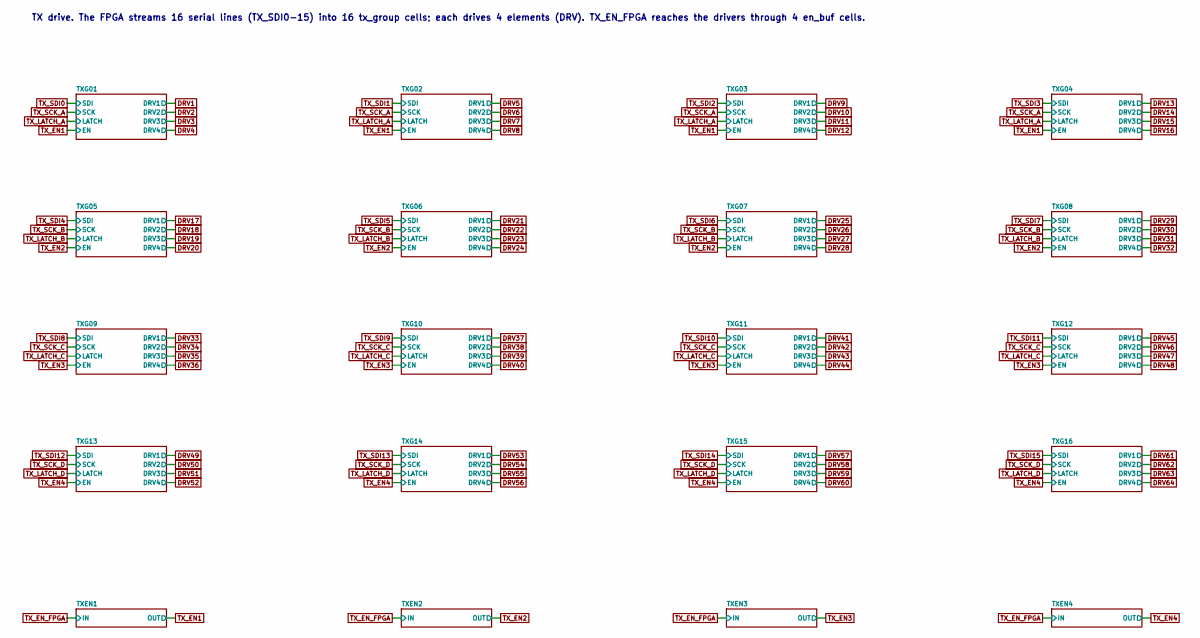
[picture p52: schematic tx.kicad_sch, TX drive: 16 shift-register/driver groups, 4 enable buffers]

Notes on the sheet:
TX drive. The FPGA streams 16 serial lines (TX_SDI0-15) into 16 tx_group cells; each drives 4 elements (DRV). TX_EN_FPGA reaches the drivers through 4 en_buf cells.

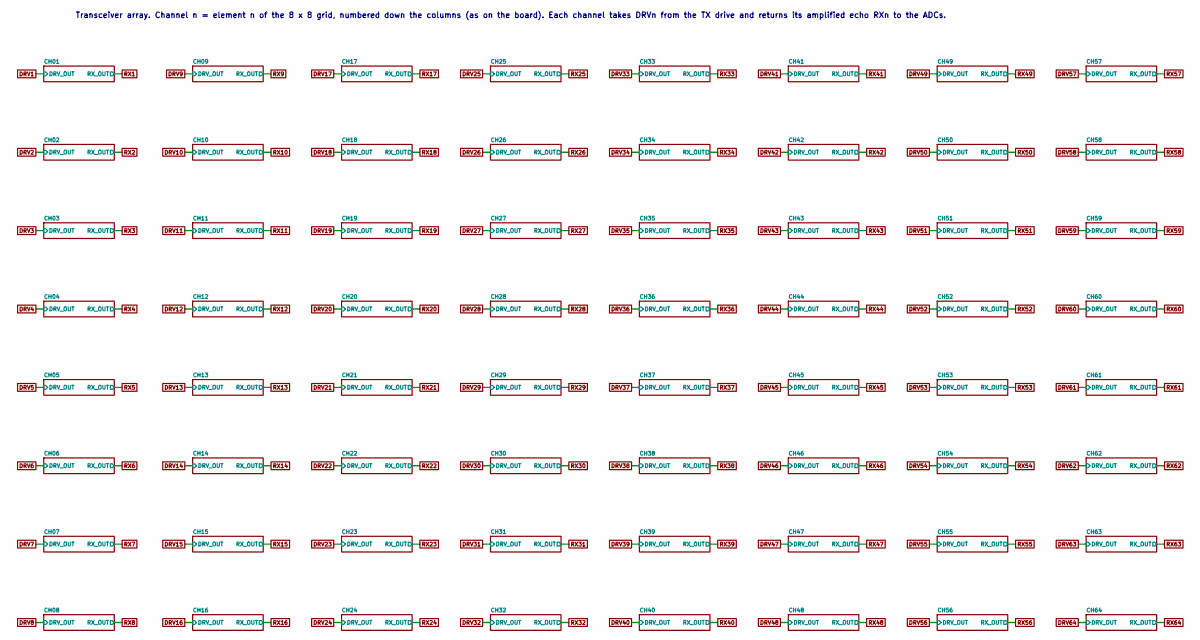
[picture p53: schematic array.kicad_sch, Transceivers: 64 channels (8 x 8 grid)]

Notes on the sheet:
Transceiver array. Channel n = element n of the 8 x 8 grid, numbered down the columns (as on the board). Each channel takes DRVn from the TX drive and returns its amplified echo RXn to the ADCs.

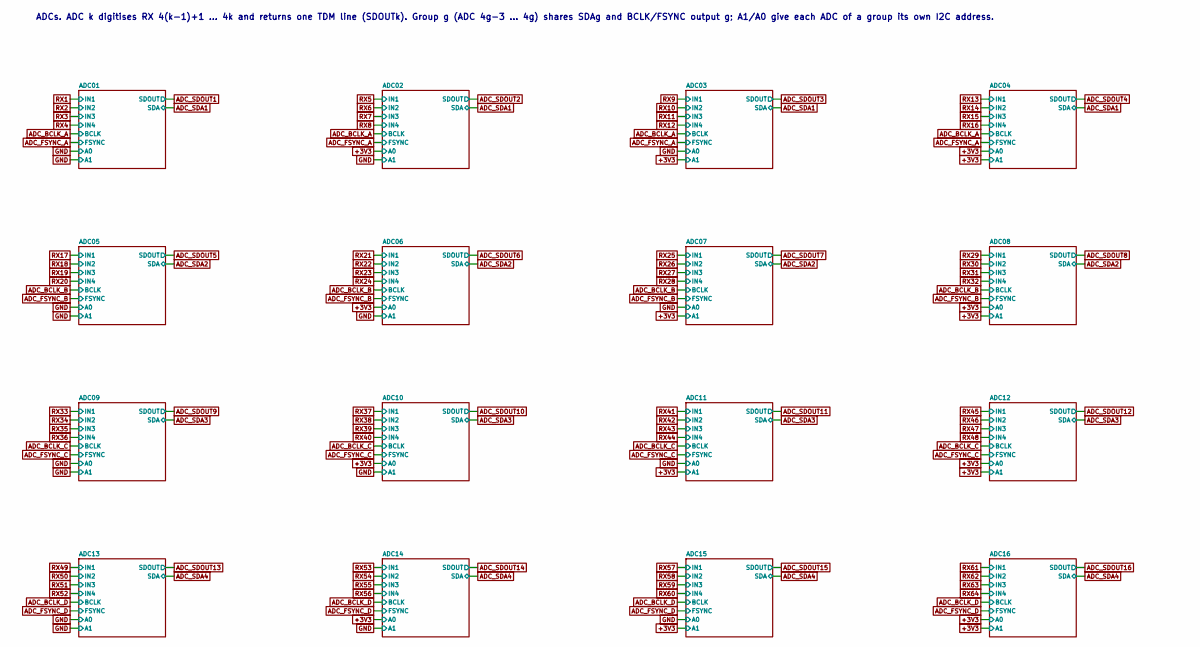
[picture p54: schematic adcs.kicad_sch, ADCs: 16 x TLV320ADC5140 (4 channels each)]

Notes on the sheet:
ADCs. ADC k digitises RX 4(k-1)+1 ... 4k and returns one TDM line (SDOUTk). Group g (ADC 4g-3 ... 4g) shares SDAg and BCLK/FSYNC output g; A1/A0 give each ADC of a group its own I2C address.

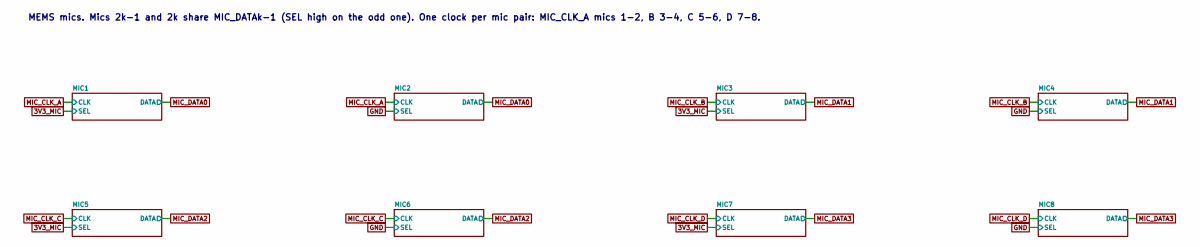
[picture p55: schematic mics.kicad_sch, MEMS microphones: 8 x SPH0641LU4H-1]

Notes on the sheet:
MEMS mics. Mics 2k-1 and 2k share MIC_DATAk-1 (SEL high on the odd one). One clock per mic pair: MIC_CLK_A mics 1-2, B 3-4, C 5-6, D 7-8.

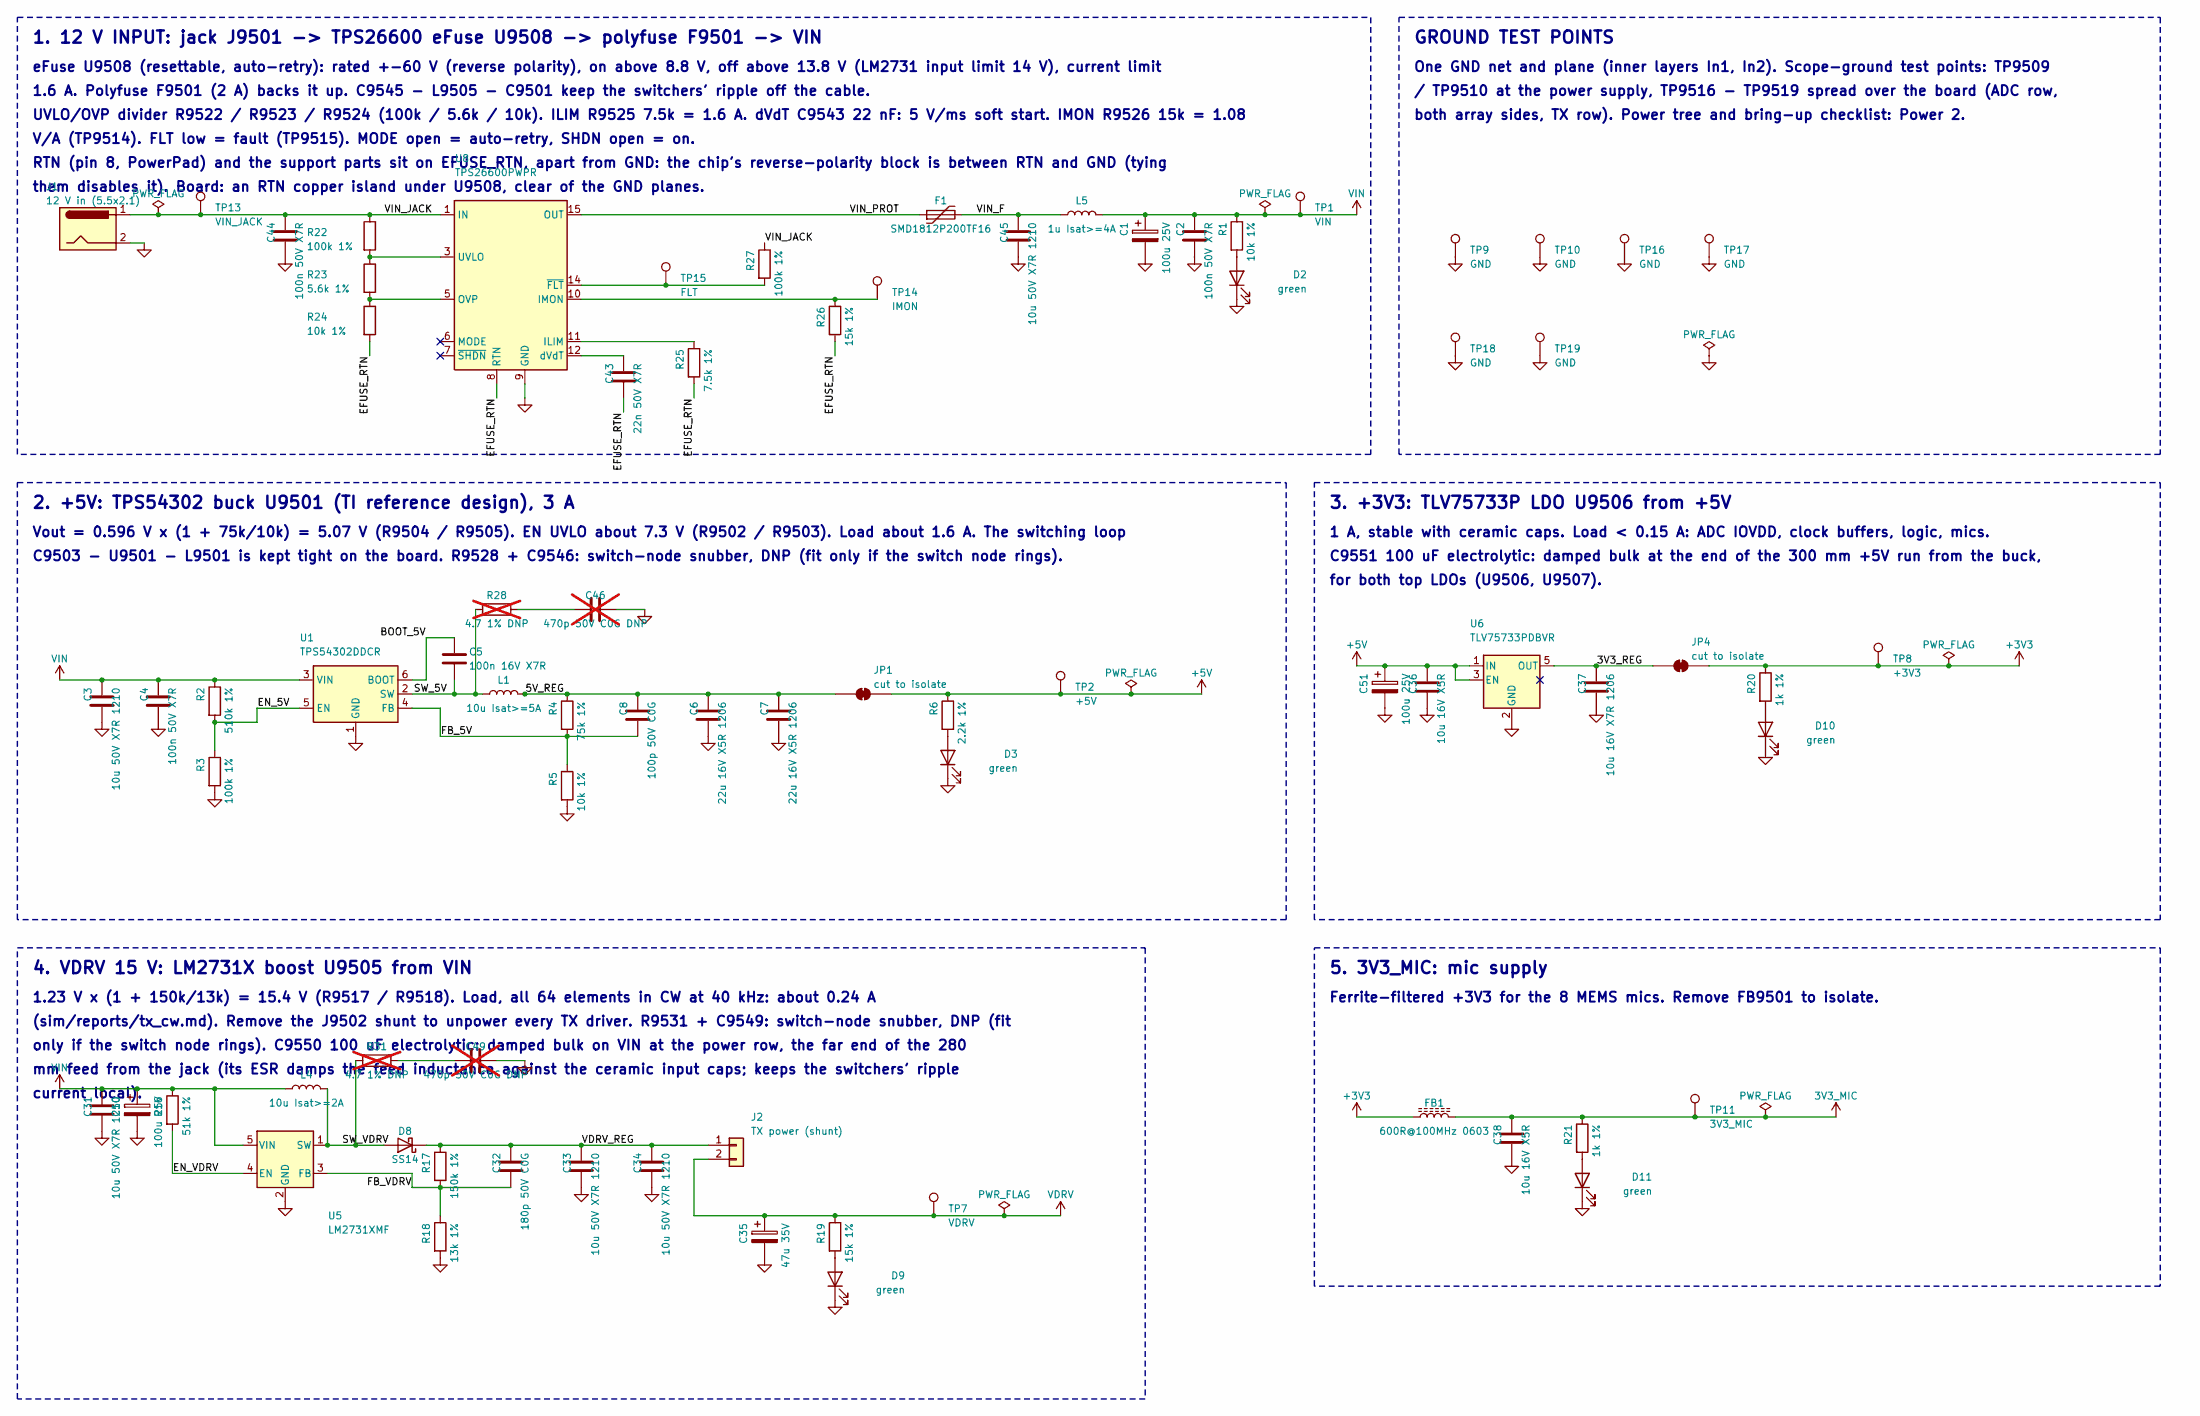
[picture p56: schematic power.kicad_sch, Power 1: 12 V input, +5V, VDRV (TX), +3V3, 3V3_MIC]

Parts:
C1, C50, C51: 100u 25V; CP_Elec_8x10; LCSC C294509
C2, C4, C44: 100n 50V X7R; C_0603_1608Metric; LCSC C14663
C3, C31, C33, C34, C45: 10u 50V X7R 1210; C_1210_3225Metric; LCSC C525507
C5: 100n 16V X7R; C_0603_1608Metric; LCSC C14663
C6, C7: 22u 16V X5R 1206; C_1206_3216Metric; LCSC C12891
C8: 100p 50V C0G; C_0603_1608Metric; LCSC C14858
C32: 180p 50V C0G; C_0603_1608Metric; LCSC C376771
C35: 47u 35V; CP_Elec_6.3x7.7; LCSC C970679
C36, C38: 10u 16V X5R; C_0805_2012Metric; LCSC C15850
C37: 10u 16V X7R 1206; C_1206_3216Metric; LCSC C380363
C43: 22n 50V X7R; C_0603_1608Metric; LCSC C21122
C46, C49: 470p 50V C0G DNP; C_0603_1608Metric; LCSC C376788 (DNP); not fitted
D2, D3, D9, D10, D11: green; LED_0603_1608Metric; LCSC C12624
D8: SS14; D_SMA; LCSC C2480
F1: SMD1812P200TF16; Fuse_1812_4532Metric; LCSC C20812
FB1: 600R@100MHz 0603; L_0603_1608Metric; LCSC C1002
J1: 12 V in (5.5x2.1); BarrelJack_CUI_PJ-063AH_Horizontal; LCSC C22434582
J2: TX power (shunt); PinHeader_1x02_P2.54mm_Vertical; LCSC C492401
JP1, JP4: cut to isolate; SolderJumper-2_P1.3mm_Bridged_RoundedPad1.0x1.5mm; LCSC none (copper)
L1: 10u Isat>=5A; L_Bourns_SRN8040TA; LCSC C2044906
L4: 10u Isat>=2A; L_Sunlord_SWPA6045S; LCSC C79272
L5: 1u Isat>=4A; L_Sunlord_SWPA4030S; LCSC C42193
R1, R5, R24: 10k 1%; R_0603_1608Metric; LCSC C25804
R2: 510k 1%; R_0603_1608Metric; LCSC C23192
R3, R22, R27: 100k 1%; R_0603_1608Metric; LCSC C25803
R4: 75k 1%; R_0603_1608Metric; LCSC C23242
R6: 2.2k 1%; R_0603_1608Metric; LCSC C4190
R16: 51k 1%; R_0603_1608Metric; LCSC C23196
R17: 150k 1%; R_0603_1608Metric; LCSC C22807
R18: 13k 1%; R_0603_1608Metric; LCSC C22797
R19, R26: 15k 1%; R_0603_1608Metric; LCSC C22809
R20, R21: 1k 1%; R_0603_1608Metric; LCSC C21190
R23: 5.6k 1%; R_0603_1608Metric; LCSC C23189
R25: 7.5k 1%; R_0603_1608Metric; LCSC C23234
R28, R31: 4.7 1% DNP; R_0603_1608Metric; LCSC C23164 (DNP); not fitted
TP1: VIN; TestPoint_Pad_D1.5mm; LCSC none (copper)
TP2: +5V; TestPoint_Pad_D1.5mm; LCSC none (copper)
TP7: VDRV; TestPoint_Pad_D1.5mm; LCSC none (copper)
TP8: +3V3; TestPoint_Pad_D1.5mm; LCSC none (copper)
TP9, TP10, TP16, TP17, TP18, TP19: GND; TestPoint_Pad_D1.5mm; LCSC none (copper)
TP11: 3V3_MIC; TestPoint_Pad_D1.5mm; LCSC none (copper)
TP13: VIN_JACK; TestPoint_Pad_D1.5mm; LCSC none (copper)
TP14: IMON; TestPoint_Pad_D1.5mm; LCSC none (copper)
TP15: FLT; TestPoint_Pad_D1.5mm; LCSC none (copper)
U1: TPS54302DDCR; SOT-23-6; LCSC C311983
U5: LM2731XMF; SOT-23-5; LCSC C485804
U6: TLV75733PDBVR; SOT-23-5; LCSC C485517
U8: TPS26600PWPR; HTSSOP-16-1EP_4.4x5mm_P0.65mm_EP3.4x5mm_Mask2.66x2.46mm_The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; LCSC C544399

Parts of its further copies:
C9501, C9550, C9551: 100u 25V; CP_Elec_8x10; LCSC C294509
C9502, C9504, C9544: 100n 50V X7R; C_0603_1608Metric; LCSC C14663
C9503, C9531, C9533, C9534, C9545: 10u 50V X7R 1210; C_1210_3225Metric; LCSC C525507
C9505: 100n 16V X7R; C_0603_1608Metric; LCSC C14663
C9506, C9507: 22u 16V X5R 1206; C_1206_3216Metric; LCSC C12891
C9508: 100p 50V C0G; C_0603_1608Metric; LCSC C14858
C9532: 180p 50V C0G; C_0603_1608Metric; LCSC C376771
C9535: 47u 35V; CP_Elec_6.3x7.7; LCSC C970679
C9536, C9538: 10u 16V X5R; C_0805_2012Metric; LCSC C15850
C9537: 10u 16V X7R 1206; C_1206_3216Metric; LCSC C380363
C9543: 22n 50V X7R; C_0603_1608Metric; LCSC C21122
C9546, C9549: 470p 50V C0G DNP; C_0603_1608Metric; LCSC C376788 (DNP); not fitted
D9502, D9503, D9509, D9510, D9511: green; LED_0603_1608Metric; LCSC C12624
D9508: SS14; D_SMA; LCSC C2480
F9501: SMD1812P200TF16; Fuse_1812_4532Metric; LCSC C20812
FB9501: 600R@100MHz 0603; L_0603_1608Metric; LCSC C1002
J9501: 12 V in (5.5x2.1); BarrelJack_CUI_PJ-063AH_Horizontal; LCSC C22434582
J9502: TX power (shunt); PinHeader_1x02_P2.54mm_Vertical; LCSC C492401
JP9501, JP9504: cut to isolate; SolderJumper-2_P1.3mm_Bridged_RoundedPad1.0x1.5mm; LCSC none (copper)
L9501: 10u Isat>=5A; L_Bourns_SRN8040TA; LCSC C2044906
L9504: 10u Isat>=2A; L_Sunlord_SWPA6045S; LCSC C79272
L9505: 1u Isat>=4A; L_Sunlord_SWPA4030S; LCSC C42193
R9501, R9505, R9524: 10k 1%; R_0603_1608Metric; LCSC C25804
R9502: 510k 1%; R_0603_1608Metric; LCSC C23192
R9503, R9522, R9527: 100k 1%; R_0603_1608Metric; LCSC C25803
R9504: 75k 1%; R_0603_1608Metric; LCSC C23242
R9506: 2.2k 1%; R_0603_1608Metric; LCSC C4190
R9516: 51k 1%; R_0603_1608Metric; LCSC C23196
R9517: 150k 1%; R_0603_1608Metric; LCSC C22807
R9518: 13k 1%; R_0603_1608Metric; LCSC C22797
R9519, R9526: 15k 1%; R_0603_1608Metric; LCSC C22809
R9520, R9521: 1k 1%; R_0603_1608Metric; LCSC C21190
R9523: 5.6k 1%; R_0603_1608Metric; LCSC C23189
R9525: 7.5k 1%; R_0603_1608Metric; LCSC C23234
R9528, R9531: 4.7 1% DNP; R_0603_1608Metric; LCSC C23164 (DNP); not fitted
TP9501: VIN; TestPoint_Pad_D1.5mm; LCSC none (copper)
TP9502: +5V; TestPoint_Pad_D1.5mm; LCSC none (copper)
TP9507: VDRV; TestPoint_Pad_D1.5mm; LCSC none (copper)
TP9508: +3V3; TestPoint_Pad_D1.5mm; LCSC none (copper)
TP9509, TP9510, TP9516, TP9517, TP9518, TP9519: GND; TestPoint_Pad_D1.5mm; LCSC none (copper)
TP9511: 3V3_MIC; TestPoint_Pad_D1.5mm; LCSC none (copper)
TP9513: VIN_JACK; TestPoint_Pad_D1.5mm; LCSC none (copper)
TP9514: IMON; TestPoint_Pad_D1.5mm; LCSC none (copper)
TP9515: FLT; TestPoint_Pad_D1.5mm; LCSC none (copper)
U9501: TPS54302DDCR; SOT-23-6; LCSC C311983
U9505: LM2731XMF; SOT-23-5; LCSC C485804
U9506: TLV75733PDBVR; SOT-23-5; LCSC C485517
U9508: TPS26600PWPR; HTSSOP-16-1EP_4.4x5mm_P0.65mm_EP3.4x5mm_Mask2.66x2.46mm_The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; LCSC C544399

Connections of its further copies:
3V3_MIC: C9538.1, FB9501.2, R9521.1, TP9511.1; also elsewhere on the board
+3V3: FB9501.1, JP9504.2 (B), R9520.1, TP9508.1; also elsewhere on the board
+5V: C9536.1, C9551.1, JP9501.2 (B), R9506.1, TP9502.1, U9506.1 (IN), U9506.3 (EN); also elsewhere on the board
/Power 1/3V3_REG: C9537.1, JP9504.1 (A), U9506.5 (OUT)
/Power 1/5V_REG: C9506.1, C9507.1, C9508.1, JP9501.1 (A), L9501.2, R9504.1
/Power 1/BOOT_5V: C9505.1, U9501.6 (BOOT)
/Power 1/EFUSE_RTN: C9543.2, R9524.2, R9525.2, R9526.2, U9508.8 (RTN), U9508.17 (RTN)
/Power 1/EN_5V: R9502.2, R9503.1, U9501.5 (EN)
/Power 1/EN_VDRV: R9516.2, U9505.4 (EN)
/Power 1/FB_5V: C9508.2, R9504.2, R9505.1, U9501.4 (FB)
/Power 1/FB_VDRV: C9532.2, R9517.2, R9518.1, U9505.3 (FB)
/Power 1/SW_5V: C9505.2, L9501.1, R9528.1, U9501.2 (SW)
/Power 1/SW_VDRV: D9508.2 (A), L9504.2, R9531.1, U9505.1 (SW)
/Power 1/VDRV_REG: C9532.1, C9533.1, C9534.1, D9508.1 (K), J9502.1, R9517.1
/Power 1/VIN_F: C9545.1, F9501.2, L9505.1
/Power 1/VIN_JACK: C9544.1, J9501.1, R9522.1, R9527.1, TP9513.1, U9508.1 (IN), U9508.2 (IN)
/Power 1/VIN_PROT: F9501.1, U9508.15 (OUT), U9508.16 (OUT)
GND: C9501.2, C9502.2, C9503.2, C9504.2, C9506.2, C9507.2, C9531.2, C9533.2, C9534.2, C9535.2, C9536.2, C9537.2, C9538.2, C9544.2, C9545.2, C9546.2, C9549.2, C9550.2, C9551.2, D9502.1 (K), D9503.1 (K), D9509.1 (K), D9510.1 (K), D9511.1 (K), J9501.2, R9503.2, R9505.2, R9518.2, TP9509.1, TP9510.1, TP9516.1, TP9517.1, TP9518.1, TP9519.1, U9501.1 (GND), U9505.2 (GND), U9506.2 (GND), U9508.9 (GND); also elsewhere on the board
unnamed: C9546.1, R9528.2
unnamed: C9549.1, R9531.2
unnamed: D9502.2 (A), R9501.2
unnamed: D9503.2 (A), R9506.2
unnamed: D9509.2 (A), R9519.2
unnamed: D9510.2 (A), R9520.2
unnamed: D9511.2 (A), R9521.2
unnamed: R9525.1, U9508.11 (ILIM)
unnamed: R9526.1, TP9514.1, U9508.10 (IMON)
unnamed: R9523.2, R9524.1, U9508.5 (OVP)
unnamed: R9522.2, R9523.1, U9508.3 (UVLO)
unnamed: C9543.1, U9508.12 (dVdT)
unnamed: R9527.2, TP9515.1, U9508.14 (~FLT)
VDRV: C9535.1, J9502.2, R9519.1, TP9507.1; also elsewhere on the board
VIN: C9501.1, C9502.1, C9503.1, C9504.1, C9531.1, C9550.1, L9504.1, L9505.2, R9501.1, R9502.1, R9516.1, TP9501.1, U9501.3 (VIN), U9505.5 (VIN)

Notes on the sheet:
RTN (pin 8, PowerPad) and the support parts sit on EFUSE_RTN, apart from GND: the chip's reverse-polarity block is between RTN and GND (tying
1.23 V x (1 + 150k/13k) = 15.4 V (R9517 / R9518). Load, all 64 elements in CW at 40 kHz: about 0.24 A
One GND net and plane (inner layers In1, In2). Scope-ground test points: TP9509
(sim/reports/tx_cw.md). Remove the J9502 shunt to unpower every TX driver. R9531 + C9549: switch-node snubber, DNP (fit
for both top LDOs (U9506, U9507).
V/A (TP9514). FLT low = fault (TP9515). MODE open = auto-retry, SHDN open = on.
/ TP9510 at the power supply, TP9516 - TP9519 spread over the board (ADC row,
4. VDRV 15 V: LM2731X boost U9505 from VIN
both array sides, TX row). Power tree and bring-up checklist: Power 2.
current local).
them disables it). Board: an RTN copper island under U9508, clear of the GND planes.
only if the switch node rings). C9550 100 uF electrolytic: damped bulk on VIN at the power row, the far end of the 280
1 A, stable with ceramic caps. Load < 0.15 A: ADC IOVDD, clock buffers, logic, mics.
C9551 100 uF electrolytic: damped bulk at the end of the 300 mm +5V run from the buck,
eFuse U9508 (resettable, auto-retry): rated +-60 V (reverse polarity), on above 8.8 V, off above 13.8 V (LM2731 input limit 14 V), current limit
1.6 A. Polyfuse F9501 (2 A) backs it up. C9545 - L9505 - C9501 keep the switchers' ripple off the cable.
UVLO/OVP divider R9522 / R9523 / R9524 (100k / 5.6k / 10k). ILIM R9525 7.5k = 1.6 A. dVdT C9543 22 nF: 5 V/ms soft start. IMON R9526 15k = 1.08
2. +5V: TPS54302 buck U9501 (TI reference design), 3 A
1. 12 V INPUT: jack J9501 -> TPS26600 eFuse U9508 -> polyfuse F9501 -> VIN
mm feed from the jack (its ESR damps the feed inductance against the ceramic input caps; keeps the switchers' ripple
3. +3V3: TLV75733P LDO U9506 from +5V
Ferrite-filtered +3V3 for the 8 MEMS mics. Remove FB9501 to isolate.
GROUND TEST POINTS
C9503 - U9501 - L9501 is kept tight on the board. R9528 + C9546: switch-node snubber, DNP (fit only if the switch node rings).
5. 3V3_MIC: mic supply
Vout = 0.596 V x (1 + 75k/10k) = 5.07 V (R9504 / R9505). EN UVLO about 7.3 V (R9502 / R9503). Load about 1.6 A. The switching loop
