tieziyun/ultrasonic-aesa/kicad/aesa.kicad_pcb

## KiCad design kicad/aesa.kicad_pcb (continued)

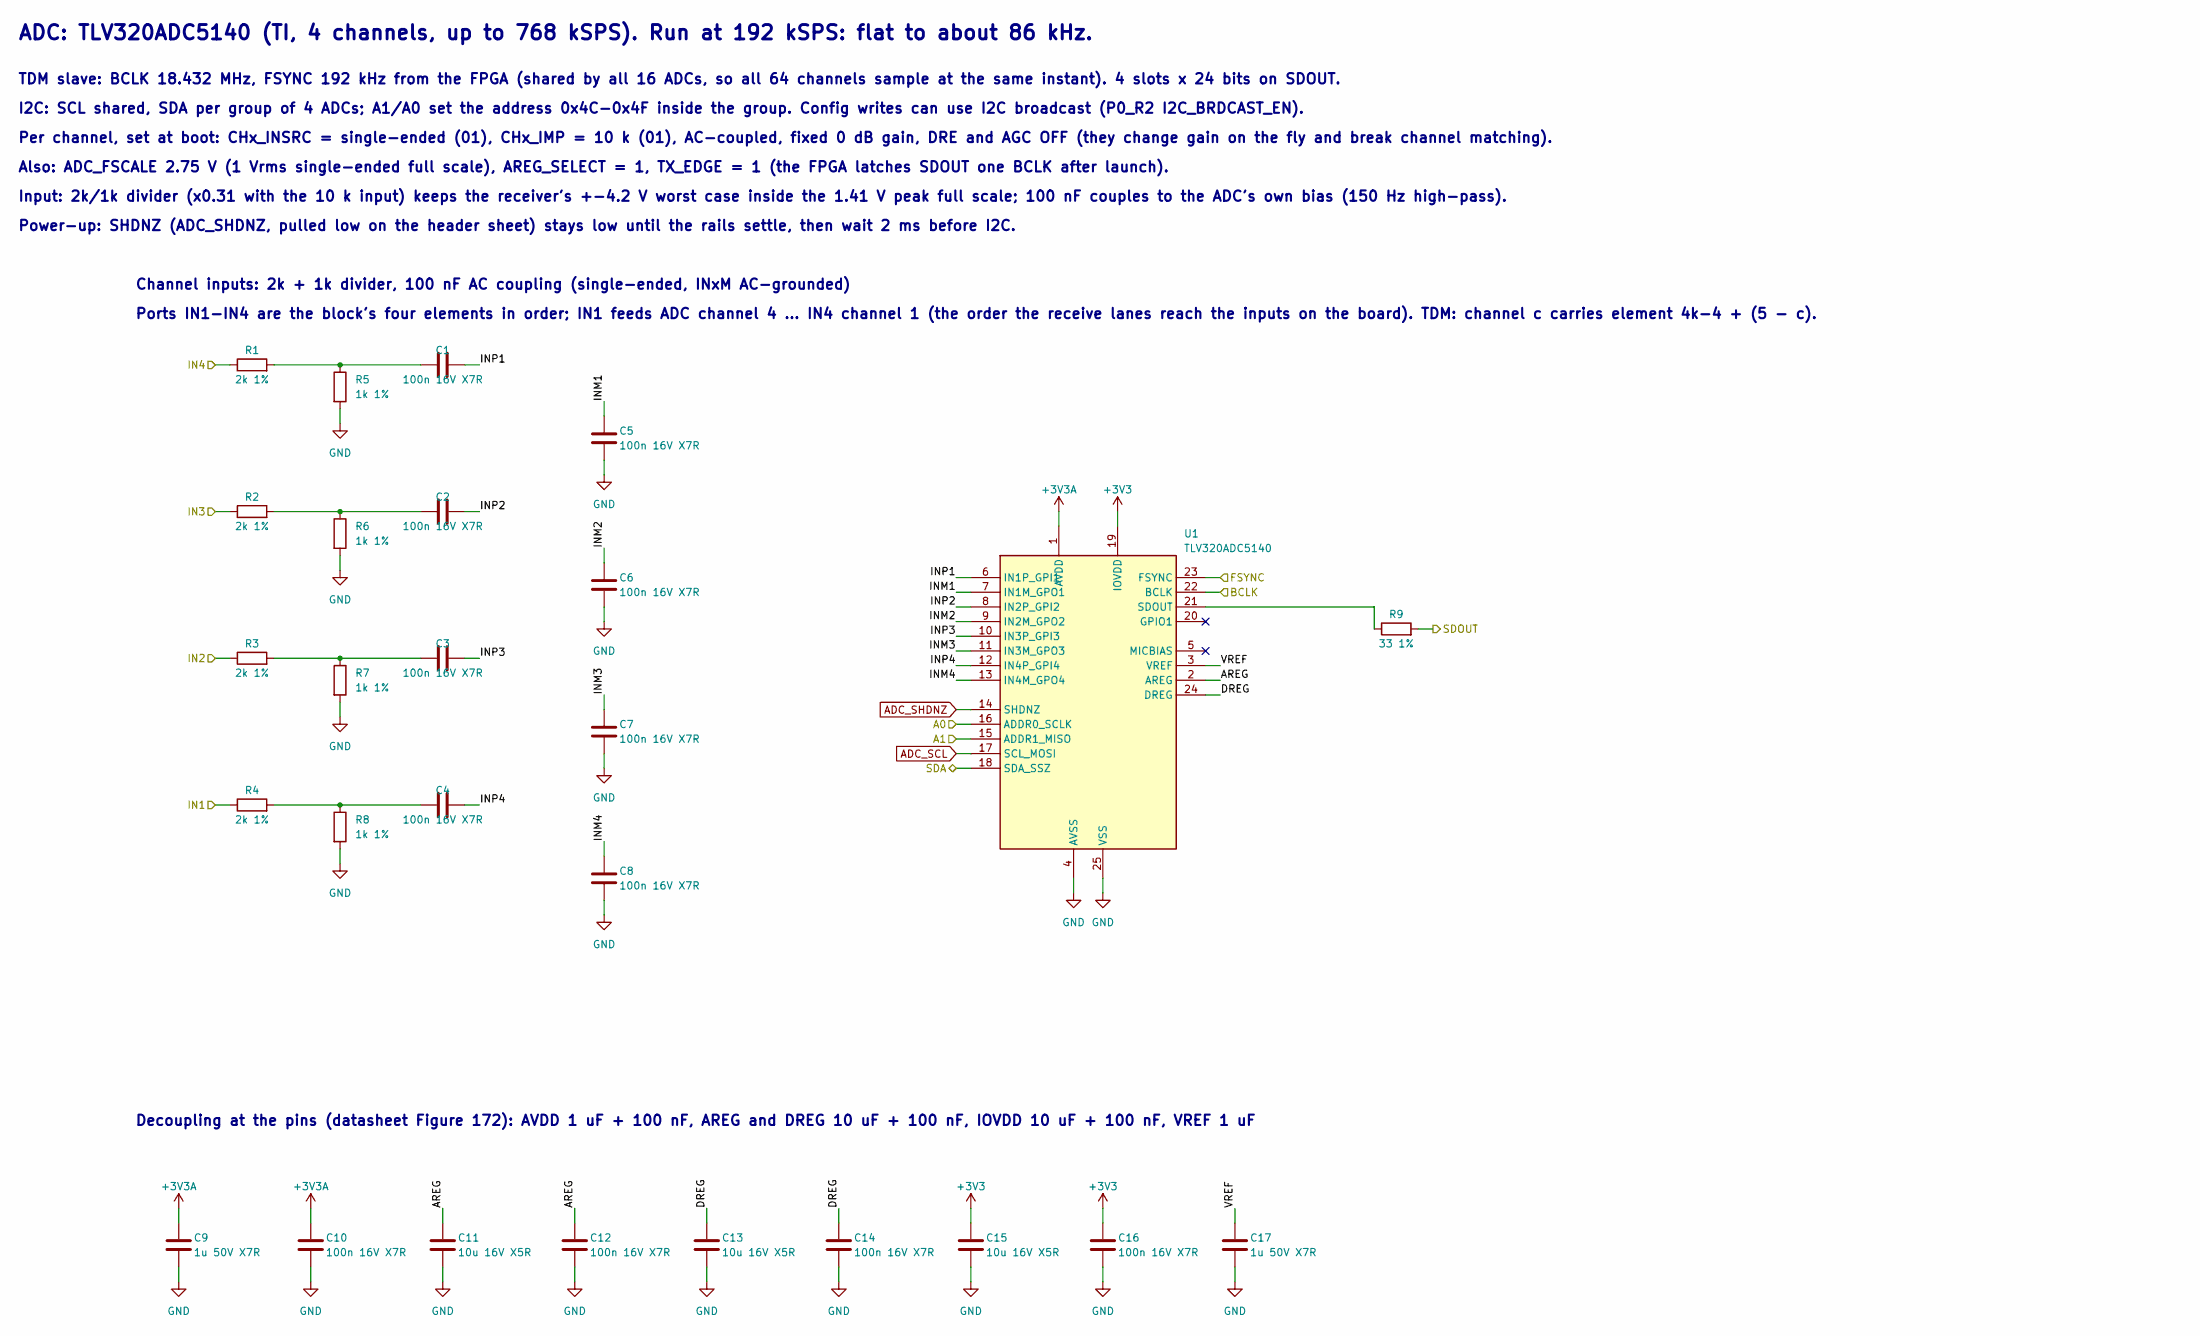
[picture p62: schematic adc.kicad_sch, ADC (x16): TLV320ADC5140, 4 channels, 192 kSPS TDM]

Parts:
C1, C2, C3, C4, C5, C6, C7, C8, C10, C12, C14, C16: 100n 16V X7R; C_0603_1608Metric; LCSC C14663
C9, C17: 1u 50V X7R; C_0805_2012Metric; LCSC C28323
C11, C13, C15: 10u 16V X5R; C_0805_2012Metric; LCSC C15850
R1, R2, R3, R4: 2k 1%; R_0603_1608Metric; LCSC C22975
R5, R6, R7, R8: 1k 1%; R_0603_1608Metric; LCSC C21190
R9: 33 1%; R_0603_1608Metric; LCSC C23140
U1: TLV320ADC5140; Texas_RTW_WQFN-24-1EP_4x4mm_P0.5mm_EP2.7x2.7mm_ThermalVias; LCSC C2876368

Parts of its further copies:
C7101, C7102, C7103, C7104, C7105, C7106, C7107, C7108, C7110, C7112, C7114, C7116, C7201, C7202, C7203, C7204, C7205, C7206, C7207, C7208, C7210, C7212, C7214, C7216, C7301, C7302, C7303, C7304, C7305, C7306, C7307, C7308, C7310, C7312, C7314, C7316, C7401, C7402, C7403, C7404, C7405, C7406, C7407, C7408, C7410, C7412, C7414, C7416, C7501, C7502, C7503, C7504, C7505, C7506, C7507, C7508, C7510, C7512, C7514, C7516, C7601, C7602, C7603, C7604, C7605, C7606, C7607, C7608, C7610, C7612, C7614, C7616, C7701, C7702, C7703, C7704, C7705, C7706, C7707, C7708, C7710, C7712, C7714, C7716, C7801, C7802, C7803, C7804, C7805, C7806, C7807, C7808, C7810, C7812, C7814, C7816, C7901, C7902, C7903, C7904, C7905, C7906, C7907, C7908, C7910, C7912, C7914, C7916, C8001, C8002, C8003, C8004, C8005, C8006, C8007, C8008, C8010, C8012, C8014, C8016, C8101, C8102, C8103, C8104, C8105, C8106, C8107, C8108, C8110, C8112, C8114, C8116, C8201, C8202, C8203, C8204, C8205, C8206, C8207, C8208, C8210, C8212, C8214, C8216, C8301, C8302, C8303, C8304, C8305, C8306, C8307, C8308, C8310, C8312, C8314, C8316, C8401, C8402, C8403, C8404, C8405, C8406, C8407, C8408, C8410, C8412, C8414, C8416, C8501, C8502, C8503, C8504, C8505, C8506, C8507, C8508, C8510, C8512, C8514, C8516, C8601, C8602, C8603, C8604, C8605, C8606, C8607, C8608, C8610, C8612, C8614, C8616: 100n 16V X7R; C_0603_1608Metric; LCSC C14663
C7109, C7117, C7209, C7217, C7309, C7317, C7409, C7417, C7509, C7517, C7609, C7617, C7709, C7717, C7809, C7817, C7909, C7917, C8009, C8017, C8109, C8117, C8209, C8217, C8309, C8317, C8409, C8417, C8509, C8517, C8609, C8617: 1u 50V X7R; C_0805_2012Metric; LCSC C28323
C7111, C7113, C7115, C7211, C7213, C7215, C7311, C7313, C7315, C7411, C7413, C7415, C7511, C7513, C7515, C7611, C7613, C7615, C7711, C7713, C7715, C7811, C7813, C7815, C7911, C7913, C7915, C8011, C8013, C8015, C8111, C8113, C8115, C8211, C8213, C8215, C8311, C8313, C8315, C8411, C8413, C8415, C8511, C8513, C8515, C8611, C8613, C8615: 10u 16V X5R; C_0805_2012Metric; LCSC C15850
R7101, R7102, R7103, R7104, R7201, R7202, R7203, R7204, R7301, R7302, R7303, R7304, R7401, R7402, R7403, R7404, R7501, R7502, R7503, R7504, R7601, R7602, R7603, R7604, R7701, R7702, R7703, R7704, R7801, R7802, R7803, R7804, R7901, R7902, R7903, R7904, R8001, R8002, R8003, R8004, R8101, R8102, R8103, R8104, R8201, R8202, R8203, R8204, R8301, R8302, R8303, R8304, R8401, R8402, R8403, R8404, R8501, R8502, R8503, R8504, R8601, R8602, R8603, R8604: 2k 1%; R_0603_1608Metric; LCSC C22975
R7105, R7106, R7107, R7108, R7205, R7206, R7207, R7208, R7305, R7306, R7307, R7308, R7405, R7406, R7407, R7408, R7505, R7506, R7507, R7508, R7605, R7606, R7607, R7608, R7705, R7706, R7707, R7708, R7805, R7806, R7807, R7808, R7905, R7906, R7907, R7908, R8005, R8006, R8007, R8008, R8105, R8106, R8107, R8108, R8205, R8206, R8207, R8208, R8305, R8306, R8307, R8308, R8405, R8406, R8407, R8408, R8505, R8506, R8507, R8508, R8605, R8606, R8607, R8608: 1k 1%; R_0603_1608Metric; LCSC C21190
R7109, R7209, R7309, R7409, R7509, R7609, R7709, R7809, R7909, R8009, R8109, R8209, R8309, R8409, R8509, R8609: 33 1%; R_0603_1608Metric; LCSC C23140
U7101, U7201, U7301, U7401, U7501, U7601, U7701, U7801, U7901, U8001, U8101, U8201, U8301, U8401, U8501, U8601: TLV320ADC5140; Texas_RTW_WQFN-24-1EP_4x4mm_P0.5mm_EP2.7x2.7mm_ThermalVias; LCSC C2876368

Connections of its further copies:
+3V3: C7115.1, C7116.1, C7215.1, C7216.1, C7315.1, C7316.1, C7415.1, C7416.1, C7515.1, C7516.1, C7615.1, C7616.1, C7715.1, C7716.1, C7815.1, C7816.1, C7915.1, C7916.1, C8015.1, C8016.1, C8115.1, C8116.1, C8215.1, C8216.1, C8315.1, C8316.1, C8415.1, C8416.1, C8515.1, C8516.1, C8615.1, C8616.1, U7101.19 (IOVDD), U7201.16 (ADDR0_SCLK), U7201.19 (IOVDD), U7301.15 (ADDR1_MISO), U7301.19 (IOVDD), U7401.15 (ADDR1_MISO), U7401.16 (ADDR0_SCLK), U7401.19 (IOVDD), U7501.19 (IOVDD), U7601.16 (ADDR0_SCLK), U7601.19 (IOVDD), U7701.15 (ADDR1_MISO), U7701.19 (IOVDD), U7801.15 (ADDR1_MISO), U7801.16 (ADDR0_SCLK), U7801.19 (IOVDD), U7901.19 (IOVDD), U8001.16 (ADDR0_SCLK), U8001.19 (IOVDD), U8101.15 (ADDR1_MISO), U8101.19 (IOVDD), U8201.15 (ADDR1_MISO), U8201.16 (ADDR0_SCLK), U8201.19 (IOVDD), U8301.19 (IOVDD), U8401.16 (ADDR0_SCLK), U8401.19 (IOVDD), U8501.15 (ADDR1_MISO), U8501.19 (IOVDD), U8601.15 (ADDR1_MISO), U8601.16 (ADDR0_SCLK), U8601.19 (IOVDD); also elsewhere on the board
+3V3A: C7109.1, C7110.1, C7209.1, C7210.1, C7309.1, C7310.1, C7409.1, C7410.1, C7509.1, C7510.1, C7609.1, C7610.1, C7709.1, C7710.1, C7809.1, C7810.1, C7909.1, C7910.1, C8009.1, C8010.1, C8109.1, C8110.1, C8209.1, C8210.1, C8309.1, C8310.1, C8409.1, C8410.1, C8509.1, C8510.1, C8609.1, C8610.1, U7101.1 (AVDD), U7201.1 (AVDD), U7301.1 (AVDD), U7401.1 (AVDD), U7501.1 (AVDD), U7601.1 (AVDD), U7701.1 (AVDD), U7801.1 (AVDD), U7901.1 (AVDD), U8001.1 (AVDD), U8101.1 (AVDD), U8201.1 (AVDD), U8301.1 (AVDD), U8401.1 (AVDD), U8501.1 (AVDD), U8601.1 (AVDD); also elsewhere on the board
/ADCs/ADC01/AREG: C7111.1, C7112.1, U7101.2 (AREG)
/ADCs/ADC01/DREG: C7113.1, C7114.1, U7101.24 (DREG)
/ADCs/ADC01/INM1: C7105.1, U7101.7 (IN1M_GPO1)
/ADCs/ADC01/INM2: C7106.1, U7101.9 (IN2M_GPO2)
/ADCs/ADC01/INM3: C7107.1, U7101.11 (IN3M_GPO3)
/ADCs/ADC01/INM4: C7108.1, U7101.13 (IN4M_GPO4)
/ADCs/ADC01/INP1: C7101.2, U7101.6 (IN1P_GPI1)
/ADCs/ADC01/INP2: C7102.2, U7101.8 (IN2P_GPI2)
/ADCs/ADC01/INP3: C7103.2, U7101.10 (IN3P_GPI3)
/ADCs/ADC01/INP4: C7104.2, U7101.12 (IN4P_GPI4)
/ADCs/ADC01/VREF: C7117.1, U7101.3 (VREF)
/ADCs/ADC02/AREG: C7211.1, C7212.1, U7201.2 (AREG)
/ADCs/ADC02/DREG: C7213.1, C7214.1, U7201.24 (DREG)
/ADCs/ADC02/INM1: C7205.1, U7201.7 (IN1M_GPO1)
/ADCs/ADC02/INM2: C7206.1, U7201.9 (IN2M_GPO2)
/ADCs/ADC02/INM3: C7207.1, U7201.11 (IN3M_GPO3)
/ADCs/ADC02/INM4: C7208.1, U7201.13 (IN4M_GPO4)
/ADCs/ADC02/INP1: C7201.2, U7201.6 (IN1P_GPI1)
/ADCs/ADC02/INP2: C7202.2, U7201.8 (IN2P_GPI2)
/ADCs/ADC02/INP3: C7203.2, U7201.10 (IN3P_GPI3)
/ADCs/ADC02/INP4: C7204.2, U7201.12 (IN4P_GPI4)
/ADCs/ADC02/VREF: C7217.1, U7201.3 (VREF)
/ADCs/ADC03/AREG: C7311.1, C7312.1, U7301.2 (AREG)
/ADCs/ADC03/DREG: C7313.1, C7314.1, U7301.24 (DREG)
/ADCs/ADC03/INM1: C7305.1, U7301.7 (IN1M_GPO1)
/ADCs/ADC03/INM2: C7306.1, U7301.9 (IN2M_GPO2)
/ADCs/ADC03/INM3: C7307.1, U7301.11 (IN3M_GPO3)
/ADCs/ADC03/INM4: C7308.1, U7301.13 (IN4M_GPO4)
/ADCs/ADC03/INP1: C7301.2, U7301.6 (IN1P_GPI1)
/ADCs/ADC03/INP2: C7302.2, U7301.8 (IN2P_GPI2)
/ADCs/ADC03/INP3: C7303.2, U7301.10 (IN3P_GPI3)
/ADCs/ADC03/INP4: C7304.2, U7301.12 (IN4P_GPI4)
/ADCs/ADC03/VREF: C7317.1, U7301.3 (VREF)
/ADCs/ADC04/AREG: C7411.1, C7412.1, U7401.2 (AREG)
/ADCs/ADC04/DREG: C7413.1, C7414.1, U7401.24 (DREG)
/ADCs/ADC04/INM1: C7405.1, U7401.7 (IN1M_GPO1)
/ADCs/ADC04/INM2: C7406.1, U7401.9 (IN2M_GPO2)
/ADCs/ADC04/INM3: C7407.1, U7401.11 (IN3M_GPO3)
/ADCs/ADC04/INM4: C7408.1, U7401.13 (IN4M_GPO4)
/ADCs/ADC04/INP1: C7401.2, U7401.6 (IN1P_GPI1)
/ADCs/ADC04/INP2: C7402.2, U7401.8 (IN2P_GPI2)
/ADCs/ADC04/INP3: C7403.2, U7401.10 (IN3P_GPI3)
/ADCs/ADC04/INP4: C7404.2, U7401.12 (IN4P_GPI4)
/ADCs/ADC04/VREF: C7417.1, U7401.3 (VREF)
/ADCs/ADC05/AREG: C7511.1, C7512.1, U7501.2 (AREG)
/ADCs/ADC05/DREG: C7513.1, C7514.1, U7501.24 (DREG)
/ADCs/ADC05/INM1: C7505.1, U7501.7 (IN1M_GPO1)
/ADCs/ADC05/INM2: C7506.1, U7501.9 (IN2M_GPO2)
/ADCs/ADC05/INM3: C7507.1, U7501.11 (IN3M_GPO3)
/ADCs/ADC05/INM4: C7508.1, U7501.13 (IN4M_GPO4)
/ADCs/ADC05/INP1: C7501.2, U7501.6 (IN1P_GPI1)
/ADCs/ADC05/INP2: C7502.2, U7501.8 (IN2P_GPI2)
/ADCs/ADC05/INP3: C7503.2, U7501.10 (IN3P_GPI3)
/ADCs/ADC05/INP4: C7504.2, U7501.12 (IN4P_GPI4)
/ADCs/ADC05/VREF: C7517.1, U7501.3 (VREF)
/ADCs/ADC06/AREG: C7611.1, C7612.1, U7601.2 (AREG)
/ADCs/ADC06/DREG: C7613.1, C7614.1, U7601.24 (DREG)
/ADCs/ADC06/INM1: C7605.1, U7601.7 (IN1M_GPO1)
/ADCs/ADC06/INM2: C7606.1, U7601.9 (IN2M_GPO2)
/ADCs/ADC06/INM3: C7607.1, U7601.11 (IN3M_GPO3)
/ADCs/ADC06/INM4: C7608.1, U7601.13 (IN4M_GPO4)
/ADCs/ADC06/INP1: C7601.2, U7601.6 (IN1P_GPI1)
/ADCs/ADC06/INP2: C7602.2, U7601.8 (IN2P_GPI2)
/ADCs/ADC06/INP3: C7603.2, U7601.10 (IN3P_GPI3)
/ADCs/ADC06/INP4: C7604.2, U7601.12 (IN4P_GPI4)
/ADCs/ADC06/VREF: C7617.1, U7601.3 (VREF)
/ADCs/ADC07/AREG: C7711.1, C7712.1, U7701.2 (AREG)
/ADCs/ADC07/DREG: C7713.1, C7714.1, U7701.24 (DREG)
/ADCs/ADC07/INM1: C7705.1, U7701.7 (IN1M_GPO1)
/ADCs/ADC07/INM2: C7706.1, U7701.9 (IN2M_GPO2)
/ADCs/ADC07/INM3: C7707.1, U7701.11 (IN3M_GPO3)
/ADCs/ADC07/INM4: C7708.1, U7701.13 (IN4M_GPO4)
/ADCs/ADC07/INP1: C7701.2, U7701.6 (IN1P_GPI1)
/ADCs/ADC07/INP2: C7702.2, U7701.8 (IN2P_GPI2)
/ADCs/ADC07/INP3: C7703.2, U7701.10 (IN3P_GPI3)
/ADCs/ADC07/INP4: C7704.2, U7701.12 (IN4P_GPI4)
/ADCs/ADC07/VREF: C7717.1, U7701.3 (VREF)
/ADCs/ADC08/AREG: C7811.1, C7812.1, U7801.2 (AREG)
/ADCs/ADC08/DREG: C7813.1, C7814.1, U7801.24 (DREG)
/ADCs/ADC08/INM1: C7805.1, U7801.7 (IN1M_GPO1)
/ADCs/ADC08/INM2: C7806.1, U7801.9 (IN2M_GPO2)
/ADCs/ADC08/INM3: C7807.1, U7801.11 (IN3M_GPO3)
/ADCs/ADC08/INM4: C7808.1, U7801.13 (IN4M_GPO4)
/ADCs/ADC08/INP1: C7801.2, U7801.6 (IN1P_GPI1)
/ADCs/ADC08/INP2: C7802.2, U7801.8 (IN2P_GPI2)
/ADCs/ADC08/INP3: C7803.2, U7801.10 (IN3P_GPI3)
/ADCs/ADC08/INP4: C7804.2, U7801.12 (IN4P_GPI4)
/ADCs/ADC08/VREF: C7817.1, U7801.3 (VREF)
/ADCs/ADC09/AREG: C7911.1, C7912.1, U7901.2 (AREG)
/ADCs/ADC09/DREG: C7913.1, C7914.1, U7901.24 (DREG)
/ADCs/ADC09/INM1: C7905.1, U7901.7 (IN1M_GPO1)
/ADCs/ADC09/INM2: C7906.1, U7901.9 (IN2M_GPO2)
/ADCs/ADC09/INM3: C7907.1, U7901.11 (IN3M_GPO3)
/ADCs/ADC09/INM4: C7908.1, U7901.13 (IN4M_GPO4)
/ADCs/ADC09/INP1: C7901.2, U7901.6 (IN1P_GPI1)
/ADCs/ADC09/INP2: C7902.2, U7901.8 (IN2P_GPI2)
/ADCs/ADC09/INP3: C7903.2, U7901.10 (IN3P_GPI3)
/ADCs/ADC09/INP4: C7904.2, U7901.12 (IN4P_GPI4)
/ADCs/ADC09/VREF: C7917.1, U7901.3 (VREF)
/ADCs/ADC10/AREG: C8011.1, C8012.1, U8001.2 (AREG)
/ADCs/ADC10/DREG: C8013.1, C8014.1, U8001.24 (DREG)
/ADCs/ADC10/INM1: C8005.1, U8001.7 (IN1M_GPO1)
/ADCs/ADC10/INM2: C8006.1, U8001.9 (IN2M_GPO2)
/ADCs/ADC10/INM3: C8007.1, U8001.11 (IN3M_GPO3)
/ADCs/ADC10/INM4: C8008.1, U8001.13 (IN4M_GPO4)
/ADCs/ADC10/INP1: C8001.2, U8001.6 (IN1P_GPI1)
/ADCs/ADC10/INP2: C8002.2, U8001.8 (IN2P_GPI2)
/ADCs/ADC10/INP3: C8003.2, U8001.10 (IN3P_GPI3)
/ADCs/ADC10/INP4: C8004.2, U8001.12 (IN4P_GPI4)
/ADCs/ADC10/VREF: C8017.1, U8001.3 (VREF)
/ADCs/ADC11/AREG: C8111.1, C8112.1, U8101.2 (AREG)
/ADCs/ADC11/DREG: C8113.1, C8114.1, U8101.24 (DREG)
/ADCs/ADC11/INM1: C8105.1, U8101.7 (IN1M_GPO1)
/ADCs/ADC11/INM2: C8106.1, U8101.9 (IN2M_GPO2)
/ADCs/ADC11/INM3: C8107.1, U8101.11 (IN3M_GPO3)
/ADCs/ADC11/INM4: C8108.1, U8101.13 (IN4M_GPO4)
/ADCs/ADC11/INP1: C8101.2, U8101.6 (IN1P_GPI1)
/ADCs/ADC11/INP2: C8102.2, U8101.8 (IN2P_GPI2)
/ADCs/ADC11/INP3: C8103.2, U8101.10 (IN3P_GPI3)
/ADCs/ADC11/INP4: C8104.2, U8101.12 (IN4P_GPI4)
/ADCs/ADC11/VREF: C8117.1, U8101.3 (VREF)
/ADCs/ADC12/AREG: C8211.1, C8212.1, U8201.2 (AREG)
/ADCs/ADC12/DREG: C8213.1, C8214.1, U8201.24 (DREG)
/ADCs/ADC12/INM1: C8205.1, U8201.7 (IN1M_GPO1)
/ADCs/ADC12/INM2: C8206.1, U8201.9 (IN2M_GPO2)
/ADCs/ADC12/INM3: C8207.1, U8201.11 (IN3M_GPO3)
/ADCs/ADC12/INM4: C8208.1, U8201.13 (IN4M_GPO4)
/ADCs/ADC12/INP1: C8201.2, U8201.6 (IN1P_GPI1)
/ADCs/ADC12/INP2: C8202.2, U8201.8 (IN2P_GPI2)
/ADCs/ADC12/INP3: C8203.2, U8201.10 (IN3P_GPI3)
/ADCs/ADC12/INP4: C8204.2, U8201.12 (IN4P_GPI4)
/ADCs/ADC12/VREF: C8217.1, U8201.3 (VREF)
/ADCs/ADC13/AREG: C8311.1, C8312.1, U8301.2 (AREG)
/ADCs/ADC13/DREG: C8313.1, C8314.1, U8301.24 (DREG)
/ADCs/ADC13/INM1: C8305.1, U8301.7 (IN1M_GPO1)
/ADCs/ADC13/INM2: C8306.1, U8301.9 (IN2M_GPO2)
/ADCs/ADC13/INM3: C8307.1, U8301.11 (IN3M_GPO3)
/ADCs/ADC13/INM4: C8308.1, U8301.13 (IN4M_GPO4)
/ADCs/ADC13/INP1: C8301.2, U8301.6 (IN1P_GPI1)
/ADCs/ADC13/INP2: C8302.2, U8301.8 (IN2P_GPI2)
/ADCs/ADC13/INP3: C8303.2, U8301.10 (IN3P_GPI3)
/ADCs/ADC13/INP4: C8304.2, U8301.12 (IN4P_GPI4)
/ADCs/ADC13/VREF: C8317.1, U8301.3 (VREF)
/ADCs/ADC14/AREG: C8411.1, C8412.1, U8401.2 (AREG)
/ADCs/ADC14/DREG: C8413.1, C8414.1, U8401.24 (DREG)
/ADCs/ADC14/INM1: C8405.1, U8401.7 (IN1M_GPO1)
/ADCs/ADC14/INM2: C8406.1, U8401.9 (IN2M_GPO2)
/ADCs/ADC14/INM3: C8407.1, U8401.11 (IN3M_GPO3)
/ADCs/ADC14/INM4: C8408.1, U8401.13 (IN4M_GPO4)
/ADCs/ADC14/INP1: C8401.2, U8401.6 (IN1P_GPI1)
/ADCs/ADC14/INP2: C8402.2, U8401.8 (IN2P_GPI2)
/ADCs/ADC14/INP3: C8403.2, U8401.10 (IN3P_GPI3)
/ADCs/ADC14/INP4: C8404.2, U8401.12 (IN4P_GPI4)
/ADCs/ADC14/VREF: C8417.1, U8401.3 (VREF)
/ADCs/ADC15/AREG: C8511.1, C8512.1, U8501.2 (AREG)
/ADCs/ADC15/DREG: C8513.1, C8514.1, U8501.24 (DREG)
/ADCs/ADC15/INM1: C8505.1, U8501.7 (IN1M_GPO1)
/ADCs/ADC15/INM2: C8506.1, U8501.9 (IN2M_GPO2)
/ADCs/ADC15/INM3: C8507.1, U8501.11 (IN3M_GPO3)
/ADCs/ADC15/INM4: C8508.1, U8501.13 (IN4M_GPO4)
/ADCs/ADC15/INP1: C8501.2, U8501.6 (IN1P_GPI1)
/ADCs/ADC15/INP2: C8502.2, U8501.8 (IN2P_GPI2)
/ADCs/ADC15/INP3: C8503.2, U8501.10 (IN3P_GPI3)
/ADCs/ADC15/INP4: C8504.2, U8501.12 (IN4P_GPI4)
/ADCs/ADC15/VREF: C8517.1, U8501.3 (VREF)
/ADCs/ADC16/AREG: C8611.1, C8612.1, U8601.2 (AREG)
/ADCs/ADC16/DREG: C8613.1, C8614.1, U8601.24 (DREG)
/ADCs/ADC16/INM1: C8605.1, U8601.7 (IN1M_GPO1)
/ADCs/ADC16/INM2: C8606.1, U8601.9 (IN2M_GPO2)
/ADCs/ADC16/INM3: C8607.1, U8601.11 (IN3M_GPO3)
/ADCs/ADC16/INM4: C8608.1, U8601.13 (IN4M_GPO4)
/ADCs/ADC16/INP1: C8601.2, U8601.6 (IN1P_GPI1)
/ADCs/ADC16/INP2: C8602.2, U8601.8 (IN2P_GPI2)
/ADCs/ADC16/INP3: C8603.2, U8601.10 (IN3P_GPI3)
/ADCs/ADC16/INP4: C8604.2, U8601.12 (IN4P_GPI4)
/ADCs/ADC16/VREF: C8617.1, U8601.3 (VREF)
ADC_BCLK_A: U7101.22 (BCLK), U7201.22 (BCLK), U7301.22 (BCLK), U7401.22 (BCLK); also elsewhere on the board
ADC_BCLK_B: U7501.22 (BCLK), U7601.22 (BCLK), U7701.22 (BCLK), U7801.22 (BCLK); also elsewhere on the board
ADC_BCLK_C: U7901.22 (BCLK), U8001.22 (BCLK), U8101.22 (BCLK), U8201.22 (BCLK); also elsewhere on the board
ADC_BCLK_D: U8301.22 (BCLK), U8401.22 (BCLK), U8501.22 (BCLK), U8601.22 (BCLK); also elsewhere on the board
ADC_FSYNC_A: U7101.23 (FSYNC), U7201.23 (FSYNC), U7301.23 (FSYNC), U7401.23 (FSYNC); also elsewhere on the board
ADC_FSYNC_B: U7501.23 (FSYNC), U7601.23 (FSYNC), U7701.23 (FSYNC), U7801.23 (FSYNC); also elsewhere on the board
ADC_FSYNC_C: U7901.23 (FSYNC), U8001.23 (FSYNC), U8101.23 (FSYNC), U8201.23 (FSYNC); also elsewhere on the board
ADC_FSYNC_D: U8301.23 (FSYNC), U8401.23 (FSYNC), U8501.23 (FSYNC), U8601.23 (FSYNC); also elsewhere on the board
ADC_SCL: U7101.17 (SCL_MOSI), U7201.17 (SCL_MOSI), U7301.17 (SCL_MOSI), U7401.17 (SCL_MOSI), U7501.17 (SCL_MOSI), U7601.17 (SCL_MOSI), U7701.17 (SCL_MOSI), U7801.17 (SCL_MOSI), U7901.17 (SCL_MOSI), U8001.17 (SCL_MOSI), U8101.17 (SCL_MOSI), U8201.17 (SCL_MOSI), U8301.17 (SCL_MOSI), U8401.17 (SCL_MOSI), U8501.17 (SCL_MOSI), U8601.17 (SCL_MOSI); also elsewhere on the board
ADC_SDA1: U7101.18 (SDA_SSZ), U7201.18 (SDA_SSZ), U7301.18 (SDA_SSZ), U7401.18 (SDA_SSZ); also elsewhere on the board
ADC_SDA2: U7501.18 (SDA_SSZ), U7601.18 (SDA_SSZ), U7701.18 (SDA_SSZ), U7801.18 (SDA_SSZ); also elsewhere on the board
ADC_SDA3: U7901.18 (SDA_SSZ), U8001.18 (SDA_SSZ), U8101.18 (SDA_SSZ), U8201.18 (SDA_SSZ); also elsewhere on the board
ADC_SDA4: U8301.18 (SDA_SSZ), U8401.18 (SDA_SSZ), U8501.18 (SDA_SSZ), U8601.18 (SDA_SSZ); also elsewhere on the board
ADC_SDOUT1: R7109.2; also elsewhere on the board
ADC_SDOUT2: R7209.2; also elsewhere on the board
ADC_SDOUT3: R7309.2; also elsewhere on the board
ADC_SDOUT4: R7409.2; also elsewhere on the board
ADC_SDOUT5: R7509.2; also elsewhere on the board
ADC_SDOUT6: R7609.2; also elsewhere on the board
ADC_SDOUT7: R7709.2; also elsewhere on the board
ADC_SDOUT8: R7809.2; also elsewhere on the board
ADC_SDOUT9: R7909.2; also elsewhere on the board
ADC_SDOUT10: R8009.2; also elsewhere on the board
ADC_SDOUT11: R8109.2; also elsewhere on the board
ADC_SDOUT12: R8209.2; also elsewhere on the board
ADC_SDOUT13: R8309.2; also elsewhere on the board
ADC_SDOUT14: R8409.2; also elsewhere on the board
ADC_SDOUT15: R8509.2; also elsewhere on the board
ADC_SDOUT16: R8609.2; also elsewhere on the board
ADC_SHDNZ: U7101.14 (SHDNZ), U7201.14 (SHDNZ), U7301.14 (SHDNZ), U7401.14 (SHDNZ), U7501.14 (SHDNZ), U7601.14 (SHDNZ), U7701.14 (SHDNZ), U7801.14 (SHDNZ), U7901.14 (SHDNZ), U8001.14 (SHDNZ), U8101.14 (SHDNZ), U8201.14 (SHDNZ), U8301.14 (SHDNZ), U8401.14 (SHDNZ), U8501.14 (SHDNZ), U8601.14 (SHDNZ); also elsewhere on the board
GND: C7105.2, C7106.2, C7107.2, C7108.2, C7109.2, C7110.2, C7111.2, C7112.2, C7113.2, C7114.2, C7115.2, C7116.2, C7117.2, C7205.2, C7206.2, C7207.2, C7208.2, C7209.2, C7210.2, C7211.2, C7212.2, C7213.2, C7214.2, C7215.2, C7216.2, C7217.2, C7305.2, C7306.2, C7307.2, C7308.2, C7309.2, C7310.2, C7311.2, C7312.2, C7313.2, C7314.2, C7315.2, C7316.2, C7317.2, C7405.2, C7406.2, C7407.2, C7408.2, C7409.2, C7410.2, C7411.2, C7412.2, C7413.2, C7414.2, C7415.2, C7416.2, C7417.2, C7505.2, C7506.2, C7507.2, C7508.2, C7509.2, C7510.2, C7511.2, C7512.2, C7513.2, C7514.2, C7515.2, C7516.2, C7517.2, C7605.2, C7606.2, C7607.2, C7608.2, C7609.2, C7610.2, C7611.2, C7612.2, C7613.2, C7614.2, C7615.2, C7616.2, C7617.2, C7705.2, C7706.2, C7707.2, C7708.2, C7709.2, C7710.2, C7711.2, C7712.2, C7713.2, C7714.2, C7715.2, C7716.2, C7717.2, C7805.2, C7806.2, C7807.2, C7808.2, C7809.2, C7810.2, C7811.2, C7812.2, C7813.2, C7814.2, C7815.2, C7816.2, C7817.2, C7905.2, C7906.2, C7907.2, C7908.2, C7909.2, C7910.2, C7911.2, C7912.2, C7913.2, C7914.2, C7915.2, C7916.2, C7917.2, C8005.2, C8006.2, C8007.2, C8008.2, C8009.2, C8010.2, C8011.2, C8012.2, C8013.2, C8014.2, C8015.2, C8016.2, C8017.2, C8105.2, C8106.2, C8107.2, C8108.2, C8109.2, C8110.2, C8111.2, C8112.2, C8113.2, C8114.2, C8115.2, C8116.2, C8117.2, C8205.2, C8206.2, C8207.2, C8208.2, C8209.2, C8210.2, C8211.2, C8212.2, C8213.2, C8214.2, C8215.2, C8216.2, C8217.2, C8305.2, C8306.2, C8307.2, C8308.2, C8309.2, C8310.2, C8311.2, C8312.2, C8313.2, C8314.2, C8315.2, C8316.2, C8317.2, C8405.2, C8406.2, C8407.2, C8408.2, C8409.2, C8410.2, C8411.2, C8412.2, C8413.2, C8414.2, C8415.2, C8416.2, C8417.2, C8505.2, C8506.2, C8507.2, C8508.2, C8509.2, C8510.2, C8511.2, C8512.2, C8513.2, C8514.2, C8515.2, C8516.2, C8517.2, C8605.2, C8606.2, C8607.2, C8608.2, C8609.2, C8610.2, C8611.2, C8612.2, C8613.2, C8614.2, C8615.2, C8616.2, C8617.2, R7105.2, R7106.2, R7107.2, R7108.2, R7205.2, R7206.2, R7207.2, R7208.2, R7305.2, R7306.2, R7307.2, R7308.2, R7405.2, R7406.2, R7407.2, R7408.2, R7505.2, R7506.2, R7507.2, R7508.2, R7605.2, R7606.2, R7607.2, R7608.2, R7705.2, R7706.2, R7707.2, R7708.2, R7805.2, R7806.2, R7807.2, R7808.2, R7905.2, R7906.2, R7907.2, R7908.2, R8005.2, R8006.2, R8007.2, R8008.2, R8105.2, R8106.2, R8107.2, R8108.2, R8205.2, R8206.2, R8207.2, R8208.2, R8305.2, R8306.2, R8307.2, R8308.2, R8405.2, R8406.2, R8407.2, R8408.2, R8505.2, R8506.2, R8507.2, R8508.2, R8605.2, R8606.2, R8607.2, R8608.2, U7101.4 (AVSS), U7101.15 (ADDR1_MISO), U7101.16 (ADDR0_SCLK), U7101.25 (VSS), U7201.4 (AVSS), U7201.15 (ADDR1_MISO), U7201.25 (VSS), U7301.4 (AVSS), U7301.16 (ADDR0_SCLK), U7301.25 (VSS), U7401.4 (AVSS), U7401.25 (VSS), U7501.4 (AVSS), U7501.15 (ADDR1_MISO), U7501.16 (ADDR0_SCLK), U7501.25 (VSS), U7601.4 (AVSS), U7601.15 (ADDR1_MISO), U7601.25 (VSS), U7701.4 (AVSS), U7701.16 (ADDR0_SCLK), U7701.25 (VSS), U7801.4 (AVSS), U7801.25 (VSS), U7901.4 (AVSS), U7901.15 (ADDR1_MISO), U7901.16 (ADDR0_SCLK), U7901.25 (VSS), U8001.4 (AVSS), U8001.15 (ADDR1_MISO), U8001.25 (VSS), U8101.4 (AVSS), U8101.16 (ADDR0_SCLK), U8101.25 (VSS), U8201.4 (AVSS), U8201.25 (VSS), U8301.4 (AVSS), U8301.15 (ADDR1_MISO), U8301.16 (ADDR0_SCLK), U8301.25 (VSS), U8401.4 (AVSS), U8401.15 (ADDR1_MISO), U8401.25 (VSS), U8501.4 (AVSS), U8501.16 (ADDR0_SCLK), U8501.25 (VSS), U8601.4 (AVSS), U8601.25 (VSS); also elsewhere on the board
unnamed: C7101.1, R7101.2, R7105.1
unnamed: C7102.1, R7102.2, R7106.1
unnamed: C7103.1, R7103.2, R7107.1
unnamed: C7104.1, R7104.2, R7108.1
unnamed: C7201.1, R7201.2, R7205.1
unnamed: C7202.1, R7202.2, R7206.1
unnamed: C7203.1, R7203.2, R7207.1
unnamed: C7204.1, R7204.2, R7208.1
unnamed: C7301.1, R7301.2, R7305.1
unnamed: C7302.1, R7302.2, R7306.1
unnamed: C7303.1, R7303.2, R7307.1
unnamed: C7304.1, R7304.2, R7308.1
unnamed: C7401.1, R7401.2, R7405.1
unnamed: C7402.1, R7402.2, R7406.1
unnamed: C7403.1, R7403.2, R7407.1
unnamed: C7404.1, R7404.2, R7408.1
unnamed: C7501.1, R7501.2, R7505.1
unnamed: C7502.1, R7502.2, R7506.1
unnamed: C7503.1, R7503.2, R7507.1
unnamed: C7504.1, R7504.2, R7508.1
unnamed: C7601.1, R7601.2, R7605.1
unnamed: C7602.1, R7602.2, R7606.1
unnamed: C7603.1, R7603.2, R7607.1
unnamed: C7604.1, R7604.2, R7608.1
unnamed: C7701.1, R7701.2, R7705.1
unnamed: C7702.1, R7702.2, R7706.1
unnamed: C7703.1, R7703.2, R7707.1
unnamed: C7704.1, R7704.2, R7708.1
unnamed: C7801.1, R7801.2, R7805.1
unnamed: C7802.1, R7802.2, R7806.1
unnamed: C7803.1, R7803.2, R7807.1
unnamed: C7804.1, R7804.2, R7808.1
unnamed: C7901.1, R7901.2, R7905.1
unnamed: C7902.1, R7902.2, R7906.1
unnamed: C7903.1, R7903.2, R7907.1
unnamed: C7904.1, R7904.2, R7908.1
unnamed: C8001.1, R8001.2, R8005.1
unnamed: C8002.1, R8002.2, R8006.1
unnamed: C8003.1, R8003.2, R8007.1
unnamed: C8004.1, R8004.2, R8008.1
unnamed: C8101.1, R8101.2, R8105.1
unnamed: C8102.1, R8102.2, R8106.1
unnamed: C8103.1, R8103.2, R8107.1
unnamed: C8104.1, R8104.2, R8108.1
unnamed: C8201.1, R8201.2, R8205.1
unnamed: C8202.1, R8202.2, R8206.1
unnamed: C8203.1, R8203.2, R8207.1
unnamed: C8204.1, R8204.2, R8208.1
unnamed: C8301.1, R8301.2, R8305.1
unnamed: C8302.1, R8302.2, R8306.1
unnamed: C8303.1, R8303.2, R8307.1
unnamed: C8304.1, R8304.2, R8308.1
unnamed: C8401.1, R8401.2, R8405.1
unnamed: C8402.1, R8402.2, R8406.1
unnamed: C8403.1, R8403.2, R8407.1
unnamed: C8404.1, R8404.2, R8408.1
unnamed: C8501.1, R8501.2, R8505.1
unnamed: C8502.1, R8502.2, R8506.1
unnamed: C8503.1, R8503.2, R8507.1
unnamed: C8504.1, R8504.2, R8508.1
unnamed: C8601.1, R8601.2, R8605.1
unnamed: C8602.1, R8602.2, R8606.1
unnamed: C8603.1, R8603.2, R8607.1
unnamed: C8604.1, R8604.2, R8608.1
unnamed: R7109.1, U7101.21 (SDOUT)
unnamed: R7209.1, U7201.21 (SDOUT)
unnamed: R7309.1, U7301.21 (SDOUT)
unnamed: R7409.1, U7401.21 (SDOUT)
unnamed: R7509.1, U7501.21 (SDOUT)
unnamed: R7609.1, U7601.21 (SDOUT)
unnamed: R7709.1, U7701.21 (SDOUT)
unnamed: R7809.1, U7801.21 (SDOUT)
unnamed: R7909.1, U7901.21 (SDOUT)
unnamed: R8009.1, U8001.21 (SDOUT)
unnamed: R8109.1, U8101.21 (SDOUT)
unnamed: R8209.1, U8201.21 (SDOUT)
unnamed: R8309.1, U8301.21 (SDOUT)
unnamed: R8409.1, U8401.21 (SDOUT)
unnamed: R8509.1, U8501.21 (SDOUT)
unnamed: R8609.1, U8601.21 (SDOUT)
RX1: R7104.1; also elsewhere on the board
RX2: R7103.1; also elsewhere on the board
RX3: R7102.1; also elsewhere on the board
RX4: R7101.1; also elsewhere on the board
RX5: R7204.1; also elsewhere on the board
RX6: R7203.1; also elsewhere on the board
RX7: R7202.1; also elsewhere on the board
RX8: R7201.1; also elsewhere on the board
RX9: R7304.1; also elsewhere on the board
RX10: R7303.1; also elsewhere on the board
RX11: R7302.1; also elsewhere on the board
RX12: R7301.1; also elsewhere on the board
RX13: R7404.1; also elsewhere on the board
RX14: R7403.1; also elsewhere on the board
RX15: R7402.1; also elsewhere on the board
RX16: R7401.1; also elsewhere on the board
RX17: R7504.1; also elsewhere on the board
RX18: R7503.1; also elsewhere on the board
RX19: R7502.1; also elsewhere on the board
RX20: R7501.1; also elsewhere on the board
RX21: R7604.1; also elsewhere on the board
RX22: R7603.1; also elsewhere on the board
RX23: R7602.1; also elsewhere on the board
RX24: R7601.1; also elsewhere on the board
RX25: R7704.1; also elsewhere on the board
RX26: R7703.1; also elsewhere on the board
RX27: R7702.1; also elsewhere on the board
RX28: R7701.1; also elsewhere on the board
RX29: R7804.1; also elsewhere on the board
RX30: R7803.1; also elsewhere on the board
RX31: R7802.1; also elsewhere on the board
RX32: R7801.1; also elsewhere on the board
RX33: R7904.1; also elsewhere on the board
RX34: R7903.1; also elsewhere on the board
RX35: R7902.1; also elsewhere on the board
RX36: R7901.1; also elsewhere on the board
RX37: R8004.1; also elsewhere on the board
RX38: R8003.1; also elsewhere on the board
RX39: R8002.1; also elsewhere on the board
RX40: R8001.1; also elsewhere on the board
RX41: R8104.1; also elsewhere on the board
RX42: R8103.1; also elsewhere on the board
RX43: R8102.1; also elsewhere on the board
RX44: R8101.1; also elsewhere on the board
RX45: R8204.1; also elsewhere on the board
RX46: R8203.1; also elsewhere on the board
RX47: R8202.1; also elsewhere on the board
RX48: R8201.1; also elsewhere on the board
RX49: R8304.1; also elsewhere on the board
RX50: R8303.1; also elsewhere on the board
RX51: R8302.1; also elsewhere on the board
RX52: R8301.1; also elsewhere on the board
RX53: R8404.1; also elsewhere on the board
RX54: R8403.1; also elsewhere on the board
RX55: R8402.1; also elsewhere on the board
RX56: R8401.1; also elsewhere on the board
RX57: R8504.1; also elsewhere on the board
RX58: R8503.1; also elsewhere on the board
RX59: R8502.1; also elsewhere on the board
RX60: R8501.1; also elsewhere on the board
RX61: R8604.1; also elsewhere on the board
RX62: R8603.1; also elsewhere on the board
RX63: R8602.1; also elsewhere on the board
RX64: R8601.1; also elsewhere on the board

Notes on the sheet:
Input: 2k/1k divider (x0.31 with the 10 k input) keeps the receiver's +-4.2 V worst case inside the 1.41 V peak full scale; 100 nF couples to the ADC's own bias (150 Hz high-pass).
Per channel, set at boot: CHx_INSRC = single-ended (01), CHx_IMP = 10 k (01), AC-coupled, fixed 0 dB gain, DRE and AGC OFF (they change gain on the fly and break channel matching).
ADC: TLV320ADC5140 (TI, 4 channels, up to 768 kSPS). Run at 192 kSPS: flat to about 86 kHz.
TDM slave: BCLK 18.432 MHz, FSYNC 192 kHz from the FPGA (shared by all 16 ADCs, so all 64 channels sample at the same instant). 4 slots x 24 bits on SDOUT.
Decoupling at the pins (datasheet Figure 172): AVDD 1 uF + 100 nF, AREG and DREG 10 uF + 100 nF, IOVDD 10 uF + 100 nF, VREF 1 uF
I2C: SCL shared, SDA per group of 4 ADCs; A1/A0 set the address 0x4C-0x4F inside the group. Config writes can use I2C broadcast (P0_R2 I2C_BRDCAST_EN).
Also: ADC_FSCALE 2.75 V (1 Vrms single-ended full scale), AREG_SELECT = 1, TX_EDGE = 1 (the FPGA latches SDOUT one BCLK after launch).
Ports IN1-IN4 are the block's four elements in order; IN1 feeds ADC channel 4 ... IN4 channel 1 (the order the receive lanes reach the inputs on the board). TDM: channel c carries element 4k-4 + (5 - c).
Channel inputs: 2k + 1k divider, 100 nF AC coupling (single-ended, INxM AC-grounded)
Power-up: SHDNZ (ADC_SHDNZ, pulled low on the header sheet) stays low until the rails settle, then wait 2 ms before I2C.

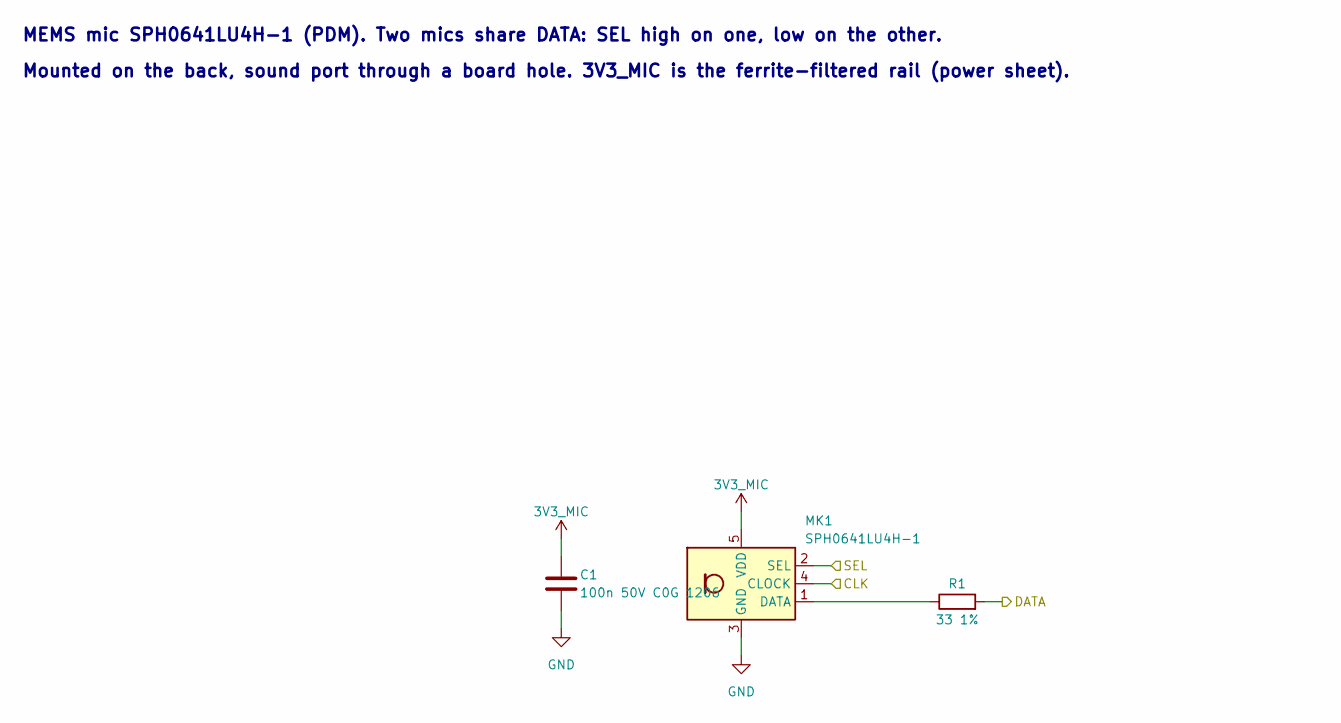
[picture p63: schematic mic.kicad_sch, MEMS mic (x8): SPH0641LU4H-1]

Parts:
C1: 100n 50V C0G 1206; C_1206_3216Metric; LCSC C170182
MK1: SPH0641LU4H-1; Knowles_LGA-5_3.5x2.65mm; LCSC C2879853
R1: 33 1%; R_0603_1608Metric; LCSC C23140

Parts of its further copies:
C14101, C14201, C14301, C14401, C14501, C14601, C14701, C14801: 100n 50V C0G 1206; C_1206_3216Metric; LCSC C170182
MK14101, MK14201, MK14301, MK14401, MK14501, MK14601, MK14701, MK14801: SPH0641LU4H-1; Knowles_LGA-5_3.5x2.65mm; LCSC C2879853
R14101, R14201, R14301, R14401, R14501, R14601, R14701, R14801: 33 1%; R_0603_1608Metric; LCSC C23140

Connections of its further copies:
3V3_MIC: C14101.1, C14201.1, C14301.1, C14401.1, C14501.1, C14601.1, C14701.1, C14801.1, MK14101.2 (SEL), MK14101.5 (VDD), MK14201.5 (VDD), MK14301.2 (SEL), MK14301.5 (VDD), MK14401.5 (VDD), MK14501.2 (SEL), MK14501.5 (VDD), MK14601.5 (VDD), MK14701.2 (SEL), MK14701.5 (VDD), MK14801.5 (VDD); also elsewhere on the board
GND: C14101.2, C14201.2, C14301.2, C14401.2, C14501.2, C14601.2, C14701.2, C14801.2, MK14101.3 (GND), MK14201.2 (SEL), MK14201.3 (GND), MK14301.3 (GND), MK14401.2 (SEL), MK14401.3 (GND), MK14501.3 (GND), MK14601.2 (SEL), MK14601.3 (GND), MK14701.3 (GND), MK14801.2 (SEL), MK14801.3 (GND); also elsewhere on the board
MIC_CLK_A: MK14101.4 (CLOCK), MK14201.4 (CLOCK); also elsewhere on the board
MIC_CLK_B: MK14301.4 (CLOCK), MK14401.4 (CLOCK); also elsewhere on the board
MIC_CLK_C: MK14501.4 (CLOCK), MK14601.4 (CLOCK); also elsewhere on the board
MIC_CLK_D: MK14701.4 (CLOCK), MK14801.4 (CLOCK); also elsewhere on the board
MIC_DATA0: R14101.2, R14201.2; also elsewhere on the board
MIC_DATA1: R14301.2, R14401.2; also elsewhere on the board
MIC_DATA2: R14501.2, R14601.2; also elsewhere on the board
MIC_DATA3: R14701.2, R14801.2; also elsewhere on the board
unnamed: MK14101.1 (DATA), R14101.1
unnamed: MK14201.1 (DATA), R14201.1
unnamed: MK14301.1 (DATA), R14301.1
unnamed: MK14401.1 (DATA), R14401.1
unnamed: MK14501.1 (DATA), R14501.1
unnamed: MK14601.1 (DATA), R14601.1
unnamed: MK14701.1 (DATA), R14701.1
unnamed: MK14801.1 (DATA), R14801.1

Notes on the sheet:
Mounted on the back, sound port through a board hole. 3V3_MIC is the ferrite-filtered rail (power sheet).
MEMS mic SPH0641LU4H-1 (PDM). Two mics share DATA: SEL high on one, low on the other.

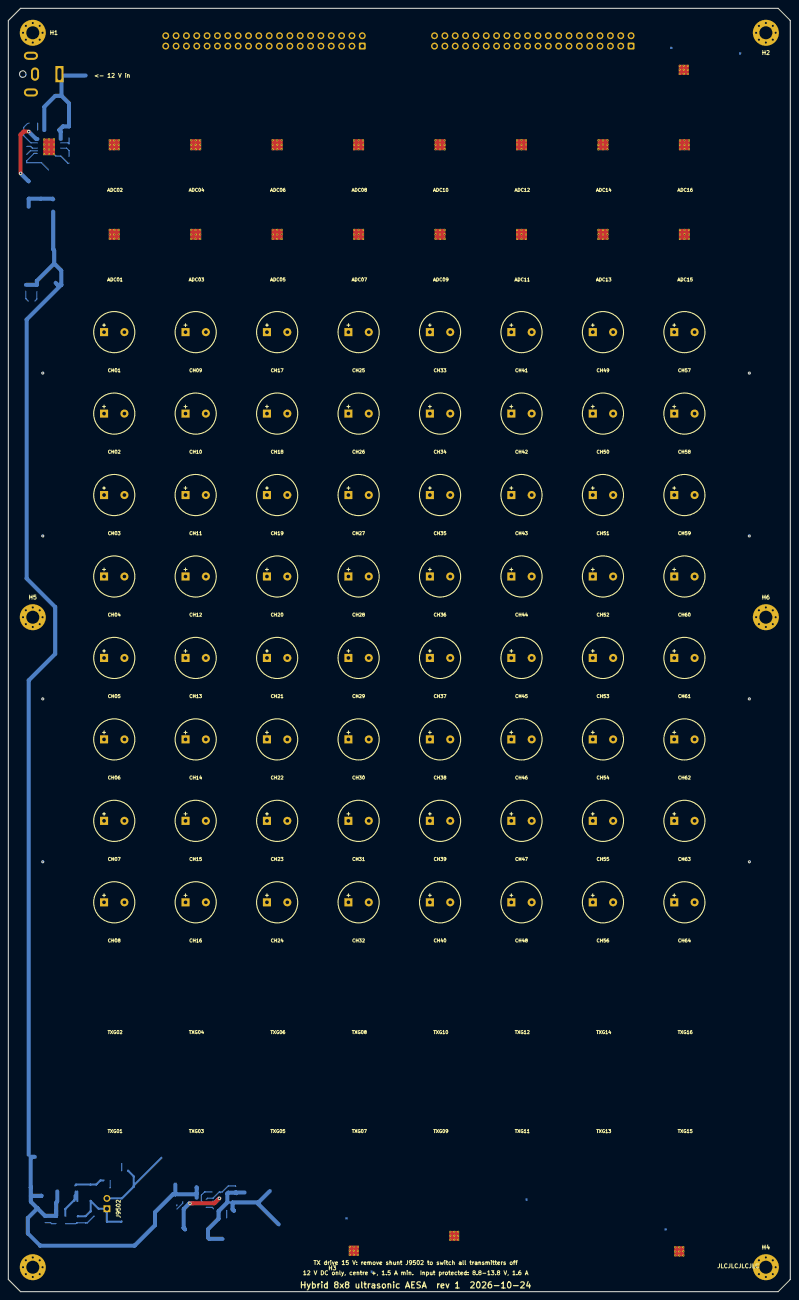
[picture p64: board aesa.kicad_pcb from above]

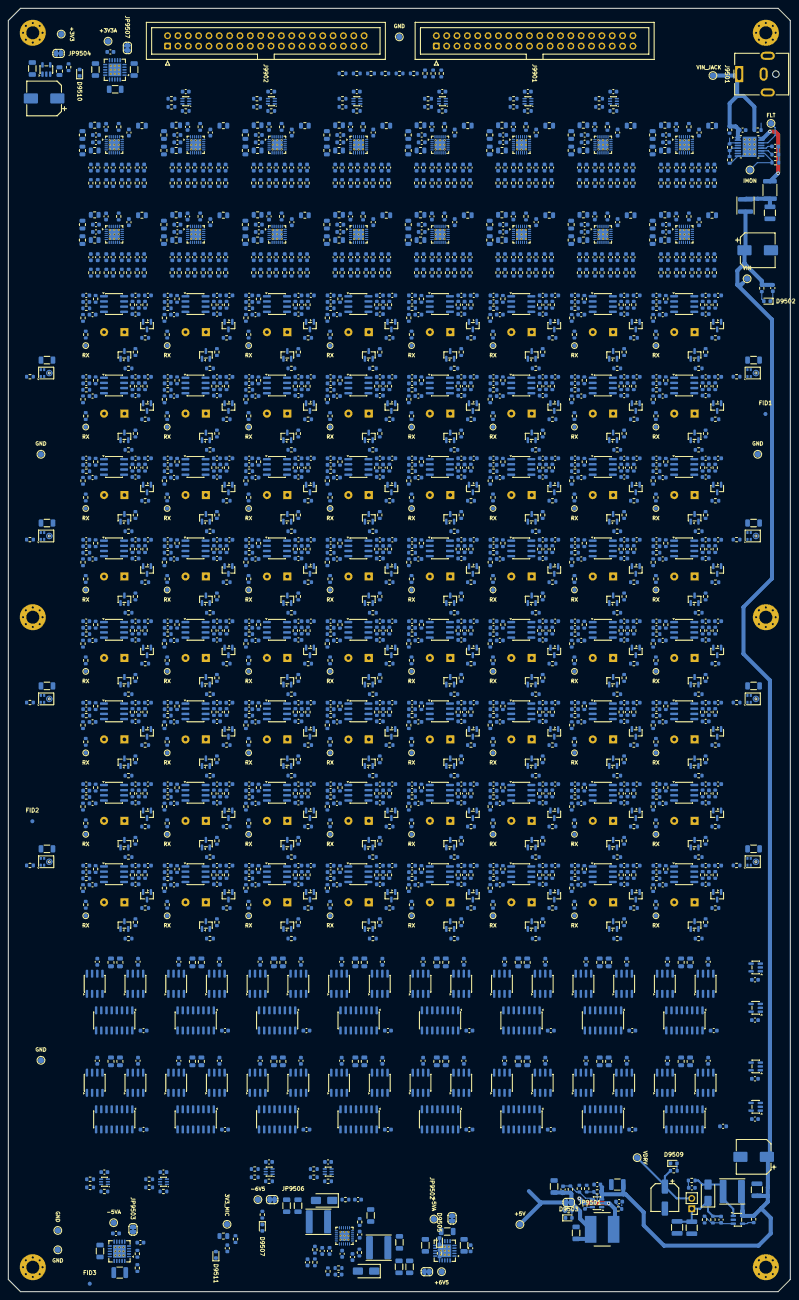
[picture p65: board aesa.kicad_pcb from below]

Board: 4 copper layers, 192.0 x 315.1 mm, 2139 parts (2069 on the bottom side), 1185 nets.

Other parts of the board:
FID1, FID2, FID3: Fiducial; Fiducial_1mm_Mask2mm
H1, H2, H3, H4, H5, H6: M3; MountingHole_3.2mm_M3_Pad_Via

Their connections:
GND: H1.1, H2.1, H3.1, H4.1, H5.1, H6.1; also elsewhere on the board
