tieziyun/ultrasonic-aesa/kicad/aesa_test.kicad_pcb

## KiCad design kicad/aesa_test.kicad_pcb (2026-10-19)

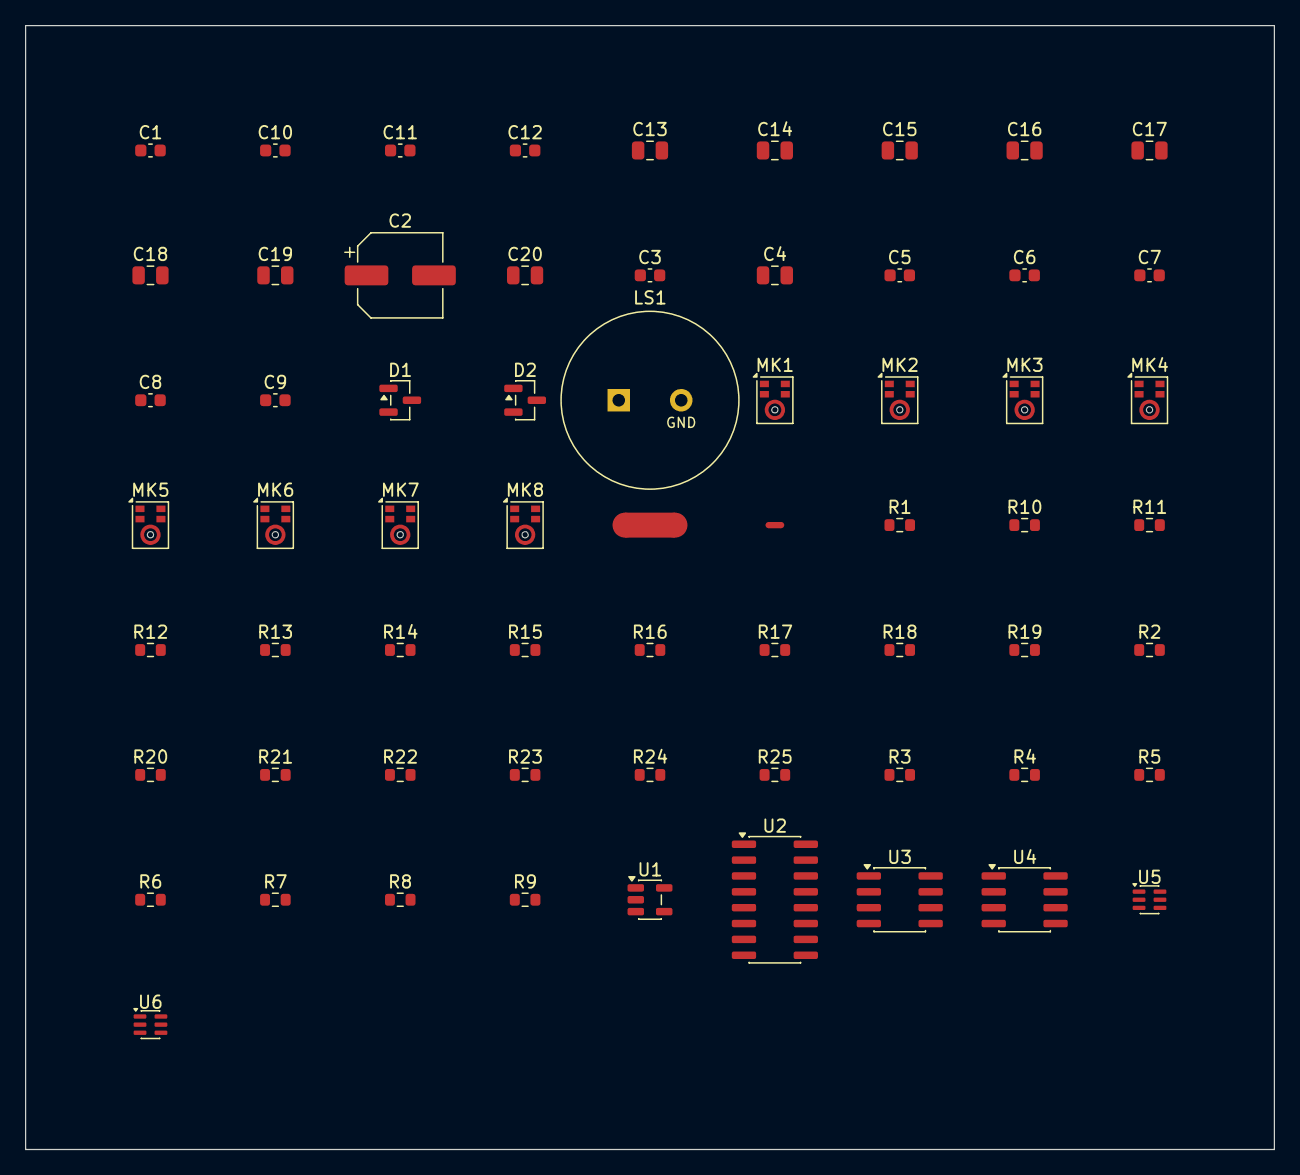
[picture p66: board aesa_test.kicad_pcb from above]

Board: 2 copper layers, 100.0 x 90.0 mm, 64 parts (0 on the bottom side), 44 nets, no tracks yet.

Parts:
C1, C3, C6, C7, C8, C11, C12: 100n 16V X7R; C_0603_1608Metric
C2: 47u 35V; CP_Elec_6.3x7.7
C4: 1u 50V X7R; C_0805_2012Metric
C5: 100n 50V X7R; C_0603_1608Metric
C9, C10: 1n 50V C0G 1%; C_0603_1608Metric
C13, C14, C15, C16, C17, C18, C19, C20: 100n 16V C0G; C_0805_2012Metric
D1, D2: BAV99; SOT-23
LS1: CUSA-TR65-065-2200-TH68; CUSA-TR65
MK1, MK2, MK3, MK4, MK5, MK6, MK7, MK8: SPH0641LU4H-1; Knowles_LGA-5_3.5x2.65mm
NT1: NetTie AGND-PGND; NetTie-2_SMD_Pad2.0mm
NT2: NetTie AGND-DGND; NetTie-2_SMD_Pad0.5mm
R1, R2, R3, R7: 10k 1%; R_0603_1608Metric
R4: 47 1%; R_0603_1608Metric
R5, R13: 100k 1%; R_0603_1608Metric
R6: 4.7k 1%; R_0603_1608Metric
R8, R9, R10: 2k 1%; R_0603_1608Metric
R11: 16k 1%; R_0603_1608Metric
R12: 100 1%; R_0603_1608Metric
R14, R15, R16, R17, R18, R19, R20, R21, R22, R23, R24, R25: 33 1%; R_0603_1608Metric
U1: 74AHCT1G125; SOT-23-5
U2: 74AHCT595D; SOIC-16_3.9x9.9mm_P1.27mm
U3: UCC27524DR; SOIC-8_3.9x4.9mm_P1.27mm
U4: OPA1678IDR; SOIC-8_3.9x4.9mm_P1.27mm
U5, U6: 74LVC2G34; SOT-363_SC-70-6

Connections:
+3V3: C11.1, C12.1, C13.1, C14.1, C15.1, C16.1, C17.1, C18.1, C19.1, C20.1, MK1.2, MK1.5, MK2.5, MK3.2, MK3.5, MK4.5, MK5.2, MK5.5, MK6.5, MK7.2, MK7.5, MK8.5, R2.2, U5.5, U6.5
+5V: C1.1, C3.1, U1.5, U2.16
+5VA: C6.1, U4.8
-5VA: C7.1, U4.4
AGND: C6.2, C7.2, C8.2, D2.1, D2.2, LS1.2, NT1.1, NT2.1, R5.2, R10.2, U4.5
DGND: C1.2, C3.2, C11.2, C12.2, C13.2, C14.2, C15.2, C16.2, C17.2, C18.2, C19.2, C20.2, MK1.3, MK2.2, MK2.3, MK3.3, MK4.2, MK4.3, MK5.3, MK6.2, MK6.3, MK7.3, MK8.2, MK8.3, NT2.2, R1.2, R3.2, R13.2, U1.1, U1.3, U2.8, U5.2, U6.2
DRV: D1.1, D1.2, R4.2
FB1: R7.2, R8.1, U4.2
INV2: C9.2, R11.1, U4.6
LIM: D2.3, R6.2, U4.3
MIC_CLK0: MK1.4, MK2.4, R14.2
MIC_CLK1: MK3.4, MK4.4, R15.2
MIC_CLK2: MK5.4, MK6.4, R16.2
MIC_CLK3: MK7.4, MK8.4, R17.2
MIC_CLK_IN: R13.1, U5.1, U5.3, U6.1, U6.3
MIC_DATA0: R18.2, R19.2
MIC_DATA1: R20.2, R21.2
MIC_DATA2: R22.2, R23.2
MIC_DATA3: R24.2, R25.2
N2: C9.1, C10.1, R9.2, R10.1
unnamed: R4.1, U3.7
unnamed: C8.1, R8.2
unnamed: R14.1, U5.6
unnamed: R15.1, U5.4
unnamed: R16.1, U6.6
unnamed: R17.1, U6.4
unnamed: MK1.1, R18.1
unnamed: MK2.1, R19.1
unnamed: MK3.1, R20.1
unnamed: MK4.1, R21.1
unnamed: MK5.1, R22.1
unnamed: MK6.1, R23.1
unnamed: MK7.1, R24.1
unnamed: MK8.1, R25.1
OUT2: C10.2, R11.2, R12.1, U4.7
PGND: C2.2, C4.2, C5.2, NT1.2, U3.3, U3.4
S1: R7.1, R9.1, U4.1
TX_BIT0: U2.15, U3.2
TX_CLR_N: R3.1, U2.10
TX_EN: U1.4, U3.1, U3.8
TX_EN_FPGA: R1.1, U1.2
TX_OE_N: R2.1, U2.13
VDRV: C2.1, C4.1, C5.1, U3.6
XD0: D1.3, LS1.1, R5.1, R6.1
