tieziyun/ultrasonic-aesa/(commit log)

2026-10-19 first commit, laying out basic schematics, subject to change
2026-10-20 AD7606C-16, one sheet per repeated block, clock buffering, first simulations
    - ADC: AD7606C-16 in software mode (OS pins high, WR held high, DB11/SDI on
    shared ADC_SDI), 33 R source resistors on DOUTA/DOUTB/BUSY.
    - Every repeated block is its own reused sheet: tx_group x16, en_buf x4,
    clk_buf x7, mic x8 (replaces tx_shift, tx_drivers, mems). Sheets other than
    channel are generated by scripts/build_cells.py and scripts/build_power.py.
    - Headers: GND conductors either side of every clock, ADC_SDI, idle pulls,
    DNP RC terminations as fallback.
    - Power: 3V3_MIC ferrite filter moved to the power sheet with LED, test point
    and flag.
    - Simulations (LTspice, sim/): RX chain gain/noise, TX b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
2026-10-20 Add README and per-sheet schematic PDFs; remove old review notes
    - README.md: overview, sheet guide with links to PDFs, key numbers, repo
    layout, rebuild commands, next steps.
    - docs/schematics/: one PDF per sheet plus a combined PDF, written by
    scripts/export_pdf.py (now also checks the sheet list).
    - Removed docs/review-channel-1.md, review-full-1.md and
    research-review-items.md: all items applied or recorded in the brief.
    - Brief status line rewritten; CLAUDE.md points at docs/schematics/.
2026-10-20 sim/run.py: every simulation writes a Markdown report with limits and pass/fail
    - sim/run.py runs the LTspice testbenches, parses .meas results (plain and
    stepped), checks them against limits, plots, and writes
    sim/reports/<name>.md plus the index sim/reports/README.md.
    - All 6 testbenches pass (RX gain/band/ADC filter, RX noise, TX burst and
    recovery, clock fan-out, FPGA drive strength, ribbon termination).
    - Replaces docs/simulation-1.md and sim/plots.py; tx_burst Q variants are now
    generated by the runner.
    - CLAUDE.md: simulation rule; README and brief link the reports.
2026-10-20 Block-diagram top page, power review fixes, readable sheets
    Top level
    - Page 1 is now a block diagram of the signal flow (FPGA -> headers ->
    clock buffers / TX drive -> transceivers -> ADCs -> FPGA, mics, power).
    - New group sheets hold the reused cells: tx (16 tx_group + 4 en_buf),
    array (64 channel), adcs (8 adc), mics (8 mic), clocks (7 clk_buf).
    Power and headers stay directly under the top. All written by gen_top.py,
    which now also survives a kicad-cli re-save of a cell sheet.
    Power (review findings)
    - Polyfuse 1812L200/16DR (16 V), TPS65131RGER stated explicitly, input caps
    2 x 10u 1206, 50 V caps on 12 V, inductor values carry minimum Isat.
    - +3V3: TLV75733P (ceramic-stable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
2026-10-20 more updates on schematics
2026-10-20 Design checker, wired power sheet, schematic-driven simulations
    Checks
    - scripts/check_design.py audits the netlist and writes docs/design-check.md:
    ERC, part counts, footprints vs pins, LCSC status, TX chain of all 64
    elements, RX chain and ADC wiring, clock fan-out, header pin map, 3.3 V
    levels on FPGA pins, supply rails, decoupling, capacitor ratings, polarity,
    regulator outputs from the divider values, rail testability, power budget.
    16 pass, 1 warning (LCSC numbers still TBD).
    - scripts/pinmap.py: header pin maps shared by the builder and the checker.
    Power sheet
    - Redrawn conventionally: each regulator with its parts wired around it,
    key nodes named, power symbols only at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
2026-10-21 Simulation reports in plain language; consistent echo definition
    - Every report now opens with the question the test answers and the answer
    in plain words, then why it matters, what is simulated, how to read the
    plot, the numbers with what each means, and the assumptions.
    - Plots annotated: ping and echo windows, "quiet enough to hear" band, ADC
    range, safe voltage ranges, switching point, power split per element.
    - sim/reports/README.md: overview in signal-path order, how to run, and how
    to view waveforms in LTspice (Add Traces).
    - rx_overload: echo amplitude is now the peak at the element terminals
    (open-circuit reference element), the same definition as rx_chain, so a
    1 m echo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
2026-10-22 Optimized, costed BOM with LCSC numbers for every part
    scripts/bom.py picks parts (Basic first, stock margin) and writes docs/bom.md,
    fab/bom_jlcpcb.csv and scripts/parts.json; sch_lcsc.py fills LCSC fields from it.
    Part changes: TPS7A4700RGWT for the out-of-stock TPS7A4701, BAV99 C2500, SS54 in SMA,
    SMD1812P200TF16 polyfuse, 600R ferrite, Basic-value +5V/VDRV dividers (VDRV 15.4 V),
    Sunlord SWPA6045 footprints, mic 100 nF C0G in 1206. AD7606C-16 and SPH0641 now
    assembled by JLCPCB.
2026-10-23 Fix script bugs, share common code, update mic-supply sim for the 600R ferrite
    - scripts/common.py: KiCad paths, sheet DATE/REV and block_end() (ignores parens in strings),
    replacing copies in 7 scripts
    - gen_top: symbol without an instances block was written twice
    - sch_lcsc --force no longer overwrites a real LCSC number with TBD
    - bom.py: DNP non-passives no longer crash; jlc cache keyed by (keyword, n)
    - check_design: drop dead two_pin(), count 'Cxxx (DNP)' as LCSC, 5V_REG 5.07 V
    - sim/mic_supply: GZ1608D601TF model (72 dB at 3 MHz, resonance 36 kHz +1.4 dB)
2026-10-23 One linked schematic PDF, regenerated on every change
    - export_pdf.py: one page per sheet (14 pages, 336 KB) with every block link remapped to its
    sheet's page, '<< up to' parent links, hierarchical bookmarks and page ids n/14
    - delete the 14 per-sheet PDFs (exact duplicates of the combined file's pages)
    - gen_top.py exports the PDF at the end (--no-pdf skips)
    - .githooks/pre-commit refuses sheet changes committed without the PDF
    - README and CLAUDE.md updated
2026-10-23 Switch to 16 x TLV320ADC5140, +3V3A rail, 3 A buck, datasheet library, transducer DNP
    - ADC: 8 x AD7606C-16 ($470/board) -> 16 x TI TLV320ADC5140 at 192 kSPS ($50/board): TDM slave on a
    shared BCLK/FSYNC, I2C (SCL + 4 SDA groups), 2k/1k + 100 nF input network; project symbol from
    scripts/make_symbols.py; 9 clock buffers; J2 remapped
    - power: +3V3A (second TPS7A4700, ANY-OUT 3.3 V); +5V buck TPS54202 -> TPS54302 (3 A), L1 10 uH 5 A
    - checks and simulations updated for the new ADC input (all 18 checks and 10 sims pass)
    - docs/datasheets: a PDF for every part, kept in step by scripts/datasheets.py (run by bom.py)
    - design brief section 5a: interface bandwidth budget (no bus is a bottleneck;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
2026-10-23 Board placement ready for routing; TPS26600 eFuse input protection
    PCB (scripts/place.py builds kicad/aesa.kicad_pcb from the schematic, block by block):
    - 192 x 301 mm, 4 layers (F.Cu / GND / GND / B.Cu), 3 mm corner bevels, parts >= 3 mm and copper
    >= 0.5 mm from the edge, 6 M3 holes, 3 fiducials
    - all cables on the top edge: ribbon headers side by side in the middle, 12 V jack + eFuse top-left,
    +3V3A/+3V3 LDOs top-right; ADC blocks below; array; TX blocks; switchers at the bottom
    - channels numbered down the columns: TX group k and ADC k sit under/over the column of CH 4k-3..4k,
    DRV lane left and RX lane right of each column on F.Cu (no crossings)
    - hand templates from the mirrored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
2026-10-23 Transducer: Same Sky CUSP-TR80-15-2500-TH instead of CUSA-TR65 (about $122 less per board)
    - Ø9.8 mm 40 kHz transceiver, 105 dB SPL, 0.2-15 m, 1.6 ms ring-down, 2.0 nF; $1.65 (Future,
    DigiKey second source); not sealed (indoor, behind the waveguide)
    - new footprint aesa:CUSP-TR80 (5.0 mm pin pitch, Ø2 mm pads, Ø0.9 mm holes, '+' = pad 1);
    CUSA-TR65 footprint removed; soldering keep-out follows the larger pads
    - simulation model CUSP_TR80 (C0 2.0 nF; Rm 3 k and the 1 m echo level kept as assumptions):
    all 10 simulations pass
    - BOM total $326 per board (was $444); datasheet library, checks, brief and README updated;
    board re-placed, DRC 0 violations
2026-10-24 Board ready for routing: power sheets redrawn, 3D models, test access, routing setup
    Schematic
    - Power supply split into two boxed A3 sheets (Power 1: input, +5V, VDRV,
    +3V3, 3V3_MIC; Power 2: analog +-6V5, +-5VA, +3V3A and the bring-up notes);
    eFuse wired inline; text no longer clashes; ferrite drawn as L_Ferrite.
    - Every page of the schematic PDF is A3 (cells scaled up, array redrawn).
    - RX_OUT test pad on every channel; four more GND test points.
    - Test pads and solder jumpers out of the BOM, like their footprints.
    Board
    - 3D model for every part (make_3d.py for the CUSP-TR80, stock substitutes
    for four missing library models); check_design checks it.
    - JLC04161H-7628 stackup, ENIG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
2026-10-24 Fix small inconsistencies: one revision (rev 1, 2026-10-24) for sheets and board
    - REV/DATE come from scripts/common.py for every title block and the board
    silkscreen (the sheets said rev 2, the board rev 1).
    - Channel note: +27 dB is element -> amplifier output; the ADC pin sees
    +16.5 dB after the divider.
    - Board input text 8.8-13.8 V (eFuse UVLO); LM2731 limit 14 V (14.5 V abs max).
    - Brief/README: real board size 192 x 301 mm, CUSP-TR80 footprint and pitch
    note, nominal vs simulated gain, board test-point references, 126 pages.
    - SKiDL spec uses L_Ferrite like the sheet; dead AD7606/net-tie entries gone.
    ERC 0, DRC 0, design check 19/19, placement checks 12/12.
2026-10-26 Block-first routing: all repeated blocks routed and passing, power input and +-6V5 hand-routed
    - TX groups and ADC inputs numbered in order (TXG01 = DRV1-4, ADC IN1..4 = RX1..4).
    - Power sheets renumbered 1-8 with real references; eFuse RTN no longer tied to GND (TPS2660 9.3.5.5).
    - Damped 100 uF bulk caps at the far ends of VIN (C50) and +5V (C51); header clock RC filters removed;
    switch-node snubbers kept as DNP footprints.
    Layout and routing
    - New routing toolchain: route.py (block stages), block_routes.py (hand-made block routes), maze.py
    (45-degree grid router with rip-up and a per-net time budget), route_lib.py (bend45, chamfer, copper
    checks), block_check.py (DRC and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
2026-10-26 +5V buck hand-routed to the TPS54302 layout guidelines; fixed net-class priorities
    - Buck section (place.py POWER_CORES["B"], block_routes.power_buck5v): input caps stacked over VIN with
    shared GND vias and a via at the GND pin; SW 0.6 mm neck then 1 mm into L1, boot cap and DNP snubber
    reaching the switch pad on the back copper (no switching current on the front or under the IC);
    1.6 mm output bar across both output caps; Kelvin FB sense from JP1's regulator side, FB node right of
    the IC away from SW; EN divider beside it; JP1, TP2, R6 and D3 on one +5V line.
    - route.py routes section B by hand (POWER_ROUTED A, B, C).
    - place.netclasses(): each class gets a fixed priority in list or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
